jgazeley/accord/logger/hardware/README.md

# Logger hardware interface

The logger is a separate Pico W from the keyless module. The keyless KiCad
board in this repository is not a logger PCB. The current logger uses a
prototype signal-conditioning circuit, SD storage and an external regulated
5 V supply; the Pi is only a flashing and observation bench.

| Measurement/interface | Pico GPIO |
|---|---|
| Vehicle speed pulses | GP2 |
| Tachometer pulses | GP3 |
| Brake-warning level | GP4 |
| Conditioned ignition input | GP5 |
| Fuel analog input | GP26 / ADC0 |
| Supply analog input | GP27 / ADC1 |
| SD MISO / CS / SCK / MOSI | GP16 / GP17 / GP18 / GP19 |

This map comes from `accord-logger.ino` and `logger_sd.cpp`. Automotive
signals require the appropriate conditioning before reaching the Pico; this
pin map alone is not a wiring schematic. The brake-warning signal can represent
parking brake or low fluid, not an unambiguous parking-brake state. The fuel
input records ADC measurements, not an independently calibrated fuel quantity.

The **Rev A board design** is in [kicad/](kicad/) as `accord-logger.kicad_pro`:
complete schematic, 148-line BOM with every part footprinted, ERC clean, sized
for 80 × 120 mm. It includes the automatic power hold and cutoff, B2 input
isolation, the keyless RS-485 circuit, and one 10-pin Molex Mini-Fit Jr.
board connector. It is ready for the owner to place and route. It is **not
frozen and not fabrication-approved**: nothing has been built or bench tested.
The schematic is generated by `kicad/tools/gen_logger_sch.py`; see
[kicad/validation/COMMANDS.txt](kicad/validation/COMMANDS.txt). Engineering
record: [power/LAYOUT_CLOSURE.md](power/LAYOUT_CLOSURE.md); risks and bring-up
tests: [LRA12_HANDOFF.md](LRA12_HANDOFF.md). Automatic-power firmware exists
as an opt-in candidate; manual power remains the default.

The pin map above is the **as-built** firmware baseline. Rev A changes what
GP5 means and adds GP6; see [as-built/REV_A_INTERFACES.md](as-built/REV_A_INTERFACES.md) §1.

B2 input isolation (ASSR-601JV) is in the schematic; background in the
[B2 study](isolation/B2_ISOLATION.md) and [enable design](isolation/ISO_ENABLE.md).

Current electrical/PCB context: [Rev A context](REV_A_CONTEXT.md).
Current status: [STATUS.md](../../coordination/STATUS.md); owner decisions: [DECISIONS.md](../../coordination/DECISIONS.md).
