jgazeley/accord/logger/hardware/power/LAYOUT_CLOSURE.md

# LRA-12 — electrical closure for layout

Prepared October 29, 2026 by Claude Code `logger-electrical`, session
`b690946d-3a88-4626-8e7b-b321126a3d16`.
Resume: `claude --resume b690946d-3a88-4626-8e7b-b321126a3d16`.
Session ID read from this session's harness-assigned working paths and
confirmed against its transcript file; this tool exposes no second identifier
to cross-check it against, so that is stated rather than implied.

Branch `task/LRA-12-b690946d`, from public `main` at
`5ffcb26958d2b7154b4d1417431fad22246cedd9`.
Packet: [LRA-12](../../../coordination/handoffs/LRA-12_LAYOUT_ELECTRICAL_CLOSURE.md).
**LRA-12R revisions below supersede the original clamp rationale and A5 stage;**
original attribution above is preserved.

Readiness review: [LAYOUT_READINESS_2026-10-29](../../../coordination/reviews/LAYOUT_READINESS_2026-10-29.md).

**Disposition: the electrical design is complete and routable. Nothing here is
frozen, ordered, fabricated, flashed or vehicle-approved.** Every one of the
eight LRA-06 placeholders now has a real circuit or a recorded, justified
bypass; every populated part carries a checked footprint; ERC is clean at
`--severity-all`; the board fits 80 × 120 mm with a 1.42× courtyard
allowance. What is still open is listed in
[LRA12_HANDOFF.md](../LRA12_HANDOFF.md), classified, and none of it is a
layout blocker.

---

## 1. What changed

| Was | Now | Where |
|---|---|---|
| X1 B2 isolation, no part | ASSR-601JV in the divider top leg, with a GPIO enable in series with a hardware PGOOD permission | §4 |
| X2–X5 four branches, under review | **Justified bypass**, on the ignition interlock plus the fitted series resistance, with a reachable-state table | §4 |
| X6 qualified IGN / QREPORT, no circuit | Captured component for component from `CUTOFF_MARGIN_REVIEW.md` §2 | §5 |
| X7 vehicle protection, no selection | 1.5KE20A entry clamp **plus** a second-stage clamp on the A5 regulator input; one declared excluded exposure | §3 |
| X8 independent cutoff, no circuit | Captured from `MAX_ON_CUTOFF.md`, including the QS permission switch and QMON sense | §5 |
| J1/J2 connector family not selected | Molex Mini-Fit Jr., the family already in service in this car | §6 |
| Q2 / R06-REV-2 opto LED return | Moved from the B16 cluster conductor to PGND | §6 |
| Q4 onboard ignition fuse | Dropped; the fuse belongs at the tap end | §6 |
| Q5 J4 "service UART" with NC pins | J4 is the RUN/GND reset pair only; USB CDC is the service console | §6 |
| Q6 where the cutoff interrupts HOLD | QS between SINK and the QH collector | §5 |
| QP IRF4905, hot leakage over its allocation | IPD50P04P4L-11 with the paired BZX55C10 gate clamp | §3 |
| CIN/COUT/CCLK/A5 caps unspecified | The LRA-02 selections, with their conditions carried | §5, §7 |
| C_SD "10–100 µF" | 47 µF, selected from the duty | §6 |
| RGS 100 k | 10 k, per the MAX_ON revision | §5 |

Deliberately **not** changed: the five divider ratios, the GPIO allocation
except for taking up the released GP7, the 1N5819 digital clamps, the SD rail,
the single B16 return, the LM2678 buck topology, the 1770/1800/1801 s policy,
the nominal 2048 s cutoff, and the 100/500 µA whole-system targets.

---

## 2. Design basis

`D-REUSE-02` and `D-POWER-03`: this board is the working keyless circuitry
plus the logger's documented input cells and SD wiring plus the existing
IGN-sense, power-hold and automatic-shutoff design. It is integration, not a
new power survey. The regulator, the TVS role, both bulk capacitors, the boost
capacitor, the inductor value, both Schottky positions, the connector family
and the test-point and reset-header pattern all come forward from a board
that runs in this car on a permanent 12 V feed through cranking.

Every change to an inherited block below names a concrete incompatibility, a
changed operating condition or a documented defect. There is no blanket
requalification: the LM2678 loop, the keyless clamp precedent and the fitted
divider ratios are carried as they are.

Two conditions genuinely changed, and they are where the engineering went:

1. **The always-on A5 supply is new.** Its regulator has a 30 V recommended
   input maximum, where everything keyless puts behind the same clamp is
   rated 40 V. §3.
2. **The shutdown addition creates a state keyless never has:** a board that
   has removed its own power while vehicle inputs may still be energized.
   §4.

---

## 3. X7 — the input voltage envelope

### 3.1 LRA-12R decision: retain the lower clamp by choice

Revision October 29, 2026 by Codex `logger-electrical`, session
`01a18a47-2dc2-7aa3-a0d2-a4978e2b1ebc`.
Resume: `codex resume 01a18a47-2dc2-7aa3-a0d2-a4978e2b1ebc`.
Identity verified from matching CODEX_SESSION_ID and CODEX_THREAD_ID.

**The original claim that no suitable 60 V P-FET exists is withdrawn.**
[Vishay SQD50P06-15L, document 69098 Rev. E](https://www.vishay.com/docs/69098/sqd50p06.pdf)
specifies −60 V VDS, ±20 V VGS, AEC-Q101, TO-252, and IDSS maxima
1 / 50 / 150 µA at 25 / 125 / 175 °C with VGS=0, VDS=−60 V.
It fits the manager-accepted 70 µA hot QP allocation at the 125 °C screen.
It is a real alternative, not a parked-budget blocker.

The inherited 1.5KE30A has 25.6 V standoff, 28.5–31.5 V breakdown,
41.4 V clamp at 36.2 A and a **0.097 %/K** breakdown coefficient:
`41.4 × (1 + 0.00097 × 60) = 43.80948 V` at 85 °C.
This is a temperature screen using the breakdown coefficient, not a guaranteed
hot clamp waveform. The LM2678 would return to its keyless in-service margin:
40 V operating, 45 V absolute, hence **3.81 V above operating and only
1.19 V below absolute**. Keyless's working precedent is accepted; this is not
a claim that it failed. The SQD would have 16.19 V VDS margin.
[TVS table](https://www.vishay.com/docs/88301/15ke.pdf).

**Decision: retain 1.5KE20A and IPD50P04P4L-11.** The concrete logger-specific
reason is the added A5 supply. With 43.81 V and the existing 330 Ω stage,
the same screening calculation gives 1.46 W in BZX55C22 versus 0.5 W even
at 25 °C leads. At 85 °C leads its thermal allowance is only 0.30 W.
Even an ideal 28 V shunt needs at least 1476 Ω to stay within that allowance,
whereas the 6 V input / 5.5 V regulator floor at 0.510 mA permits at most
980 Ω actual series resistance. A resistor-only change cannot satisfy both.
A higher-power zener or another A5 topology can solve this; it has not been
ruled out. It would need its own leakage, thermal and startup validation,
as well as ≥60 V driver replacements. This return chooses the lower clamp
and retains 10.80 V LM2678 operating margin, accepting the narrower sustained
ceiling already deferred under D-OVERVOLT-04. This is a tradeoff, not forced
by QP availability. The conditional 30A adoption tasks are not claimed complete.

The selected 1.5KE20A remains 17.1 V standoff and 27.7 V clamp at 54.2 A;
its 0.090 %/K coefficient gives **29.1958 V** at 85 °C. Both TVS pulse-power
ratings require temperature derating; neither the nominal 1500 W nor the
room-temperature pulse current is a guaranteed 85 °C capability. Actual
pulse and overshoot acceptance remains a vehicle/bench gate.

### 3.2 The envelope table

Computed in `check_layout_closure.py` §1 against the 29.20 V hot clamp.

| Part | Node | Rating | Kind | Margin |
|---|---|---:|---|---:|
| QP IPD50P04P4L-11 | P12 / VIN_SW | 40 V | absolute V<sub>DS</sub> | 10.80 V |
| QI 2N3904 | SINK = P12 when off | 40 V | absolute V<sub>CEO</sub> | 10.80 V |
| QH 2N3904 | SINK = P12 when off | 40 V | absolute V<sub>CEO</sub> | 10.80 V |
| QS BSS138P | SINK | 60 V | absolute V<sub>DS</sub> | 30.80 V |
| UREG LM2678 | VIN_SW | 40 V | operating V<sub>IN</sub> (45 V absolute) | 10.80 V |
| CIN EEUFR1H101 | VIN_SW | 50 V | rated WV | 20.80 V |
| C0 | P12 | 63 V | rated WV | 33.80 V |
| DREV SB360 | BATT_F / P12 | 60 V | absolute V<sub>RRM</sub> | 30.80 V |
| C_AON GRM32ER71H475KA88L | P_AON | 50 V | rated WV | 20.80 V |

The tightest number in the group is not in that table: cold V<sub>BR</sub>
minimum is `19.0 × (1 − 0.00090 × 65) = 17.89 V` against a 16 V operating
ceiling, so there is **1.89 V** between the top of the operating envelope and
the cold onset of clamp conduction. Leakage at 16 V and −40 °C is below the
1.0 µA standoff figure, because cold reduces it, but that is reasoning rather
than a tabulated point.

Keeping QI and QH as 2N3904 is a consequence of this choice, not an oversight:
the lower clamp gives them 10.8 V of margin where the inherited clamp exceeded
their absolute rating. Their hot off-state leakage under these actual base
networks remains unspecified and stays in the ledger as an allocation.

### 3.3 A5 second-stage correction, including junction heating

```text
P12 -- R_AON 820R/1% -- P_AON -- UA5 IN
P_AON -- DZ_AON BZX55C22 cathode; anode -- PGND
P_AON -- C_AON 4.7uF/50V X7R -- PGND
```

The former 330 Ω / 0.420 W calculation compared hot operation against a
25 °C power rating. **R_AON changes to 820 Ω**. Select a resistor providing
at least **0.15 W allowable dissipation at 85 °C** in the assigned footprint;
a nominal 0.25 W label alone does not establish that.

[Vishay BZX55, Rev. 2.0](https://www.vishay.com/docs/85604/bzx55.pdf)
specifies 500 mW at leads 25 °C / 4 mm, 300 K/W thermal resistance under
its stated lead condition, and 175 °C maximum junction. With leads held at
85 °C, allowable power is **0.300 W**. For *any* shunt voltage,
`Pz <= Vin²/(4 Rmin) = 29.1958²/(4 × 811.8) = 0.263 W`,
so the thermal screen gives Tj ≤163.75 °C. **Layout and measurement must
establish the lead-temperature condition**; this is not an unconditional
ambient rating or a transient thermal characterization.

For voltage screening use the full 175 °C junction ceiling:
`23.3 × (1 + 0.0012 × 150) = 27.494 V` at 5 mA.
Cold minimum is 19.1776 V; an intentionally pessimistic current bound is
`(29.1958 − 19.1776)/811.8 = 12.34 mA`. Applying the tabulated 55 Ω
small-signal impedance to the excess above 5 mA gives **27.90 V**, below
28 V. This extrapolation is a **model screen**, not a manufacturer's
large-signal DC guarantee; TP_PAON pulse/temperature verification remains
required. Resistor dissipation in that model is ≤0.124 W.

Leakage is **<0.1 µA at 25 °C / <2 µA at 150 °C at VR=16 V**, correcting
the original 18 V transcription. The ledger screen is therefore applicable
to the 12–16 V normal input range; it supplies no leakage guarantee over
16–17.1 V. The latter is a declared voltage ceiling, not a parked-current
qualification. Cold minimum zener voltage remains above 17.1 V.

At 0.500 mA A5 load plus a 10 µA regulator-ground-current screen,
Rmax=828.2 Ω drops **0.4224 V**: P_AON ≥5.5776 V at P12=6 V, leaving
77.6 mV over the 5.5 V dropout screen. Nominal RC is 3.85 ms. Including
+1% R, +10% C and the full constant load, input charging to 5.5 V takes
**18.3 ms**, inside 100 ms. LDO and logic startup, low-load dropout and
load transients still need the original bring-up measurements.
EN stays open; TI Table 4-1 says it must remain below 6.5 V.
**The ≤28 V protected-rail criterion is measured at TP_PAON.**

### 3.4 Fuse coordination, and the one exposure that is declared excluded

> **October 30 (owner decision D-FUSE-10): F1 is removed from the board.**
> The owner fits a 1 A inline fuse in the harness instead, so BATT_IN goes
> straight from J1 to DREV. That one fuse now does both jobs below: it
> protects the wire (it belongs at the feed end) and it is the element that
> must clear a sustained overvoltage before the entry clamp fails. Keep it at
> 1 A; a larger fuse lets the clamp dissipate longer. The text below is the
> original LRA-12 record, which assumed an onboard F1.

The clamp-only front end cannot do everything, and this is where it stops.

- **Reverse battery** is covered by DREV, which also keeps the unidirectional
  clamp out of forward conduction and is what makes P12 nonnegative at the A5
  regulator, as that regulator requires.
- **Transient**, 10/1000 µs: 1500 W, 54.2 A, clamping to 27.7 V at 25 °C and
  29.20 V hot. Within the declared bench and charging envelope.
- **Sustained overvoltage is not survivable, and is declared excluded.** At
  the 1 A branch fuse rating the clamp would dissipate about **19 W against
  its 6.5 W rating**, and a cartridge fuse carrying its own rating does not
  clear quickly. **The declared sustained ceiling at P12 is 17.1 V**, the
  clamp standoff — which covers 12–16 V bench operation and a 14.8 V charging
  rail with 2.3 V to spare, and excludes **any sustained P12 above 17.1 V**, including an
  **alternator/regulator overcharge fault** and a 24 V jump start. This is
  the owner-deferred vehicle-acceptance risk D-OVERVOLT-04.

The choices now include a verified 60 V switch:

| Option | Benefit | Cost / disposition |
|---|---|---|
| **(a) Retain 1.5KE20A — selected** | 10.80 V LM2678 operating margin; A5 correction fits the existing topology | Any sustained P12 >17.1 V excluded, including regulator overcharge; R_AON changes to 820 Ω |
| (b) Series overvoltage cutoff | Disconnects during sustained overvoltage | Additional topology and validation; not selected |
| (c) 1.5KE30A + SQD50P06-15L | Reuses working clamp and raises standoff to 25.6 V; 50 µA hot QP screen fits budget | LM2678 43.81 V hot screen, 1.19 V absolute margin; needs ≥60 V BJTs and redesigned A5 stage, not merely a larger resistor with the same hot-rated BZX55. Not selected |

Required owner input to close this properly, unchanged from
`INTERFACE_CONTRACT.md` §6: exact feed, source and harness impedance and
inductance, expected jump-start and crank behaviour, pulse
amplitude/duration/repetition/temperature, wire sizing and the fuse interrupt
and clearing curves. None of that is needed to lay the board out.

**F1 stays on the board** as the board's own branch protection, and the
specification still puts a fuse at the feed source. An onboard fuse cannot
protect the upstream harness, so both exist for different reasons; `DESIGN.md`
§5 already says the feed-source fuse is the one that protects the wire.

### 3.5 The ignition and sense entries

One clamp, on the one harness entry that is not a high-impedance divider.

- **B11 carries both** the supply ADC divider and the ignition opto LED
  through 2.2 kΩ, so it is the cluster line where a transient has something
  low-impedance to drive. **TVS_B11 = 1.5KE20A-E3/54**, the same part as the
  entry clamp, so one qualification covers both. It costs nothing parked: B11
  is ignition-switched and logged dead with the key out.
- **The five divider inputs need no clamp of their own.** Each presents
  7.5–22 kΩ of series resistance before anything sensitive, so a 100 V
  transient delivers 4.5 mA into a 1N5819 rated 25 A of forward surge, and
  the axial resistors' own pulse withstand is far above the arriving voltage.
  This is the real difference from keyless, which fits seven P6KE30A: those
  lines drive ULN2803 outputs and relay loads, not dividers.
- The owner's four **P6KE30A** are recorded as a possible substitute only if
  the 41.4 V clamp is first checked against RI and RLED pulse ratings. They
  are not selected: the 1.5KE20A is strictly better here and halves the part
  count across the two clamp positions.
- **RI stays 2.2 k / 0.25 W.** At the 17.1 V sustained ceiling its
  dissipation is 0.112 W. The 0.318 W figure that would have forced a 0.5 W
  position came from the superseded 28 V number.
- **RLED is the measured 2.2 k, specified 0.5 W** (D15). At 17.1 V it
  dissipates 0.108 W; the 0.792 W that disqualified the 1 k candidate also
  came from the 28 V number. The fitted part's wattage is not recorded, which
  is why the position is specified rather than assumed.

---

## 4. X1 and X2–X5 — isolation, and the four branches that do not get it

### 4.1 Reachable-state table

The record had discussed two different criteria as one.
`REV_A_INTERFACES.md` §3.1 separates them; this table says, for each state,
which criterion applies and what each branch does in it.

| State | How it is reached | B2 (VSS) | B1, C14, C11, B11 |
|---|---|---|---|
| **Parked, key out** | normal | Energized at 4.669 V open circuit from an always-on source through 3,757 Ω — **measured** | **Dead** — B1 and C11 measured 0 V, C14 and B11 logged dead (`D-OFFSTATE-01`) |
| Running | key on, board powered | energized, switch closed, divider reads it | energized, dividers read them |
| HOLD window after key off | normal shutdown | dead within one PCM power-down | dead |
| Supervisor BAD, ignition absent | fault | relay opens in hardware when B5 falls | dead |
| Supervisor BAD, ignition present | fault | **QI holds the board powered** — so the board is not off | energized, board powered |
| EXPIRED with HOLD stuck | fault | ignition is absent by definition, so B2 is still energized but the relay is open | dead |
| Pico reset while ignition on | normal | QI holds power; 3V3 stays up | energized, board powered |
| USB only, key at II | bench | 3V3 is alive from USB; B5 is dead so the relay is open | energized, 3V3 alive |
| **Board dead, key at II** | **needs an upstream power fault**: J1 open, F1 open, DREV or QP failed open | relay open, B2 blocked | **energized into a dead 3V3 rail** |

The last row is the only state in which criterion B bites, and the table is
the argument: **it requires both the key on and a power fault**, because
ignition present drives QI, QI sinks the QP gate, and the board powers up —
with no firmware, no HOLD and no qualification involved. That interlock is
checked structurally off the netlist in `check_layout_closure.py` §5.

B2 is the exception to all of it, which is why B2 alone gets a switch: it is
energized with the key out, so the interlock argument does not cover it and
the parked criterion fails on measurement rather than on inference.

### 4.2 B2: the ASSR-601JV, and the enable the manager required

Part, package and leakage come from the LRA-11 return and are unchanged.
Verified again here directly from
[Broadcom ASSR-601Jx-DS105, June 17 2024](https://docs.broadcom.com/doc/ASSR-601Jx-DS):
I<sub>O(OFF)</sub> **1000 nA maximum at V<sub>O</sub> = 1000 V**, under a table
header reading *"Unless otherwise stated, all minimum/maximum specifications
are over recommended operating conditions"*, with recommended operating
temperature **−40 to +105 °C** for the JV and no 25 °C override on that row —
unlike the withstand row immediately above it, which states
"T<sub>A</sub> = 25 °C" explicitly. 4.669 V is applied against a limit quoted
at 1000 V; that 214× lower stress is noted, not claimed.

Three things the manager's follow-up required, and what each turned into:

**(1) Complete the driver: GPIO enable plus hardware PGOOD permission.**

```text
B5 -- R_ISO 270R/1% -- AN (pin 4)
                       CA (pin 5) -- QISO_PG drain
                                     QISO_PG source -- ISO_MID
PGOOD -- 1k -- QISO_PG gate ; gate -- 100k -- PGND
                                     ISO_MID -- QISO_EN drain
                                                QISO_EN source -- PGND
GP7 (ISO_EN) -- 1k -- QISO_EN gate ; gate -- 100k -- PGND
```

Both channels must conduct for LED current to flow. The reason the second one
exists is the manager's own correction: **BAD does not necessarily remove
B5**, because the original design gates only QH and QI can hold power with
ignition present. A rail-only argument therefore cannot carry the
fail-open-on-BAD requirement, and PGOOD can, in hardware, with no software
step. TPS3839's output is **push-pull** and sources at least V<sub>DD</sub> −
0.4 V at 2 mA, against the 50 µA that gate divider draws, so it drives the
gate directly.
[TI TPS3839, SBVS193D](https://www.ti.com/lit/ds/symlink/tps3839.pdf).

Per-state behaviour, all of it in hardware unless marked:

| State | Behaviour |
|---|---|
| No power applied | B5 = 0, no LED current whatever any gate does. Open **by construction**; the 100 k pulldowns are on the driver, not the isolation mechanism |
| Supervisor BAD | PGOOD falls, the permission channel opens, output opens within T<sub>OFF</sub> ≤ 0.5 ms. **No software step** |
| Pico 3V3 absent or resetting, B5 present | GP7 floats, its 100 k pulldown holds the enable channel off |
| USB only, A5 and B5 absent | no LED current; also no PGOOD |
| Normal shutdown | *firmware*: ISO_EN low, wait t_iso = 5 ms, **then** release HOLD |
| Startup | *firmware*: after B5 and the Pico are up, assert ISO_EN and wait 20 ms before trusting VSS edges |
| Unplanned rail collapse | B5 falls, LED goes dark, output opens |

**(2) R_ISO is 270 Ω, not 330 Ω — a correction, with a reason.** The ASSR's
turn-on maximum is specified at two LED currents: **4.0 ms at I<sub>F</sub> =
10 mA** and 1.0 ms at 30 mA, into V<sub>DD</sub> = 40 V and
R<sub>LOAD</sub> = 20 kΩ. The original 330 Ω puts the worst-case LED current
at 8.64 mA — *below* the 10 mA the maximum is specified at, which would leave
turn-on an extrapolation exactly where the requirement needs a specification.
270 Ω moves the corners to:

| Corner | I<sub>F</sub> |
|---|---:|
| B5 −5 %, V<sub>F</sub> 1.85 V, two channels at 5 Ω each | **10.26 mA** |
| Nominal | 12.32 mA |
| B5 +5 %, V<sub>F</sub> 1.25 V | 14.42 mA |

All inside the 7–30 mA recommended window, and the low corner is now at or
above the specified point. Resistor dissipation 57 mW. The awake cost rises
from ~10.3 mA to 12.3 mA, about +24 % on the ~51 mA branch baseline, drawn
only while recording.

**(3) Timing against the shutdown budget, with what is still conditional.**
t_iso = 5 ms is 10× the 0.5 ms turn-off maximum; the 20 ms startup wait is 5×
the 4.0 ms turn-on maximum. Isolate-then-release consumes 5 ms of the 1000 ms
between the 1800 s deadline and the 1801 s release limit, leaving 995 ms, so
the ordering costs nothing in the deadline. The enable-side 20 ms happens
after HOLD is already asserted, so it does not enter the ≤900 ms retention
path either. **Still conditional, and carried as a bring-up measurement:** the
turn-on maximum is specified into a 20 kΩ load and this branch presents 55 kΩ,
and the 190 pF output capacitance is a typical value with no maximum. Neither
5 ms nor 20 ms is promoted to a guarantee.

**Signal path.** R<sub>ON</sub> 300 Ω maximum (at I<sub>O</sub> = 2 mA) in the
22 kΩ top leg takes the divider ratio 0.600000 → 0.596745, a **−0.54 % shift,
−16.3 mV** referred to a 5 V pulse; the high level lands at 2.98 V against an
RP2040 V<sub>IH</sub> of about 2.0 V. The signal current is 90.4 µA, two
decades below the current R<sub>ON</sub> is specified at, so 300 Ω is used as
an upper bound. Because no series element enters the **fuel or supply** top
leg, the ≤25 Ω and ≤100 Ω limits of `REV_A_INTERFACES.md` §3.4 and the
card-header calibration problem of its §8.2 both fall away: `log.adc.fuel
div=7500/4700` still has every term it needs.

**Footprint.** Created locally and verified against the manufacturer drawing
rather than the summary: 12 pads at numbers 1–10, 15 and 16, 1.270 mm pitch,
pad 2.871 × 0.65 mm, pad centres at ±4.3815 mm, from the recommended land
pattern's 11.634 mm overall span and 8.763 mm centre spacing and its 0.635 mm
minimum pad width. **Pins 11–14 do not exist** and that gap is left clear.
**Pin 3 is "do not connect" — internally tied to pin 5** — and
`check_capture.py` asserts it is unconnected. A stock `SOIC-16W` footprint
would put pads where there are no leads, which is the error LRA-11 flagged.
Neither creepage figure is load-bearing at these voltages — the device is used
for off-state blocking, not for safety isolation, and
`REV_A_INTERFACES.md` §4 already records that this installation is not
galvanically isolated — but the drain gap is kept clear anyway because it is
free.

**Finite leakage, stated as such.** "Eliminated" and "no conductive path of
any kind" are overstatements and are not repeated. The bound is 1 µA maximum
over the operating range, 1.0/1.0 µA in the ledger, against the 8/20 µA
reserved for all five branches. Open-state coupling is 0.173 µA average at
91 Hz through the typical 190 pF, which is a typical value, not a maximum.

**Availability is the one open item**, unchanged: distributor lifecycle data is
contradictory. Panasonic **AQY221N2S** remains the documented fallback — a
strictly smaller part inside the same keepout, better on every axis except the
one that decides it, since its 10 nA leakage maximum is from a 25 °C-only
table. If it is chosen, hot leakage must be measured.

### 4.3 X2–X5: bypass, decided

**Decision: no isolation device on B1, C14, C11 or B11.** Grounds:

1. **Criterion A is met with nothing fitted, and better than with a switch.**
   All four are ignition-fed and measured or logged dead with the key out, so
   the parked injection is zero rather than four devices' leakage.
2. **Criterion B needs a power fault as well as the key on** (§4.1), and in
   that state the fitted series resistance bounds each branch: 0.659 mA for
   the tach at 14.8 V, 0.627 mA for the brake at 14.1 V, 0.668 mA for the
   supply at 15 V, 0.906 mA for the fuel channel at its 8 V ceiling through
   7.5 k + 1 k. **Criterion B's 0.3 V dead-rail limit is not met in that
   state, and that is reported rather than claimed closed.** Isolating B2
   lowers the criterion-B total from 3.07 mA to 2.86 mA rather than raising
   it.
3. **The cost is concrete.** Four more ASSR relays would add 4 × 12.3 mA =
   49 mA of awake LED current — about doubling the awake branch baseline — and
   four 10.4 × 7.5 mm packages on a board with a 1.42× area allowance, against
   a fault-only benefit.
4. Series resistance in the fuel or supply top leg would also re-open the
   card-header calibration question for no gain.

Carried forward unchanged: the five divider ratios, the 1N5819 digital clamps
and the fitted ADC protection. **D11 stays open** — the tach cell's clamp
margin is smaller than estimated, because the measured 159 mV at 109 µA shows
V<sub>F</sub> keeps falling below a 0.3 V assumption. LRA-12 changes no ratio
and claims no clamp margin; resolving D11 needs U-08 first and is not a layout
blocker.

---

## 5. X6 and X8 — capturing circuits that already existed

Both were capture work, not design work: `LAYOUT_READINESS_2026-10-29` is
right that the sources specify them component for component. They are
transcribed from `CUTOFF_MARGIN_REVIEW.md` §§1–2 and `MAX_ON_CUTOFF.md`'s
connection table, and `check_capture.py` asserts every pin of every package
against those tables, plus all eleven Boolean equations read back off the
netlist by package pin.

What needed a decision rather than a transcription:

**The opto rewire (X6).** The collector goes to A5 and the emitter to IGN_A,
an emitter follower into the 47 k / 220 k / 1 µF filter. The old
collector-to-GP5 wiring is gone, as `D-RA-03` requires. CTR margin at the
measured 2.2 k: at the 9 V characterisation point the LED takes 3.39 mA, and
the ≥50 % CTR at 5 mA makes at least 1.7 mA of collector current available
against the 95.7 µA the 47 k load needs at the 4.5 V ON endpoint — about 15×.
Hot CTR and the endpoints themselves stay open (LRA-07).

**The report node carries no capacitor.** That answers the open half of D1:
with the 10 k pullup against roughly 30 pF of node capacitance the edge is
under a microsecond, so the report delay is nowhere near the 10 ms observation
budget. The fitted 100 nF across the old opto output is not carried forward
because the node it filtered no longer exists.

**Where the cutoff interrupts HOLD (Q6).** QS sits between SINK and the QH
collector, drain to SINK, source to the collector, so its body diode points
from the collector toward SINK and blocks the sink direction when off. QH
keeps its emitter grounded; interrupting the emitter instead would couple
fault voltage into the HOLD interface. QI stays wired straight to SINK, so raw
ignition still overrides the cutoff. RGS changes from 100 k to 10 k, which is
what makes the added series switch tolerable: the 0.2 V off-gate limit then
allows 19.80 µA of total sink leakage instead of 2 µA.

**The accelerated-cutoff provision, kept distinct from the production
selection and from the maintenance link.** Three different things, three
different parts:

| Part | What it is | Default |
|---|---|---|
| **JH** | Maintenance HOLD link: open it for USB work so a USB-driven HOLD cannot keep the battery circuit on | fitted |
| **R_EXPP** 0 Ω | Production period select: EXPIRED from UCOUNT Q13, nominal 2048 s | **fitted** |
| **R_EXPT** 0 Ω | Accelerated test select: EXPIRED from Q8, 128 / 2 = 64 s | **DNP** |

Link options rather than a jumper header, so the production state cannot be
changed by something falling off, and **exactly one is ever fitted** — they
are two counter outputs and must never be shorted together. A 100 k pulldown
(R_EXP) keeps EXPIRED defined if neither is fitted, costing nothing parked
because EXPIRED is low until the deadline. An accelerated run does not
substitute for one full-duration test.

**Every unused CMOS input is tied to a rail** — ULATCH pins 12 and 13 to
ground — and **every package has its own 100 nF across its own supply pins**.
Both are layout requirements as much as BOM lines.

What the cutoff still does not cover, unchanged and restated so nobody reads
more into the drawing: a stopped clock, failed timer logic, a shorted QS or
QP, an ignition line stuck high, repeated raw pulses that energize QI, or
external backfeed. A5 faults can remove power before the deadline. No SD
integrity claim survives a forced cutoff.

**A procurement note on the oscillator, not a redesign:** the selected
OV-7604-C7-32.768KHZ-20PPM-**TA-QC** is commercial grade. Micro Crystal offers
the same package as **QA**, AEC-Q200 qualified. That is an ordering decision
for the owner, and the design is unchanged either way. Its −40 to +85 °C TA
range, 0.3/0.5 µA at 3.0 V with CLKOE low and 0.5 s maximum startup are from
[the datasheet, version 4.5/08.2023](https://www.microcrystal.com/fileadmin/Media/Products/kHzOSC/Datasheet/OV-7604-C7.pdf),
whose −0.035 ppm/K² curvature reproduces the 188.65 ppm term in the ±220 ppm
first-year envelope the 2048 s arithmetic uses.

---

## 6. Grounding, the LED return, and the connectors

### 6.1 R06-REV-2 and Q2: the opto LED returns to PGND

**Decision: U2 pin 2 goes to PGND, not to the B16 cluster conductor.**

The conflict was real and could not stand: `AS_BUILT` §3.4 records the fitted
LED cathode going to B16 "with nothing in series", while §4 and delta D5 make
B16 a reference that "must never become a power return" — and with B16 bonded
to the single ADC return node, the fitted cell put 4.7–5.8 mA of
*signal-dependent* current through the node both ADC channels reference. A
common-mode offset largely self-cancels in the fuel computation; a few
milliamps of signal-dependent current in the reference does not.

Moving the return costs nothing, is the arrangement `DESIGN.md` §3 already
specified, and puts DR directly antiparallel with the LED, which is the
position that actually limits LED reverse voltage against the PC817's 6 V
input rating.

What B16 still carries, stated so the decision is not oversold: the two
divider return currents, at most about 0.65 mA combined and only while the
cluster is energized. Those are intrinsic to a ratio measurement referenced
to cluster ground. The LED current was not.

The consequence, recorded rather than hidden: the LED current now returns
*into* the board instead of off-board. It cannot reach a switched rail — the
opto's output side is in the A5 domain and galvanically separate from its LED
— so this removes an injection path rather than relocating one.

### 6.2 Pico-internal ground continuity

AGND and PGND **are already joined inside the Pico module** (`AS_BUILT` §3.3),
so separate net labels do not isolate those conductors. That junction is the
single point, which means **layout must not add a board-level bond between
AGND and PGND**: a second connection would make a loop and give the ADC
return a parallel path, which is exactly what D5 exists to prevent.
`check_capture.py` asserts that the two nets stay separate on the board and
that no two-terminal part bridges them.

The three ground loops follow the keyless pattern: TP_GND_BUCK and
TP_GND_PICO on PGND, TP_GND_HARNESS on the bonded B16/AGND sense node.

### 6.3 Connectors

> **Superseded October 29 (owner decision D-CONN-06).** The board has **one**
> connector: **J1, JAE IL-AG5-14P-D3L2-A**, Honda's connector style and the
> 14-contact sibling of the keyless 22P. 2.5 mm pitch, two rows, right-angle
> through-hole with board guides, 3 A per contact. Footprint
> `accord-logger:JAE_IL-AG5-14P-D3L2-A`, generated by
> `kicad/tools/gen_fp_ilag5.py` from the JAE catalogue's right-angle hole
> pattern (A 20.0, B 26.5, C1 12.5); the same generator reproduces the
> keyless 22P exactly, and `check_capture.py` asserts both. It replaces the
> 2-way J1, 8-way J2 and interim RS-485 J485 of the LRA-12 record below.
>
> | Outer row | 1 RS-485 A | 2 bus GND (PGND) | 3 B2 VSS | gap | 4 B1 tach | 5 B11 | 6 BATT_IN |
> |---|---|---|---|---|---|---|---|
> | **Near row** | 7 RS-485 B | 8 spare | 9 C11 fuel | 10 AGND (B16) | 11, 12 spare | 13 C14 brake | 14 PGND |
>
> At the mating face (rows 3 mm apart, 2.5 mm pitch) BATT_IN's only
> neighbours are B11, PGND and C14; fuel and VSS are away from it; fuel sits
> beside its AGND reference; A/B are a pair with their own ground contact.
> **Pin numbers follow the keyless 22P convention** (pin 1 outer row, left
> end from the mating face) and must be checked against the housing's
> cavity numbers before crimping. Mating parts: housing IL-AG5-14S-D3C1-A,
> crimps IL-AG5-C1-5000 (AWG 22-18), hand tool CT150-1-AG5. The cluster-end
> Mini-Fit Jr. taps are untouched. `REV_A_INTERFACES` §5.1's J1/J2 split is
> pinned by its manifest and superseded here, not edited.

Both from the Molex Mini-Fit Jr. 4.20 mm family, which `D-POWER-03` records as
in service in this car on the keyless body harness, so the mating housings and
crimp tooling already exist.

| | Part | Footprint | Mating |
|---|---|---|---|
| **J1** power, 2 circuits | Molex **39-30-1020** (5569-02A2), right-angle with PCB peg | `Connector_Molex:Molex_Mini-Fit_Jr_5569-02A2_2x01_P4.20mm_Horizontal` | Mini-Fit Jr. 5557-series receptacle housing with 5556 female crimp terminals, 16–24 AWG |
| **J2** cluster harness, 8 circuits | Molex **39-30-1080** (5569-08A2) | `...5569-08A2_2x04_P4.20mm_Horizontal` | same family |

Pin numbers are Molex cavity numbers. 9 A per circuit against a 1 A branch, so
the margin is in the crimp rather than the contact. `REV_A_INTERFACES` §5.1
requires J2 to mate with the **existing** cluster breakout, whose taps are
already this family, so the choice is constrained rather than preferred. Exact
order codes for plating and packaging are procurement, not a design gate.
Connector *placement* is the layout owner's.

### 6.4 Tap-end fuses versus an onboard FIGN (Q4)

**The onboard FIGN is dropped.** `REV_A_INTERFACES` §5.1 and delta D10 put
per-branch fuses at the tap end, "which is where the specification puts them
and where a chafed wire is actually backed by vehicle current". An onboard
fuse cannot protect the upstream harness, and the board cannot draw enough
through RI and RLED — 1.1 kΩ together — to need one. C11 and B11 already have
their tap-end fuses; D10 extends the same 100 mA fuse to B2, B1 and C14 and
remains the owner's.

### 6.5 J4 (Q5)

**J4 is the RUN-to-GND reset pair and nothing else**, shorted with a link for a
reset without cutting power, following keyless J7. The service UART that §5.1
also wanted there is dropped: GP0/GP1 must stay free, firmware already builds
with `pico_enable_stdio_usb` so the USB CDC console *is* the service path, and
a UART header would be another externally powered pull-up aimed at an off
GPIO. A header with NC pins was the contradiction; this has none.

### 6.6 Communications

R12-REV-4 supersedes the passive J3 provision under owner decision D-RS485-05.
The board now carries the keyless MAX3485 circuit and matching footprints:
GP8 TX, GP9 RX, GP10 tied DE//RE with 10 k pulldown, 100 nF decoupling,
390 Ω bias and 120 Ω termination. Bias and termination headers are fitted
without shunts. J3 is trimmed to switched power/ground/GP13. Interim J6 is
the owner-approved four-position Mini-Fit Jr: A/B/PGND/NC. Connector
consolidation and layout remain separate. No bus TVS is added.

[Communications revision](../communications/REV_A_PROVISION.md) records source
netlist verification, footprint parity, population and residual gates.
**External bus drive while parked is a conditional exposure:** up to 2 mA
from the bus at the +12 V two-pin corner, outside the 2/5 µA allocation.
With high bias linked, a 3.3 V external A line can additionally inject 8.55 mA
through 390 Ω into a held-dead rail; 12 V gives 31.08 mA / 0.373 W.
Default-open bias removes that resistor path, not the MAX3485 input paths.
Measure external-source current, rail rise and rearm before bus/vehicle use.

---

## 7. The parked ledger, and a re-allocation to propose

Recomputed in `check_layout_closure.py` §4 with the LRA-12 part changes. Every
figure is a datasheet maximum **at the stated condition** — a mixed-condition
screen, not an assembled maximum, and not a prediction.

| | Room screen, µA | Hot screen, µA |
|---|---:|---:|
| A5 domain subtotal (14 rows) | 59.98 | 346.85 |
| QP IPD50P04P4L-11 drain | 1.00 | 70.00 |
| Gate sink paths, QS + QI + PCB | 10.00 | 19.80 |
| Entry clamp at P12 | 1.00 | 10.00 |
| UISO, from the B2 source | 1.00 | 1.00 |
| Other four vehicle branches | 0.00 | 0.00 |
| QMON / QREPORT / QH injection | 2.00 | 5.00 |
| **Whole-system screen** | **74.98** | **452.65** |
| Unchanged acceptance target | 100 | 500 |

**With no externally energized RS-485 bus, the whole-system targets close as component screens**, with 25 µA and 47 µA
of headroom, and they are not relaxed.

**The former sub-allocations did not; the manager accepted redistribution.** The A5 row
is allocated 50 / 250 µA and screens 59.98 / 346.85 — over by 10.0 and
96.9 µA. The reason is not a defect: the QP change freed 130 µA of hot
headroom from the 200 µA switch allocation, so the money is there, in the
wrong row.

**Manager-accepted re-allocation, totals untouched (LRA-12R):**

| Allocation | Old room / hot | Accepted room / hot |
|---|---:|---:|
| A5 supply + complete timer/logic/filter leakage | 50 / 250 | **65 / 355** |
| QP drain and gate leakage into the switched stage | 30 / 200 | **15 / 70** |
| Gate sink paths, entry protection, other PCB leakage | 10 / 25 | 12 / 50 |
| All other energized signal/interface paths | 10 / 25 | 8 / 25 |
| **Total** | **100 / 500** | **100 / 500** |

`INTERFACE_CONTRACT.md` §7 already invites this kind of explicit
reallocation — it made one itself, moving 10 µA from interfaces to A5 — and
says reviewers may redistribute within the total. Manager acceptance is recorded in the October 29 LRA-12 review. Electrical
acceptance remains open. QP stays IPD50P04P4L-11, so its 1/70 µA screens
and the 74.98/452.65 µA totals are unchanged. The SQD alternative would
reduce the hot screen by 20 µA but is not populated.

The two largest hot rows are the HC counters at 80 µA each and the clock
reservoir at 66.25 µA. One bounded option exists for the last of those and is
**not** taken: the real VCLK load is about 3 µA, not the 100 µA the ramp
calculation conservatively allowed, so a 10 k / 2.2 µF pair would give the
same 0.232 V/ms slew with a fifteenth of the capacitance and a 0.03 V static
drop. It is not taken because it re-opens the oscillator slew and startup
qualification that `CUTOFF_MARGIN_REVIEW` §1 settled, for a saving the whole
system does not need. Recorded with its numbers so the next reviewer does not
have to re-derive it.

Still open as engineering, unchanged: the A5 regulator's ground current below
100 µA of load and its low-load output accuracy; the hot leakage of QP, QI,
QH, QMON, QS, QREPORT and the opto under their actual networks; and the
capacitor approval-sheet bias, aging and insulation-resistance data. **No
permanent preload may be added to buy a regulation specification** — it
defeats the budget.

---

## 8. Fit on 80 × 120 mm

> **Superseded October 29 (owner decision D-SMD-09).** The owner found the
> fit too tight and asked for surface mount. Resistors (0805, or 1206 where
> harness-facing, on 12 V nodes or carrying R_AON's power), disc capacitors
> (0805 X7R at no lower voltage), the five logic ICs (SOIC), the four NPNs
> (MMBT3904) and nine small diodes (SOD-123) are now SMD, and signal test
> points are 2 mm pads. Kept through-hole: the RS-485 block, RLED/RG,
> CQUAL, both zeners, DOR, electrolytics, the PC817 and the power parts.
> **Allowance is now 1.90×.** The "axial parts take vertical mountings" and
> through-hole-preference text below is the earlier LRA-12 record.

Recomputed from the footprints actually assigned, by `../kicad/fp_area.py`,
which measures each part's F.CrtYd courtyard bounding box and writes
`validation/courtyard_study.csv`. The earlier 5,031 mm² figure was nominal
package areas over a part set that had ten parts with no footprint and none of
the power logic, so it could not be re-quoted.

| | |
|---|---:|
| Parts with a footprint | **150 of 150** |
| Courtyard sum, fitted parts | **6,759 mm²** |
| Board 80 × 120 | 9,600 mm² |
| **Allowance** | **1.42×** |
| Measured from pads rather than a courtyard | none |

A courtyard sum is an occupancy floor including each part's own clearance, not
a placement: it says nothing about routing channels or connector access. It is
a tighter measure than the "nominal package area" the 1.6–2.0× guidance was
written against, so 1.42× on courtyards is roughly comparable to about 1.9× on
raw package area. **It fits, with 3,285 mm² free, and the margin is real but
not generous.**

The five largest items are the Pico module (1,243 mm²), J2 (423), the two
DIP-16 counters (203 each) and the three DIP-14 logic packages (178 each).

Two choices already taken in favour of area, both defensible on other grounds:

- **Axial parts take the keyless board's vertical mountings.** 62 axial parts
  measure 1,588 mm² vertical against 2,208 mm² horizontal — **620 mm², 6.5 %
  of the board** — and it is the convention already soldered and running in
  this car.
- **The SD bulk is a 6.3 mm can**, not a 10 mm one, because 47 µF is sized
  from the duty rather than from the top of D6's range.

If the owner's placement does not close, the reductions available, in the
order worth taking them:

| Change | Saving | Cost |
|---|---:|---|
| Glue logic DIP-14/16 → SOIC-14/16 | **582 mm²** → 1.67× | Loses easy probing and socketing on a board with five bench test groups still ahead |
| Drop the five ground and spare test points | ~65 mm² | Loses the three-loop return measurement the keyless pattern exists for |
| Passives → 0805 SMD | ~1,300 mm² | Against the owner's through-hole preference; last resort |

**The board is not silently enlarged, and no mechanical blocker is claimed.**

---

## 9. Reproducing the checks

From the repository root:

```sh
# schematic, symbols and BOM are generated from one parts table
cd logger/hardware/kicad
python3 tools/gen_custom_sym.py Custom.kicad_sym
python3 tools/gen_logger_sch.py .

export HOME=$(mktemp -d)                 # temporary KiCad configuration
mkdir -p "$HOME/.config/kicad/9.0"
cp /usr/share/kicad/template/sym-lib-table \
   /usr/share/kicad/template/fp-lib-table "$HOME/.config/kicad/9.0/"
kicad-cli sch erc --format json --severity-all -o validation/erc.json \
    accord-logger.kicad_sch
kicad-cli sch export netlist --format kicadsexpr -o validation/netlist.net \
    accord-logger.kicad_sch
kicad-cli sch export svg --no-background-color --exclude-drawing-sheet \
    -o validation accord-logger.kicad_sch
mv -f validation/accord-logger.svg validation/schematic.svg

python3 check_capture.py        # 652 structural checks against the netlist
python3 fp_area.py              # courtyard study and the 80 x 120 fit
cd ../../..
python3 logger/hardware/power/check_layout_closure.py     # 49 + 2 reported
python3 logger/hardware/power/check_cutoff_margins.py     # 8
python3 logger/hardware/power/check_max_on_logic.py       # 11
python3 logger/hardware/power/check_interface_contract.py # 14
python3 logger/hardware/power/check_component_margins.py  # 11
python3 logger/hardware/isolation/check_b2_isolation.py   # 24
python3 logger/hardware/as-built/check_as_built_numbers.py
```

Results on this session: **ERC 0 violations at `--severity-all`**;
`check_capture.py` 652/652; `check_layout_closure.py` 49/49 with the two
sub-allocation overruns of §7 reported explicitly; all 68 pre-existing checks
pass unchanged.

`kicad-cli` does not signal violations through its exit code unless
`--exit-code-violations` is passed, so a zero exit is not evidence of a clean
design — the result is read from `validation/erc.json`.

**What these prove and do not prove.** `check_capture.py` proves the drawing
agrees with the written design, connection by connection, read from the
exported netlist rather than from the table that generated it.
`check_layout_closure.py` is arithmetic over datasheet limits plus one
topology audit on the netlist. Neither is SPICE, a measurement, or a component
qualification. Every conditional input says it is conditional.

One thing this session could not do: **no SVG rasterizer exists on this host**,
so `validation/schematic.svg` was never rendered and looked at. Legibility was
handled structurally — every part is placed on the 1.27 mm connection grid,
labels sit at the end of 2.54 mm stubs, and the thirteen block frames and the
notes column are laid out on an A0 sheet — but **a reviewer should open the
project or the SVG once.** That is the one acceptance item that cannot be
closed from here.

---

## 10. Residual risks

Classified in full in [LRA12_HANDOFF.md](../LRA12_HANDOFF.md) §5, with a
concrete test or provision and a limit for each. None is a layout blocker.
In summary: one order gate the design depends on (ASSR availability, with a
specified fallback), a group of bring-up measurements that are conditional
datasheet readings rather than guarantees, the vehicle exposures the owner
must state, and one firmware contract — the ISO_EN sequencing — that the
hardware is safe without, because every default is open.

> **Required agent attribution:** Follow `logger/coordination/AGENT_ATTRIBUTION.md`
> relative to this project root. Use your own tool, role and verified current
> session ID for Git author and committer identity (`<Tool> <role> [<short-id>]`),
> with per-command settings. End each new commit message with `Agent-Session: <role>`
> and your full tool-specific session-ID trailer (`Codex-Session-ID`,
> `Claude-Session-ID` or `Antigravity-Session-ID`). This includes documentation-only
> commits. Identify yourself and your resume command in new coordination documents
> and dated updates. Preserve predecessor bookmarks and original attribution when
> transporting existing commits. If your ID is unavailable, say so rather than
> inventing one. Include this requirement in any seeds or handoffs you create.
