jgazeley/accord/logger/hardware/power/REVIEW_2026-10-25.md

# Remote continuation review — October 25, 2026

Base: `e7415c9` on `origin/master`; firmware source remains v0.7.1 from
`439695c`. Reviewed against the transferred power-engineer rollout
`rollout-2026-10-25T08-54-01-01a173c4-d2fd-7f71-a396-8996d502387b.jsonl`.
This is a document/source review with selected datasheet and arithmetic
checks, not full circuit sign-off, simulation, or physical validation.

## Where the interrupted agent actually stopped

All five assigned deliverable files were successfully written. Before this
review's edits, their bytes matched the rollout's two successful patch events.
The session ended at 16:14:04 UTC / 09:14 Pacific with
`usage_limit_exceeded` and no final response. There was no subsequent test,
package review, KiCad capture, firmware implementation, or physical operation
in that rollout. The manager registry/milestones still describe the BOM and
handoff as being completed; the files themselves establish their existence,
but neither existence nor this review establishes acceptance.

The agent's useful change in understanding was from an external-buck identity
question to an onboard power domain. The owner explicitly selected integration
similar to hondaPico. LM2678, IRF4905, GP6, the proposed current budget and the
independent timer's 32–40 minute range are engineering proposals, not all
separately approved owner requirements. Keep that distinction when resuming.

## Original assignment versus delivery

| Assignment | Present result | What remains |
|---|---|---|
| Explicit requirements | Startup, hold, release, reset, maintenance and leakage targets documented | Actual battery/IGN feed, ground/connector, measured load and environmental envelope |
| Substantiated topology | Input-switched LM2678 proposal and EN comparison; component connection list and calculations | Exact capacitor series and fault/protection design; no ERC-checked capture |
| Off-state/failure audit | USB, shared GP5, upper clamps, B16, SD and future bus paths considered; driven-high HOLD distinguished from high-Z | Implement the independent cutoff and automatic input isolation; physical verification |
| Firmware contract | Polarity, candidate pin, debounce/deadline, two-core health and shutdown ownership proposed | Firmware owner's acceptance and implementation; source constraints below |
| Executable bench plan | Staged latch/buck/firmware/integration tests with explicit pending status | Identified available parts/equipment and measured results |

The first assignment is substantially drafted. It is not a complete
procurement package or an integrated logger-ready circuit. The next work is
to close specific designs and interfaces, not rewrite the five documents.

## Findings supported by the repository

1. **hondaPico is a reference, not a qualified logger supply.**
   `hondaPico-kicad/gen_sch.py:650` and its BOM contain the LM2678 stage,
   22 uH inductor and 820 uF output capacitor. `circuits.md:1021` records the
   fitted 100 uH axial and unverified saturation rating. The new logger
   allocation cannot inherit load validation from that assembly history.

2. **The firmware work is larger than adding an elapsed-time condition.**
   `picow-logger.ino:12` assigns SD/network to core 0; `setup1()` at line 367
   assigns inputs and reporting to core 1. Lines 403–405 wait up to 3 s for
   USB. The `l` command at line 442 blocks for 200 ms and command processing
   at line 572 can execute multiple commands per burst. ADC sampling and
   output work also occur in the reporting path. A loop-top poll alone
   therefore cannot meet the proposed 10 ms power-service interval.
   The source has no application HOLD/watchdog implementation.

3. **Shutdown needs a new cross-core interface.** `logger_sd.h` exposes
   setup/loop/status operations, not a producer-stop/drain/close handshake.
   `OutTee` and its partial-line buffer belong to core 1, while SdFat belongs
   to core 0. A completion after IGN cancels shutdown needs state/generation
   checking. A 4 s watchdog period is not the whole fault-to-off bound when
   feeding eligibility permits 2 s-old progress.

4. **Automatic off-state isolation is still design work.** The ADC interface
   drawing puts upper clamps on switched 3V3; removing the Pi alone does not
   remove those paths. Replacement interfaces must preserve input loading,
   pulse behavior, analog range and ground-reference integrity. Specify
   permitted pin voltages and leakage as well as rail voltage: a small rail
   reading alone is not a complete powered-off interface acceptance criterion.
   Treat historical "zero leakage" prose in the fuel spec in light of the
   newer caveat at its top and `fuel/NEXT_SESSION.md`; do not inherit it as
   proof. Fuel-owned corrections go to that owner as patches.

5. **The independent timer is required by the draft policy but absent from
   the circuit.** The next increment needs an actual timer, power-on/reset
   behavior, IGN qualification, latch and series HOLD-path interruption.
   It must survive logger reset and refuse rearming from HOLD or ordinary
   firmware activity. Specify recovery from its own brownout with IGN absent.
   QP drain-source short and IGN stuck high remain separate uncovered faults;
   do not silently expand the timer's claimed coverage to include them.

6. **Current documentation does not resolve protection and procurement.**
   CIN/COUT still lack exact series; the timer, isolation and vehicle
   protection are placeholder BOM entries. The upstream hardware record
   documents purchases, not present spare inventory. The standalone inventory
   files are not part of this checkout. No ordering or vehicle readiness is
   established by this review.

## Selected independent checks

The draft's nominal-model arithmetic reproduces:

| Calculation | Recomputed result | Limit of the check |
|---|---|---|
| 16 V input, 5 V output, L=19.8 uH, f=225 kHz | 0.771605 A peak-to-peak ripple; 1.135802 A peak at 0.75 A load | Ideal continuous-conduction model; no saturation/fault/stability proof |
| 820 uF +20%, 1k +1%, 5.25 V to 0.3 V | 2.8446 s | Passive isolated RC model; coupled converter/VSYS/3V3 decay still needs measurement |
| 100 uF +20%, 10k +1%, 16 V to 0.3 V | 4.8196 s | Same limitation; not a measured shutdown time |
| 100 uA over 30 days | 0.072 Ah | Budget conversion, not measured standby current |

Manufacturer checks support retaining the open gates:

- LM2678 standby is 50 uA typical, 100 uA maximum at 25 C and 150 uA
  maximum over its specified junction-temperature range. Its current-limit
  upper bound reaches 8.75 A. Output capacitance and ESR affect stability.
  These support the draft's EN comparison, fault-current concern and need
  for an exact capacitor choice. [TI LM2678, electrical characteristics and
  application guidance](https://www.ti.com/lit/ds/symlink/lm2678.pdf).
- The 1.5KE30A table specifies 41.4 V clamping at its stated pulse current
  and test conditions, not a universal ceiling for the installation. Its
  use still needs coordination with the regulator, drivers and harness.
  [Vishay 1.5KE series](https://www.vishay.com/docs/88301/15ke.pdf).

The Raspberry Pi PDF could not be read through the web tool in this pass
because of its size limit. The draft's full Pico electrical-limit audit has
not been independently revalidated here. No claim of all-part datasheet
verification is intended.

The BOM parses as eight columns on all 31 rows including its header. This
checks file structure only, not completeness or availability.

## Changes made during this review

- `INTERFACE_HANDOFF.md`: replaced ambiguous "fail to shutdown" wording
  with explicit boot/run behavior for a disconnected IGN sense wire; added
  the concrete startup, scheduling, shutdown-race and watchdog-bound issues.
- `PROTOTYPE_TEST_PLAN.md`: repaired a broken table cell containing raw pipe
  symbols; clarified fault-to-off timestamps and service-gap/race checks.
- `DESIGN.md`: updated the stale statement that the roadmap reverses B1/B2;
  upstream has now corrected it.

No firmware, reference-board files, fuel files, shared coordination, or
hardware history were edited. At the initial review checkpoint, no commits,
flashes, deployments, physical tests or messages to other agents had been
performed. The owner subsequently requested committing the remote work;
see `NEXT_SESSION.md` for that handoff.

## Bounded continuation

1. **Complete the maximum-on circuit first.** Produce its state/transition
   table, component-level net connections, timer tolerance and quiescent
   budget, startup/brownout analysis, and fault-injection cases. Integrate
   with the existing IGN override rather than making a new power module.
2. **Complete the signal-domain interface proposal.** Inventory every
   externally powered connection and select candidate digital/analog
   isolation with an error/loading budget. Send proposed fuel/firmware
   changes across their ownership boundaries.
3. **Close the power BOM and capture the schematic.** Choose exact passives
   and protection for the defined feed/load envelope; capture local power
   circuitry with ERC and reviewable PDF. Provisional choices must stay
   labelled provisional where feed or load measurements remain unavailable.
4. **Prepare the local-agent execution handoff.** It should enumerate exact
   parts to inspect/source, wiring and timing measurements, firmware-owner
   requests, and the evidence needed to move M2 forward. M5 layout gates
   remain distinct; this work does not authorize fabrication.

Needed from the owner/local agent before final choices: actual constant feed
(aux or starter), IGN source, ground/connector arrangement, available parts,
and physical load/environment measurements. The missing reference files are
`/srv/agent_share/inventory/inventory_list.md` and
`/srv/agent_share/inventory/tools/SCOPE.md`. These do not block timer/interface
design with explicitly stated assumptions. No further full transcript
transfer is presently needed.

## Inventory received after this review

The owner subsequently supplied `inventory_list.md` in the original transfer
folder. It has been moved into `logger-power/inventory_list.md` in this
checkout, unchanged, so the engineering handoff can carry its stock evidence.
The earlier missing-inventory statements describe the initial review only;
the scope setup document remains unavailable here.

Relevant listed stock includes CD4011/CD4001/CD4069 logic, NE555P timers,
LM393/LM339 comparators, 2N3904/2N2222 drivers, PC817 optocouplers, passive
assortments, and small AVR/PIC controllers. No CD4060/CD4040 counter or
dedicated long-duration low-power timer is listed. The inventory still does
not establish a spare P-channel power MOSFET or a suitable high-voltage,
low-quiescent always-on regulator. These are inventory observations, not
component selections or proof that a stock-only design is impossible.

The cutoff design may reuse confirmed gates/drivers and specify missing
timing/supply parts. Choosing a second MCU would introduce a separate
firmware/programming/fault-assurance task; it is not automatically equivalent
to the proposed independent hardware timing circuit. Check actual packages,
markings and unused quantities before committing the prototype BOM.

## Cutoff continuation after owner clarification

Owner confirmed auxiliary-battery testing, eventual starter-battery preference
near the gauge cluster, and through-hole preference with SMD acceptable.
`DESIGN.md` now records those decisions. No further transcript transfer is
needed to continue this circuit work.

`MAX_ON_CUTOFF.md` and its incremental BOM document a 2048 s hardware timer,
non-rearming HOLD permission latch, series sink-path switch, and the exact
local checks required. `check_max_on_logic.py` is an executable specification
of settled logic; it is not SPICE or physical validation. Oscillator startup,
temperature-rated clock selection, IGN/reset margins, A5 reverse-current
protection, hot leakage and the firmware qualification contract remain open.

The original 100k gate-source resistor is too sensitive to unbudgeted sink
leakage to assume a cutoff from a nominally off transistor. The candidate
uses a lower-leakage SMD switch and proposes 10k; the local agent must measure
gate bias and rail decay with QH deliberately shorted. The candidate is kept
separate from revision A to make these unvalidated changes explicit.

Pre-commit review caught a mismatch between the earlier 22k proposal's
0.5 V off-gate criterion and revision A's 0.2 V limit. The candidate now
preserves the 0.2 V criterion with 10k, allocating at most 19.8 µA total
sink leakage including +1% resistor tolerance. Complete leakage and on-state
gate-drive calculations remain remote design work; bench access is needed
only to validate the resulting circuit, not to do those calculations.
