jgazeley/accord/coordination/HANDOFF_INDEX.md

# Current task packets

> **Historical, frozen October 29, 2026.** The multi-agent process this
> describes is retired (owner direction; see `AGENTS.md`). Current state:
> [STATUS.md](STATUS.md). Owner decisions: [DECISIONS.md](DECISIONS.md).
> Kept unchanged below for history; don't act on its assignments or next steps.

Prepared October 28, 2026 by Codex `pcb-manager`, session `01a17045-1855-7af2-b76a-32c2b778cd64`. Historical bookmark: `codex resume 01a17045-1855-7af2-b76a-32c2b778cd64`. Successors use their own identities.

October 29, 2026 preceding update by Claude `pcb-manager`, session
`630dea87-5e4d-4bad-a1ff-d41b3a5f509b`.
Historical bookmark: `claude --resume 630dea87-5e4d-4bad-a1ff-d41b3a5f509b`.
Current update after resumption: Codex `pcb-manager`, session
`01a18447-07c2-7bb3-8318-9b276cfdb3b8`.
Resume: `codex resume 01a18447-07c2-7bb3-8318-9b276cfdb3b8`.

[PROJECT_MILESTONES.md](PROJECT_MILESTONES.md) owns all current states/claims.
This file is only a packet locator. Ready does not mean assigned or running.

| Task/role | Packet |
|---|---|
| Successor pcb-manager / DOC-01 | [Current layout-stage handoff](handoffs/PCB_MANAGER_LAYOUT_HANDOFF_2026-10-29.md). Earlier [October 28 transition](handoffs/PCB_MANAGER_TRANSITION_2026-10-28.md) and [superseded October 29 shift close](handoffs/PCB_MANAGER_TRANSITION_2026-10-29.md) are optional history |
| LRA-01 power interface | [Power-interface packet](handoffs/LRA-01_POWER_INTERFACE.md) |
| LRA-02 component margins/current budget | [Returning power-engineer packet](handoffs/LRA-02_COMPONENT_MARGINS.md) |
| LRA-05 firmware power | [Isolated implementation packet](handoffs/LRA-05_FIRMWARE_POWER.md) |
| LRA-03 as-built | [As-built/interface packet](handoffs/LRA-03_AS_BUILT.md) |
| LRA-04 communications | [Communications packet](handoffs/LRA-04_COMMUNICATIONS.md) |
| LRA-06 schematic capture | [Rev A schematic capture packet](handoffs/LRA-06_SCHEMATIC_CAPTURE.md) |
| LRA-11 B2 off-state isolation | [D4 resolution packet](handoffs/LRA-11_B2_OFFSTATE_ISOLATION.md) |
| LRA-11 review | [B2 isolation candidate review](reviews/LRA11_REVIEW_2026-10-29.md) |
| **LRA-12 electrical closure for owner layout — returned, revision packaged** | [Original assignment](handoffs/LRA-12_LAYOUT_ELECTRICAL_CLOSURE.md), [return review](reviews/LRA12_REVIEW_2026-10-29.md), [LRA-12R clamp rework packet](handoffs/LRA-12R_CLAMP_REWORK.md), [earlier readiness review](reviews/LAYOUT_READINESS_2026-10-29.md) |
| Other LRA tasks | Prepare from [template](TASK_PACKET_TEMPLATE.md) when assigned; scope/acceptance in tracker |

Optional history remains in old `coordination/HANDOFF_INDEX.md` at `1e99449`.
Do not dispatch its old prompts verbatim; they may describe obsolete firmware,
completed Wi-Fi work or superseded owners. Current workstream context starts at
[Rev A hardware](../logger/hardware/REV_A_CONTEXT.md) and the component READMEs.
