jgazeley/accord/coordination/reviews/LRA12_REVIEW_2026-10-29.md

# LRA-12 return — manager review

Prepared October 29, 2026 by Claude `pcb-manager`, session
`42dd0e33-28b5-4936-847e-9c2e1d2488fa`.
Resume: `claude --resume 42dd0e33-28b5-4936-847e-9c2e1d2488fa`.
Session ID read from this session's `CLAUDE_CODE_SESSION_ID`; this tool exposes
no second identifier to cross-check it.

Return reviewed: Claude `logger-electrical`, session
`b690946d-3a88-4626-8e7b-b321126a3d16`, branch `task/LRA-12-b690946d`,
`7ec53daf95f539c1cdb0896ed1869dd6bba0a547` (design) and
`ad4f9188a9cbef25b0c1717418076c5e9b92cda1` (handoff), base `5ffcb26`.
Packet: [LRA-12](../handoffs/LRA-12_LAYOUT_ELECTRICAL_CLOSURE.md).
Return entry point: `logger/hardware/LRA12_HANDOFF.md`.

## Verdict

**Revision requested on one decision, R12-REV-1; everything rerun here
reproduced.** The capture, BOM, footprints and checks are sound enough for the
owner to begin placement. The entry-clamp change rests on a premise that is
false, and correcting it may let the design keep the in-service 1.5KE30A,
which would also change D-OVERVOLT-04. Not integrated yet.

## What was rerun, in a detached worktree at `ad4f918`

| Check | Result here |
|---|---|
| `tools/gen_custom_sym.py`, `tools/gen_logger_sch.py` | `Custom.kicad_sym` and `BOM.csv` byte-identical; schematic differs only in freshly generated UUIDs and the instance paths that cite them |
| `kicad-cli sch erc --severity-all` (KiCad 9.0.2) | 0 violations |
| `kicad-cli sch export netlist` | Identical to `validation/netlist.net` apart from the library URI's absolute path |
| `check_capture.py` | 652/652 |
| `fp_area.py` | 1.52× courtyard allowance on 80 × 120 mm; `courtyard_study.csv` unchanged |
| `power/check_layout_closure.py` | Exit 0; the only OVER lines are the two A5 sub-allocation overruns the return itself declares |

Commit identities: author and committer `Claude logger-electrical [b690946d]
<claude@local.invalid>` on both commits, with `Agent-Session` and
`Claude-Session-ID` trailers. Only `logger/hardware/` paths inside the
packet's edit scope are touched.

## Independent physical checks

Written here against the exported netlist and the installed KiCad libraries,
not through the return's own assertions.

- **QP (Q5), TO-252-3_TabPin2:** pin 1 G → `/GATE`, pin 2 D → `/VIN_SW`,
  pin 3 S → `/P12`. Source on the supply, drain on the load: correct high-side
  P-FET, body diode blocks P12 → VIN_SW when off. Matches the DPAK pinout.
- **DZ (D114):** cathode `/P12` (source), anode `/GATE`. Clamps V<sub>GS</sub>
  negative as intended.
- **DREV (D112):** anode `/BATT_F`, cathode `/P12`. Series reverse block.
- **Entry TVS (D113) and B11 TVS (D108):** the KiCad `1.5KExxA` symbol names
  its pins A1/A2, but it is the unidirectional symbol ("1500W unidirectional
  TVS"); pin 1 sits on the bar side, so pin 1 is the cathode, and the
  `KathodeUp` footprint marks pad 1 "K". Pin 1 is on `/P12` and `/B11_TAP`:
  correct polarity.
- **UREG LM2678, TO-220-7:** 1 SW, 2 VIN (`/VIN_SW`), 3 BOOST, 4 GND, 5 NC,
  6 FB (`/B5`), 7 ON/OFF open. Matches the fixed-output pinout.
- **UA5 TPS70950, SOT-23-5:** 1 IN `/P_AON`, 2 GND, 3 EN open, 4 NC, 5 OUT
  `/A5`. Checked against TI SLVSCE6D (revised August 2025) Table 4-1: DBV
  pinout matches, and "This pin can be left floating to enable the device".
  Minor wording: Table 4-1 states EN "must remain below 6.5 V"; the return
  quotes 7 V. Immaterial with EN open.
- **UISO ASSR-601JV (U3), local footprint:** 12 pads, 11–14 omitted; LED
  4 (AN) / 5 (CA); outputs 15/16 `/B2_TAP` and 9/10 `/B2_ISO`; pin 3 left
  unconnected; 1, 2, 6, 7, 8 NC. Consistent with the packet's
  absent-lead/pin-3 requirement. The pad geometry was not rechecked against
  the Broadcom drawing in this pass.

## Findings

### R12-REV-1 — the clamp chain's premise is false (revision requested)

`LAYOUT_CLOSURE.md` §3.1 step 2 and §3.4 option (c) rest on "the only
P-channel candidate with a hot zero-gate drain-current maximum is
IPD50P04P4L-11", rated 40 V, so a ≥45 V switch with a hot I<sub>DSS</sub>
maximum "was not found".

Vishay **SQD50P06-15L** (document 69098, S12-2006 Rev. E,
[datasheet](https://www.vishay.com/docs/69098/sqd50p06.pdf)): −60 V
V<sub>DS</sub>, ±20 V V<sub>GS</sub>, AEC-Q101, TO-252 (same footprint family
as the selected QP). I<sub>DSS</sub> at V<sub>GS</sub> = 0, **V<sub>DS</sub> =
−60 V**: 1 µA max at 25 °C, **50 µA max at T<sub>J</sub> = 125 °C**, 150 µA at
175 °C. That is a hotter-specified, lower maximum than the selected part's
70 µA at 125 °C and −32 V. R<sub>DS(on)</sub> 15.5 mΩ at −10 V, 20.0 mΩ at
−4.5 V; V<sub>GS(th)</sub> −1.5 to −2.5 V.

So the clamp change is a **choice, not forced**. Option (c) is materially
cheaper than stated, and it is the option that keeps the working inherited
part the packet told the engineer to reuse (D-REUSE-02, D-POWER-03):

- **Benefit:** the 1.5KE30A's 25.6 V standoff survives a sustained 24 V jump
  start or an alternator overcharge up to about that voltage, which is
  exactly the exposure D-OVERVOLT-04 had to defer. A higher clamp also
  absorbs much less energy from a long, partly suppressed surge than a
  27.7 V clamp does. And it restores the in-vehicle precedent: keyless runs
  the same LM2678 + 1.5KE30A pair in this car.
- **Cost to evaluate, not assumed closed:** QI/QH/QMON/QRESET need a
  ≥60 V V<sub>CEO</sub> BJT with a usable off-state leakage figure, because the
  41.4 V clamp exceeds the 2N3904's 40 V (an existing defect that `DESIGN.md`
  §4 already recorded). The A5 second stage must be redone for a ~43.5 V hot
  clamp: at 330 Ω the BZX55C22 would carry about 56 mA and dissipate about
  1.4 W against 0.5 W, so R_AON and/or the zener change, re-checking the A5
  dropout floor and the series drop at 6 V. The LM2678 goes back to the
  keyless in-service margin (40 V operating, 45 V absolute) rather than
  10.8 V of headroom. Footprints are unchanged or similar (TO-252, TO-92,
  axial), so this does not stop placement.

**Requested:** re-run §3.1/§3.2/§3.4 with SQD50P06-15L (or an equivalent
≥60 V part with a hot I<sub>DSS</sub> maximum) included. Either adopt
option (c) with the A5 stage and BJTs re-checked, or keep the 1.5KE20A with
a reason other than "forced". Update the ledger row for QP. Decide before
the power-entry area is routed.

### R12-REV-2 — name the exposure accurately (documentation)

L04 and handoff §1/§5.3 call the exclusion "a 24 V jump start". The actual
limit is **any sustained P12 above the 17.1 V standoff**, which includes an
alternator/regulator overcharge fault with no operator error. Restate it that
way, as D-OVERVOLT-04 records. Moot if R12-REV-1 adopts option (c), but then
the new sustained ceiling (about 25.6 V) should be stated the same way.

### R12-REV-3 — deterministic UUIDs (requested before owner placement)

`tools/gen_logger_sch.py` assigns fresh random UUIDs on every run. Once a
`.kicad_pcb` exists, every regeneration breaks KiCad's symbol-to-footprint
links. Derive them deterministically so that an unchanged parts table
reproduces the schematic byte for byte.

The rework is packaged as [LRA-12R](../handoffs/LRA-12R_CLAMP_REWORK.md).

## Dispositions of the return's three requests

1. **Parked-current re-allocation (L07, §7): accepted by the manager**,
   within the unchanged 100/500 µA totals, which close as component screens at
   74.98/452.65 µA (reproduced). `INTERFACE_CONTRACT.md` §7 already allows
   reviewer redistribution inside the total. Electrical acceptance is still
   open, and the QP row is updated if R12-REV-1 changes the part
   (SQD50P06-15L screens 50 µA hot, inside the proposed 70 µA row).
2. **Sustained-overvoltage exclusion (L04): owner decision D-OVERVOLT-04,
   defer**, recorded in the tracker as a named vehicle-acceptance residual risk.
   It is conditional on R12-REV-1 and is revisited if the 1.5KE30A is kept.
3. **1.5KE30A → 1.5KE20A (§3.1): not accepted as forced**; see R12-REV-1.

## Not reviewed in this pass

The isolation enable logic (`isolation/ISO_ENABLE.md`) beyond the U3 pin map,
the X2–X5 reachable-state table, the grounding and opto-LED return (R06-REV-2),
connector pinouts and mating parts, the communications provision, the layout
guidance (§8), and the ASSR and oscillator footprint geometry against the
manufacturer drawings. **The schematic has still not been visually inspected**;
this host cannot render it. Someone must open
`logger/hardware/kicad/accord-logger.kicad_pro` in KiCad once.

No bench work, purchase, flash, wiring, deployment or database change was made.

> **Required agent attribution:** Follow `logger/coordination/AGENT_ATTRIBUTION.md`
> relative to this project root. Use your own tool, role and verified current
> session ID for Git author and committer identity (`<Tool> <role> [<short-id>]`),
> with per-command settings. End each new commit message with `Agent-Session: <role>`
> and your full tool-specific session-ID trailer (`Codex-Session-ID`,
> `Claude-Session-ID` or `Antigravity-Session-ID`). This includes documentation-only
> commits. Identify yourself and your resume command in new coordination documents
> and dated updates. Preserve predecessor bookmarks and original attribution when
> transporting existing commits. If your ID is unavailable, say so rather than
> inventing one. Include this requirement in any seeds or handoffs you create.
