jgazeley/accord/coordination/handoffs/PCB_MANAGER_LAYOUT_HANDOFF_2026-10-29.md

# Current manager handoff — LRA-12 started, waiting on remote usage

> **Update, October 29, by Claude `pcb-manager`, session
> `42dd0e33-28b5-4936-847e-9c2e1d2488fa`
> (`claude --resume 42dd0e33-28b5-4936-847e-9c2e1d2488fa`), now the manager.**
> The owner supplied the LRA-12 claimant: Claude session
> `b690946d-3a88-4626-8e7b-b321126a3d16`, working **locally** in
> `/srv/agent_share/accord-lra12` on `task/LRA-12-b690946d`, not remotely. The
> rest of this handoff still applies; the tracker has the current record.

Prepared October 29, 2026 by Codex `pcb-manager`, session
`01a18447-07c2-7bb3-8318-9b276cfdb3b8`.
Resume: `codex resume 01a18447-07c2-7bb3-8318-9b276cfdb3b8`.
Identity verified from matching `CODEX_SESSION_ID` and `CODEX_THREAD_ID`.

This is the current onboarding handoff, superseding the October 28 transition
and the superseded October 29 Claude shift-close as a source of next actions.
It is a checkpoint, not an automatic transfer of the manager claim. A successor
claims its own verified identity in AGENTS.md and the tracker.

## Read in this order

1. Root `AGENTS.md`: authority, ownership, attribution and core-document policy.
2. [PROJECT_MILESTONES.md](../PROJECT_MILESTONES.md): the single live task and
   decision authority; especially LRA-12 and D-REUSE-02.
3. [REV_A_CONTEXT.md](../../logger/hardware/REV_A_CONTEXT.md): concise current
   hardware/firmware summary and source map.
4. [LRA-12](LRA-12_LAYOUT_ELECTRICAL_CLOSURE.md): the existing remote assignment.
   Its [readiness review](../reviews/LAYOUT_READINESS_2026-10-29.md) identifies
   existing design sources and the bounded remaining electrical work.

Do not replay transcripts or mine Git history for a general recap. Use those,
the detailed reviews and session bookmarks only for a specific missing fact.

## Where the work stands

The owner has started LRA-12 with a remote engineer **building on the existing
`logger/hardware/kicad/accord-logger.kicad_pro` and `.kicad_sch`**. The engineer
ran out of usage; the owner estimated another one or two hours at the time of
reporting. This is an occupied assignment temporarily waiting to resume, not
an abandoned task or a request to dispatch a replacement.

The remote tool/session ID, branch and partial results were not supplied to this
manager. Fetch found no LRA-12 remote-tracking branch at this audit. Record the
actual identity/branch when available; do not invent them or assume nothing was
done merely because no work has been pushed. Preserve the engineer's edit scope.
No further user input is needed to understand the assignment or continue it.

The owner wants to do PCB placement and routing. LRA-12 must deliver the completed
electrical schematic, consolidated BOM, verified footprints and fit/keepout
guidance. The agreed envelope is 80 × 120 mm. It completes the existing project;
it does not rebuild it or take the layout work away from the owner.

The design starting point is **working hondaPico circuitry + documented logger
inputs/SD + existing IGN-controlled hold/shutoff design**. Reuse applicable
circuits by default. The superseded “copy no circuit” instruction has been
corrected. Any change to a working inherited block needs a concrete reason
in the logger's changed load, connections or power-off conditions.

## Verified checkpoints and limits

- `aa72fe2`: LRA-11 original return merged with original authorship preserved;
  manager review and LRA-12 packet published. All 24 imported isolation
  arithmetic checks reran successfully. They do not qualify the circuit.
- `5ffcb26`: owner reuse clarification made explicit in the tracker and packet;
  old no-circuit-copy restriction superseded. Both checkpoints were pushed.
- Broadcom's explicit table-wide temperature condition closes the LRA-11
  leakage-temperature question. Actual enable behavior, finite leakage,
  timing conditions and footprint still need the LRA-12 implementation.
- Existing qualified-IGN and independent-cutoff connection tables already
  answer X6/X8's design-source questions. The current capture still needs them
  implemented. Other protection/isolation/grounding/connector decisions remain
  in the bounded packet. **No completed electrical layout handoff is claimed.**
- Public firmware is `0.8.1-lra05-dev`; manual mode remains default. The opt-in
  power implementation exists; masked-interrupt and physical acceptance remain
  open. No new flash, wiring change, purchase or deployment occurred here.

## Next manager actions

1. Let the assigned engineer resume. Ensure it incorporates main's current
   packet/reuse clarification while preserving its branch and uncommitted work;
   do not reset its checkout or write into its implementation scope.
2. When its return arrives, record session/branch/full commits and review the
   actual schematic, BOM, footprint/net checks, ERC and residual-gate table
   against LRA-12. Verify author **and committer** identities after transport or
   rebase; use per-command identity settings, never the owner's global identity.
3. Integrate the reviewed result and update the core documents together. If the
   electrical handoff passes, the owner can proceed to LRA-08 placement/routing.
   Do not turn later bench/vehicle qualification into an unspecified layout gate.
4. Keep fabrication recommendation, owner ordering, bring-up and unattended
   vehicle acceptance distinct. No automatic authorization follows from Git.

## Core-document audit at this checkpoint

| Entry point | Audit result / change |
|---|---|
| `AGENTS.md` | Current manager identity retained; current handoff linked; standing owner-requested core-document audit policy added |
| `PROJECT_MILESTONES.md` | LRA-12 changed from ready/unclaimed to owner-assigned/started, usage wait and missing identity stated; duplicate dispatch prohibited |
| `HANDOFF_INDEX.md` | Current handoff first; previous handoffs marked history; LRA-12 identified as already assigned |
| `logger/hardware/REV_A_CONTEXT.md` | Replaced stale pre-LRA-03 unknowns and pre-LRA-05 firmware assumptions with current fitted summary, measurements, design sources and limits |
| `logger/README.md`, `logger/NEXT_AGENT.md` | Checked against FW_VERSION, power_config and native runner; README corrected to actual candidate, manual default and nine-suite runner. Configuration reference already reflects LRA-05 |
| `logger/hardware/README.md`, `logger/hardware/power/README.md` | Hardware README already states incomplete capture; power README now points to current continuation rather than dispatching LRA-01 again |
| LRA-12 packet | Removed stale unclaimed label; tracker owns actual assignment. Implementation requirements and current KiCad base preserved |
| Source and transport state | Initial main checkout clean and matched fetched origin/main. No remote LRA-12 branch visible. No engineer implementation files modified by this audit |

This was an onboarding/status audit, not a new electrical acceptance or a rerun
of unchanged firmware/CAD tests. Older engineering records retain historical
statements; their revision precedence and current corrections are linked from
the core documents. In particular, do not revive the 75.3 µA divider-only B2
figure or the pre-measurement claim that B2 is dead while parked. No transcript
or session-log access was needed for this checkpoint.

## Publication and boundaries

The commit carrying this handoff records the audit and its attribution. Check
checkout/remote state on entry rather than assuming a clean worktree persists.
For future reviewed publications, push on this host uses:

```sh
git -c core.sshCommand='ssh -i ~/.ssh/id_ed25519_accord_public -o IdentitiesOnly=yes' \
    push git@github.com:jgazeley/accord.git main:main
```

No private credentials, configured binaries, inventory dump, personal recordings
or runtime/database data belong in the handoff. Git and source manifests retain
deeper provenance; predecessor bookmarks remain in AGENTS.md and earlier records.

> **Required agent attribution:** Follow `logger/coordination/AGENT_ATTRIBUTION.md`
> relative to this project root. Use your own tool, role and verified current
> session ID for Git author and committer identity (`<Tool> <role> [<short-id>]`),
> with per-command settings. End each new commit message with `Agent-Session: <role>`
> and your full tool-specific session-ID trailer (`Codex-Session-ID`,
> `Claude-Session-ID` or `Antigravity-Session-ID`). This includes documentation-only
> commits. Identify yourself and your resume command in new coordination documents
> and dated updates. Preserve predecessor bookmarks and original attribution when
> transporting existing commits. If your ID is unavailable, say so rather than
> inventing one. Include this requirement in any seeds or handoffs you create.
