jgazeley/accord/coordination/handoffs/PCB_MANAGER_TRANSITION_2026-10-29.md

# Manager shift close — October 29, 2026

> **SUPERSEDED, later the same day. Do not act on the "Next actions" below.**
>
> This was written as a shift-close handoff at 06:38 on October 29. The shift
> did not end: the same manager session continued through the day and
> everything this document proposes as next work is finished or overtaken.
> It is kept as a point-in-time record, not as guidance.
>
> Two things in it are now wrong. The LRA-04 review has **five** standing
> findings, not six — R04-REV-3 was withdrawn as the reviewer's error at
> `564bd7d`, and the browser return's "proven on keyless" claim was correct.
> And the "LRA-06 start condition" is long past: LRA-06 was packaged, claimed,
> returned, reviewed over four revisions and **integrated onto `main`** at
> `logger/hardware/kicad/`.
>
> What happened after this was written: the owner measured the car, closing
> U-10, U-11 and U-14 and part of U-07 and U-08; D4 narrowed from five branches
> to one and became `LRA-11`; the board envelope was fixed at 80 × 120 mm.
>
> **For current state read [the tracker](../PROJECT_MILESTONES.md).** The
> critical path at that checkpoint was `LRA-11 → LRA-08 → LRA-09`.
> Later manager review corrected it to **LRA-12 electrical completion → owner
> LRA-08 layout → LRA-09**, because the capture still omits existing power
> circuitry. See [LRA-12](LRA-12_LAYOUT_ELECTRICAL_CLOSURE.md).
> Correction by Codex `pcb-manager`, session
> `01a18447-07c2-7bb3-8318-9b276cfdb3b8`
> (`codex resume 01a18447-07c2-7bb3-8318-9b276cfdb3b8`), October 29.

Prepared October 29, 2026 by Claude `pcb-manager`, session
`630dea87-5e4d-4bad-a1ff-d41b3a5f509b`.
Bookmark: `claude --resume 630dea87-5e4d-4bad-a1ff-d41b3a5f509b`.
Session ID read from this session's harness-assigned working paths and confirmed
against its transcript file; this tool exposes no second identifier to
cross-check it against. Successors claim their own identity.

This supplements, and does not replace,
[the October 28 manager handoff](PCB_MANAGER_TRANSITION_2026-10-28.md), whose
start prompt, reading order and role boundaries still apply.
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
