jgazeley/accord/logger/hardware/kicad/mechanical/case-bottom/preview.png

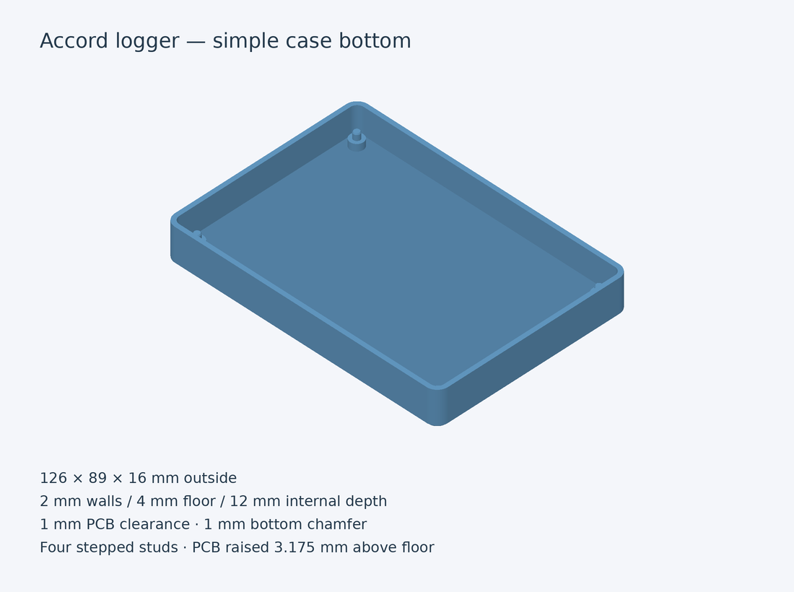
logger/hardware/kicad/mechanical/case-bottom/preview.png
