jgazeley/accord/logger/hardware/kicad/mechanical/case-bottom/underside-preview.png

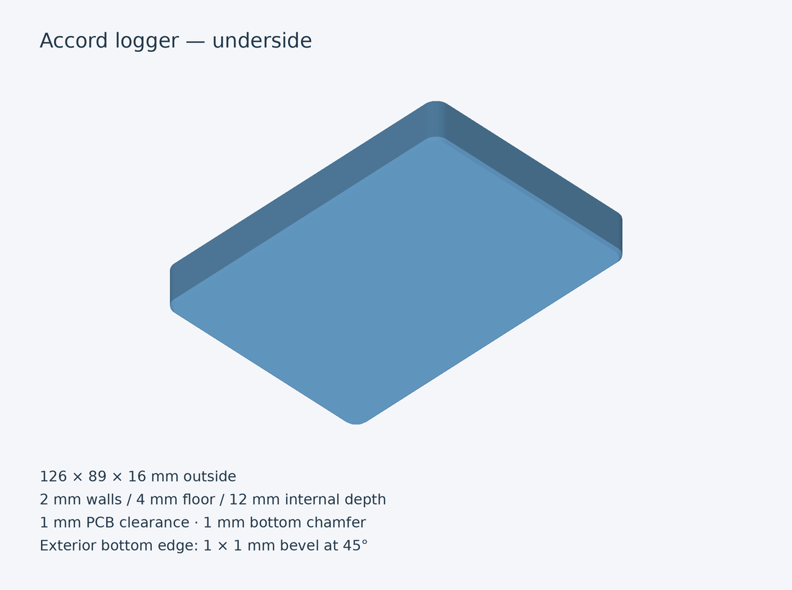
logger/hardware/kicad/mechanical/case-bottom/underside-preview.png
