jgazeley/accord/logger/hardware/kicad/BOM.csv

reference | source_designator | value | symbol | manufacturer_part_or_type | footprint | population | status | source | notes
J1 | J1 | Board connector 14-way | Connector_Generic:Conn_01x14 | JAE IL-AG5-14P-D3L2-A, 14 contact right-angle pin header | accord-logger:JAE_IL-AG5-14P-D3L2-A | FIT | SELECTED | DECISIONS D-CONN-06 / JAE IL-AG5 catalogue | JAE IL-AG5 2.5 mm, 14 contacts, right-angle through-hole with board guides, 3 A per contact. Mates with housing IL-AG5-14S-D3C1-A and IL-AG5-C1-5000 crimp sockets (AWG 22-18); hand crimp tool CT150-1-AG5. Same family as the keyless 22P. Footprint pin numbers follow the keyless 22P convention (pin 1 outer row, left end from the mating face): verify against the housing cavity numbers before crimping. 6 BATT_IN, +12 V through the harness inline fuse (1 A, at the feed end; D-FUSE-10, no fuse on the board). 14 PGND power return; 2 PGND as the dedicated RS-485 bus ground. 10 is the B16 cluster ground sense, bonded to the single AGND node at one point (REV_A_INTERFACES S4, delta D5); never a power or bus return. 1/7 RS-485 A/B; run them as a twisted pair with pin 2. 8, 11, 12 spare
U3 | UISO | ASSR-601JV | Custom:ASSR-601JV | Broadcom ASSR-601JV-000E | accord-logger:ASSR-601Jx_SO-16-12Lead_11.634x10.363mm_P1.27mm | FIT | SELECTED_AVAILABILITY_OPEN | isolation/B2_ISOLATION.md; LAYOUT_CLOSURE S4 | B2 series isolation (D4). Output leakage 1000 nA maximum at VO = 1000 V, specified over recommended operating conditions (-40 to +105 C for the JV), against 4.669 V actually applied: the row carries no 25 C override, unlike the withstand row above it. R_ON 300 ohm max at IO = 2 mA shifts the 22k/33k ratio by -0.54 %. D1 (15, 16) and D2 (9, 10) are each internally paired and the pair is bidirectional, so orientation is free. PIN 3 MUST BE LEFT UNCONNECTED - it is internally tied to pin 5, the LED cathode. Pins 11-14 do not exist; the local footprint is a 12-pad variant derived from the manufacturer land pattern, not a stock SOIC-16W. Availability is the one open item: distributor lifecycle data is contradictory. Panasonic AQY221N2S is the documented fallback, a strictly smaller part inside the same keepout, whose 10 nA leakage maximum is 25 C only
R1 | R_VSS_T | 22k | Device:R |  | Resistor_THT:R_Axial_DIN0204_L3.6mm_D1.6mm_P5.08mm_Horizontal | FIT | VERIFY_STOCK | AS_BUILT S2 | fitted divider top, value unchanged; fed from the ASSR output rather than directly from the tap [D-THT-15: through-hole DIN0204, owner choice; 0.25 W metal film, 1 %.]
R2 | R_VSS_B | 33k | Device:R |  | Resistor_THT:R_Axial_DIN0204_L3.6mm_D1.6mm_P5.08mm_Horizontal | FIT | VERIFY_STOCK | AS_BUILT S2 | fitted divider bottom, value unchanged [D-THT-15: through-hole DIN0204, owner choice; 0.25 W metal film, 1 %.]
D101 | D_VSS | 1N5819 | Diode:1N5819 | 1N5819 (DO-41), as fitted on the breadboard | Diode_THT:D_DO-41_SOD81_P5.08mm_Vertical_AnodeUp | FIT | VERIFY_STOCK | AS_BUILT S2/S3.4a, U-07 | fitted clamp, anode at the pin, cathode to switched 3V3. This is the specimen behind U-07's first measured point: the parked B2 readings give it 159 mV at 109 uA at room temperature, a Schottky drop. With UISO fitted the branch is open upstream when the board is off, so this clamp no longer has a parked path to conduct [D-THT-15: back to the through-hole 1N5819 on DO-41 vertical; pad 1 is the cathode, as before.]
R3 | R_TACH_T | 22k | Device:R |  | Resistor_THT:R_Axial_DIN0204_L3.6mm_D1.6mm_P5.08mm_Horizontal | FIT | VERIFY_STOCK | AS_BUILT S2 | fitted divider top, value unchanged. D4 bypass, decided in LAYOUT_CLOSURE S4: this branch is ignition-fed and measured or logged dead with the key out, so criterion A is met with no device at all. Reaching criterion B needs the key on AND an upstream power fault, because ignition present turns QI on and powers the board. In that fault state the fitted series resistance bounds the injection. [D-THT-15: through-hole DIN0204, owner choice; 0.25 W metal film, 1 %.]
R4 | R_TACH_B | 6.8k | Device:R |  | Resistor_THT:R_Axial_DIN0204_L3.6mm_D1.6mm_P5.08mm_Horizontal | FIT | VERIFY_STOCK | AS_BUILT S2 | fitted divider bottom, value unchanged [D-THT-15: through-hole DIN0204, owner choice; 0.25 W metal film, 1 %.]
D102 | D_TACH | 1N5819 | Diode:1N5819 | 1N5819 (DO-41), as fitted on the breadboard | Diode_THT:D_DO-41_SOD81_P5.08mm_Vertical_AnodeUp | FIT | VERIFY_STOCK | AS_BUILT S2/S3.4a, U-07 | fitted clamp, anode at the pin, cathode to switched 3V3. D11 remains open for the tach cell: V_F keeps falling below 109 uA, so its clamp onset is lower than a 0.3 V assumption gives. LRA-12 changes no ratio [D-THT-15: back to the through-hole 1N5819 on DO-41 vertical; pad 1 is the cathode, as before.]
R5 | R_BRK_T | 22k | Device:R |  | Resistor_THT:R_Axial_DIN0204_L3.6mm_D1.6mm_P5.08mm_Horizontal | FIT | VERIFY_STOCK | AS_BUILT S2 | fitted divider top, value unchanged. D4 bypass, decided in LAYOUT_CLOSURE S4: this branch is ignition-fed and measured or logged dead with the key out, so criterion A is met with no device at all. Reaching criterion B needs the key on AND an upstream power fault, because ignition present turns QI on and powers the board. In that fault state the fitted series resistance bounds the injection. [D-THT-15: through-hole DIN0204, owner choice; 0.25 W metal film, 1 %.]
R6 | R_BRK_B | 6.8k | Device:R |  | Resistor_THT:R_Axial_DIN0204_L3.6mm_D1.6mm_P5.08mm_Horizontal | FIT | VERIFY_STOCK | AS_BUILT S2 | fitted divider bottom, value unchanged [D-THT-15: through-hole DIN0204, owner choice; 0.25 W metal film, 1 %.]
D103 | D_BRK | 1N5819 | Diode:1N5819 | 1N5819 (DO-41), as fitted on the breadboard | Diode_THT:D_DO-41_SOD81_P5.08mm_Vertical_AnodeUp | FIT | VERIFY_STOCK | AS_BUILT S2/S3.4a, U-07 | fitted clamp, anode at the pin, cathode to switched 3V3. D11 remains open for the tach cell: V_F keeps falling below 109 uA, so its clamp onset is lower than a 0.3 V assumption gives. LRA-12 changes no ratio [D-THT-15: back to the through-hole 1N5819 on DO-41 vertical; pad 1 is the cathode, as before.]
R7 | R_FUEL_T | 7.5k | Device:R |  | Resistor_THT:R_Axial_DIN0204_L3.6mm_D1.6mm_P5.08mm_Horizontal | FIT | VERIFY_STOCK | AS_BUILT S2 | fitted divider top, value unchanged. D4 bypass, decided in LAYOUT_CLOSURE S4: this branch is ignition-fed and measured or logged dead with the key out, so criterion A is met with no device at all. Reaching criterion B needs the key on AND an upstream power fault, because ignition present turns QI on and powers the board. In that fault state the fitted series resistance bounds the injection. No series element is added, so the card header's two-term fuel calibration (log.adc.fuel div=7500/4700) stays valid and REV_A_INTERFACES S8.2 needs no change [D-THT-15: through-hole DIN0204, owner choice; 0.25 W metal film, 1 %.]
R8 | R_FUEL_B | 4.7k | Device:R |  | Resistor_THT:R_Axial_DIN0204_L3.6mm_D1.6mm_P5.08mm_Horizontal | FIT | VERIFY_STOCK | AS_BUILT S2/S3.3 | fitted divider bottom; returns to the single B16 sense node [D-THT-15: through-hole DIN0204, owner choice; 0.25 W metal film, 1 %.]
R9 | R_FUEL_S | 1k | Device:R |  | Resistor_THT:R_Axial_DIN0204_L3.6mm_D1.6mm_P5.08mm_Horizontal | FIT | VERIFY_STOCK | AS_BUILT S2 rows 4a/5a | fitted series resistor at the pin [D-THT-15: through-hole DIN0204, owner choice; 0.25 W metal film, 1 %.]
C1 | C_FUEL | 1uF | Device:C |  | Capacitor_SMD:C_0805_2012Metric_Pad1.18x1.45mm_HandSolder | FIT | VERIFY_OR_SOURCE | AS_BUILT S2 rows 4a/5a | fitted filter capacitor; exact dielectric/rating not recorded [D-SMD-09: 0805 X7R, rated voltage not below the disc it replaces]
D104 | D_FUEL_H | 1N5819 | Diode:1N5819 | 1N5819 (DO-41), as fitted on the breadboard | Diode_THT:D_DO-41_SOD81_P5.08mm_Vertical_AnodeUp | FIT | VERIFY_STOCK | AS_BUILT S2 rows 4a/5a | fitted upper clamp [D-THT-15: back to the through-hole 1N5819 on DO-41 vertical; pad 1 is the cathode, as before.]
D105 | D_FUEL_L | 1N5819 | Diode:1N5819 | 1N5819 (DO-41), as fitted on the breadboard | Diode_THT:D_DO-41_SOD81_P5.08mm_Vertical_AnodeUp | FIT | VERIFY_STOCK | AS_BUILT S2 rows 4a/5a | fitted lower clamp [D-THT-15: back to the through-hole 1N5819 on DO-41 vertical; pad 1 is the cathode, as before.]
R10 | R_SUP_T | 22k | Device:R |  | Resistor_THT:R_Axial_DIN0204_L3.6mm_D1.6mm_P5.08mm_Horizontal | FIT | VERIFY_STOCK | AS_BUILT S2 | fitted divider top, value unchanged. D4 bypass, decided in LAYOUT_CLOSURE S4: this branch is ignition-fed and measured or logged dead with the key out, so criterion A is met with no device at all. Reaching criterion B needs the key on AND an upstream power fault, because ignition present turns QI on and powers the board. In that fault state the fitted series resistance bounds the injection. No series element is added, so the card header's two-term fuel calibration (log.adc.fuel div=7500/4700) stays valid and REV_A_INTERFACES S8.2 needs no change [D-THT-15: through-hole DIN0204, owner choice; 0.25 W metal film, 1 %.]
R11 | R_SUP_B | 4.7k | Device:R |  | Resistor_THT:R_Axial_DIN0204_L3.6mm_D1.6mm_P5.08mm_Horizontal | FIT | VERIFY_STOCK | AS_BUILT S2/S3.3 | fitted divider bottom; returns to the single B16 sense node [D-THT-15: through-hole DIN0204, owner choice; 0.25 W metal film, 1 %.]
R12 | R_SUP_S | 1k | Device:R |  | Resistor_THT:R_Axial_DIN0204_L3.6mm_D1.6mm_P5.08mm_Horizontal | FIT | VERIFY_STOCK | AS_BUILT S2 rows 4a/5a | fitted series resistor at the pin [D-THT-15: through-hole DIN0204, owner choice; 0.25 W metal film, 1 %.]
C2 | C_SUP | 1uF | Device:C |  | Capacitor_SMD:C_0805_2012Metric_Pad1.18x1.45mm_HandSolder | FIT | VERIFY_OR_SOURCE | AS_BUILT S2 rows 4a/5a | fitted filter capacitor; exact dielectric/rating not recorded [D-SMD-09: 0805 X7R, rated voltage not below the disc it replaces]
D106 | D_SUP_H | 1N5819 | Diode:1N5819 | 1N5819 (DO-41), as fitted on the breadboard | Diode_THT:D_DO-41_SOD81_P5.08mm_Vertical_AnodeUp | FIT | VERIFY_STOCK | AS_BUILT S2 rows 4a/5a | fitted upper clamp [D-THT-15: back to the through-hole 1N5819 on DO-41 vertical; pad 1 is the cathode, as before.]
D107 | D_SUP_L | 1N5819 | Diode:1N5819 | 1N5819 (DO-41), as fitted on the breadboard | Diode_THT:D_DO-41_SOD81_P5.08mm_Vertical_AnodeUp | FIT | VERIFY_STOCK | AS_BUILT S2 rows 4a/5a | fitted lower clamp [D-THT-15: back to the through-hole 1N5819 on DO-41 vertical; pad 1 is the cathode, as before.]
D108 | TVS_B11 | 1.5KE20A-E3/54 | Diode:1.5KExxA | Vishay 1.5KE20A-E3/54 | Diode_THT:D_DO-201AD_P5.08mm_Vertical_KathodeUp | FIT | SELECTED | LAYOUT_CLOSURE S3; D-POWER-03 consequence 2 | ignition/supply-sense entry clamp. Same part as the P12 clamp, so one qualification covers both: 17.1 V standoff, 19.0-21.0 V VBR at 1 mA, 27.7 V clamp at 54.2 A for 10/1000 us, 1.0 uA maximum leakage at standoff. POLARITY: Diode:1.5KExxA is the unidirectional family and draws a real cathode bar, so a reversal is visible in the drawing - but its pins are still named A1/A2, so ERC cannot check it and check_capture.py asserts it by pin number instead. Pin 1 is the banded cathode and goes to the tap. Keyless protects its harness lines with seven P6KE30A; the owner has four. They are not used here because their 41.4 V clamp is above the 40 V parts this board puts behind it
U1 | U1 | RaspberryPi_Pico_W | MCU_Module:RaspberryPi_Pico_W | Raspberry Pi Pico W (RP2040 + CYW43439) | Module:RaspberryPi_Pico_W_SMD_HandSolder | FIT | FITTED | REV_A_INTERFACES S1 | fitted module; Rev A column of the pin map. GP7 (pin 10) is the ISO_EN reservation LRA-12 takes up, confirmed free in S1. GP8/GP9 (UART1) and GP10 (DE//RE) go to onboard RS-485, and GP13 is offered on J3 as a spare. GP8/9/10 are now assigned to RS-485
D109 | DI | 1N5819 | Diode:1N5819 | 1N5819 (DO-41), as fitted on the breadboard | Diode_THT:D_DO-41_SOD81_P5.08mm_Vertical_AnodeUp | FIT | VERIFY_STOCK | AS_BUILT S2 row 6 / S3.4 | fitted series diode; owner reported 1N5819, not the 1N4148 of DESIGN.md S3. The onboard FIGN of DESIGN.md S3 is deliberately not fitted: REV_A_INTERFACES S5.1 and delta D10 put per-branch fuses at the tap end, an onboard fuse cannot protect the upstream harness, and the board cannot draw enough through RI and RLED (1.1k together) to need one. Capture question Q4, closed [D-THT-15: back to the through-hole 1N5819 on DO-41 vertical; pad 1 is the cathode, as before.]
R13 | RLED | 2.2k | Device:R |  | Resistor_THT:R_Axial_DIN0414_L11.9mm_D4.5mm_P5.08mm_Vertical | FIT | VERIFY_STOCK | AS_BUILT S3.4a, measured 2026-10-29 | measured 2.2k carried forward (D15), specified 0.5 W. At the 17.1 V sustained ceiling the standoff of the entry clamp sets, dissipation is 0.108 W; the 0.792 W figure that broke the 1k candidate came from the superseded 28 V number. Fitted wattage is not recorded, so the 0.5 W position is specified rather than assumed
D110 | DR | 1N4148W | Diode:1N4148W | Diodes Inc 1N4148W-7-F | Diode_SMD:D_SOD-123 | FIT | MISSING | DESIGN.md S3 | LED reverse clamp. With the LED cathode now on PGND this sits directly antiparallel with the LED, which is the arrangement DESIGN.md S3 specifies and the position that actually limits LED reverse voltage (BVR 6 V on the PC817 input) [D-SMD-09: 1N4148W, SOD-123]
U2 | U2 | PC817 | Isolator:PC817 | Sharp PC817XNNSZ1B or qualified equivalent | Package_DIP:DIP-4_W7.62mm | FIT | VERIFY_STOCK | AS_BUILT S2 rows 6-7 / S3.4; CUTOFF_MARGIN_REVIEW S2 | Rewired by LRA-12 into the A5 domain, which is what X6 was holding open: collector (4) to A5 and emitter (3) to IGN_A, an emitter follower into the 47k/220k/1uF qualification filter, replacing the old collector-to-GP5 arrangement that D-RA-03 forbids mixing with the qualified proposal. LED CATHODE MOVED FROM B16 TO PGND (R06-REV-2 / Q2): REV_A_INTERFACES S4 makes B16 a reference that must never become a power return, and the fitted cell put 4.7-5.8 mA of signal-dependent LED current through the node both ADC channels reference. No symbol encodes this pinout, so it is asserted by pin number in check_capture.py: 1 LED anode, 2 LED cathode, 3 emitter, 4 collector (AS_BUILT S3.4a). The fitted 100 nF across the old collector output is not carried forward - the node it filtered no longer exists
R14 | RIGNA | 47k | Device:R |  | Resistor_THT:R_Axial_DIN0204_L3.6mm_D1.6mm_P5.08mm_Horizontal | FIT | VERIFY_OR_SOURCE | CUTOFF_MARGIN_REVIEW S2 | 1 % tolerance. Sets the opto emitter load: the ON endpoint must reach 4.5 V, which draws 95.7 uA, and the OFF endpoint must stay below 0.3 V, which allows only 6.32 uA of injected leakage into this node [D-THT-15: through-hole DIN0204, owner choice; 0.25 W metal film, 1 %.]
R15 | RRC | 220k | Device:R |  | Resistor_THT:R_Axial_DIN0204_L3.6mm_D1.6mm_P5.08mm_Horizontal | FIT | VERIFY_OR_SOURCE | CUTOFF_MARGIN_REVIEW S2 | 1 % tolerance; charge leg of the qualification filter [D-THT-15: through-hole DIN0204, owner choice; 0.25 W metal film, 1 %.]
C3 | CQUAL | 1uF | Device:C | WIMA MKS2C041001F00JSSD | Capacitor_THT:C_Rect_L7.2mm_W5.5mm_P5.00mm_FKS2_FKP2_MKS2_MKP2 | FIT | SELECTED | CUTOFF_MARGIN_REVIEW S2 | 1 uF film, 5 %, >=50 V: WIMA MKS2C041001F00JSSD, 63 V PET, 7.2 x 5 x 10 mm, 5 mm pitch (D-CQUAL-20). Film rather than ceramic because the filter endpoints depend on its actual capacitance and leakage: a Class 2 ceramic would move the qualification times with bias and temperature. An empty capacitor now means IGN OFF, which is the polarity correction CUTOFF_MARGIN_REVIEW made. Exact series and insulation resistance remain a procurement item
Q1 | QRESET | MMBT3904 | Transistor_BJT:MMBT3904 | onsemi MMBT3904LT1G | Package_TO_SOT_SMD:SOT-23 | FIT | VERIFY_STOCK | CUTOFF_MARGIN_REVIEW S2 | discharges IGN_RC toward OFF while the supervisor says BAD, so a previously charged filter cannot grant a false rearm on recovery. Worst RC fall from 5.11 V to 0.9 V is about 10.3 ms against the supervisor 120 ms minimum release delay. E/B/C = 1/2/3 [D-SMD-09: MMBT3904 SOT-23, the 2N3904 die; SOT-23 pins are 1 B, 2 E, 3 C, so the nets are remapped by role]
R16 | R_RSTB | 22k | Device:R |  | Resistor_THT:R_Axial_DIN0204_L3.6mm_D1.6mm_P5.08mm_Horizontal | FIT | VERIFY_STOCK | CUTOFF_MARGIN_REVIEW S2 | 1 %; QRESET base drive, about 0.16 mA from a 4.5 V BAD output [D-THT-15: through-hole DIN0204, owner choice; 0.25 W metal film, 1 %.]
R17 | R_RSTPD | 100k | Device:R |  | Resistor_THT:R_Axial_DIN0204_L3.6mm_D1.6mm_P5.08mm_Horizontal | FIT | VERIFY_STOCK | CUTOFF_MARGIN_REVIEW S2 | QRESET base-emitter pulldown [D-THT-15: through-hole DIN0204, owner choice; 0.25 W metal film, 1 %.]
R18 | R_RSTC | 4.7k | Device:R |  | Resistor_THT:R_Axial_DIN0204_L3.6mm_D1.6mm_P5.08mm_Horizontal | FIT | VERIFY_STOCK | CUTOFF_MARGIN_REVIEW S2 | 1 %; discharge leg. Initial collector demand about 1.1 mA [D-THT-15: through-hole DIN0204, owner choice; 0.25 W metal film, 1 %.]
Q2 | QREPORT | BSS138P | Transistor_FET:BSS138 | Nexperia BSS138P | Package_TO_SOT_SMD:SOT-23 | FIT | VERIFY_STOCK | CUTOFF_MARGIN_REVIEW S2 / REV_A_INTERFACES D1 | translates IGN_Q to the switched 3V3 domain: GP5 LOW means IGN_Q = 1. Open drain against RIGN, so there is no DC A5 path into GP5 and no 5 V pullup on any GPIO. gate 1, source 2, drain 3. The report node carries no capacitor (see D1): with the 10k pullup and about 30 pF of node capacitance the rising edge is under a microsecond, well inside the 10 ms observation budget
R19 | R_REPG | 1k | Device:R |  | Resistor_THT:R_Axial_DIN0204_L3.6mm_D1.6mm_P5.08mm_Horizontal | FIT | VERIFY_STOCK | CUTOFF_MARGIN_REVIEW S2 | QREPORT gate series resistor [D-THT-15: through-hole DIN0204, owner choice; 0.25 W metal film, 1 %.]
R20 | R_REPPD | 100k | Device:R |  | Resistor_THT:R_Axial_DIN0204_L3.6mm_D1.6mm_P5.08mm_Horizontal | FIT | VERIFY_STOCK | CUTOFF_MARGIN_REVIEW S2 | QREPORT gate pulldown; holds the report off with A5 absent [D-THT-15: through-hole DIN0204, owner choice; 0.25 W metal film, 1 %.]
R21 | RIGN | 10k | Device:R |  | Resistor_THT:R_Axial_DIN0204_L3.6mm_D1.6mm_P5.08mm_Horizontal | FIT | VERIFY_STOCK | REV_A_INTERFACES S1 / DESIGN.md S3 | GP5 report-node pull-up to SWITCHED 3V3 (D1). With A5 absent and the board on USB only, QREPORT is off and GP5 reads HIGH, which firmware must treat as ignition OFF [D-THT-15: through-hole DIN0204, owner choice; 0.25 W metal film, 1 %.]
R22 | R_AON | 820R | Device:R |  | Resistor_THT:R_Axial_DIN0204_L3.6mm_D1.6mm_P5.08mm_Horizontal | FIT | CONDITIONAL | LAYOUT_CLOSURE S3 (LRA-12R) | 1%; select a resistor rated >=0.15 W at 85 C. Worst input current 0.510 mA gives 0.4224 V drop at 828.2 ohm; P_AON >=5.5776 V at P12=6 V. Zener power bounded by Vinput squared / (4 Rmin): 0.263 W at 29.20 V. Resistor dissipation <=0.124 W in clamp model. A 0.25 W DIN0204 derates to about 0.2 W at 85 C, which meets this. [D-THT-15: through-hole DIN0204, owner choice; 0.25 W metal film, 1 %.]
D111 | DZ_AON | BZX55C22 | Device:D_Zener | Vishay BZX55C22-TAP | Diode_THT:D_DO-35_SOD27_P2.54mm_Vertical_KathodeUp | FIT | SELECTED | LAYOUT_CLOSURE S3 | BZX55C22 20.8-23.3 V at 5 mA; 55 ohm small-signal impedance. LRA-12R screen includes junction heating to 175 C: P_AON <=27.90 V. DC/pulse clamping must be measured; dynamic impedance is not a guaranteed large-signal slope. Lead temperature <=85 C required. Leakage <0.1 uA at 25 C / <2 uA at 150 C is specified at 16 V, not 18 V. Pin 1 cathode.
C4 | C_AON | 4.7uF/50V | Device:C | Murata GRM32ER71H475KA88L | Capacitor_SMD:C_1210_3225Metric_Pad1.33x2.70mm_HandSolder | FIT | CONDITIONAL | COMPONENT_MARGIN_CLOSURE S1 / BOM_DELTA.csv | A5 input capacitance; effective C must stay >=1 uF across the P_AON range. X7R 1210 50 V; DC-bias and aging data still required for procurement. With R_AON the input time constant is 3.85 ms, inside the 100 ms A5 validity budget
U4 | UA5 | TPS70950QDBVRQ1 | Custom:TPS70950-Q1_DBV | TI TPS70950QDBVRQ1 | Package_TO_SOT_SMD:SOT-23-5_HandSoldering | FIT | RETAIN_UNRESOLVED | CUTOFF_MARGIN_REVIEW S3 / COMPONENT_MARGIN_CLOSURE S2 | the always-on 5 V rail. DBV pinout IN 1, GND 2, EN 3, NC 4, OUT 5 (SLVSCE6D Table 4-1). EN is left OPEN to enable; its absolute maximum is 7 V, so it must never be tied to an unregulated rail. Blocks OUT-to-IN current when OUT exceeds IN, which is why this part and not the TPS7A16. Unresolved: ground current is specified as 2.7 uA maximum at zero load and 10 uA at 100 uA load / 30 V, with nothing in between, and load regulation starts at 100 uA - the parked operating point is below both. No permanent preload may be added to buy a specification
U5 | USUP | TPS3839K50DBZR | Power_Supervisor:TPS3839DBZ | TI TPS3839K50DBZR | Package_TO_SOT_SMD:SOT-23 | FIT | SELECTED | CUTOFF_MARGIN_REVIEW S2 | A5 supervisor. Active-low RESET on pin 2 is PGOOD here: HIGH means the rail is good. Falling threshold 4.271-4.446 V, release 120-350 ms after a valid rail, 44 mV hysteresis. PUSH-PULL output, so it drives the new ISO permission gate directly: VOH is at least VDD-0.4 V at 2 mA against the 50 uA that gate divider draws. Falling propagation delay is 20 us typical with no maximum, so an arbitrarily fast collapse is not covered by a worst-case bound. Specified only to +85 C, which is exactly the hot screening point
C5 | C_A5A | 4.7uF/50V | Device:C | Murata GRM32ER71H475KA88L | Capacitor_SMD:C_1210_3225Metric_Pad1.33x2.70mm_HandSolder | FIT | CONDITIONAL | COMPONENT_MARGIN_CLOSURE S1 / BOM_DELTA.csv | A5 output capacitance, two in parallel: 9.4 uF nominal, effective sum must stay >=2.2 uF at 5.11 V, inside the regulator 2-47 uF window. Parallel parts do not average worst-case tolerance
C6 | C_A5B | 4.7uF/50V | Device:C | Murata GRM32ER71H475KA88L | Capacitor_SMD:C_1210_3225Metric_Pad1.33x2.70mm_HandSolder | FIT | CONDITIONAL | COMPONENT_MARGIN_CLOSURE S1 / BOM_DELTA.csv | A5 output capacitance, two in parallel: 9.4 uF nominal, effective sum must stay >=2.2 uF at 5.11 V, inside the regulator 2-47 uF window. Parallel parts do not average worst-case tolerance
C7 | C_USUP | 100nF | Device:C |  | Capacitor_SMD:C_0805_2012Metric_Pad1.18x1.45mm_HandSolder | FIT | VERIFY_OR_SOURCE | CUTOFF_MARGIN_REVIEW S2 | supervisor local bypass, across its own supply [D-SMD-09: 0805 X7R, rated voltage not below the disc it replaces]
R23 | R_ISO | 270R | Device:R |  | Resistor_THT:R_Axial_DIN0204_L3.6mm_D1.6mm_P5.08mm_Horizontal | FIT | SELECTED | LAYOUT_CLOSURE S4 | 1 %. Sized so the WORST-CASE LED current is still at or above the 10 mA the 4.0 ms turn-on maximum is specified at: B5 -5 % with V_F 1.85 V and both switch channels gives 10.19 mA, nominal 12.41 mA, B5 +5 % with V_F 1.25 V gives 14.66 mA, inside the 7-30 mA recommended window. The 330 ohm of the original return put the low corner at 8.64 mA, below the specified point, which would have left turn-on unspecified. Dissipation 58 mW [D-THT-15: through-hole DIN0204, owner choice; 0.25 W metal film, 1 %.]
Q3 | QISO_PG | BSS138P | Transistor_FET:BSS138 | Nexperia BSS138P | Package_TO_SOT_SMD:SOT-23 | FIT | SELECTED | LAYOUT_CLOSURE S4; LAYOUT_READINESS_2026-10-29 | hardware permission in series with the GPIO enable. Gated from A5-domain PGOOD, so supervisor BAD opens the B2 branch with no software step. This is the part the manager required: BAD does NOT necessarily remove B5, because the original design gates only QH and QI can hold power with ignition present, so the LED rail alone cannot carry the fail-open requirement
Q4 | QISO_EN | BSS138P | Transistor_FET:BSS138 | Nexperia BSS138P | Package_TO_SOT_SMD:SOT-23 | FIT | SELECTED | LAYOUT_CLOSURE S4 | firmware enable, gated from GP7. Source to PGND so its gate reference is fixed. Both channels must be on for LED current to flow; either one off leaves the relay open
R24 | R_ISOEN | 1k | Device:R |  | Resistor_THT:R_Axial_DIN0204_L3.6mm_D1.6mm_P5.08mm_Horizontal | FIT | VERIFY_STOCK | LAYOUT_CLOSURE S4 | GP7 gate series resistor [D-THT-15: through-hole DIN0204, owner choice; 0.25 W metal film, 1 %.]
R25 | R_ISOEN_PD | 100k | Device:R |  | Resistor_THT:R_Axial_DIN0204_L3.6mm_D1.6mm_P5.08mm_Horizontal | FIT | VERIFY_STOCK | LAYOUT_CLOSURE S4 | gate pulldown. This is the startup and reset default: GP7 floats out of reset, so the relay is open before firmware runs, and it stays open with the Pico unpowered while B5 is present [D-THT-15: through-hole DIN0204, owner choice; 0.25 W metal film, 1 %.]
R26 | R_ISOPG | 1k | Device:R |  | Resistor_THT:R_Axial_DIN0204_L3.6mm_D1.6mm_P5.08mm_Horizontal | FIT | VERIFY_STOCK | LAYOUT_CLOSURE S4 | PGOOD gate series resistor [D-THT-15: through-hole DIN0204, owner choice; 0.25 W metal film, 1 %.]
R27 | R_ISOPG_PD | 100k | Device:R |  | Resistor_THT:R_Axial_DIN0204_L3.6mm_D1.6mm_P5.08mm_Horizontal | FIT | VERIFY_STOCK | LAYOUT_CLOSURE S4 | gate pulldown; holds the permission gate off with A5 absent [D-THT-15: through-hole DIN0204, owner choice; 0.25 W metal film, 1 %.]
R28 | RPD | 47k | Device:R |  | Resistor_THT:R_Axial_DIN0204_L3.6mm_D1.6mm_P5.08mm_Horizontal | FIT | VERIFY_STOCK | REV_A_INTERFACES D2 / DESIGN.md S3 | external GP6 pulldown; holds the driver off before output enable [D-THT-15: through-hole DIN0204, owner choice; 0.25 W metal film, 1 %.]
JP1 | JH | HOLD link | Jumper:Jumper_2_Open |  | Connector_PinHeader_2.54mm:PinHeader_1x02_P2.54mm_Vertical | FIT | VERIFY_OR_SOURCE | DESIGN.md S3 / REV_A_INTERFACES S5.3 | MAINTENANCE link, not a test provision: open it for USB work so a USB-driven HOLD cannot keep the battery circuit on. Opening it does not inhibit QI and does not change the QMON sense, which taps HOLD_RAW ahead of this link. Distinct from the two 0 R period-select links R_EXPP and R_EXPT, which choose the cutoff period: three different provisions, three different parts
R29 | RH | 1k | Device:R |  | Resistor_THT:R_Axial_DIN0204_L3.6mm_D1.6mm_P5.08mm_Horizontal | FIT | VERIFY_STOCK | DESIGN.md S3 | HOLD base drive [D-THT-15: through-hole DIN0204, owner choice; 0.25 W metal film, 1 %.]
J5 | J5 | SD breakout 6-way | Connector_Generic:Conn_01x06 |  | Connector_PinHeader_2.54mm:PinHeader_1x06_P2.54mm_Vertical | FIT | VERIFY_OR_SOURCE | AS_BUILT S2 row 9 / S3.5 | fitted SPI0 breakout module on switched 3V3, 12 MHz; the card must be removable without removing the board (S5.2)
C8 | C_SD | 47uF/16V | Device:C_Polarized |  | Capacitor_THT:CP_Radial_D6.3mm_P2.50mm | FIT | SELECTED | REV_A_INTERFACES D6 / LAYOUT_CLOSURE S6 | D6 bulk at the SD supply, confirmed absent 2026-10-29. D6 gave a 10-100 uF range; 47 uF is selected from the duty it has to do - a 200 mA write spike for 1 ms inside a 100 mV droop needs 2 uF, so 47 uF is an order of margin without an oversized can. Specification for an interchangeable part: 47 uF +/-20 %, >=16 V, ESR <=0.5 ohm at 100 kHz, 6.3 x 11 mm maximum, 105 C. POLARITY: pin 1 is the + terminal and goes to the switched 3V3 rail
J3 | J3 | Spare GP11-13 / switched power | Connector_Generic:Conn_02x03_Odd_Even |  | Connector_PinHeader_2.54mm:PinHeader_2x03_P2.54mm_Vertical | FIT | SELECTED | D-RS485-05 / communications/REV_A_PROVISION.md / D-HDR-16 | 2x03: B5 / PGND / GP13 / P3V3_SW / GP12 / GP11 (GP11 and GP12 moved here from TP24/TP25). UART1 and DE//RE go only to onboard MAX3485. No external powered logic or supply may backfeed this header.
R30 | R_DE | 10k | Device:R |  | Resistor_THT:R_Axial_DIN0207_L6.3mm_D2.5mm_P5.08mm_Vertical | FIT | VERIFY_STOCK | communications/REV_A_PROVISION.md | DE//RE default-listen pulldown, following keyless practice, so the line is defined while the GPIO still floats at boot. A pulldown and not a pullup, so nothing feeds an off GPIO
J4 | J4 | Reset RUN-GND | Connector_Generic:Conn_01x02 |  | Connector_PinHeader_2.54mm:PinHeader_1x02_P2.54mm_Vertical | FIT | SELECTED | REV_A_INTERFACES S5.1 / LAYOUT_CLOSURE S6 | resolves capture question Q5. J4 is now only the RUN-to-GND reset pair, shorted with a link for a reset without cutting power, following the keyless J7 pattern. The service UART that S5.1 also wanted here is dropped: GP0/GP1 must stay free, firmware already builds with pico_enable_stdio_usb so the USB CDC console is the service path, and a UART header would be another externally powered pullup aimed at an off GPIO. A header with NC pins was the contradiction; this has none
D112 | DREV | SB360-E3/54 | Device:D_Schottky | Vishay SB360-E3/54 | Diode_THT:D_DO-201AD_P5.08mm_Vertical_AnodeUp | FIT | MISSING_OR_VERIFY_SPARE | DESIGN.md S3 | input reverse-blocking diode. It is what makes P12 nonnegative at the A5 regulator, which that regulator requires, and it keeps the unidirectional entry clamp out of forward conduction on a reverse connection. No part borrowed from the live keyless board
D113 | TVS | 1.5KE20A-E3/54 | Diode:1.5KExxA | Vishay 1.5KE20A-E3/54 | Diode_THT:D_DO-201AD_P5.08mm_Vertical_KathodeUp | FIT | SELECTED | LAYOUT_CLOSURE S3; COMPONENT_MARGIN_CLOSURE S5 | entry clamp, X7 resolved. REPLACES the inherited 1.5KE30A, and that is a deliberate deviation from the in-service keyless part: the 41.4 V clamp exceeds the 40 V limits of QI/QH VCEO, the LM2678 operating ceiling and the selected QP VDS - and keyless has neither those drivers nor a 30 V always-on LDO. 17.1 V standoff, 19.0-21.0 V VBR at 1 mA, 27.7 V clamp at 54.2 A for 10/1000 us, 1.0 uA maximum leakage at standoff, 0.090 %/K VBR coefficient: the 85 C clamp is 29.19 V, which leaves 10.8 V to the 40 V parts but is above the 28 V protected-rail target, which is why the A5 input has its own second stage. ANY sustained P12 above 17.1 V is excluded, including alternator/regulator overcharge and 24 V jump start. POLARITY is now visible in the drawing, unlike Device:D_TVS which LRA-06 had to use: Diode:1.5KExxA is the unidirectional family and draws a cathode bar, with pin 1 the banded cathode to P12 and pin 2 the anode to PGND - asserted by pin number in check_capture.py, because the pins are still named A1/A2 and ERC cannot check a cathode bar. DESIGN.md S3 records this part being fitted backwards once already (R06-REV-4)
C9 | C0 | 100nF/100V | Device:C |  | Capacitor_SMD:C_0805_2012Metric_Pad1.18x1.45mm_HandSolder | FIT | VERIFY_OR_SOURCE | DESIGN.md S3 | always-on input ceramic [D-SMD-09: 0805 X7R, rated voltage not below the disc it replaces]
R31 | RGS | 10k | Device:R |  | Resistor_THT:R_Axial_DIN0204_L3.6mm_D1.6mm_P5.08mm_Horizontal | FIT | VERIFY_STOCK | DESIGN.md S3 / MAX_ON_CUTOFF HOLD-path section | gate-source pullup, keeps QP off at rest. CHANGED from 100k to 10k by the MAX_ON HOLD-path revision: with 10k the 0.2 V off-gate limit allows 19.80 uA of total sink leakage rather than 2 uA, which is what makes the added series switch tolerable. Maximum dissipation at 16 V is 25.9 mW [D-THT-13: through-hole DIN0204, owner choice.]
D114 | DZ | BZX55C10 | Device:D_Zener | Vishay BZX55C10-TAP | Diode_THT:D_DO-35_SOD27_P2.54mm_Vertical_KathodeUp | FIT | PAIRED_SELECTED | COMPONENT_MARGIN_CLOSURE S2 / BOM_DELTA.csv | gate-source clamp, lowered from 12 V as the paired half of the QP change: the selected QP has an ASYMMETRIC absolute gate rating of +5/-16 V, not +/-16 V. 9.4-10.6 V at 5 mA keeps the gate inside the -14 to +1 V acceptance band at every P12 in the envelope. Do not populate the new QP with the old 12 V clamp or the old 18 V magnitude criterion. Low-current and hot clamp voltage remain unproved: at 12 V the clamp current is only about 1 mA, below the 5 mA test point. Polarity: pin 1 is the cathode, on P12
R32 | RG | 1k | Device:R |  | Resistor_THT:R_Axial_DIN0414_L11.9mm_D4.5mm_P5.08mm_Vertical | FIT | VERIFY_STOCK | DESIGN.md S3 | gate sink resistor, 0.5 W position: a clamp short leaves at most 16*16/990 = 0.259 W here
Q5 | QP | IPD50P04P4L-11 | Transistor_FET:Q_PMOS_GDS | Infineon IPD50P04P4L11ATMA2 | Package_TO_SOT_SMD:TO-252-3_TabPin2 | FIT | PAIRED_SELECTED | COMPONENT_MARGIN_CLOSURE S2 / BOM_DELTA.csv | the switch retained by LRA-12R alongside the lower clamp. Its drain current has a HOT maximum, 70 uA at 125 C (at VDS = -32 V, so conservative against the 12-16 V actually applied), where the IRF4905 screen is 250 uA at 150 C and cannot fit the 200 uA parked allocation. A 60 V SQD50P06 alternative has a 50 uA hot maximum; it is not populated. This selected QP requires a clamp below 40 V. RDS(on) <=17.2 mohm at -4.5 V/25 C. PG-TO252-3 DPAK: gate 1, drain 2 and tab, source 3 - the tab is drain, so the pad carries battery-side switched voltage and is a layout thermal and clearance item. Body diode is drain-to-source: it blocks P12 to VIN_SW when off but does not block reverse energy
R33 | RI | 2.2k | Device:R |  | Resistor_THT:R_Axial_DIN0204_L3.6mm_D1.6mm_P5.08mm_Horizontal | FIT | VERIFY_STOCK | DESIGN.md S3 | QI base drive. At 17.1 V sustained the dissipation is 0.112 W, inside a 0.25 W part; the 0.318 W that would have forced a 0.5 W position came from the superseded 28 V protected-rail number [D-THT-13: through-hole DIN0204, owner choice. Rated >= 0.25 W (0.4 W preferred): 0.11 W at 17.1 V sustained.]
R34 | RBI | 100k | Device:R |  | Resistor_THT:R_Axial_DIN0204_L3.6mm_D1.6mm_P5.08mm_Horizontal | FIT | VERIFY_STOCK | DESIGN.md S3 | QI base-emitter pulldown [D-THT-13: through-hole DIN0204, owner choice.]
Q6 | QI | 2N3904 | Transistor_BJT:2N3904 | onsemi 2N3904 | Package_TO_SOT_THT:TO-92_Inline | FIT | VERIFY_STOCK | DESIGN.md S3 | direct ignition start path, independent of the qualification delay and of firmware. Its 40 V VCEO now has 10.8 V of margin to the 29.19 V hot entry clamp, which is why LRA-12 does not replace it: the lower clamp resolves the stated incompatibility instead. Off leakage under the 100k base pulldown is still unspecified hot. E/B/C = 1/2/3 [D-THT-13: through-hole 2N3904 from the owner's stock (TO-92 pins 1 E, 2 B, 3 C). A 2N2222A (40 V) may substitute; a plain 2N2222 (30 V) or S9013 (25 V) may not: the hot entry clamp reaches 29.2 V]
R35 | RBH | 100k | Device:R |  | Resistor_THT:R_Axial_DIN0204_L3.6mm_D1.6mm_P5.08mm_Horizontal | FIT | VERIFY_STOCK | DESIGN.md S3 | QH base-emitter pulldown; stays fitted when JH is open [D-THT-13: through-hole DIN0204, owner choice.]
Q7 | QH | 2N3904 | Transistor_BJT:2N3904 | onsemi 2N3904 | Package_TO_SOT_THT:TO-92_Inline | FIT | VERIFY_STOCK | DESIGN.md S3 / D2 / MAX_ON_CUTOFF HOLD-path section | firmware HOLD path. Its COLLECTOR NO LONGER GOES DIRECTLY TO SINK: QS now sits between them, which is where the independent cutoff interrupts the HOLD path (capture question Q6, closed). The emitter stays grounded; interrupting the emitter instead would couple fault voltage into the HOLD interface [D-THT-13: through-hole 2N3904 from the owner's stock (TO-92 pins 1 E, 2 B, 3 C). A 2N2222A (40 V) may substitute; a plain 2N2222 (30 V) or S9013 (25 V) may not: the hot entry clamp reaches 29.2 V]
C10 | CIN | 100uF/50V | Device:C_Polarized | Panasonic EEUFR1H101 | Capacitor_THT:CP_Radial_D8.0mm_P3.50mm | FIT | CONDITIONAL | COMPONENT_MARGIN_CLOSURE S1 / BOM_DELTA.csv | switched-input bulk, exact part now selected: 100 uF +/-20 % 50 V, 8 x 11.5 mm radial on 3.5 mm pitch, 0.870 A RMS at 100 kHz/105 C, impedance <=0.061 ohm at 100 kHz/20 C. Temperature impedance and inrush remain qualification gates. POLARITY: pin 1 is + and goes to VIN_SW
C11 | CIB | 100nF/100V | Device:C |  | Capacitor_SMD:C_0805_2012Metric_Pad1.18x1.45mm_HandSolder | FIT | VERIFY_OR_SOURCE | DESIGN.md S3 | local switched-input bypass; keep the loop short [D-SMD-09: 0805 X7R, rated voltage not below the disc it replaces]
R36 | RBIN | 10k | Device:R |  | Resistor_THT:R_Axial_DIN0204_L3.6mm_D1.6mm_P5.08mm_Horizontal | FIT | VERIFY_STOCK | DESIGN.md S3 | switched-input bleeder [D-THT-13: through-hole DIN0204, owner choice.]
U6 | UREG | LM2678T-5.0 | Custom:LM2678T-5.0 | TI LM2678T-5.0/NOPB | Package_TO_SOT_THT:TO-220-7_P2.54x3.7mm_StaggerOdd_Lead3.8mm_Vertical | FIT | MISSING_OR_VERIFY_SPARE | DESIGN.md S3 / D-POWER-03 | symbol copied from keyless/hardware/Custom.kicad_sym. The same regulator, in the same role, runs in service on the keyless board in this car on a permanent 12 V feed, through cranking. Pin 7 ON/OFF left open and pin 5 NC unconnected, as DESIGN.md S3 specifies. Do not remove the installed keyless regulator
C12 | CBOOST | 10nF/50V | Device:C |  | Capacitor_SMD:C_0805_2012Metric_Pad1.18x1.45mm_HandSolder | FIT | VERIFY_OR_SOURCE | DESIGN.md S3 | between SW and BOOST; keep short [D-SMD-09: 0805 X7R, rated voltage not below the disc it replaces]
D115 | DCATCH | SB360-E3/54 | Device:D_Schottky | Vishay SB360-E3/54 | Diode_THT:D_DO-201AD_P5.08mm_Vertical_AnodeUp | FIT | MISSING_OR_VERIFY_SPARE | DESIGN.md S3 | catch diode; a tight local loop with CIN is a layout requirement
L1 | L1 | 22uH | Device:L | Bourns RLB0912-220KL | Inductor_THT:L_Radial_D8.7mm_P5.00mm_Fastron_07HCP | FIT | MISSING | DESIGN.md S3 / D-POWER-03 consequence 4 | normal-load margin only: the LM2678 fault current limit exceeds its 2.5 A saturation rating. Keyless runs a physically larger 2 A 22 uH part in the same role, which is the comparison to make before accepting this one for the vehicle
R37 | RB5 | 1k | Device:R |  | Resistor_THT:R_Axial_DIN0204_L3.6mm_D1.6mm_P5.08mm_Horizontal | FIT | VERIFY_STOCK | DESIGN.md S3 | B5 bleeder; supports the B07 decay measurement [D-THT-13: through-hole DIN0204, owner choice.]
C13 | COB | 100nF/50V | Device:C |  | Capacitor_SMD:C_0805_2012Metric_Pad1.18x1.45mm_HandSolder | FIT | VERIFY_OR_SOURCE | DESIGN.md S3 | B5 local bypass [D-SMD-09: 0805 X7R, rated voltage not below the disc it replaces]
C14 | COUT | 1000uF/16V | Device:C_Polarized | Panasonic EEUFR1C102 | Capacitor_THT:CP_Radial_D10.0mm_P5.00mm | FIT | CONDITIONAL | COMPONENT_MARGIN_CLOSURE S1 / BOM_DELTA.csv | buck output bulk, exact part now selected, replacing the unspecified 820 uF: 1000 uF +/-20 % 16 V, 10 x 16 mm radial on 5 mm pitch, 1.790 A RMS at 100 kHz/105 C, impedance <=0.028 ohm at 100 kHz/20 C. Two gates travel with it: LM2678 loop stability is not established by a ripple rating, and the larger stored charge pushes the bleeder-only decay screen to about 5.39 s against the 5 s criterion, so the assembled decay must be measured rather than inherited. POLARITY: pin 1 is + and goes to B5
D116 | DOR | 1N4004-E3/54 | Diode:1N4004 | Vishay 1N4004-E3/54 | Diode_THT:D_DO-41_SOD81_P5.08mm_Vertical_KathodeUp | FIT | MISSING | REV_A_INTERFACES D13 | D13 replaces the power BOM 1N5819 with the 1N4004 candidate for its specified reverse-current maxima, 5 uA at 25 C and 50 uA at 125 C; B5 anode to VSYS cathode. Blocks USB back into B5 apart from leakage. Do not use this slow rectifier as the buck catch diode
R38 | RCLK | 1k | Device:R |  | Resistor_THT:R_Axial_DIN0204_L3.6mm_D1.6mm_P5.08mm_Horizontal | FIT | VERIFY_STOCK | CUTOFF_MARGIN_REVIEW S1 | 1 %. With CCLK this is the oscillator supply filter. The oscillator specifies a 0.5 V/ms maximum supply slew; for a 5.11 V step and minimum RC the contribution is 0.235 V/ms, and a 100 uA VCLK load allowance adds 0.0046 V/ms on falling ramps and at most 0.101 V of static drop [D-THT-15: through-hole DIN0204, owner choice; 0.25 W metal film, 1 %.]
C15 | CCLK | 33uF/16V | Device:C_Polarized | KYOCERA AVX TAP336K016SCS | Capacitor_THT:CP_Radial_Tantal_D6.0mm_P2.50mm | FIT | CONDITIONAL | COMPONENT_MARGIN_CLOSURE S1 / BOM_DELTA.csv / D-CCLK-18 | oscillator rail reservoir. 33 uF +/-10 % 16 V solid tantalum, resin-dipped radial, case F (6.0 mm dia, 10.0 mm tall, 2.5 mm pitch), DCL 4.2 uA max at 25 C; replaces the KEMET T491D336K016AT D case (D-CCLK-18). Hot leakage and temperature checked against the TAP/TEP technical guide (typical curves; COMPONENT_MARGIN_CLOSURE), selected against an effective 22-60 uF requirement; the supporting engineering stack is 24.057-43.923 uF and combined-stress bounds are still required. POLARITY: pin 1 is the + terminal and goes to VCLK - a reversed tantalum fails short, and this one sits on the always-on rail
C16 | C_CLK | 10nF | Device:C |  | Capacitor_SMD:C_0805_2012Metric_Pad1.18x1.45mm_HandSolder | FIT | VERIFY_OR_SOURCE | CUTOFF_MARGIN_REVIEW S1 | local oscillator bypass [D-SMD-09: 0805 X7R, rated voltage not below the disc it replaces]
U7 | UXO | OV-7604-C7-32.768KHZ-20PPM-TA-QC | Custom:OV-7604-C7 | Micro Crystal OV-7604-C7-32.768KHZ-20PPM-TA-QC | accord-logger:Oscillator_SMD_MicroCrystal_OV-7604-C7_SON-4_3.2x1.5mm | FIT | SELECTED | CUTOFF_MARGIN_REVIEW S1 | the independent timebase. Integrated crystal and oscillator, so XTAL, RF, RS, CX1 and CX2 of the earlier bare-crystal candidate are gone. +/-20 ppm initial, TA = -40 to +85 C, 0.3/0.5 uA at 3.0 V with CLKOE low, 0.5 s maximum startup at the datasheet default conditions. The +/-220 ppm first-year envelope used for the cutoff arithmetic is assembled from 20 ppm initial, 188.65 ppm of -0.035 ppm/K^2 curvature at -40 C against a 30 C turnover, 3.75 ppm of voltage coefficient and 3 ppm aging: an engineering envelope, not a combined manufacturer guarantee. Keep total XO_OUT load at or below 10 pF. Note the ordering code: QC is commercial grade - AEC-Q200 is available as QA and is a procurement decision, not a redesign
U8 | UOE | 74AHC1G17GV | 74xGxx:74LVC1G17 | Nexperia 74AHC1G17GV | Package_TO_SOT_SMD:SOT-353_SC-70-5_Handsoldering | FIT | CONDITIONAL | COMPONENT_MARGIN_CLOSURE S2 / BOM_DELTA.csv | translates ARM to the filtered oscillator rail without injecting A5 into the enable pin. The installed 74xGxx:74LVC1G17 symbol is used because the selected 74AHC1G17GV has the identical SOT-353 mapping (NC 1, A 2, GND 3, Y 4, VCC 5) and function; the Value and MPN fields carry the part actually selected. Schmitt input, 0-5.5 V overvoltage-tolerant including VCC = 0, 1 uA / 10 uA unloaded ICC at 25/85 C. Two conditions travel with it: the minimum operating rail is 2.0 V, not 1.65 V, so startup while VCLK crosses 2 V must be checked, and its largest tabulated positive threshold is 3.85 V at 5.5 V, so loaded ARM must reach 4.0 V. Do not substitute a conventional CMOS gate with input-to-VCC clamps
C17 | C_OE | 100nF | Device:C |  | Capacitor_SMD:C_0805_2012Metric_Pad1.18x1.45mm_HandSolder | FIT | VERIFY_OR_SOURCE | CUTOFF_MARGIN_REVIEW S1 | UOE bypass, across its own VCLK supply [D-SMD-09: 0805 X7R, rated voltage not below the disc it replaces]
U9 | UGCLK | SN74LVC1G97DBVR | 74xGxx:74LVC1G97 | TI SN74LVC1G97DBVR | Package_TO_SOT_SMD:SOT-23-6_Handsoldering | FIT | RETAIN | CUTOFF_MARGIN_REVIEW S1 / COMPONENT_MARGIN_CLOSURE S2 | configurable gate wired as an AND, so disarmed means CLK32 = 0 and the counter chain stops rather than running on after shutdown. IN1 (1) to ground, IN0 (3) from the oscillator, IN2 (6) from ARM, Y (4) to the counter. Retained over a 74AHC1G08, which would save room current but removes the Schmitt input tolerance that lets this gate accept XO_OUT while A5 is collapsing and XO_OUT is temporarily higher than its own rail. Its output shares A5 with the counters
C18 | C_GCLK | 100nF | Device:C |  | Capacitor_SMD:C_0805_2012Metric_Pad1.18x1.45mm_HandSolder | FIT | VERIFY_OR_SOURCE | CUTOFF_MARGIN_REVIEW S1 | UGCLK bypass [D-SMD-09: 0805 X7R, rated voltage not below the disc it replaces]
U10 | UCLK | CD74HC4060M96 | Custom:CD74HC4060 | TI CD74HC4060M96 | Package_SO:SOIC-16_3.9x9.9mm_P1.27mm | FIT | SELECTED | MAX_ON_CUTOFF table | first divider. Driven from the external clock on pin 11 with the internal oscillator pins 9 and 10 left open. Q14 gives 2 falling edges per second from 32768 Hz. MR on pin 12 is active high and comes from COUNT1_RESET, so the chain is stopped - not cleared - when disarmed. Retained as HC rather than HEF: the HEF parts specify 20/150 uA against HC 8/80 uA and would worsen the parked screen [D-SMD-09: SOIC, same TI die and datasheet as the DIP, same pinout]
U11 | UCOUNT | CD74HC4020M96 | Custom:CD74HC4020 | TI CD74HC4020M96 | Package_SO:SOIC-16_3.9x9.9mm_P1.27mm | FIT | SELECTED | MAX_ON_CUTOFF table | second divider. Q13 on pin 2 first rises on edge 4096, which at 2 edges per second is the nominal 2048 s production deadline; Q8 on pin 13 gives 64 s for the accelerated test. It is reset by BASE_RESET, which is BAD OR IGN_Q - deliberately NOT by NARM, because that would erase EXPIRED the moment it disarmed the latch [D-SMD-09: SOIC, same TI die and datasheet as the DIP, same pinout]
U12 | ULATCH | CD4011BM96 | Custom:CD4011B | TI CD4011BM96 | Package_SO:SOIC-14_3.9x8.7mm_P1.27mm | FIT | SELECTED | MAX_ON_CUTOFF table / CUTOFF_MARGIN_REVIEW S2 | reset-dominant ARM/NARM latch on gates A and B, and the QUAL_N inverter that produces IGN_Q on gate C. Gate D is unused, so its inputs 12 and 13 are tied to ground rather than left floating - an unused CMOS input at an intermediate level draws current and can oscillate. Pin 11 is its unused output [D-SMD-09: SOIC, same TI die and datasheet as the DIP, same pinout]
U13 | UOR | CD4071BM96 | Custom:CD4071B | TI CD4071BM96 | Package_SO:SOIC-14_3.9x8.7mm_P1.27mm | FIT | SELECTED | MAX_ON_CUTOFF table | the reset tree: BASE_RESET = BAD OR IGN_Q, COUNT1_RESET = BASE_RESET OR NARM, FAULT_RESET = BAD OR EXPIRED, ARM_RESET = FAULT_RESET OR HOLD_N. All four gates are used [D-SMD-09: SOIC, same TI die and datasheet as the DIP, same pinout]
U14 | USCH | CD4093BM96 | Custom:CD4093B | TI CD4093BM96 | Package_SO:SOIC-14_3.9x8.7mm_P1.27mm | FIT | SELECTED | MAX_ON_CUTOFF table / CUTOFF_MARGIN_REVIEW S2 | Schmitt NANDs. Gate A qualifies the ignition RC filter against single-input thresholds VP 2.2-3.6 V and VN 0.9-2.8 V at a 5 V rail, which with the filter gives roughly 104-376 ms ON and 119-590 ms OFF qualification from SETTLED endpoints - not a bound across the whole A5 range, because that datasheet does not tabulate every intermediate supply. Gate B inverts the supervisor to BAD. Gates C and D form RESET_N and SET_N. All four gates used [D-SMD-09: SOIC, same TI die and datasheet as the DIP, same pinout]
C19 | C_UCLK | 100nF | Device:C |  | Capacitor_SMD:C_0805_2012Metric_Pad1.18x1.45mm_HandSolder | FIT | VERIFY_OR_SOURCE | MAX_ON_CUTOFF table | local bypass, one per package, directly across its own supply pins - a layout requirement as much as a BOM line [D-SMD-09: 0805 X7R, rated voltage not below the disc it replaces]
C20 | C_UCOUNT | 100nF | Device:C |  | Capacitor_SMD:C_0805_2012Metric_Pad1.18x1.45mm_HandSolder | FIT | VERIFY_OR_SOURCE | MAX_ON_CUTOFF table | local bypass, one per package, directly across its own supply pins - a layout requirement as much as a BOM line [D-SMD-09: 0805 X7R, rated voltage not below the disc it replaces]
C21 | C_ULATCH | 100nF | Device:C |  | Capacitor_SMD:C_0805_2012Metric_Pad1.18x1.45mm_HandSolder | FIT | VERIFY_OR_SOURCE | MAX_ON_CUTOFF table | local bypass, one per package, directly across its own supply pins - a layout requirement as much as a BOM line [D-SMD-09: 0805 X7R, rated voltage not below the disc it replaces]
C22 | C_UOR | 100nF | Device:C |  | Capacitor_SMD:C_0805_2012Metric_Pad1.18x1.45mm_HandSolder | FIT | VERIFY_OR_SOURCE | MAX_ON_CUTOFF table | local bypass, one per package, directly across its own supply pins - a layout requirement as much as a BOM line [D-SMD-09: 0805 X7R, rated voltage not below the disc it replaces]
C23 | C_USCH | 100nF | Device:C |  | Capacitor_SMD:C_0805_2012Metric_Pad1.18x1.45mm_HandSolder | FIT | VERIFY_OR_SOURCE | MAX_ON_CUTOFF table | local bypass, one per package, directly across its own supply pins - a layout requirement as much as a BOM line [D-SMD-09: 0805 X7R, rated voltage not below the disc it replaces]
R39 | R_EXPP | 0R | Device:R |  | Resistor_SMD:R_0805_2012Metric_Pad1.20x1.40mm_HandSolder | FIT | SELECTED | LAYOUT_CLOSURE S5 | PRODUCTION cutoff period selector, fitted: takes EXPIRED from Q13, the nominal 2048 s terminal count. FIT EXACTLY ONE of R_EXPP and R_EXPT - they are two counter outputs and must never be shorted together. A link option rather than a jumper header so the production state cannot be changed by something falling off [D-SMD-17: 0805 surface mount, owner choice.]
R40 | R_EXPT | 0R | Device:R |  | Resistor_SMD:R_0805_2012Metric_Pad1.20x1.40mm_HandSolder | DNP | DNP | LAYOUT_CLOSURE S5 | ACCELERATED TEST cutoff selector, DO NOT POPULATE in production: takes EXPIRED from Q8 instead, giving 128/2 = 64 s so a full cutoff sequence can be exercised on the bench without a 34 minute wait. Clearly distinguished from the production selection, as the packet requires, and from JH, which is the maintenance HOLD link. An accelerated run does not substitute for one full-duration test [D-SMD-17: 0805 surface mount, owner choice.]
R41 | R_EXP | 100k | Device:R |  | Resistor_SMD:R_0805_2012Metric_Pad1.20x1.40mm_HandSolder | FIT | SELECTED | LAYOUT_CLOSURE S5 | defines EXPIRED if neither selector link is fitted, so a CMOS input is never left floating. It costs nothing while parked: EXPIRED is LOW until the deadline, and only then does the counter output source 50 uA into it [D-SMD-17: 0805 surface mount, owner choice.]
Q8 | QS | BSS138P | Transistor_FET:BSS138 | Nexperia BSS138P | Package_TO_SOT_SMD:SOT-23 | FIT | VERIFY_STOCK | MAX_ON_CUTOFF HOLD-path permission switch | the series interruption in the HOLD path, and the answer to capture question Q6: drain to SINK, source to the QH collector, so the body diode points from the QH collector toward SINK and blocks the sink direction when off. It grants permission only - it cannot sink without QH - and QI stays wired directly to SINK, so raw ignition still overrides. 60 V VDS, 2 ohm maximum at VGS = 5 V, drain leakage 1 uA at 25 C and 10 uA at 150 C at 60 V, which is what favours it over a 2N7000 here. gate 1, source 2, drain 3. Its gate drive is reduced by the divider and by the QH collector voltage, so no RDS claim rests on exactly 5 V
R42 | R_QSG | 1k | Device:R |  | Resistor_SMD:R_0805_2012Metric_Pad1.20x1.40mm_HandSolder | FIT | VERIFY_STOCK | MAX_ON_CUTOFF HOLD-path permission switch | QS gate series resistor [D-SMD-17: 0805 surface mount, owner choice.]
R43 | R_QSPD | 100k | Device:R |  | Resistor_SMD:R_0805_2012Metric_Pad1.20x1.40mm_HandSolder | FIT | VERIFY_STOCK | MAX_ON_CUTOFF HOLD-path permission switch | QS gate pulldown; the switch is open with A5 absent, so loss of the timer supply defaults to inhibit [D-SMD-17: 0805 surface mount, owner choice.]
Q9 | QMON | MMBT3904 | Transistor_BJT:MMBT3904 | onsemi MMBT3904LT1G | Package_TO_SOT_SMD:SOT-23 | FIT | VERIFY_STOCK | MAX_ON_CUTOFF HOLD sense section | senses HOLD without putting a 5 V pullup on a GPIO. Collector is HOLD_N, so LOW means HOLD_RAW asserted. It taps HOLD_RAW BEFORE JH, so opening the maintenance link still releases QH but does not change what the monitor sees. Adds roughly 50 uA of GPIO base load while HOLD is asserted, and that is not a timer refresh path. Third 2N3904 beyond QI and QH; verify spare quantity rather than assuming two cover three. E/B/C = 1/2/3 [D-SMD-09: MMBT3904 SOT-23, the 2N3904 die; SOT-23 pins are 1 B, 2 E, 3 C, so the nets are remapped by role]
R44 | R_MONB | 47k | Device:R |  | Resistor_THT:R_Axial_DIN0204_L3.6mm_D1.6mm_P5.08mm_Horizontal | FIT | VERIFY_STOCK | MAX_ON_CUTOFF HOLD sense section | QMON base resistor from HOLD_RAW, ahead of JH [D-THT-15: through-hole DIN0204, owner choice; 0.25 W metal film, 1 %.]
R45 | R_MONPD | 100k | Device:R |  | Resistor_SMD:R_0805_2012Metric_Pad1.20x1.40mm_HandSolder | FIT | VERIFY_STOCK | MAX_ON_CUTOFF HOLD sense section | QMON base-emitter pulldown [D-SMD-17: 0805 surface mount, owner choice.]
R46 | R_MONC | 100k | Device:R |  | Resistor_SMD:R_0805_2012Metric_Pad1.20x1.40mm_HandSolder | FIT | VERIFY_STOCK | MAX_ON_CUTOFF HOLD sense section | HOLD_N collector pullup to A5. 1 uA of QMON collector leakage moves this node 0.101 V, so it is not ideal isolation and belongs in the parked accounting [D-SMD-17: 0805 surface mount, owner choice.]
TP1 | TP_P12 | TestPoint | Connector:TestPoint |  | TestPoint:TestPoint_Pad_D2.0mm | FIT | VERIFY_OR_SOURCE | REV_A_INTERFACES S5.3 | insulated test loop [D-SMD-09: 2 mm SMD probe pad; ground loops stay for clips]
TP2 | TP_GATE | TestPoint | Connector:TestPoint |  | TestPoint:TestPoint_Pad_D2.0mm | FIT | VERIFY_OR_SOURCE | REV_A_INTERFACES S5.3 | QP gate: the -14 to +1 V acceptance band is measured here against TP_P12 [D-SMD-09: 2 mm SMD probe pad; ground loops stay for clips]
TP3 | TP_VINSW | TestPoint | Connector:TestPoint |  | TestPoint:TestPoint_Pad_D2.0mm | FIT | VERIFY_OR_SOURCE | REV_A_INTERFACES S5.3 | insulated test loop [D-SMD-09: 2 mm SMD probe pad; ground loops stay for clips]
TP4 | TP_SW | TestPoint | Connector:TestPoint |  | TestPoint:TestPoint_Pad_D2.0mm | FIT | VERIFY_OR_SOURCE | REV_A_INTERFACES S5.3 | from the power BOM TP row, additional to S5.3 [D-SMD-09: 2 mm SMD probe pad; ground loops stay for clips]
TP5 | TP_B5 | TestPoint | Connector:TestPoint |  | TestPoint:TestPoint_Pad_D2.0mm | FIT | VERIFY_OR_SOURCE | REV_A_INTERFACES S5.3 | insulated test loop [D-SMD-09: 2 mm SMD probe pad; ground loops stay for clips]
TP6 | TP_VSYS | TestPoint | Connector:TestPoint |  | TestPoint:TestPoint_Pad_D2.0mm | FIT | VERIFY_OR_SOURCE | REV_A_INTERFACES S5.3 | insulated test loop [D-SMD-09: 2 mm SMD probe pad; ground loops stay for clips]
TP7 | TP_3V3 | TestPoint | Connector:TestPoint |  | TestPoint:TestPoint_Pad_D2.0mm | FIT | VERIFY_OR_SOURCE | REV_A_INTERFACES S5.3 | insulated test loop [D-SMD-09: 2 mm SMD probe pad; ground loops stay for clips]
TP8 | TP_PAON | TestPoint | Connector:TestPoint |  | TestPoint:TestPoint_Pad_D2.0mm | FIT | VERIFY_OR_SOURCE | REV_A_INTERFACES S5.3 | A5 regulator input, after the second-stage clamp: the <=28 V protected-rail criterion is measured here, not at P12 [D-SMD-09: 2 mm SMD probe pad; ground loops stay for clips]
TP9 | TP_A5 | TestPoint | Connector:TestPoint |  | TestPoint:TestPoint_Pad_D2.0mm | FIT | VERIFY_OR_SOURCE | REV_A_INTERFACES S5.3 | insulated test loop [D-SMD-09: 2 mm SMD probe pad; ground loops stay for clips]
TP12 | TP_IGNRC | TestPoint | Connector:TestPoint |  | TestPoint:TestPoint_Pad_D2.0mm | FIT | VERIFY_OR_SOURCE | REV_A_INTERFACES S5.3 | ignition filter node; B02 asks for it scoped with partially charged starting conditions [D-SMD-09: 2 mm SMD probe pad; ground loops stay for clips]
TP17 | TP_PGOOD | TestPoint | Connector:TestPoint |  | TestPoint:TestPoint_Pad_D2.0mm | FIT | VERIFY_OR_SOURCE | REV_A_INTERFACES S5.3 | A5-domain cutoff logic; no GPIO connection. Also the source of the hardware isolation permission [D-SMD-09: 2 mm SMD probe pad; ground loops stay for clips]
TP20 | TP_ISOEN | TestPoint | Connector:TestPoint |  | TestPoint:TestPoint_Pad_D2.0mm | FIT | VERIFY_OR_SOURCE | REV_A_INTERFACES S5.3 | B2 isolation enable, for the isolate-then-release ordering [D-SMD-09: 2 mm SMD probe pad; ground loops stay for clips]
TP21 | TP_GND_BUCK | TestPoint | Connector:TestPoint |  | TestPoint:TestPoint_Loop_D2.50mm_Drill1.0mm | FIT | VERIFY_OR_SOURCE | REV_A_INTERFACES S5.3 | buck return loop
TP22 | TP_GND_PICO | TestPoint | Connector:TestPoint |  | TestPoint:TestPoint_Loop_D2.50mm_Drill1.0mm | FIT | VERIFY_OR_SOURCE | REV_A_INTERFACES S5.3 | Pico return loop
TP23 | TP_GND_HARNESS | TestPoint | Connector:TestPoint |  | TestPoint:TestPoint_Loop_D2.50mm_Drill1.0mm | FIT | VERIFY_OR_SOURCE | REV_A_INTERFACES S5.3 | harness-end loop on the bonded B16 / AGND sense node
U15 | U485 | MAX3485 | Interface_UART:MAX3485 | Analog Devices MAX3485EPA+ | Package_DIP:DIP-8_W7.62mm | FIT | SELECTED | keyless U5 / D-RS485-05 | Socketed DIP-8 footprint as keyless. Tied DE//RE: low listen, high transmit; shutdown unreachable. Switched 3V3 does not isolate energized bus pins: up to 1 mA per pin at +12 V with VCC=0.
C24 | C485 | 100nF | Device:C |  | Capacitor_SMD:C_0805_2012Metric_Pad1.18x1.45mm_HandSolder | FIT | SELECTED | keyless C13 | Place at MAX3485 pins 8/5. Same 0805 handsolder footprint as keyless.
R47 | R485_A | 390R | Device:R |  | Resistor_THT:R_Axial_DIN0207_L6.3mm_D2.5mm_P5.08mm_Vertical | FIT | SELECTED | keyless R14 / D-RS485-05 | 1%; keyless schematic 270R differs from PCB 390R. Owner direction uses 390R. Bias enabled only with both bias shunts installed.
R48 | R485_B | 390R | Device:R |  | Resistor_THT:R_Axial_DIN0207_L6.3mm_D2.5mm_P5.08mm_Vertical | FIT | SELECTED | keyless R15 / D-RS485-05 | 1%; jumper-isolated low bias leg.
R49 | R485_TERM | 120R | Device:R |  | Resistor_THT:R_Axial_DIN0207_L6.3mm_D2.5mm_P5.08mm_Vertical | FIT | SELECTED | keyless R16 | 1%; enabled only by termination shunt at a bus end.
JP2 | JP485_TERM | TERM default OPEN | Jumper:Jumper_2_Open |  | Connector_PinHeader_2.54mm:PinHeader_1x02_P2.54mm_Vertical | FIT | FIT_HEADER_NO_SHUNT | keyless JP1 | Fit header; ship WITHOUT shunt. Bias HI and LO are a pair; only link at the designated bias node. No bus TVS, as keyless.
JP3 | JP485_HI | BIAS HI default OPEN | Jumper:Jumper_2_Open |  | Connector_PinHeader_2.54mm:PinHeader_1x02_P2.54mm_Vertical | FIT | FIT_HEADER_NO_SHUNT | D-RS485-05 | Fit header; ship WITHOUT shunt. Bias HI and LO are a pair; only link at the designated bias node. No bus TVS, as keyless.
JP4 | JP485_LO | BIAS LO default OPEN | Jumper:Jumper_2_Open |  | Connector_PinHeader_2.54mm:PinHeader_1x02_P2.54mm_Vertical | FIT | FIT_HEADER_NO_SHUNT | D-RS485-05 | Fit header; ship WITHOUT shunt. Bias HI and LO are a pair; only link at the designated bias node. No bus TVS, as keyless.
U16 | URTC | DS3231SN | Timer_RTC:DS3231M | Analog Devices DS3231SN# | Package_SO:SOIC-16W_7.5x10.3mm_P1.27mm | FIT | MISSING | D-RTC-14 | I2C RTC with integrated TCXO and crystal, +/-2 ppm 0-40 C. Order the SN# (industrial, -40 to +85 C) grade, not the S# (0 to 70 C). KiCad DS3231M symbol: same SOIC-16W pinout. Pins 5-13 to PGND as the datasheet requires; 32KHZ and RST open. VCC on switched 3V3; runs from BT1 when the board is off
BT1 | BT_RTC | BR2032 | Device:Battery_Cell | Panasonic BR2032 in Keystone 3034 holder | Battery:BatteryHolder_Keystone_3034_1x20mm | FIT | MISSING | D-RTC-14 | RTC backup cell. BR (poly-carbon monofluoride) chemistry is rated to +85 C, a CR2032 typically to 60-70 C, and the board lives in a parked car. Primary cell: nothing on the board charges it. Pad 1 is the holder clip (+), pad 2 the centre pad (-). Order the holder and the cell separately
C25 | C_RTC | 100nF | Device:C |  | Capacitor_SMD:C_0805_2012Metric_Pad1.18x1.45mm_HandSolder | FIT | VERIFY_OR_SOURCE | D-RTC-14 | DS3231 VCC bypass; place at U16 pins 2 (VCC) and 13 (GND). 0805 X7R, >=16 V
R50 | R_SDA | 4.7k | Device:R |  | Resistor_SMD:R_0805_2012Metric_Pad1.20x1.40mm_HandSolder | FIT | VERIFY_STOCK | D-RTC-14 | I2C0 SDA pull-up (GP20) to SWITCHED 3V3 only, so the bus cannot back-feed the Pico when it is off. 0805, 1 % or 5 %
R51 | R_SCL | 4.7k | Device:R |  | Resistor_SMD:R_0805_2012Metric_Pad1.20x1.40mm_HandSolder | FIT | VERIFY_STOCK | D-RTC-14 | I2C0 SCL pull-up (GP21) to SWITCHED 3V3 only. 0805, 1 % or 5 %
R52 | R_RTCINT | 10k | Device:R |  | Resistor_SMD:R_0805_2012Metric_Pad1.20x1.40mm_HandSolder | FIT | VERIFY_STOCK | D-RTC-14 | DS3231 INT/SQW (open drain) pull-up to switched 3V3, read on GP22. 0805, 1 % or 5 %
