jgazeley/accord/logger/hardware/kicad/order/digikey_rev_a.csv

Quantity | Manufacturer Part Number | Manufacturer | Board quantity | Reference Designators | Notes
1 | IL-AG5-14P-D3L2-A | JAE | 1 | J1 | Board connector 14-way
1 | ASSR-601JV-000E | Broadcom | 1 | U3 | ASSR-601JV
10 | RNMF14FTC22K0 | Stackpole | 5 | R1 R3 R5 R10 R16 | 22k
10 | RNMF14FTC33K0 | Stackpole | 1 | R2 | 33k
10 | 1N5819RLG | onsemi | 8 | D101 D102 D103 D104 D105 D106 D107 D109 | 1N5819
10 | RNMF14FTC6K80 | Stackpole | 2 | R4 R6 | 6.8k
10 | RNMF14FTC7K50 | Stackpole | 1 | R7 | 7.5k
10 | RNMF14FTC4K70 | Stackpole | 3 | R8 R11 R18 | 4.7k
10 | RNMF14FTC1K00 | Stackpole | 8 | R9 R12 R19 R24 R26 R29 R37 R38 | 1k
10 | CL21B105KAFNNNE | Samsung | 2 | C1 C2 | 1uF
3 | 1.5KE20A-E3/54 | Vishay | 2 | D108 D113 | 1.5KE20A-E3/54
1 | SC0918 | Raspberry Pi | 1 | U1 | RaspberryPi_Pico_W
2 | PR01000102201JR500 | Vishay | 1 | R13 | 2.2k
10 | 1N4148W-7-F | Diodes Inc | 1 | D110 | 1N4148W
2 | PC817XNNSZ1B | Sharp | 1 | U2 | PC817
10 | RNMF14FTC47K0 | Stackpole | 3 | R14 R28 R44 | 47k
10 | RNMF14FTC220K | Stackpole | 1 | R15 | 220k
2 | MKS2C041001F00JSSD | WIMA | 1 | C3 | 1uF
3 | MMBT3904LT1G | onsemi | 2 | Q1 Q9 | MMBT3904
10 | RNMF14FTC100K | Stackpole | 6 | R17 R20 R25 R27 R34 R35 | 100k
5 | BSS138P,215 | Nexperia | 4 | Q2 Q3 Q4 Q8 | BSS138P
10 | RNMF14FTC10K0 | Stackpole | 3 | R21 R31 R36 | 10k
10 | RNMF14FTC820R | Stackpole | 1 | R22 | 820R
10 | BZX55C22-TAP | Vishay | 1 | D111 | BZX55C22
10 | GRM32ER71H475KA88L | Murata | 3 | C4 C5 C6 | 4.7uF/50V
2 | TPS70950QDBVRQ1 | Texas Instruments | 1 | U4 | TPS70950QDBVRQ1
2 | TPS3839K50DBZR | Texas Instruments | 1 | U5 | TPS3839K50DBZR
20 | CL21B104KBCNNNC | Samsung | 11 | C7 C13 C17 C18 C19 C20 C21 C22 C23 C24 C25 | 100nF
10 | RNMF14FTC270R | Stackpole | 1 | R23 | 270R
2 | EEU-FC1V470 | Panasonic | 1 | C8 | 47uF/16V
2 | PRPC003DAAN-RC | Sullins | 1 | J3 | Spare GP11-13 / switched power
10 | RNF14FTC10K0 | Stackpole | 1 | R30 | 10k
3 | SB360-E3/54 | Vishay | 2 | D112 D115 | SB360-E3/54
10 | C2012X7R2A104K125AA | TDK | 2 | C9 C11 | 100nF/100V
10 | BZX55C10-TAP | Vishay | 1 | D114 | BZX55C10
2 | PR01000101001JR500 | Vishay | 1 | R32 | 1k
2 | IPD50P04P4L11ATMA2 | Infineon | 1 | Q5 | IPD50P04P4L-11
10 | RNMF14FTC2K20 | Stackpole | 1 | R33 | 2.2k
3 | 2N3904BU | onsemi | 2 | Q6 Q7 | 2N3904
2 | EEU-FR1H101 | Panasonic | 1 | C10 | 100uF/50V
1 | LM2678T-5.0/NOPB | Texas Instruments | 1 | U6 | LM2678T-5.0
10 | CL21B103KBANNNC | Samsung | 2 | C12 C16 | 10nF/50V
1 | RLB0912-220KL | Bourns | 1 | L1 | 22uH
2 | EEU-FR1C102 | Panasonic | 1 | C14 | 1000uF/16V
10 | 1N4004-E3/54 | Vishay | 1 | D116 | 1N4004-E3/54
2 | TAP336K016SCS | KYOCERA AVX | 1 | C15 | 33uF/16V
2 | OV-7604-C7-32.768KHZ-20PPM-TA-QC | Micro Crystal | 1 | U7 | OV-7604-C7-32.768KHZ-20PPM-TA-QC
2 | 74AHC1G17GV,125 | Nexperia | 1 | U8 | 74AHC1G17GV
2 | SN74LVC1G97DBVR | Texas Instruments | 1 | U9 | SN74LVC1G97DBVR
2 | CD74HC4060M96 | Texas Instruments | 1 | U10 | CD74HC4060M96
2 | CD74HC4020M96 | Texas Instruments | 1 | U11 | CD74HC4020M96
2 | CD4011BM96 | Texas Instruments | 1 | U12 | CD4011BM96
2 | CD4071BM96 | Texas Instruments | 1 | U13 | CD4071BM96
2 | CD4093BM96 | Texas Instruments | 1 | U14 | CD4093BM96
10 | RC0805JR-070RL | Yageo | 2 | R39 R40 (DNP) | 0R
10 | RC0805FR-07100KL | Yageo | 4 | R41 R43 R45 R46 | 100k
10 | RC0805FR-071KL | Yageo | 1 | R42 | 1k
10 | 5001 | Keystone | 3 | TP21 TP22 TP23 | TestPoint
1 | MAX3485EPA+ | Analog Devices | 1 | U15 | MAX3485
10 | RNF14FTC390R | Stackpole | 2 | R47 R48 | 390R
10 | RNF14FTC120R | Stackpole | 1 | R49 | 120R
1 | DS3231SN# | Analog Devices | 1 | U16 | DS3231SN
1 | 3034 | Keystone | 1 | BT1 | BR2032
10 | RC0805FR-074K7L | Yageo | 2 | R50 R51 | 4.7k
10 | RC0805FR-0710KL | Yageo | 1 | R52 | 10k
1 | PREC040SAAN-RC | Sullins |  |  | 1x40 breakaway header: JP1-JP4, J4 (1x02) and J5 (1x06), 16 pins
10 | QPC02SXGN-RC | Sullins |  |  | jumper shunts: JP1 HOLD link, J4, spares
1 | 110-43-308-41-001000 | Mill-Max |  |  | DIP-8 socket for U15 MAX3485, as keyless
1 | BR-2032/BN | Panasonic |  |  | BT1 cell, BR chemistry rated to +85 C
2 | IL-AG5-14S-D3C1-A | JAE |  |  | harness mating housing for J1
20 | IL-AG5-C1-5000 | JAE |  |  | harness crimp socket contacts, 22-18 AWG (14 + spares)
1 | FHAC0001ZXJ | Littelfuse |  |  | inline ATO fuse holder for the harness feed (D-FUSE-10)
5 | 0287001.PXCN | Littelfuse |  |  | 1 A ATO fuse (D-FUSE-10)
