jgazeley/accord/logger/hardware/kicad/validation/courtyard_study.csv

reference | value | footprint | width_mm | height_mm | area_mm2 | population | measured_from
U1 | RaspberryPi_Pico_W | Module:RaspberryPi_Pico_W_SMD_HandSolder | 23.080 | 53.850 | 1242.9 | FIT | courtyard
J1 | Board connector 14-way | accord-logger:JAE_IL-AG5-14P-D3L2-A | 27.500 | 27.550 | 757.6 | FIT | courtyard
BT1 | BR2032 | Battery:BatteryHolder_Keystone_3034_1x20mm | 23.740 | 20.994 | 498.4 | FIT | courtyard
U16 | DS3231SN | Package_SO:SOIC-16W_7.5x10.3mm_P1.27mm | 11.860 | 10.800 | 128.1 | FIT | courtyard
U3 | ASSR-601JV | accord-logger:ASSR-601Jx_SO-16-12Lead_11.634x10.363mm_P1.27mm | 12.134 | 10.040 | 121.8 | FIT | courtyard
C14 | 1000uF/16V | Capacitor_THT:CP_Radial_D10.0mm_P5.00mm | 10.500 | 10.500 | 110.2 | FIT | courtyard
U15 | MAX3485 | Package_DIP:DIP-8_W7.62mm | 9.730 | 10.660 | 103.7 | FIT | courtyard
U6 | LM2678T-5.0 | Package_TO_SOT_THT:TO-220-7_P2.54x3.7mm_StaggerOdd_Lead3.8mm_Vertical | 10.500 | 9.600 | 100.8 | FIT | courtyard
L1 | 22uH | Inductor_THT:L_Radial_D8.7mm_P5.00mm_Fastron_07HCP | 9.200 | 9.200 | 84.6 | FIT | courtyard
Q5 | IPD50P04P4L-11 | Package_TO_SOT_SMD:TO-252-3_TabPin2 | 11.100 | 7.000 | 77.7 | FIT | courtyard
U10 | CD74HC4060M96 | Package_SO:SOIC-16_3.9x9.9mm_P1.27mm | 7.400 | 10.400 | 77.0 | FIT | courtyard
U11 | CD74HC4020M96 | Package_SO:SOIC-16_3.9x9.9mm_P1.27mm | 7.400 | 10.400 | 77.0 | FIT | courtyard
C10 | 100uF/50V | Capacitor_THT:CP_Radial_D8.0mm_P3.50mm | 8.500 | 8.500 | 72.2 | FIT | courtyard
U12 | CD4011BM96 | Package_SO:SOIC-14_3.9x8.7mm_P1.27mm | 7.400 | 9.160 | 67.8 | FIT | courtyard
U13 | CD4071BM96 | Package_SO:SOIC-14_3.9x8.7mm_P1.27mm | 7.400 | 9.160 | 67.8 | FIT | courtyard
U14 | CD4093BM96 | Package_SO:SOIC-14_3.9x8.7mm_P1.27mm | 7.400 | 9.160 | 67.8 | FIT | courtyard
J5 | SD breakout 6-way | Connector_PinHeader_2.54mm:PinHeader_1x06_P2.54mm_Vertical | 3.540 | 16.240 | 57.5 | FIT | courtyard
D108 | 1.5KE20A-E3/54 | Diode_THT:D_DO-201AD_P5.08mm_Vertical_KathodeUp | 9.780 | 5.700 | 55.7 | FIT | courtyard
D112 | SB360-E3/54 | Diode_THT:D_DO-201AD_P5.08mm_Vertical_AnodeUp | 9.780 | 5.700 | 55.7 | FIT | courtyard
D113 | 1.5KE20A-E3/54 | Diode_THT:D_DO-201AD_P5.08mm_Vertical_KathodeUp | 9.780 | 5.700 | 55.7 | FIT | courtyard
D115 | SB360-E3/54 | Diode_THT:D_DO-201AD_P5.08mm_Vertical_AnodeUp | 9.780 | 5.700 | 55.7 | FIT | courtyard
U2 | PC817 | Package_DIP:DIP-4_W7.62mm | 9.730 | 5.590 | 54.4 | FIT | courtyard
J3 | Spare GP11-13 / switched power | Connector_PinHeader_2.54mm:PinHeader_2x03_P2.54mm_Vertical | 6.090 | 8.620 | 52.5 | FIT | courtyard
C3 | 1uF | Capacitor_THT:C_Rect_L7.2mm_W5.5mm_P5.00mm_FKS2_FKP2_MKS2_MKP2 | 7.700 | 6.000 | 46.2 | FIT | courtyard
C8 | 47uF/16V | Capacitor_THT:CP_Radial_D6.3mm_P2.50mm | 6.800 | 6.800 | 46.2 | FIT | courtyard
R13 | 2.2k | Resistor_THT:R_Axial_DIN0414_L11.9mm_D4.5mm_P5.08mm_Vertical | 9.030 | 5.000 | 45.2 | FIT | courtyard
R32 | 1k | Resistor_THT:R_Axial_DIN0414_L11.9mm_D4.5mm_P5.08mm_Vertical | 9.030 | 5.000 | 45.2 | FIT | courtyard
C15 | 33uF/16V | Capacitor_THT:CP_Radial_Tantal_D6.0mm_P2.50mm | 6.500 | 6.500 | 42.2 | FIT | courtyard
Q6 | 2N3904 | Package_TO_SOT_THT:TO-92_Inline | 5.460 | 4.740 | 25.9 | FIT | courtyard
Q7 | 2N3904 | Package_TO_SOT_THT:TO-92_Inline | 5.460 | 4.740 | 25.9 | FIT | courtyard
D101 | 1N5819 | Diode_THT:D_DO-41_SOD81_P5.08mm_Vertical_AnodeUp | 8.030 | 3.200 | 25.7 | FIT | courtyard
D102 | 1N5819 | Diode_THT:D_DO-41_SOD81_P5.08mm_Vertical_AnodeUp | 8.030 | 3.200 | 25.7 | FIT | courtyard
D103 | 1N5819 | Diode_THT:D_DO-41_SOD81_P5.08mm_Vertical_AnodeUp | 8.030 | 3.200 | 25.7 | FIT | courtyard
D104 | 1N5819 | Diode_THT:D_DO-41_SOD81_P5.08mm_Vertical_AnodeUp | 8.030 | 3.200 | 25.7 | FIT | courtyard
D105 | 1N5819 | Diode_THT:D_DO-41_SOD81_P5.08mm_Vertical_AnodeUp | 8.030 | 3.200 | 25.7 | FIT | courtyard
D106 | 1N5819 | Diode_THT:D_DO-41_SOD81_P5.08mm_Vertical_AnodeUp | 8.030 | 3.200 | 25.7 | FIT | courtyard
D107 | 1N5819 | Diode_THT:D_DO-41_SOD81_P5.08mm_Vertical_AnodeUp | 8.030 | 3.200 | 25.7 | FIT | courtyard
D109 | 1N5819 | Diode_THT:D_DO-41_SOD81_P5.08mm_Vertical_AnodeUp | 8.030 | 3.200 | 25.7 | FIT | courtyard
D116 | 1N4004-E3/54 | Diode_THT:D_DO-41_SOD81_P5.08mm_Vertical_KathodeUp | 8.030 | 3.200 | 25.7 | FIT | courtyard
R30 | 10k | Resistor_THT:R_Axial_DIN0207_L6.3mm_D2.5mm_P5.08mm_Vertical | 7.630 | 3.000 | 22.9 | FIT | courtyard
R47 | 390R | Resistor_THT:R_Axial_DIN0207_L6.3mm_D2.5mm_P5.08mm_Vertical | 7.630 | 3.000 | 22.9 | FIT | courtyard
R48 | 390R | Resistor_THT:R_Axial_DIN0207_L6.3mm_D2.5mm_P5.08mm_Vertical | 7.630 | 3.000 | 22.9 | FIT | courtyard
R49 | 120R | Resistor_THT:R_Axial_DIN0207_L6.3mm_D2.5mm_P5.08mm_Vertical | 7.630 | 3.000 | 22.9 | FIT | courtyard
JP1 | HOLD link | Connector_PinHeader_2.54mm:PinHeader_1x02_P2.54mm_Vertical | 3.540 | 6.090 | 21.6 | FIT | courtyard
J4 | Reset RUN-GND | Connector_PinHeader_2.54mm:PinHeader_1x02_P2.54mm_Vertical | 3.540 | 6.090 | 21.6 | FIT | courtyard
JP2 | TERM default OPEN | Connector_PinHeader_2.54mm:PinHeader_1x02_P2.54mm_Vertical | 3.540 | 6.090 | 21.6 | FIT | courtyard
JP3 | BIAS HI default OPEN | Connector_PinHeader_2.54mm:PinHeader_1x02_P2.54mm_Vertical | 3.540 | 6.090 | 21.6 | FIT | courtyard
JP4 | BIAS LO default OPEN | Connector_PinHeader_2.54mm:PinHeader_1x02_P2.54mm_Vertical | 3.540 | 6.090 | 21.6 | FIT | courtyard
U9 | SN74LVC1G97DBVR | Package_TO_SOT_SMD:SOT-23-6_Handsoldering | 4.800 | 3.600 | 17.3 | FIT | courtyard
U4 | TPS70950QDBVRQ1 | Package_TO_SOT_SMD:SOT-23-5_HandSoldering | 4.760 | 3.600 | 17.1 | FIT | courtyard
C4 | 4.7uF/50V | Capacitor_SMD:C_1210_3225Metric_Pad1.33x2.70mm_HandSolder | 4.960 | 3.200 | 15.9 | FIT | courtyard
C5 | 4.7uF/50V | Capacitor_SMD:C_1210_3225Metric_Pad1.33x2.70mm_HandSolder | 4.960 | 3.200 | 15.9 | FIT | courtyard
C6 | 4.7uF/50V | Capacitor_SMD:C_1210_3225Metric_Pad1.33x2.70mm_HandSolder | 4.960 | 3.200 | 15.9 | FIT | courtyard
R1 | 22k | Resistor_THT:R_Axial_DIN0204_L3.6mm_D1.6mm_P5.08mm_Horizontal | 6.980 | 2.100 | 14.7 | FIT | courtyard
R2 | 33k | Resistor_THT:R_Axial_DIN0204_L3.6mm_D1.6mm_P5.08mm_Horizontal | 6.980 | 2.100 | 14.7 | FIT | courtyard
R3 | 22k | Resistor_THT:R_Axial_DIN0204_L3.6mm_D1.6mm_P5.08mm_Horizontal | 6.980 | 2.100 | 14.7 | FIT | courtyard
R4 | 6.8k | Resistor_THT:R_Axial_DIN0204_L3.6mm_D1.6mm_P5.08mm_Horizontal | 6.980 | 2.100 | 14.7 | FIT | courtyard
R5 | 22k | Resistor_THT:R_Axial_DIN0204_L3.6mm_D1.6mm_P5.08mm_Horizontal | 6.980 | 2.100 | 14.7 | FIT | courtyard
R6 | 6.8k | Resistor_THT:R_Axial_DIN0204_L3.6mm_D1.6mm_P5.08mm_Horizontal | 6.980 | 2.100 | 14.7 | FIT | courtyard
R7 | 7.5k | Resistor_THT:R_Axial_DIN0204_L3.6mm_D1.6mm_P5.08mm_Horizontal | 6.980 | 2.100 | 14.7 | FIT | courtyard
R8 | 4.7k | Resistor_THT:R_Axial_DIN0204_L3.6mm_D1.6mm_P5.08mm_Horizontal | 6.980 | 2.100 | 14.7 | FIT | courtyard
R9 | 1k | Resistor_THT:R_Axial_DIN0204_L3.6mm_D1.6mm_P5.08mm_Horizontal | 6.980 | 2.100 | 14.7 | FIT | courtyard
R10 | 22k | Resistor_THT:R_Axial_DIN0204_L3.6mm_D1.6mm_P5.08mm_Horizontal | 6.980 | 2.100 | 14.7 | FIT | courtyard
R11 | 4.7k | Resistor_THT:R_Axial_DIN0204_L3.6mm_D1.6mm_P5.08mm_Horizontal | 6.980 | 2.100 | 14.7 | FIT | courtyard
R12 | 1k | Resistor_THT:R_Axial_DIN0204_L3.6mm_D1.6mm_P5.08mm_Horizontal | 6.980 | 2.100 | 14.7 | FIT | courtyard
R14 | 47k | Resistor_THT:R_Axial_DIN0204_L3.6mm_D1.6mm_P5.08mm_Horizontal | 6.980 | 2.100 | 14.7 | FIT | courtyard
R15 | 220k | Resistor_THT:R_Axial_DIN0204_L3.6mm_D1.6mm_P5.08mm_Horizontal | 6.980 | 2.100 | 14.7 | FIT | courtyard
R16 | 22k | Resistor_THT:R_Axial_DIN0204_L3.6mm_D1.6mm_P5.08mm_Horizontal | 6.980 | 2.100 | 14.7 | FIT | courtyard
R17 | 100k | Resistor_THT:R_Axial_DIN0204_L3.6mm_D1.6mm_P5.08mm_Horizontal | 6.980 | 2.100 | 14.7 | FIT | courtyard
R18 | 4.7k | Resistor_THT:R_Axial_DIN0204_L3.6mm_D1.6mm_P5.08mm_Horizontal | 6.980 | 2.100 | 14.7 | FIT | courtyard
R19 | 1k | Resistor_THT:R_Axial_DIN0204_L3.6mm_D1.6mm_P5.08mm_Horizontal | 6.980 | 2.100 | 14.7 | FIT | courtyard
R20 | 100k | Resistor_THT:R_Axial_DIN0204_L3.6mm_D1.6mm_P5.08mm_Horizontal | 6.980 | 2.100 | 14.7 | FIT | courtyard
R21 | 10k | Resistor_THT:R_Axial_DIN0204_L3.6mm_D1.6mm_P5.08mm_Horizontal | 6.980 | 2.100 | 14.7 | FIT | courtyard
R22 | 820R | Resistor_THT:R_Axial_DIN0204_L3.6mm_D1.6mm_P5.08mm_Horizontal | 6.980 | 2.100 | 14.7 | FIT | courtyard
R23 | 270R | Resistor_THT:R_Axial_DIN0204_L3.6mm_D1.6mm_P5.08mm_Horizontal | 6.980 | 2.100 | 14.7 | FIT | courtyard
R24 | 1k | Resistor_THT:R_Axial_DIN0204_L3.6mm_D1.6mm_P5.08mm_Horizontal | 6.980 | 2.100 | 14.7 | FIT | courtyard
R25 | 100k | Resistor_THT:R_Axial_DIN0204_L3.6mm_D1.6mm_P5.08mm_Horizontal | 6.980 | 2.100 | 14.7 | FIT | courtyard
R26 | 1k | Resistor_THT:R_Axial_DIN0204_L3.6mm_D1.6mm_P5.08mm_Horizontal | 6.980 | 2.100 | 14.7 | FIT | courtyard
R27 | 100k | Resistor_THT:R_Axial_DIN0204_L3.6mm_D1.6mm_P5.08mm_Horizontal | 6.980 | 2.100 | 14.7 | FIT | courtyard
R28 | 47k | Resistor_THT:R_Axial_DIN0204_L3.6mm_D1.6mm_P5.08mm_Horizontal | 6.980 | 2.100 | 14.7 | FIT | courtyard
R29 | 1k | Resistor_THT:R_Axial_DIN0204_L3.6mm_D1.6mm_P5.08mm_Horizontal | 6.980 | 2.100 | 14.7 | FIT | courtyard
R31 | 10k | Resistor_THT:R_Axial_DIN0204_L3.6mm_D1.6mm_P5.08mm_Horizontal | 6.980 | 2.100 | 14.7 | FIT | courtyard
R33 | 2.2k | Resistor_THT:R_Axial_DIN0204_L3.6mm_D1.6mm_P5.08mm_Horizontal | 6.980 | 2.100 | 14.7 | FIT | courtyard
R34 | 100k | Resistor_THT:R_Axial_DIN0204_L3.6mm_D1.6mm_P5.08mm_Horizontal | 6.980 | 2.100 | 14.7 | FIT | courtyard
R35 | 100k | Resistor_THT:R_Axial_DIN0204_L3.6mm_D1.6mm_P5.08mm_Horizontal | 6.980 | 2.100 | 14.7 | FIT | courtyard
R36 | 10k | Resistor_THT:R_Axial_DIN0204_L3.6mm_D1.6mm_P5.08mm_Horizontal | 6.980 | 2.100 | 14.7 | FIT | courtyard
R37 | 1k | Resistor_THT:R_Axial_DIN0204_L3.6mm_D1.6mm_P5.08mm_Horizontal | 6.980 | 2.100 | 14.7 | FIT | courtyard
R38 | 1k | Resistor_THT:R_Axial_DIN0204_L3.6mm_D1.6mm_P5.08mm_Horizontal | 6.980 | 2.100 | 14.7 | FIT | courtyard
R44 | 47k | Resistor_THT:R_Axial_DIN0204_L3.6mm_D1.6mm_P5.08mm_Horizontal | 6.980 | 2.100 | 14.7 | FIT | courtyard
U8 | 74AHC1G17GV | Package_TO_SOT_SMD:SOT-353_SC-70-5_Handsoldering | 4.800 | 2.800 | 13.4 | FIT | courtyard
Q1 | MMBT3904 | Package_TO_SOT_SMD:SOT-23 | 3.860 | 3.400 | 13.1 | FIT | courtyard
Q2 | BSS138P | Package_TO_SOT_SMD:SOT-23 | 3.860 | 3.400 | 13.1 | FIT | courtyard
U5 | TPS3839K50DBZR | Package_TO_SOT_SMD:SOT-23 | 3.860 | 3.400 | 13.1 | FIT | courtyard
Q3 | BSS138P | Package_TO_SOT_SMD:SOT-23 | 3.860 | 3.400 | 13.1 | FIT | courtyard
Q4 | BSS138P | Package_TO_SOT_SMD:SOT-23 | 3.860 | 3.400 | 13.1 | FIT | courtyard
Q8 | BSS138P | Package_TO_SOT_SMD:SOT-23 | 3.860 | 3.400 | 13.1 | FIT | courtyard
Q9 | MMBT3904 | Package_TO_SOT_SMD:SOT-23 | 3.860 | 3.400 | 13.1 | FIT | courtyard
TP21 | TestPoint | TestPoint:TestPoint_Loop_D2.50mm_Drill1.0mm | 3.600 | 3.600 | 13.0 | FIT | courtyard
TP22 | TestPoint | TestPoint:TestPoint_Loop_D2.50mm_Drill1.0mm | 3.600 | 3.600 | 13.0 | FIT | courtyard
TP23 | TestPoint | TestPoint:TestPoint_Loop_D2.50mm_Drill1.0mm | 3.600 | 3.600 | 13.0 | FIT | courtyard
D111 | BZX55C22 | Diode_THT:D_DO-35_SOD27_P2.54mm_Vertical_KathodeUp | 4.840 | 2.500 | 12.1 | FIT | courtyard
D114 | BZX55C10 | Diode_THT:D_DO-35_SOD27_P2.54mm_Vertical_KathodeUp | 4.840 | 2.500 | 12.1 | FIT | courtyard
D110 | 1N4148W | Diode_SMD:D_SOD-123 | 4.700 | 2.300 | 10.8 | FIT | courtyard
U7 | OV-7604-C7-32.768KHZ-20PPM-TA-QC | accord-logger:Oscillator_SMD_MicroCrystal_OV-7604-C7_SON-4_3.2x1.5mm | 4.200 | 2.500 | 10.5 | FIT | courtyard
TP1 | TestPoint | TestPoint:TestPoint_Pad_D2.0mm | 3.000 | 3.000 | 9.0 | FIT | courtyard
TP2 | TestPoint | TestPoint:TestPoint_Pad_D2.0mm | 3.000 | 3.000 | 9.0 | FIT | courtyard
TP3 | TestPoint | TestPoint:TestPoint_Pad_D2.0mm | 3.000 | 3.000 | 9.0 | FIT | courtyard
TP4 | TestPoint | TestPoint:TestPoint_Pad_D2.0mm | 3.000 | 3.000 | 9.0 | FIT | courtyard
TP5 | TestPoint | TestPoint:TestPoint_Pad_D2.0mm | 3.000 | 3.000 | 9.0 | FIT | courtyard
TP6 | TestPoint | TestPoint:TestPoint_Pad_D2.0mm | 3.000 | 3.000 | 9.0 | FIT | courtyard
TP7 | TestPoint | TestPoint:TestPoint_Pad_D2.0mm | 3.000 | 3.000 | 9.0 | FIT | courtyard
TP8 | TestPoint | TestPoint:TestPoint_Pad_D2.0mm | 3.000 | 3.000 | 9.0 | FIT | courtyard
TP9 | TestPoint | TestPoint:TestPoint_Pad_D2.0mm | 3.000 | 3.000 | 9.0 | FIT | courtyard
TP12 | TestPoint | TestPoint:TestPoint_Pad_D2.0mm | 3.000 | 3.000 | 9.0 | FIT | courtyard
TP17 | TestPoint | TestPoint:TestPoint_Pad_D2.0mm | 3.000 | 3.000 | 9.0 | FIT | courtyard
TP20 | TestPoint | TestPoint:TestPoint_Pad_D2.0mm | 3.000 | 3.000 | 9.0 | FIT | courtyard
C1 | 1uF | Capacitor_SMD:C_0805_2012Metric_Pad1.18x1.45mm_HandSolder | 3.760 | 1.960 | 7.4 | FIT | courtyard
C2 | 1uF | Capacitor_SMD:C_0805_2012Metric_Pad1.18x1.45mm_HandSolder | 3.760 | 1.960 | 7.4 | FIT | courtyard
C7 | 100nF | Capacitor_SMD:C_0805_2012Metric_Pad1.18x1.45mm_HandSolder | 3.760 | 1.960 | 7.4 | FIT | courtyard
C9 | 100nF/100V | Capacitor_SMD:C_0805_2012Metric_Pad1.18x1.45mm_HandSolder | 3.760 | 1.960 | 7.4 | FIT | courtyard
C11 | 100nF/100V | Capacitor_SMD:C_0805_2012Metric_Pad1.18x1.45mm_HandSolder | 3.760 | 1.960 | 7.4 | FIT | courtyard
C12 | 10nF/50V | Capacitor_SMD:C_0805_2012Metric_Pad1.18x1.45mm_HandSolder | 3.760 | 1.960 | 7.4 | FIT | courtyard
C13 | 100nF/50V | Capacitor_SMD:C_0805_2012Metric_Pad1.18x1.45mm_HandSolder | 3.760 | 1.960 | 7.4 | FIT | courtyard
C16 | 10nF | Capacitor_SMD:C_0805_2012Metric_Pad1.18x1.45mm_HandSolder | 3.760 | 1.960 | 7.4 | FIT | courtyard
C17 | 100nF | Capacitor_SMD:C_0805_2012Metric_Pad1.18x1.45mm_HandSolder | 3.760 | 1.960 | 7.4 | FIT | courtyard
C18 | 100nF | Capacitor_SMD:C_0805_2012Metric_Pad1.18x1.45mm_HandSolder | 3.760 | 1.960 | 7.4 | FIT | courtyard
C19 | 100nF | Capacitor_SMD:C_0805_2012Metric_Pad1.18x1.45mm_HandSolder | 3.760 | 1.960 | 7.4 | FIT | courtyard
C20 | 100nF | Capacitor_SMD:C_0805_2012Metric_Pad1.18x1.45mm_HandSolder | 3.760 | 1.960 | 7.4 | FIT | courtyard
C21 | 100nF | Capacitor_SMD:C_0805_2012Metric_Pad1.18x1.45mm_HandSolder | 3.760 | 1.960 | 7.4 | FIT | courtyard
C22 | 100nF | Capacitor_SMD:C_0805_2012Metric_Pad1.18x1.45mm_HandSolder | 3.760 | 1.960 | 7.4 | FIT | courtyard
C23 | 100nF | Capacitor_SMD:C_0805_2012Metric_Pad1.18x1.45mm_HandSolder | 3.760 | 1.960 | 7.4 | FIT | courtyard
C24 | 100nF | Capacitor_SMD:C_0805_2012Metric_Pad1.18x1.45mm_HandSolder | 3.760 | 1.960 | 7.4 | FIT | courtyard
C25 | 100nF | Capacitor_SMD:C_0805_2012Metric_Pad1.18x1.45mm_HandSolder | 3.760 | 1.960 | 7.4 | FIT | courtyard
R39 | 0R | Resistor_SMD:R_0805_2012Metric_Pad1.20x1.40mm_HandSolder | 3.700 | 1.900 | 7.0 | FIT | courtyard
R40 | 0R | Resistor_SMD:R_0805_2012Metric_Pad1.20x1.40mm_HandSolder | 3.700 | 1.900 | 7.0 | DNP | courtyard
R41 | 100k | Resistor_SMD:R_0805_2012Metric_Pad1.20x1.40mm_HandSolder | 3.700 | 1.900 | 7.0 | FIT | courtyard
R42 | 1k | Resistor_SMD:R_0805_2012Metric_Pad1.20x1.40mm_HandSolder | 3.700 | 1.900 | 7.0 | FIT | courtyard
R43 | 100k | Resistor_SMD:R_0805_2012Metric_Pad1.20x1.40mm_HandSolder | 3.700 | 1.900 | 7.0 | FIT | courtyard
R45 | 100k | Resistor_SMD:R_0805_2012Metric_Pad1.20x1.40mm_HandSolder | 3.700 | 1.900 | 7.0 | FIT | courtyard
R46 | 100k | Resistor_SMD:R_0805_2012Metric_Pad1.20x1.40mm_HandSolder | 3.700 | 1.900 | 7.0 | FIT | courtyard
R50 | 4.7k | Resistor_SMD:R_0805_2012Metric_Pad1.20x1.40mm_HandSolder | 3.700 | 1.900 | 7.0 | FIT | courtyard
R51 | 4.7k | Resistor_SMD:R_0805_2012Metric_Pad1.20x1.40mm_HandSolder | 3.700 | 1.900 | 7.0 | FIT | courtyard
R52 | 10k | Resistor_SMD:R_0805_2012Metric_Pad1.20x1.40mm_HandSolder | 3.700 | 1.900 | 7.0 | FIT | courtyard
