jgazeley/accord/logger/hardware/kicad/mechanical/accord-logger-outline.dxf

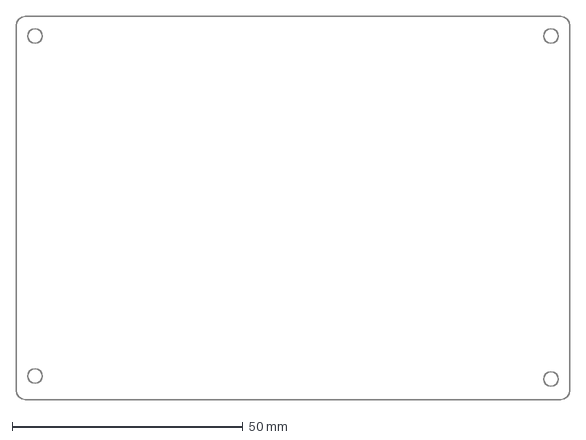
[picture p3: CAD file, 2026-11-12]
logger/hardware/kicad/mechanical/accord-logger-outline.dxf
120.0 x 83.0 mm
