jgazeley/accord/logger/hardware/kicad/mechanical/case-bottom/accord-logger-case-bottom.stl

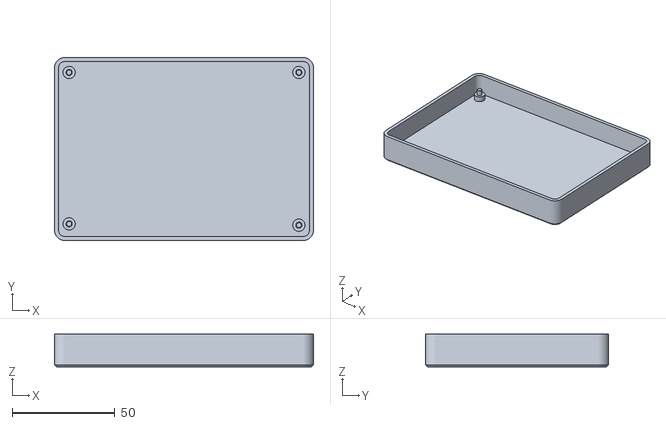
[picture p4: CAD file, 2026-11-12]
logger/hardware/kicad/mechanical/case-bottom/accord-logger-case-bottom.stl
126.0 x 89.0 x 16.0
