jgazeley/accord/logger/hardware/kicad/mechanical/accord-logger-board.step

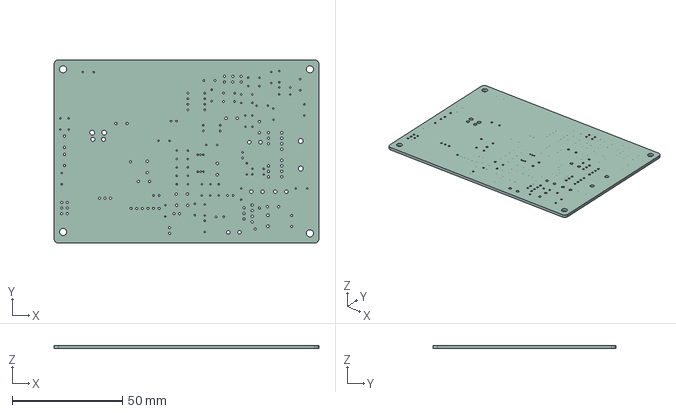
[picture p5: CAD file, 2026-11-12]
logger/hardware/kicad/mechanical/accord-logger-board.step
120.0 x 83.0 x 1.51 mm
