jgazeley/accord/logger/hardware/kicad/mechanical/case-bottom/accord-logger-case-bottom.scad

// SPDX-License-Identifier: CERN-OHL-P-2.0
// Copyright 2026 Jayson Gazeley — https://github.com/jgazeley/accord
// Case bottom with locating studs. Millimetres; same XY datum as the PCB.
// Generated by tools/build_case_bottom.py; edit these dimensions in OpenSCAD.
pcb_width = 120;
pcb_height = 83;
pcb_radius = 2;
clearance = 1;  // gap on EACH side of the PCB
wall = 2;
floor_thickness = 4;
internal_depth = 12;
bottom_chamfer = 1;  // 45-degree exterior bottom edge, horizontal and vertical
support_height = 3.175;  // PCB underside above the INSIDE floor
support_diameter = 6;
pin_clearance = 0.2;  // DIAMETRAL clearance in each PCB hole
pin_height = 3;  // includes the tapered tip
tip_height = 0.5;
tip_diameter_reduction = 0.6;
pcb_thickness = 1.6;
// x, y, PCB hole diameter; H1, H2, H3, H4 (asymmetric lower holes).
mounts = [[115.88, 78.74, 3.2], [115.88, 4.445, 3.2], [4.12, 78.74, 3.2], [4.12, 5.08, 3.2]];
$fn = 128;

assert(clearance > 0 && wall > 0 && floor_thickness > 0 && internal_depth > 0);
assert(bottom_chamfer > 0 && bottom_chamfer <= wall && bottom_chamfer < floor_thickness);
assert(support_height > 0 && support_height+pin_height <= internal_depth);
assert(pin_clearance > 0 && pin_height > max(pcb_thickness, tip_height));

module profile(gap) {
    hull()
        for (x = [pcb_radius, pcb_width-pcb_radius])
            for (y = [pcb_radius, pcb_height-pcb_radius])
                translate([x,y]) circle(r=pcb_radius+gap);
}

union() {
    difference() {
        union() {
            hull()
                for (x = [pcb_radius, pcb_width-pcb_radius])
                    for (y = [pcb_radius, pcb_height-pcb_radius])
                        translate([x,y,0])
                            cylinder(h=bottom_chamfer,
                                r1=pcb_radius+clearance+wall-bottom_chamfer,
                                r2=pcb_radius+clearance+wall);
            translate([0,0,bottom_chamfer])
                linear_extrude(height=floor_thickness+internal_depth-bottom_chamfer)
                    profile(clearance+wall);
        }
        translate([0,0,floor_thickness])
            linear_extrude(height=internal_depth+0.1)
                profile(clearance);
    }
    for (mount = mounts) {
        pin_diameter = mount[2]-pin_clearance;
        assert(pin_diameter > tip_diameter_reduction && pin_diameter < support_diameter);
        translate([mount[0],mount[1],floor_thickness]) {
            translate([0,0,-0.05])
                cylinder(h=support_height+0.05, d=support_diameter);
            translate([0,0,support_height])
                cylinder(h=pin_height-tip_height, d=pin_diameter);
            translate([0,0,support_height+pin_height-tip_height])
                cylinder(h=tip_height, d1=pin_diameter, d2=pin_diameter-tip_diameter_reduction);
        }
    }
}
