jgazeley/accord/logger/hardware/kicad/accord-logger.kicad_pcb

## KiCad design logger/hardware/kicad/accord-logger.kicad_pcb (2026-10-31)

Schematic: accord-logger.kicad_sch, Accord logger Rev A - complete electrical design for layout…

Parts:
BT1: BR2032; BatteryHolder_Keystone_3034_1x20mm
C1, C2: 1uF; C_0805_2012Metric_Pad1.18x1.45mm_HandSolder
C3: 1uF; C_Rect_L7.2mm_W5.5mm_P5.00mm_FKS2_FKP2_MKS2_MKP2
C4, C5, C6: 4.7uF/50V; C_1210_3225Metric_Pad1.33x2.70mm_HandSolder; MPN Murata GRM32ER71H475KA88L
C7, C17, C18, C19, C20, C21, C22, C23, C24, C25: 100nF; C_0805_2012Metric_Pad1.18x1.45mm_HandSolder
C8: 47uF/16V; CP_Radial_D6.3mm_P2.50mm
C9, C11: 100nF/100V; C_0805_2012Metric_Pad1.18x1.45mm_HandSolder
C10: 100uF/50V; CP_Radial_D8.0mm_P3.50mm; MPN Panasonic EEUFR1H101
C12: 10nF/50V; C_0805_2012Metric_Pad1.18x1.45mm_HandSolder
C13: 100nF/50V; C_0805_2012Metric_Pad1.18x1.45mm_HandSolder
C14: 1000uF/16V; CP_Radial_D10.0mm_P5.00mm; MPN Panasonic EEUFR1C102
C15: 33uF/16V; CP_Radial_Tantal_D6.0mm_P2.50mm; MPN KYOCERA AVX TAP336K016SCS
C16: 10nF; C_0805_2012Metric_Pad1.18x1.45mm_HandSolder
D101, D102, D103, D104, D105, D106, D107, D109: 1N5819; D_DO-41_SOD81_P5.08mm_Vertical_AnodeUp; MPN Diodes Inc 1N5819HW-7-F
D108, D113: 1.5KE20A-E3/54; D_DO-201AD_P5.08mm_Vertical_KathodeUp; MPN Vishay 1.5KE20A-E3/54
D110: 1N4148W; D_SOD-123; MPN Diodes Inc 1N4148W-7-F
D111: BZX55C22; D_DO-35_SOD27_P2.54mm_Vertical_KathodeUp; MPN Vishay BZX55C22-TAP
D112, D115: SB360-E3/54; D_DO-201AD_P5.08mm_Vertical_AnodeUp; MPN Vishay SB360-E3/54
D114: BZX55C10; D_DO-35_SOD27_P2.54mm_Vertical_KathodeUp; MPN Vishay BZX55C10-TAP
D116: 1N4004-E3/54; D_DO-41_SOD81_P5.08mm_Vertical_KathodeUp; MPN Vishay 1N4004-E3/54
J1: Board connector 14-way; JAE_IL-AG5-14P-D3L2-A; MPN JAE IL-AG5-14P-D3L2-A, 14 contact right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
J3: Spare GP11-13 / switched power; PinHeader_2x03_P2.54mm_Vertical
J4: Reset RUN-GND; PinHeader_1x02_P2.54mm_Vertical
J5: SD breakout 6-way; PinHeader_1x06_P2.54mm_Vertical
JP1: HOLD link; PinHeader_1x02_P2.54mm_Vertical
JP2: TERM default OPEN; PinHeader_1x02_P2.54mm_Vertical
JP3: BIAS HI default OPEN; PinHeader_1x02_P2.54mm_Vertical
JP4: BIAS LO default OPEN; PinHeader_1x02_P2.54mm_Vertical
L1: 22uH; L_Radial_D8.7mm_P5.00mm_Fastron_07HCP; MPN Bourns RLB0912-220KL
Q1, Q9: MMBT3904; SOT-23; MPN onsemi MMBT3904LT1G
Q2, Q3, Q4, Q8: BSS138P; SOT-23; MPN Nexperia BSS138P
Q5: IPD50P04P4L-11; TO-252-3_TabPin2; MPN Infineon IPD50P04P4L11ATMA2
Q6, Q7: 2N3904; TO-92_Inline; MPN onsemi 2N3904
R1, R3, R5, R10, R16: 22k; R_Axial_DIN0204_L3.6mm_D1.6mm_P5.08mm_Horizontal
R2: 33k; R_Axial_DIN0204_L3.6mm_D1.6mm_P5.08mm_Horizontal
R4, R6: 6.8k; R_Axial_DIN0204_L3.6mm_D1.6mm_P5.08mm_Horizontal
R7: 7.5k; R_Axial_DIN0204_L3.6mm_D1.6mm_P5.08mm_Horizontal
R8, R11, R18: 4.7k; R_Axial_DIN0204_L3.6mm_D1.6mm_P5.08mm_Horizontal
R9, R12, R19, R24, R26, R29, R37, R38: 1k; R_Axial_DIN0204_L3.6mm_D1.6mm_P5.08mm_Horizontal
R13: 2.2k; R_Axial_DIN0414_L11.9mm_D4.5mm_P5.08mm_Vertical
R14, R28, R44: 47k; R_Axial_DIN0204_L3.6mm_D1.6mm_P5.08mm_Horizontal
R15: 220k; R_Axial_DIN0204_L3.6mm_D1.6mm_P5.08mm_Horizontal
R17, R20, R25, R27, R34, R35: 100k; R_Axial_DIN0204_L3.6mm_D1.6mm_P5.08mm_Horizontal
R21, R31, R36: 10k; R_Axial_DIN0204_L3.6mm_D1.6mm_P5.08mm_Horizontal
R22: 820R; R_Axial_DIN0204_L3.6mm_D1.6mm_P5.08mm_Horizontal
R23: 270R; R_Axial_DIN0204_L3.6mm_D1.6mm_P5.08mm_Horizontal
R30: 10k; R_Axial_DIN0207_L6.3mm_D2.5mm_P5.08mm_Vertical
R32: 1k; R_Axial_DIN0414_L11.9mm_D4.5mm_P5.08mm_Vertical
R33: 2.2k; R_Axial_DIN0204_L3.6mm_D1.6mm_P5.08mm_Horizontal
R39: 0R; R_0805_2012Metric_Pad1.20x1.40mm_HandSolder
R40: 0R; R_0805_2012Metric_Pad1.20x1.40mm_HandSolder; not fitted
R41, R43, R45, R46: 100k; R_0805_2012Metric_Pad1.20x1.40mm_HandSolder
R42: 1k; R_0805_2012Metric_Pad1.20x1.40mm_HandSolder
R47, R48: 390R; R_Axial_DIN0207_L6.3mm_D2.5mm_P5.08mm_Vertical
R49: 120R; R_Axial_DIN0207_L6.3mm_D2.5mm_P5.08mm_Vertical
R50, R51: 4.7k; R_0805_2012Metric_Pad1.20x1.40mm_HandSolder
R52: 10k; R_0805_2012Metric_Pad1.20x1.40mm_HandSolder
TP1, TP2, TP3, TP4, TP5, TP6, TP7, TP8, TP9, TP12, TP17, TP20: TestPoint; TestPoint_Pad_D2.0mm
TP21, TP22, TP23: TestPoint; TestPoint_Loop_D2.50mm_Drill1.0mm
U1: RaspberryPi_Pico_W; RaspberryPi_Pico_W_SMD_HandSolder; MPN Raspberry Pi Pico W (RP2040 + CYW43439)
U2: PC817; DIP-4_W7.62mm; MPN Sharp PC817XNNSZ1B or qualified equival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
U3: ASSR-601JV; ASSR-601Jx_SO-16-12Lead_11.634x10.363mm_P1.27mm; MPN Broadcom ASSR-601JV-000E
U4: TPS70950QDBVRQ1; SOT-23-5_HandSoldering; MPN TI TPS70950QDBVRQ1
U5: TPS3839K50DBZR; SOT-23; MPN TI TPS3839K50DBZR
U6: LM2678T-5.0; TO-220-7_P2.54x3.7mm_StaggerOdd_Lead3.8mm_Vertical; MPN TI LM2678T-5.0/NOPB
U7: OV-7604-C7-32.768KHZ-20PPM-TA-QC; Oscillator_SMD_MicroCrystal_OV-7604-C7_SON-4_3.2x1.5mm; MPN Micro Crystal OV-7604-C7-32.768KHZ-20PP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
U8: 74AHC1G17GV; SOT-353_SC-70-5_Handsoldering; MPN Nexperia 74AHC1G17GV
U9: SN74LVC1G97DBVR; SOT-23-6_Handsoldering; MPN TI SN74LVC1G97DBVR
U10: CD74HC4060M96; SOIC-16_3.9x9.9mm_P1.27mm; MPN TI CD74HC4060M96
U11: CD74HC4020M96; SOIC-16_3.9x9.9mm_P1.27mm; MPN TI CD74HC4020M96
U12: CD4011BM96; SOIC-14_3.9x8.7mm_P1.27mm; MPN TI CD4011BM96
U13: CD4071BM96; SOIC-14_3.9x8.7mm_P1.27mm; MPN TI CD4071BM96
U14: CD4093BM96; SOIC-14_3.9x8.7mm_P1.27mm; MPN TI CD4093BM96
U15: MAX3485; DIP-8_W7.62mm; MPN Analog Devices MAX3485EPA+
U16: DS3231SN; SOIC-16W_7.5x10.3mm_P1.27mm

Connections:
/A5: C5.1, C6.1, C7.1, C18.1, C19.1, C20.1, C21.1, C22.1, C23.1, R38.1, R46.2, TP9.1, U2.4, U4.5 (OUT), U5.3 (VDD), U9.5 (VCC), U10.16 (VDD), U11.16 (VDD), U12.14 (VDD), U13.14 (VDD), U14.2 (A2), U14.14 (VDD)
/AGND: C1.2, C2.2, D105.2 (A), D107.2 (A), J1.10, R8.2, R11.2, TP23.1, U1.33 (AGND)
/ARM: R42.1, U8.2, U9.6 (IN2), U12.3 (AY), U12.6 (B2)
/ARM_G: Q8.1 (G), R42.2, R43.1
/ARM_RESET: U13.11 (DY), U14.8 (C1), U14.9 (C2)
/B1_TAP: J1.4, R3.1
/B2_ISO: R1.1, U3.9 (D2), U3.10 (D2)
/B2_TAP: J1.3, U3.15 (D1), U3.16 (D1)
/B5: C13.1, C14.1, D116.2 (A), J3.1, L1.2, R23.1, R37.1, TP5.1, U6.6 (FEEDBACK)
/B11_TAP: D108.1 (A1), D109.2 (A), J1.5, R10.1
/BAD: R16.1, U13.1 (A1), U13.8 (C1), U14.4 (BY)
/BASE_RESET: U11.11 (MR), U13.3 (AY), U13.5 (B1)
/BATT_IN: D112.2 (A), J1.6
/BOOST: C12.2, U6.3 (BOOST)
/BRAKE_IN: D103.2 (A), R5.2, R6.1, U1.6 (GPIO4)
/BUS_DE: R30.1, U1.14 (GPIO10), U15.2 (~RE), U15.3 (DE)
/C11_TAP: J1.9, R7.1
/C14_TAP: J1.13, R5.1
/CLK32: U9.4 (Y), U10.11 (CLK)
/CLKOE: U7.3 (CLKOE), U8.4
/CNT_Q8: R40.1, U11.13 (Q8)
/CNT_Q13: R39.1, U11.2 (Q13)
/COUNT1_RESET: U10.12 (MR), U13.4 (BY)
/EXPIRED: R39.2, R40.2, R41.1, U13.9 (C2)
/FAULT_RESET: U13.10 (CY), U13.12 (D1)
/FUEL_ADC: C1.1, D104.2 (A), D105.1 (K), R9.2, U1.31 (GPIO26_ADC0)
/FUEL_DIV: R7.2, R8.1, R9.1
/GATE: D114.2 (A), Q5.1 (G), R31.2, R32.1, TP2.1
/HOLD_B: Q7.2 (B), R29.2, R35.1
/HOLD_JH: JP1.2 (B), R29.1
/HOLD_N: Q9.3 (C), R46.1, U13.13 (D2)
/HOLD_RAW: JP1.1 (A), R28.1, R44.1, U1.9 (GPIO6)
/IGN_A: R14.1, R15.1, U2.3
/IGN_B: Q6.2 (B), R33.2, R34.1
/IGN_LED_A: D110.1 (K), R13.2, U2.1
/IGN_POS: D109.1 (K), R13.1, R33.1
/IGN_Q: R19.1, U12.10 (CY), U13.2 (A2), U14.12 (D1)
/IGN_RC: C3.1, R15.2, R18.2, TP12.1, U14.1 (A1)
/ISO_EN: R24.1, TP20.1, U1.10 (GPIO7)
/ISO_EN_G: Q4.1 (G), R24.2, R25.1
/ISO_LED_A: R23.2, U3.4 (AN)
/ISO_LED_K: Q3.3 (D), U3.5 (CA)
/ISO_MID: Q3.2 (S), Q4.3 (D)
/ISO_PG_G: Q3.1 (G), R26.2, R27.1
/MON_B: Q9.1 (B), R44.2, R45.1
/NARM: U12.2 (A2), U12.4 (BY), U13.6 (B2)
/P3V3_SW: C8.1, C24.1, C25.1, D101.1 (K), D102.1 (K), D103.1 (K), D104.1 (K), D106.1 (K), J3.4, J5.1, JP3.1 (A), R21.1, R50.1, R51.1, R52.1, TP7.1, U1.36 (3V3), U15.8 (VCC), U16.2 (VCC)
/P12: C9.1, D112.1 (K), D113.1 (A1), D114.1 (K), Q5.3 (S), R22.1, R31.1, TP1.1
/PGND: BT1.2 (-), C3.2, C4.2, C5.2, C6.2, C7.2, C8.2, C9.2, C10.2, C11.2, C13.2, C14.2, C15.2, C16.2, C17.2, C18.2, C19.2, C20.2, C21.2, C22.2, C23.2, C24.2, C25.2, D108.2 (A2), D110.2 (A), D111.2 (A), D113.2 (A2), D115.2 (A), J1.2, J1.14, J3.2, J4.2, J5.2, JP4.2 (B), Q1.2 (E), Q2.2 (S), Q4.2 (S), Q6.1 (E), Q7.1 (E), Q9.2 (E), R2.2, R4.2, R6.2, R14.2, R17.2, R20.2, R25.2, R27.2, R28.2, R30.2, R34.2, R35.2, R36.2, R37.2, R41.2, R43.2, R45.2, TP21.1, TP22.1, U1.3 (GND), U1.8 (GND), U1.13 (GND), U1.18 (GND), U1.23 (GND), U1.28 (GND), U1.38 (GND), U2.2, U4.2 (GND), U5.1 (GND), U6.4 (GND), U7.2 (GND), U8.3 (GND), U9.1 (IN1), U9.2 (GND), U10.8 (VSS), U11.8 (VSS), U12.7 (VSS), U12.12 (D1), U12.13 (D2), U13.7 (VSS), U14.7 (VSS), U15.5 (GND), U16.5 (GND), U16.6 (GND), U16.7 (GND), U16.8 (GND), U16.9 (GND), U16.10 (GND), U16.11 (GND), U16.12 (GND), U16.13 (GND)
/PGOOD: R26.1, TP17.1, U5.2 (~RESET), U14.5 (B1), U14.6 (B2)
/P_AON: C4.1, D111.1 (K), R22.2, TP8.1, U4.1 (IN)
/QH_C: Q7.3 (C), Q8.2 (S)
/QUAL_N: U12.8 (C1), U12.9 (C2), U14.3 (AY)
/QUAL_N_REPORT: Q2.3 (D), R21.2, U1.7 (GPIO5)
/REP_G: Q2.1 (G), R19.2, R20.1
/RESET_N: U12.5 (B1), U14.10 (CY), U14.13 (D2)
/RS485_A: J1.1, R47.2, R49.1, U15.6 (A)
/RS485_B: J1.7, JP2.2 (B), R48.1, U15.7 (B)
/RS485_BIAS_HI: JP3.2 (B), R47.1
/RS485_BIAS_LO: JP4.1 (A), R48.2
/RS485_TERM: JP2.1 (A), R49.2
/RST_B: Q1.1 (B), R16.2, R17.1
/RST_C: Q1.3 (C), R18.1
/RTC_INT: R52.2, U1.29 (GPIO22), U16.3 (~INT/SQW)
/RTC_SCL: R51.2, U1.27 (GPIO21), U16.16 (SCL)
/RTC_SDA: R50.2, U1.26 (GPIO20), U16.15 (SDA)
/RTC_VBAT: BT1.1 (+), U16.14 (VBAT)
/RUN: J4.1, U1.30 (RUN)
/SD_CS: J5.4, U1.22 (GPIO17)
/SD_MISO: J5.3, U1.21 (GPIO16)
/SD_MOSI: J5.6, U1.25 (GPIO19)
/SD_SCK: J5.5, U1.24 (GPIO18)
/SET_N: U12.1 (A1), U14.11 (DY)
/SINK: Q6.3 (C), Q8.3 (D), R32.2
/SPARE_GP11: J3.6, U1.15 (GPIO11)
/SPARE_GP12: J3.5, U1.16 (GPIO12)
/SPARE_GP13: J3.3, U1.17 (GPIO13)
/SUPPLY_ADC: C2.1, D106.2 (A), D107.1 (K), R12.2, U1.32 (GPIO27_ADC1)
/SUPPLY_DIV: R10.2, R11.1, R12.1
/SW: C12.1, D115.1 (K), L1.1, TP4.1, U6.1 (SWITCH)
/TACH_IN: D102.2 (A), R3.2, R4.1, U1.5 (GPIO3)
/UART1_RX: U1.12 (GPIO9), U15.1 (RO)
/UART1_TX: U1.11 (GPIO8), U15.4 (DI)
/UCLK_Q14: U10.3 (Q14), U11.10 (CLK)
/VCLK: C15.1, C16.1, C17.1, R38.2, U7.4 (VDD), U8.5 (VCC)
/VIN_SW: C10.1, C11.1, Q5.2 (D), R36.1, TP3.1, U6.2 (VIN)
/VSS_IN: D101.2 (A), R1.2, R2.1, U1.4 (GPIO2)
/VSYS: D116.1 (K), TP6.1, U1.39 (VSYS)
/XO_OUT: U7.1 (CLKOUT), U9.3 (IN0)

Notes on the sheet:
TEST POINTS AND GROUND LOOPS - REV_A_INTERFACES S5.3, delta D8
Onboard switched power
X6 RESOLVED: QUALIFIED IGNITION, A5 DOMAIN - CUTOFF_MARGIN_REVIEW S2
Retain 1.5KE20A by choice, not because a 60 V low-leakage QP is absent. SQD50P06-15L has 50 uA max IDSS at 125 C and -60 V. The inherited 1.5KE30A screens 43.81 V at 85 C: 1.19 V below LM2678 absolute, 3.81 V above operating. It also requires a redesigned A5 clamp. Selected 1.5KE20A screens 29.20 V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
GP0/GP1, GP14/GP15 and GP28 are deliberately unconnected. GP20/GP21 are I2C0 SDA/SCL and GP22 INT/SQW for the DS3231 (D-RTC-14). GP7 is now ISO_EN, the B2 isolation enable, confirmed free in S1. GP8/GP9 (UART1) and GP10 (tied DE//RE) drive onboard RS-485. GP13 is offered on the trimmed J3 spare/pow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
The fitted cell returned the ignition LED cathode to the B16 cluster conductor with nothing in series, putting 4.7-5.8 mA of signal- dependent current through the node both ADC channels reference, which REV_A_INTERFACES S4 says must never become a power return. D5 and that return cannot both stand.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
Pico W pin map
The opto LED return - R06-REV-2 decided
What is still open - none of it a layout blocker
Vehicle inputs: one switch, four justified bypasses
Reuses the existing power candidate as DESIGN.md S3 lists it (D-POWER-02), with the reviewed deltas D7 and D13 and the LRA-02 component selections. The LM2678, its TVS role, bulk capacitors, boost cap, inductor value and both Schottky positions all have in-service precedent on the keyless board in 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
Independent cutoff - what it does and does not cover
HOLD driver and the cutoff path
PICO W - REV_A_INTERFACES S1 Rev A column
INDEPENDENT CLOCK BLOCK - CUTOFF_MARGIN_REVIEW S1
SD and expansion
SPI0 at 12 MHz on switched 3V3 only (GP16 MISO, GP17 CS, GP18 SCK, GP19 MOSI). D6 bulk is now a selected 47 uF: a 200 mA write spike for 1 ms inside 100 mV of droop needs 2 uF, so this is an order of margin without an oversized can. Any move of this module to a 5 V rail re-opens the MISO clearance 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
RS-485 - keyless circuit; bias and termination OPEN by default
ONBOARD SWITCHED POWER - power/DESIGN.md S3, deltas D7 and D13, X7 entry clamp resolved
X7 SECOND STAGE: ALWAYS-ON A5 SUPPLY AND SUPERVISOR - CUTOFF_MARGIN_REVIEW S3 + LAYOUT_CLOSURE S3
HOLD DRIVER - delta D2
Classified in full in LRA12_HANDOFF.md. In short: ORDER GATE ASSR-601JV availability (fallback AQY221N2S specified, strictly smaller, same keepout); capacitor approval-sheet bias/aging/IR data. BRING-UP A5 ground current below 100 uA load; hot leakage of QP, QI, QH, QMON, QS, QREPORT and the opto; 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
NOTES - LRA-12 electrical closure
Test points and ground loops
IGNITION OPTO CELL, VEHICLE SIDE - AS_BUILT S3.4; LED return moved to PGND
X1 ENABLE: GPIO PLUS HARDWARE PGOOD PERMISSION - LAYOUT_CLOSURE S4
Five fitted cells, carried forward with no value changed (AS_BUILT S2). B2 is the only branch energized with the key out - 4.669 V open circuit, 4.140 V loaded, drawing 140.8 uA of which 109.2 uA was being back-fed into the unpowered 3V3 rail through a forward-biased clamp. It gets the series switc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
LRA-12 - what changed, and the one thing to read first
Nominal 2048 s from qualified ignition loss, on its own always-on supply and its own clock. The Pico cannot refresh it with HOLD, resets, network traffic or watchdog servicing; releasing HOLD disarms it, and only a qualified ignition assertion can grant it again. Reset dominates set in the settled 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
X8 RESOLVED: INDEPENDENT MAXIMUM-ON CUTOFF, 2048 s - MAX_ON_CUTOFF
GP6 HOLD_RAW with a 47k external pulldown and the JH MAINTENANCE link. Firmware latches it LOW before output enable; 4 mA drive, 2.6 V loaded qualification target. QS is the series interruption the independent timer uses: drain to SINK, source to the QH collector, body diode blocking the sink direc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
VEHICLE INPUTS - AS_BUILT S2, ratios and clamps unchanged; B2 series isolation fitted, other four branches bypassed
This is the LRA-06 capture with its eight electrical placeholders resolved. Every populated part now carries a checked footprint and no dashed NOT SELECTED body remains. The decisions, their calculations and the residual gates are in power/LAYOUT_CLOSURE.md and LRA12_HANDOFF.md; read those before c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
Twenty-five test loops. Three separate ground loops follow the keyless pattern: buck, Pico and harness end, the last on the bonded B16/AGND sense node. J4 shorts RUN to GND for a reset without cutting power. TP_PAON is where the <=28 V protected-rail criterion is measured. TP_GATE against TP_P12 is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
Voltage envelope - LRA-12R decision
SPARE GP13 / SWITCHED POWER AND RESET
SD - AS_BUILT S3.5, delta D6
REAL-TIME CLOCK - DS3231 on the board (D-RTC-14)
DS3231SN# (TCXO, -40 to +85 C) on I2C0: GP20 SDA, GP21 SCL, GP22 INT/SQW. VCC and all three pull-ups on switched 3V3 only, so nothing feeds the Pico while it is off; the chip runs from the cell then (about 3 uA). Cell: BR2032 (rated to +85 C, a parked car exceeds CR2032 ratings) in a Keystone 3034 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

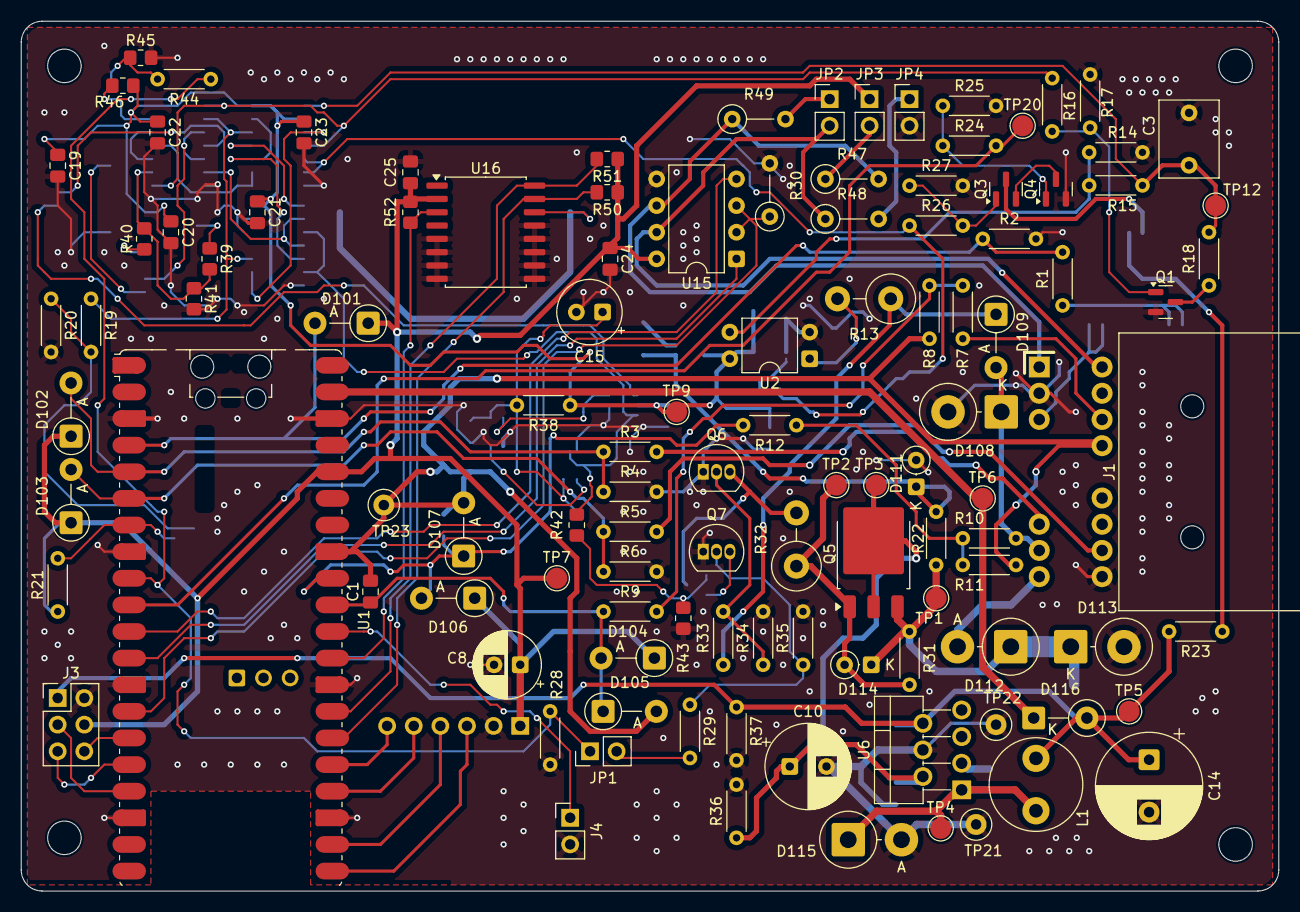
[picture p6: board accord-logger.kicad_pcb from above]

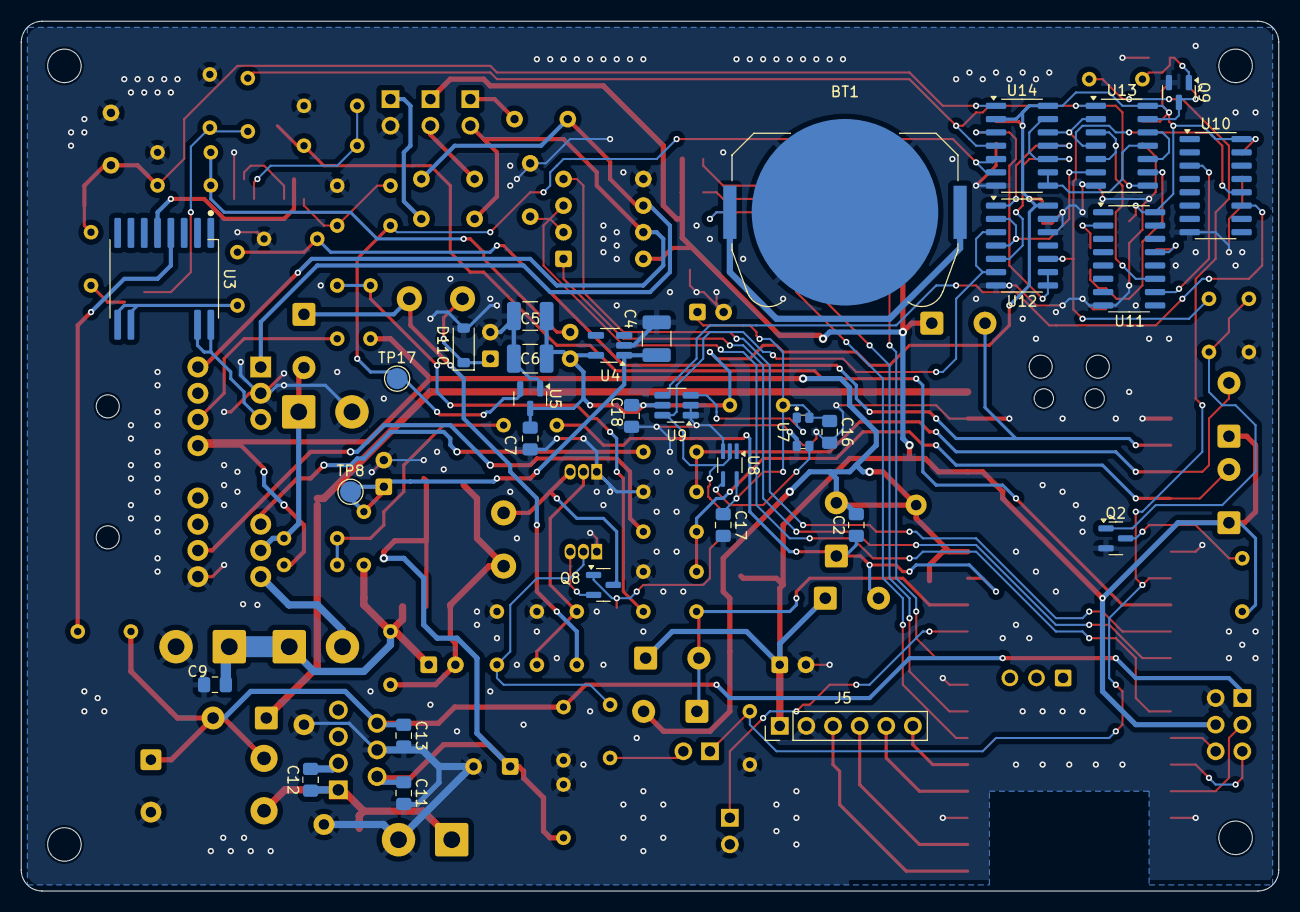
[picture p7: board accord-logger.kicad_pcb from below]

Board: 2 copper layers, 120.0 x 83.0 mm, 147 parts (31 on the bottom side), 89 nets.

Other parts of the board:
H1, H2, H3, H4: M3 mounting hole; MountingHole_3.2mm_M3
