jgazeley/accord/keyless/hardware/hondaPico.kicad_pcb

## KiCad design keyless/hardware/hondaPico.kicad_pcb (2026-10-28)

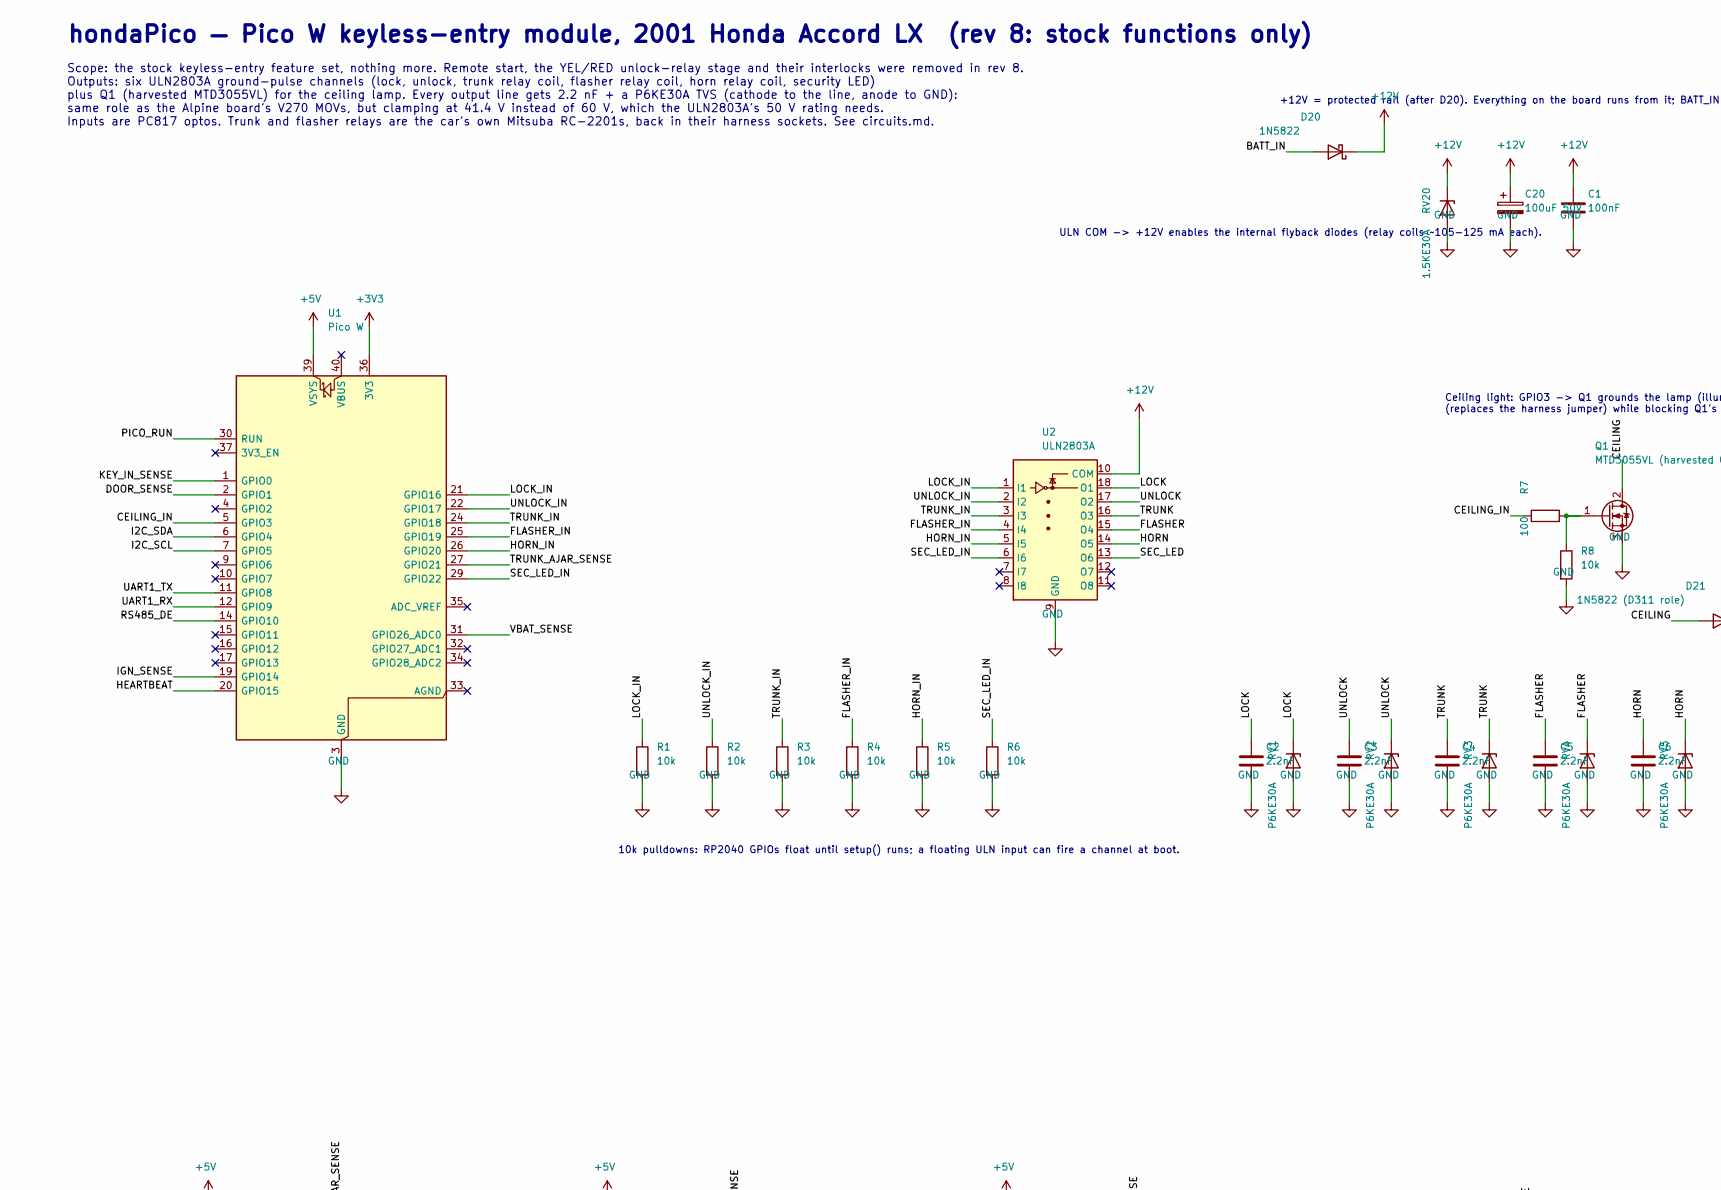
[picture p8: schematic hondaPico.kicad_sch, hondaPico keyless-entry module, part in row 1, column 1]

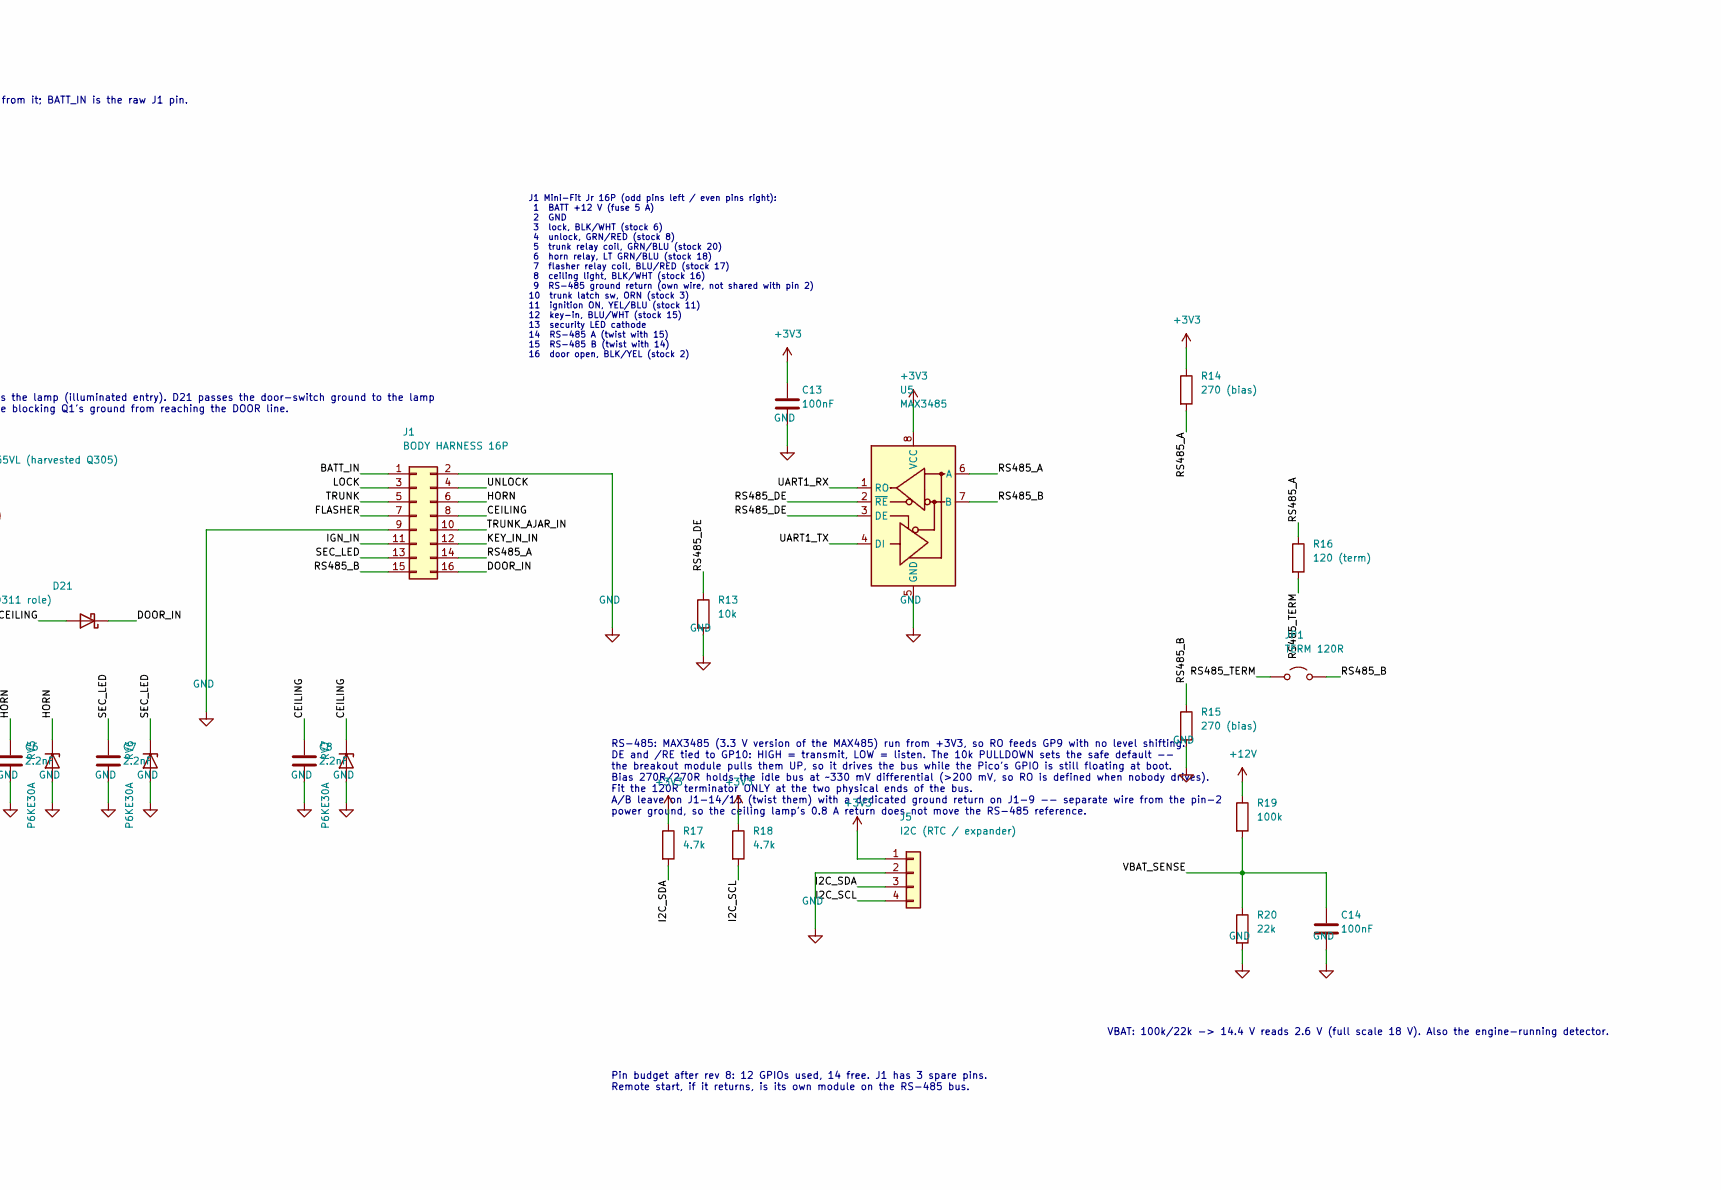
[picture p9: schematic hondaPico.kicad_sch, hondaPico keyless-entry module, part in row 1, column 2]

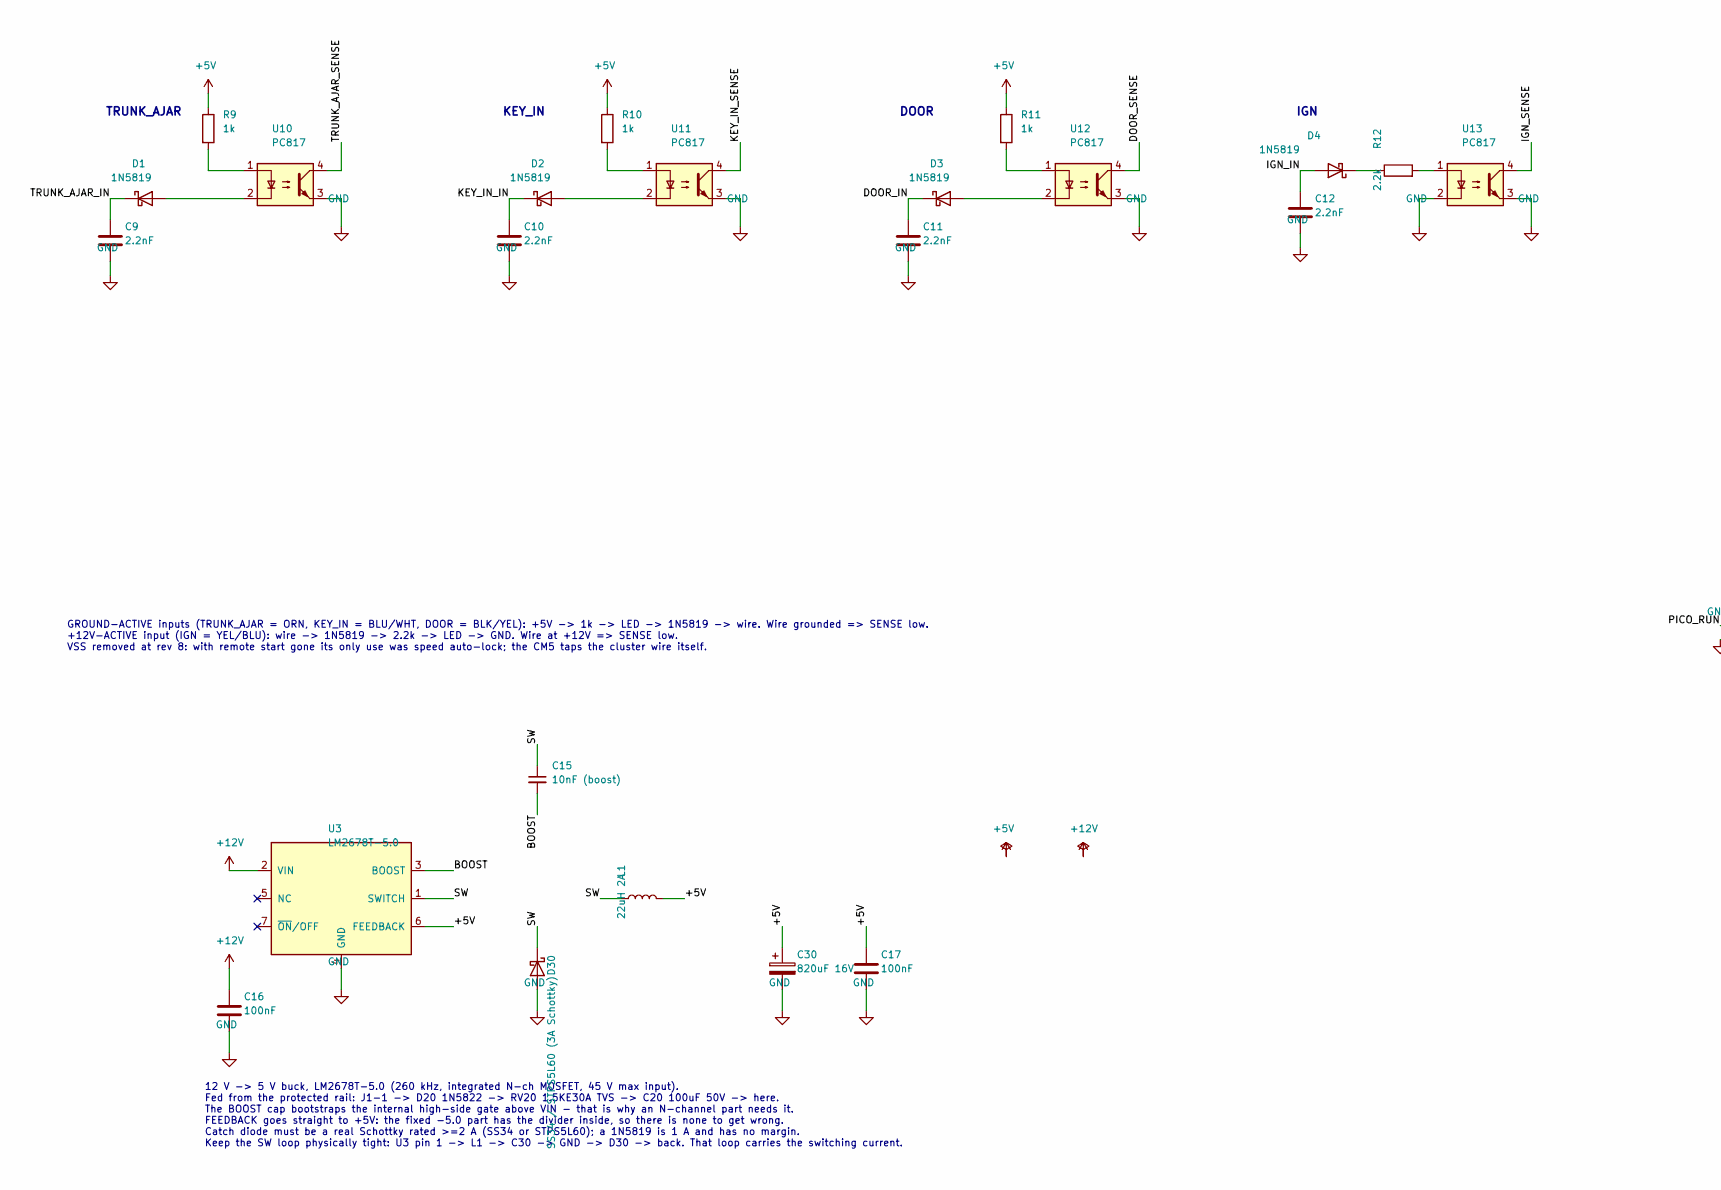
[picture p10: schematic hondaPico.kicad_sch, hondaPico keyless-entry module, part in row 2, column 1]

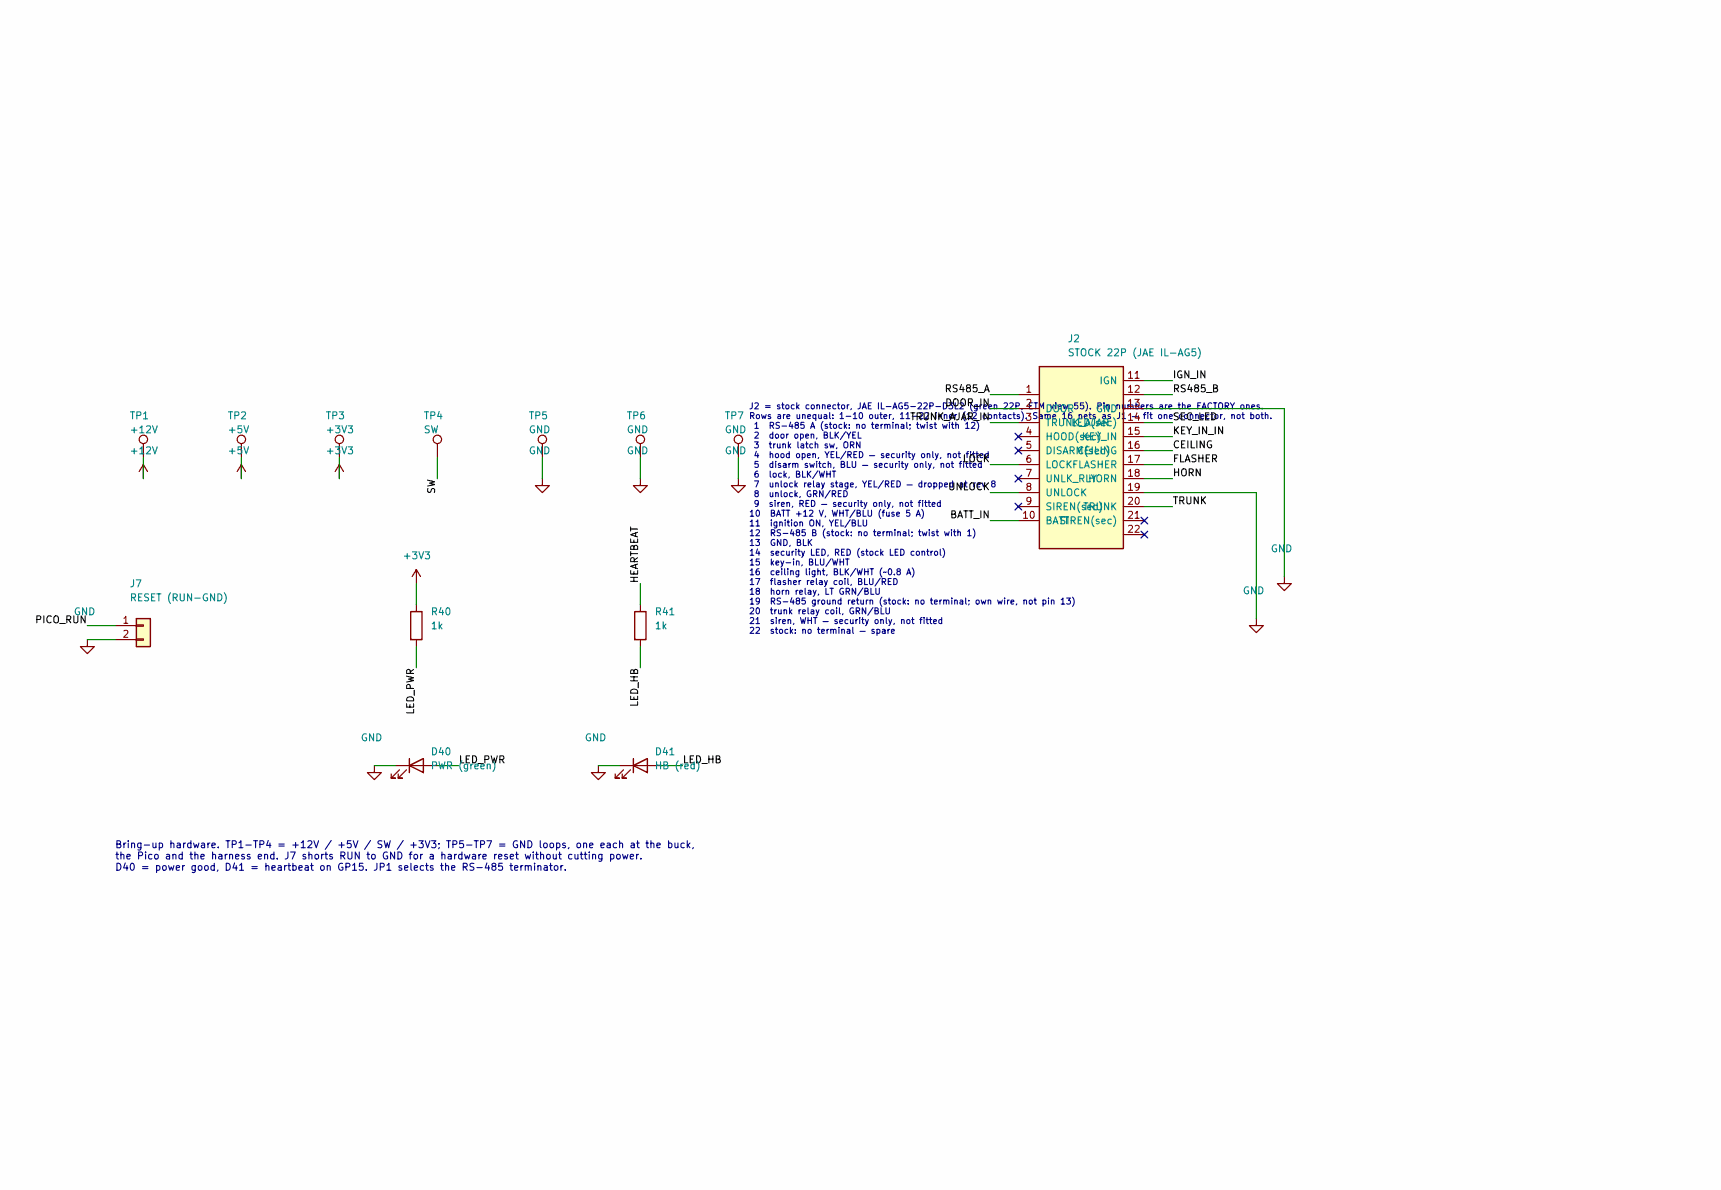
[picture p11: schematic hondaPico.kicad_sch, hondaPico keyless-entry module, part in row 2, column 2]

Parts:
C1, C13, C14, C16, C17: 100nF; C_0805_2012Metric_Pad1.18x1.45mm_HandSolder
C2, C3, C4, C5, C6, C7, C8, C9, C10, C11, C12: 2.2nF; C_0805_2012Metric_Pad1.18x1.45mm_HandSolder
C15: 10nF (boost); C_Disc_D7.5mm_W5.0mm_P5.00mm
C20: 100uF 50V; CP_Radial_D8.0mm_P3.50mm
C30: 820uF 16V; CP_Radial_D10.0mm_P5.00mm
D1, D2, D3, D4: 1N5819; D_DO-41_SOD81_P5.08mm_Vertical_AnodeUp
D20: 1N5822; D_DO-201AD_P5.08mm_Vertical_AnodeUp
D21: 1N5822 (D311 role); D_DO-201AD_P5.08mm_Vertical_AnodeUp
D30: SS34 / STPS5L60 (3A Schottky); D_DO-201AD_P5.08mm_Vertical_AnodeUp
D40: PWR (green); LED_D3.0mm
D41: HB (red); LED_D3.0mm
J1: BODY HARNESS 16P; Molex_Mini-Fit_Jr_5569-16A2_2x08_P4.20mm_Horizontal
J2: STOCK 22P (JAE IL-AG5); JAE_IL-AG5-22P-D3L2
J5: I2C (RTC / expander); PinHeader_1x04_P2.54mm_Vertical
J7: RESET (RUN-GND); PinHeader_1x02_P2.54mm_Vertical
JP1: TERM 120R; PinHeader_1x02_P2.54mm_Vertical
L1: 22uH 2A; L_Radial_D10.0mm_P5.00mm_Fastron_07P
Q1: MTD3055VL (harvested Q305); TO-252-2
R1, R2, R3, R4, R5, R6, R8, R13: 10k; R_Axial_DIN0207_L6.3mm_D2.5mm_P5.08mm_Vertical
R7: 100; R_Axial_DIN0207_L6.3mm_D2.5mm_P5.08mm_Vertical
R9, R10, R11, R40, R41: 1k; R_Axial_DIN0207_L6.3mm_D2.5mm_P5.08mm_Vertical
R12: 2.2k; R_Axial_DIN0207_L6.3mm_D2.5mm_P5.08mm_Vertical
R14, R15: 270 (bias); R_Axial_DIN0207_L6.3mm_D2.5mm_P5.08mm_Vertical
R16: 120 (term); R_Axial_DIN0207_L6.3mm_D2.5mm_P5.08mm_Vertical
R17, R18: 4.7k; R_Axial_DIN0207_L6.3mm_D2.5mm_P5.08mm_Vertical
R19: 100k; R_Axial_DIN0207_L6.3mm_D2.5mm_P5.08mm_Vertical
R20: 22k; R_Axial_DIN0207_L6.3mm_D2.5mm_P5.08mm_Vertical
RV1, RV2, RV3, RV4, RV5, RV6, RV7: P6KE30A; D_DO-15_P5.08mm_Vertical_KathodeUp
RV20: 1.5KE30A; D_DO-201AD_P5.08mm_Vertical_KathodeUp
TP1: +12V; TestPoint_Loop_D2.50mm_Drill1.0mm
TP2: +5V; TestPoint_Loop_D2.50mm_Drill1.0mm
TP3: +3V3; TestPoint_Loop_D2.50mm_Drill1.0mm
TP4: SW; TestPoint_Loop_D2.50mm_Drill1.0mm
TP5, TP6, TP7: GND; TestPoint_Loop_D2.50mm_Drill1.0mm
U1: Pico W; RaspberryPi_Pico_Common_SMD
U2: ULN2803A; DIP-18_W7.62mm
U3: LM2678T-5.0; TO-220-7_P2.54x3.7mm_StaggerOdd_Lead3.8mm_Vertical
U5: MAX3485; DIP-8_W7.62mm
U10, U11, U12, U13: PC817; DIP-4_W7.62mm

Connections:
+3V3: C13.1, J5.1, R14.1, R17.1, R18.1, R40.1, TP3.1, U1.36 (3V3), U5.8 (VCC)
+5V: C17.1, C30.1, L1.2, R9.1, R10.1, R11.1, TP2.1, U1.39 (VSYS), U3.6 (FEEDBACK)
+12V: C1.1, C16.1, C20.1, D20.1 (K), R19.1, RV20.1 (K), TP1.1, U2.10 (COM), U3.2 (VIN)
/BATT_IN: D20.2 (A), J1.1, J2.10 (BATT)
/BOOST: C15.2, U3.3 (BOOST)
/CEILING: C8.1, D21.2 (A), J1.8, J2.16 (CEILING), Q1.2 (D), RV7.1 (K)
/CEILING_IN: R7.1, U1.5 (GPIO3)
/DOOR_IN: C11.1, D3.1 (K), D21.1 (K), J1.16, J2.2 (DOOR)
/DOOR_SENSE: U1.2 (GPIO1), U12.4
/FLASHER: C5.1, J1.7, J2.17 (FLASHER), RV4.1 (K), U2.15 (O4)
/FLASHER_IN: R4.1, U1.25 (GPIO19), U2.4 (I4)
/HEARTBEAT: R41.1, U1.20 (GPIO15)
/HORN: C6.1, J1.6, J2.18 (HORN), RV5.1 (K), U2.14 (O5)
/HORN_IN: R5.1, U1.26 (GPIO20), U2.5 (I5)
/I2C_SCL: J5.4, R18.2, U1.7 (GPIO5)
/I2C_SDA: J5.3, R17.2, U1.6 (GPIO4)
/IGN_IN: C12.1, D4.2 (A), J1.11, J2.11 (IGN)
/IGN_SENSE: U1.19 (GPIO14), U13.4
/KEY_IN_IN: C10.1, D2.1 (K), J1.12, J2.15 (KEY_IN)
/KEY_IN_SENSE: U1.1 (GPIO0), U11.4
/LED_HB: D41.2 (A), R41.2
/LED_PWR: D40.2 (A), R40.2
/LOCK: C2.1, J1.3, J2.6 (LOCK), RV1.1 (K), U2.18 (O1)
/LOCK_IN: R1.1, U1.21 (GPIO16), U2.1 (I1)
/PICO_RUN: J7.1, U1.30 (RUN)
/RS485_A: J1.14, J2.1, R14.2, R16.1, U5.6 (A)
/RS485_B: J1.15, J2.12, JP1.2 (B), R15.1, U5.7 (B)
/RS485_DE: R13.1, U1.14 (GPIO10), U5.2 (~RE), U5.3 (DE)
/RS485_TERM: JP1.1 (A), R16.2
/SEC_LED: C7.1, J1.13, J2.14 (LED(sec)), RV6.1 (K), U2.13 (O6)
/SEC_LED_IN: R6.1, U1.29 (GPIO22), U2.6 (I6)
/SW: C15.1, D30.1 (K), L1.1, TP4.1, U3.1 (SWITCH)
/TRUNK: C4.1, J1.5, J2.20 (TRUNK), RV3.1 (K), U2.16 (O3)
/TRUNK_AJAR_IN: C9.1, D1.1 (K), J1.10, J2.3 (TRUNK_AJAR)
/TRUNK_AJAR_SENSE: U1.27 (GPIO21), U10.4
/TRUNK_IN: R3.1, U1.24 (GPIO18), U2.3 (I3)
/UART1_RX: U1.12 (GPIO9), U5.1 (RO)
/UART1_TX: U1.11 (GPIO8), U5.4 (DI)
/UNLOCK: C3.1, J1.4, J2.8 (UNLOCK), RV2.1 (K), U2.17 (O2)
/UNLOCK_IN: R2.1, U1.22 (GPIO17), U2.2 (I2)
/VBAT_SENSE: C14.1, R19.2, R20.1, U1.31 (GPIO26_ADC0)
GND: C1.2, C2.2, C3.2, C4.2, C5.2, C6.2, C7.2, C8.2, C9.2, C10.2, C11.2, C12.2, C13.2, C14.2, C16.2, C17.2, C20.2, C30.2, D30.2 (A), D40.1 (K), D41.1 (K), J1.2, J1.9, J2.13 (GND), J2.19, J5.2, J7.2, Q1.3 (S), R1.2, R2.2, R3.2, R4.2, R5.2, R6.2, R8.2, R13.2, R15.2, R20.2, RV1.2 (A), RV2.2 (A), RV3.2 (A), RV4.2 (A), RV5.2 (A), RV6.2 (A), RV7.2 (A), RV20.2 (A), TP5.1, TP6.1, TP7.1, U1.3 (GND), U1.8 (GND), U1.13 (GND), U1.18 (GND), U1.23 (GND), U1.28 (GND), U1.38 (GND), U2.9 (GND), U3.4 (GND), U5.5 (GND), U10.3, U11.3, U12.3, U13.2, U13.3
unnamed: D1.2 (A), U10.2
unnamed: D2.2 (A), U11.2
unnamed: D3.2 (A), U12.2
unnamed: D4.1 (K), R12.1
unnamed: Q1.1 (G), R7.2, R8.1
unnamed: R9.2, U10.1
unnamed: R10.2, U11.1
unnamed: R11.2, U12.1
unnamed: R12.2, U13.1

Notes on the sheet:
+12V = protected rail (after D20). Everything on the board runs from it; BATT_IN is the raw J1 pin.
Ceiling light: GPIO3 -> Q1 grounds the lamp (illuminated entry). D21 passes the door-switch ground to the lamp (replaces the harness jumper) while blocking Q1's ground from reaching the DOOR line.
J1 Mini-Fit Jr 16P (odd pins left / even pins right): 1 BATT +12 V (fuse 5 A) 2 GND 3 lock, BLK/WHT (stock 6) 4 unlock, GRN/RED (stock 8) 5 trunk relay coil, GRN/BLU (stock 20) 6 horn relay, LT GRN/BLU (stock 18) 7 flasher relay coil, BLU/RED (stock 17) 8 ceiling light, BLK/WHT (stock 16) 9 RS-485 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
J2 = stock connector, JAE IL-AG5-22P-D3L2 (green 22P, ETM view 55). Pin numbers are the FACTORY ones. Rows are unequal: 1-10 outer, 11-22 inner (12 contacts). Same 16 nets as J1 — fit one connector, not both. 1 RS-485 A (stock: no terminal; twist with 12) 2 door open, BLK/YEL 3 trunk latch sw, ORN 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
TRUNK_AJAR
KEY_IN
DOOR
IGN
RS-485: MAX3485 (3.3 V version of the MAX485) run from +3V3, so RO feeds GP9 with no level shifting. DE and /RE tied to GP10: HIGH = transmit, LOW = listen. The 10k PULLDOWN sets the safe default -- the breakout module pulls them UP, so it drives the bus while the Pico's GPIO is still floating at b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
Bring-up hardware. TP1-TP4 = +12V / +5V / SW / +3V3; TP5-TP7 = GND loops, one each at the buck, the Pico and the harness end. J7 shorts RUN to GND for a hardware reset without cutting power. D40 = power good, D41 = heartbeat on GP15. JP1 selects the RS-485 terminator.
12 V -> 5 V buck, LM2678T-5.0 (260 kHz, integrated N-ch MOSFET, 45 V max input). Fed from the protected rail: J1-1 -> D20 1N5822 -> RV20 1.5KE30A TVS -> C20 100uF 50V -> here. The BOOST cap bootstraps the internal high-side gate above VIN - that is why an N-channel part needs it. FEEDBACK goes stra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
hondaPico — Pico W keyless-entry module, 2001 Honda Accord LX (rev 8: stock functions only)
Scope: the stock keyless-entry feature set, nothing more. Remote start, the YEL/RED unlock-relay stage and their interlocks were removed in rev 8. Outputs: six ULN2803A ground-pulse channels (lock, unlock, trunk relay coil, flasher relay coil, horn relay coil, security LED) plus Q1 (harvested MTD30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
10k pulldowns: RP2040 GPIOs float until setup() runs; a floating ULN input can fire a channel at boot.
ULN COM -> +12V enables the internal flyback diodes (relay coils ~105-125 mA each).
GROUND-ACTIVE inputs (TRUNK_AJAR = ORN, KEY_IN = BLU/WHT, DOOR = BLK/YEL): +5V -> 1k -> LED -> 1N5819 -> wire. Wire grounded => SENSE low. +12V-ACTIVE input (IGN = YEL/BLU): wire -> 1N5819 -> 2.2k -> LED -> GND. Wire at +12V => SENSE low. VSS removed at rev 8: with remote start gone its only use wa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
VBAT: 100k/22k -> 14.4 V reads 2.6 V (full scale 18 V). Also the engine-running detector.
Pin budget after rev 8: 12 GPIOs used, 14 free. J1 has 3 spare pins. Remote start, if it returns, is its own module on the RS-485 bus.
