jgazeley/accord/keyless/hardware/hondaPico.kicad_pcb

## KiCad design keyless/hardware/hondaPico.kicad_pcb (continued)

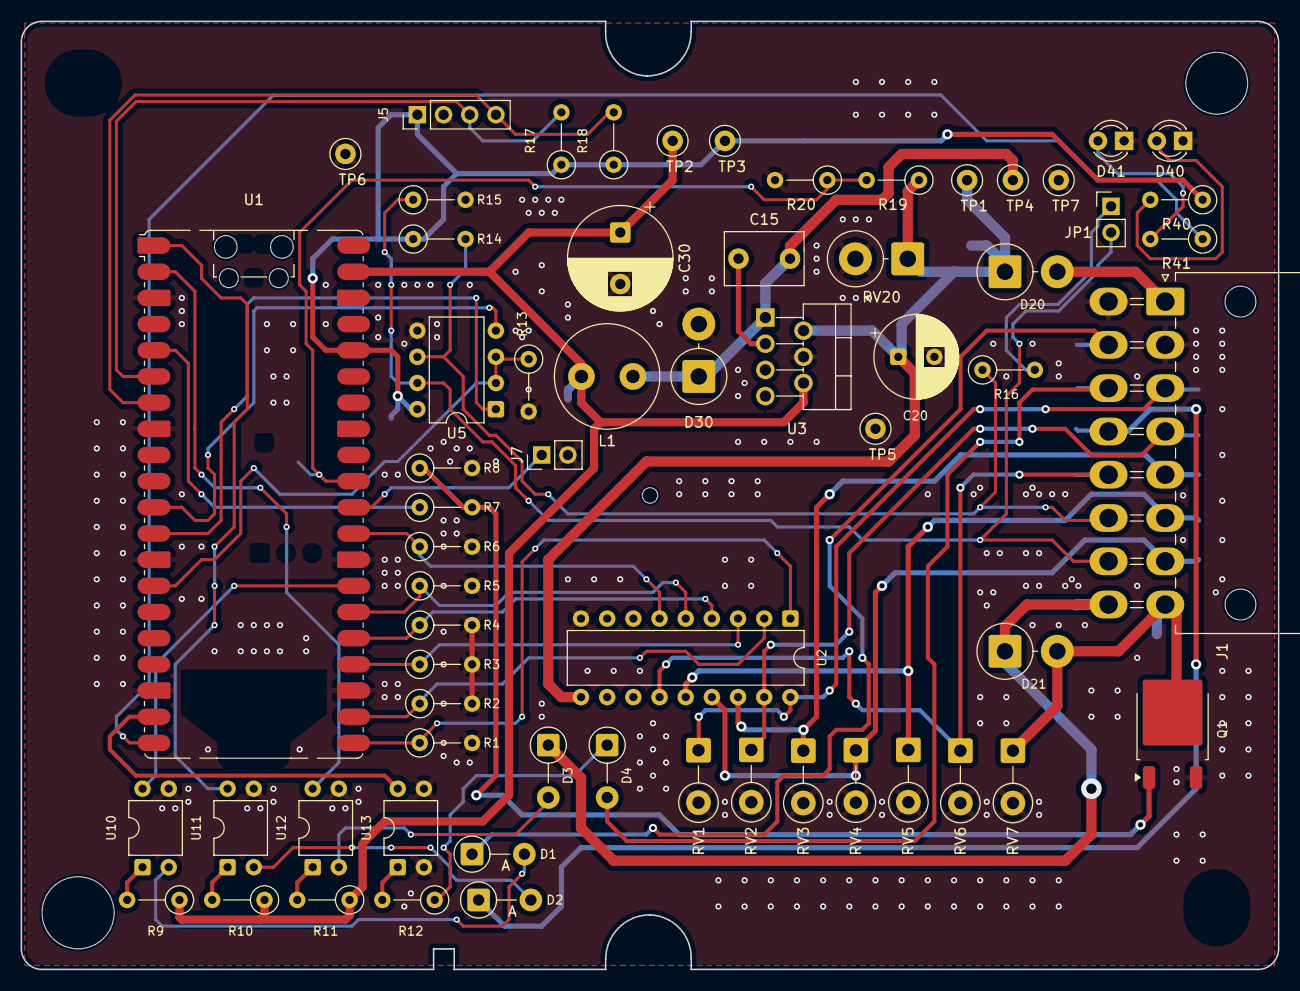
[picture p12: board hondaPico.kicad_pcb from above]

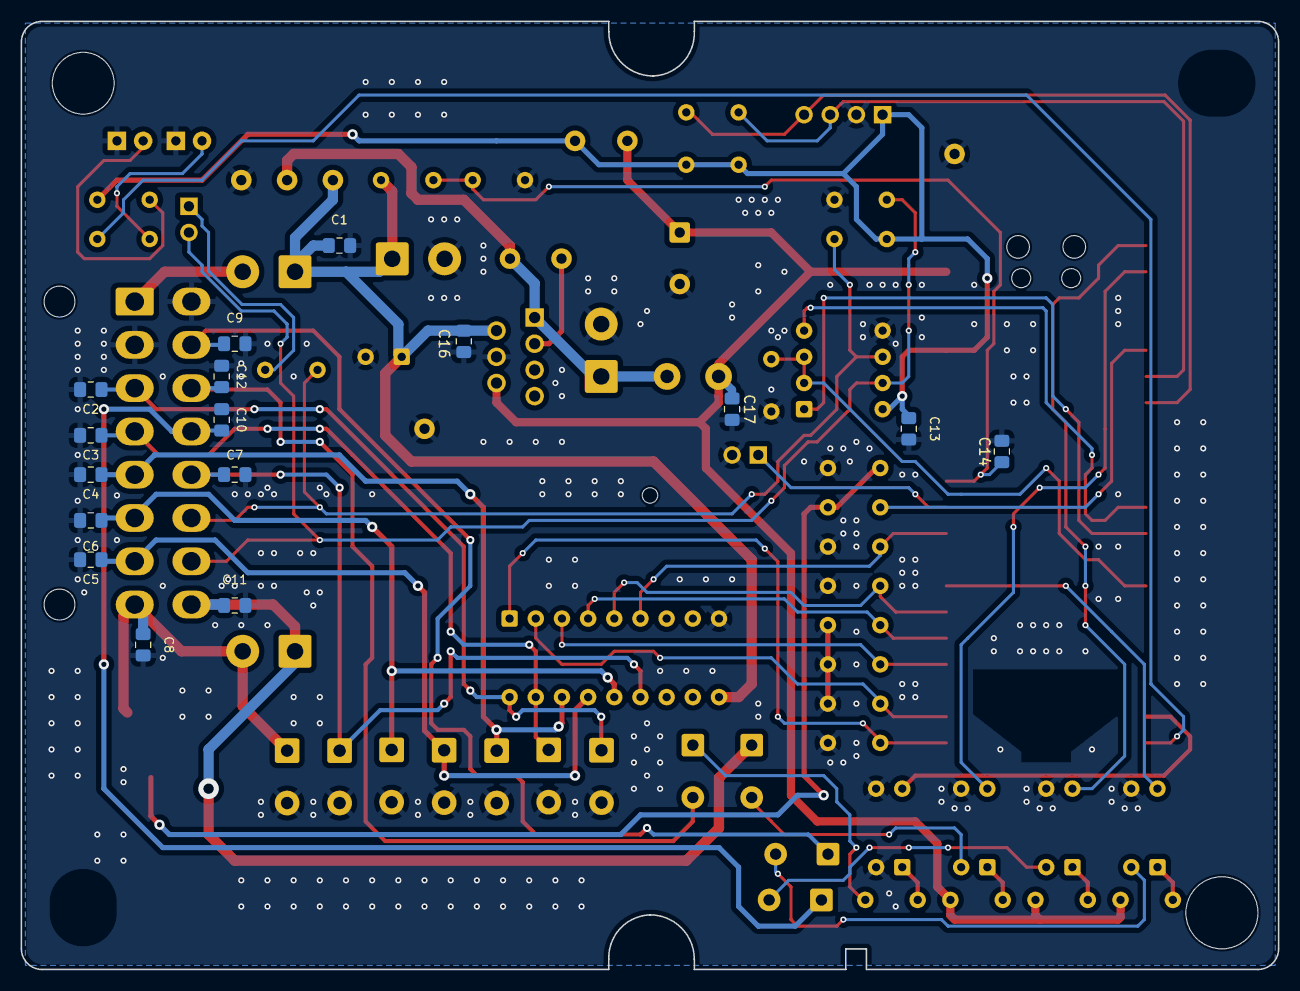
[picture p13: board hondaPico.kicad_pcb from below]

Board: 2 copper layers, 122.0 x 92.0 mm, 84 parts (16 on the bottom side), 51 nets.

Other parts of the board:
H1, H2, H3, H4, H5: ENCLOSURE POST
