jgazeley/accord/logger/hardware/kicad/tools/gen_logger_sch.py

"""Generate the Rev A logger schematic and its BOM from one parts table.

LRA-06 captured the fitted circuit plus the already-decided Rev A deltas and
left eight electrical placeholders, X1-X8. LRA-12 resolves all eight and this
generator now produces the completed design, not a capture with holes. Every
part carries a footprint; nothing dashed remains.

Sources:
  REV_A_INTERFACES.md  S1 pin map, S4 grounds, S5 connectors/test points,
                       S7 deltas D1-D15, S3.4 for the D4 requirement
  AS_BUILT.md          S2 circuit matrix, S3.4/S3.4a ignition, S3.5 SD
  power/DESIGN.md      S3 component-level connection list
  power/CUTOFF_MARGIN_REVIEW.md  S1 clock block, S2 qualified IGN / reset /
                       QREPORT, S3 the always-on supply boundary
  power/MAX_ON_CUTOFF.md         latch/counter connection table, the HOLD-path
                       permission switch and the QMON sense network
  power/COMPONENT_MARGIN_CLOSURE.md and BOM_DELTA.csv   exact passive and
                       semiconductor selections
  isolation/B2_ISOLATION.md      the ASSR-601JV candidate, corrected here
  power/LAYOUT_CLOSURE.md        the LRA-12 decisions, with their calculations
  keyless/hardware/hondaPico.kicad_sch   in-service footprint conventions and
                       the connector family (D-REUSE-02, D-POWER-03)

Connections are made by placing a net label exactly on each pin, so no wire
geometry has to be solved and the netlist is checkable directly.
"""
import csv
import os
import sys

sys.path.insert(0, os.path.dirname(os.path.abspath(__file__)))
import schgen

OUTDIR = sys.argv[1]
# Since October 30, 2026 the owner edits accord-logger.kicad_sch by hand
# and that file is the master. Regenerating would discard those edits, so
# refuse unless the caller says --force (for a scratch directory, say).
if (os.path.exists(os.path.join(OUTDIR, 'accord-logger.kicad_sch'))
        and '--force' not in sys.argv[2:]):
    sys.exit('accord-logger.kicad_sch exists and is hand-edited (the master '
             'since 2026-10-30); refusing to overwrite it. Pass --force only '
             'for a scratch copy.')
CUSTOM = OUTDIR + '/Custom.kicad_sym'

# ---------------------------------------------------------------- footprints
# Axial parts take the keyless board's in-service vertical mountings rather
# than the horizontal ones LRA-06 guessed. The first reason is that the same
# convention is already soldered and running in this car (D-REUSE-02). The
# second is area: fp_area.py measures the 62 axial parts at 1588 mm2 of
# courtyard vertical against 2208 mm2 horizontal, so this choice is worth
# 620 mm2, 6.5 % of an 80 x 120 board.
FP_R = 'Resistor_THT:R_Axial_DIN0207_L6.3mm_D2.5mm_P5.08mm_Vertical'
FP_R_HALFW = 'Resistor_THT:R_Axial_DIN0414_L11.9mm_D4.5mm_P5.08mm_Vertical'
FP_C_DISC = 'Capacitor_THT:C_Disc_D5.0mm_W2.5mm_P5.00mm'
FP_C_FILM = 'Capacitor_THT:C_Rect_L7.2mm_W2.5mm_P5.00mm_FKS2_FKP2_MKS2_MKP2'
FP_C_1210 = 'Capacitor_SMD:C_1210_3225Metric_Pad1.33x2.70mm_HandSolder'
FP_CP_TANT_D = 'Capacitor_Tantalum_SMD:CP_EIA-7343-31_Kemet-D_HandSolder'
FP_DO41_A = 'Diode_THT:D_DO-41_SOD81_P5.08mm_Vertical_AnodeUp'
FP_DO41_K = 'Diode_THT:D_DO-41_SOD81_P5.08mm_Vertical_KathodeUp'
FP_DO35_K = 'Diode_THT:D_DO-35_SOD27_P2.54mm_Vertical_KathodeUp'
FP_DO35_A = 'Diode_THT:D_DO-35_SOD27_P2.54mm_Vertical_AnodeUp'
FP_DO201_K = 'Diode_THT:D_DO-201AD_P5.08mm_Vertical_KathodeUp'
FP_DO201_A = 'Diode_THT:D_DO-201AD_P5.08mm_Vertical_AnodeUp'
FP_TP = 'TestPoint:TestPoint_Loop_D2.50mm_Drill1.0mm'
FP_HDR2 = 'Connector_PinHeader_2.54mm:PinHeader_1x02_P2.54mm_Vertical'
FP_HDR3 = 'Connector_PinHeader_2.54mm:PinHeader_1x03_P2.54mm_Vertical'
FP_HDR6 = 'Connector_PinHeader_2.54mm:PinHeader_1x06_P2.54mm_Vertical'
FP_HDR8 = 'Connector_PinHeader_2.54mm:PinHeader_1x08_P2.54mm_Vertical'
FP_FUSE = ('Fuse:Fuseholder_Clip-5x20mm_Bel_FC-203-22_Lateral'
           '_P17.80x5.00mm_D1.17mm_Horizontal')
FP_DIP14 = 'Package_DIP:DIP-14_W7.62mm'
FP_DIP16 = 'Package_DIP:DIP-16_W7.62mm'
FP_SOT23_3 = 'Package_TO_SOT_SMD:SOT-23'
FP_SOT23_5 = 'Package_TO_SOT_SMD:SOT-23-5_HandSoldering'
FP_SOT23_6 = 'Package_TO_SOT_SMD:SOT-23-6_Handsoldering'
FP_SOT353 = 'Package_TO_SOT_SMD:SOT-353_SC-70-5_Handsoldering'
FP_TO92 = 'Package_TO_SOT_THT:TO-92_Inline'
FP_DPAK = 'Package_TO_SOT_SMD:TO-252-3_TabPin2'
FP_ASSR = ('accord-logger:ASSR-601Jx_SO-16-12Lead_11.634x10.363mm_P1.27mm')
FP_OSC = ('accord-logger:Oscillator_SMD_MicroCrystal_OV-7604-C7'
          '_SON-4_3.2x1.5mm')
FP_ILAG5_14 = 'accord-logger:JAE_IL-AG5-14P-D3L2-A'

P = []          # placed parts, in BOM order


GRID = 1.27     # KiCad's connection grid, 50 mil


def snap(v):
    """Place on the 1.27 mm connection grid.

    Every pin endpoint has to land on it, or ERC reports endpoint_off_grid
    and the pin is a connection the editor will not actually make. Snapping
    here rather than at each call site means a new block cannot reintroduce
    the fault by choosing a convenient round number.
    """
    return round(v / GRID) * GRID


def part(ref, lib_id, value, x, y, nets=None, rot=0, fp='', nc=(),
         status='', source='', note='', bom=True, mpn='', hide_value=False,
         dnp=False):
    x, y = snap(x), snap(y)
    P.append(dict(ref=ref, lib_id=lib_id, value=value, x=x, y=y, rot=rot,
                  nets=nets or {}, fp=fp, nc=tuple(nc), status=status,
                  source=source, note=note, bom=bom, mpn=mpn, dnp=dnp,
                  hide_value=hide_value))


class Grid:
    """Left-to-right, wrapping placement inside a frame.

    Connections are by net label, so placement only has to be legible. A grid
    keeps the sixty parts LRA-12 adds from needing sixty hand-tuned
    coordinates that would drift the next time a block changes.
    """

    def __init__(self, x0, y0, x1, dx=44.45, dy=20.32):
        self.x0, self.y, self.x1 = x0, y0, x1
        self.dx, self.dy, self.x = dx, dy, x0

    def next(self, dx=None, dy=None):
        step = dx or self.dx
        if self.x + step > self.x1:
            self.x = self.x0
            self.y += dy or self.dy
        xy = (self.x, self.y)
        self.x += step
        return xy

    def newline(self, dy=None):
        self.x = self.x0
        self.y += dy or self.dy


# ======================================================== vehicle input cells
# J1 is the single board connector (owner decision D-CONN-06, revised): a
# JAE IL-AG5-14P-D3L2-A, Honda's connector style, the 14-contact sibling of
# the 22P on the keyless board. Footprint generated by tools/gen_fp_ilag5.py
# from the JAE catalogue. Contacts as seen at the mating face (outer row,
# then the row nearer the body; rows 3 mm apart there, 2.5 mm pitch):
#   1 RS485_A  2 bus GND  3 B2   . gap .  4 B1    5 B11   6 BATT_IN
#   7 RS485_B  8 spare    9 C11  10 AGND  11 12 spare  13 C14  14 PGND
# BATT_IN's neighbours are only B11, PGND and C14: grounds and 12 V-level
# inputs. Fuel sits beside its AGND reference; A/B are a pair with their own
# ground contact, as on keyless.
part('J1', 'Connector_Generic:Conn_01x14', 'Board connector 14-way',
     40.64, 48.26, rot=180, fp=FP_ILAG5_14, nc=(8, 11, 12),
     nets={1: 'RS485_A', 2: 'PGND', 3: 'B2_TAP', 4: 'B1_TAP', 5: 'B11_TAP',
           6: 'BATT_IN', 7: 'RS485_B', 9: 'C11_TAP', 10: 'AGND',
           13: 'C14_TAP', 14: 'PGND'},
     mpn='JAE IL-AG5-14P-D3L2-A, 14 contact right-angle pin header',
     status='SELECTED', source='DECISIONS D-CONN-06 / JAE IL-AG5 catalogue',
     note='JAE IL-AG5 2.5 mm, 14 contacts, right-angle through-hole with '
          'board guides, 3 A per contact. Mates with housing '
          'IL-AG5-14S-D3C1-A and IL-AG5-C1-5000 crimp sockets (AWG 22-18); '
          'hand crimp tool CT150-1-AG5. Same family as the keyless 22P. '
          'Footprint pin numbers follow the keyless 22P convention (pin 1 '
          'outer row, left end from the mating face): verify against the '
          'housing cavity numbers before crimping. 6 BATT_IN, protected +12 V '
          '(fuse it at the source; F1 protects only the board). 14 PGND power '
          'return; 2 PGND as the dedicated RS-485 bus ground. 10 is the B16 '
          'cluster ground sense, bonded to the single AGND node at one point '
          '(REV_A_INTERFACES S4, delta D5); never a power or bus return. '
          '1/7 RS-485 A/B; run them as a twisted pair with pin 2. 8, 11, 12 '
          'spare')

# AS_BUILT S2 rows 1-5a. Ratios, clamps and the fitted ADC protection are
# carried forward with no value changed.
#
# D4, resolved by LRA-12 (LAYOUT_CLOSURE S4): B2 alone takes a series switch.
# The other four branches are a justified bypass. They are all ignition-fed,
# so "board off with the input energized" needs an upstream power fault as
# well as the key being on, and in that state the fitted series resistance
# bounds the injection. B2 is the exception the owner measured: it is held at
# 4.669 V with the key out, by an always-on source, which is why it alone
# gets the switch.

# X1 resolved: Broadcom ASSR-601JV photo-MOSFET relay in the B2 divider top
# leg. Output is a back-to-back avalanche MOSFET pair with no supply of its
# own, so LED-dark is open by construction, and the leakage maximum is stated
# over the whole -40..+105 C recommended operating range.
part('UISO', 'Custom:ASSR-601JV', 'ASSR-601JV', 109.22, 93.98, fp=FP_ASSR,
     nets={4: 'ISO_LED_A', 5: 'ISO_LED_K',
           15: 'B2_TAP', 16: 'B2_TAP', 9: 'B2_ISO', 10: 'B2_ISO'},
     mpn='Broadcom ASSR-601JV-000E', status='SELECTED_AVAILABILITY_OPEN',
     source='isolation/B2_ISOLATION.md; LAYOUT_CLOSURE S4',
     note='B2 series isolation (D4). Output leakage 1000 nA maximum at '
          'VO = 1000 V, specified over recommended operating conditions '
          '(-40 to +105 C for the JV), against 4.669 V actually applied: the '
          'row carries no 25 C override, unlike the withstand row above it. '
          'R_ON 300 ohm max at IO = 2 mA shifts the 22k/33k ratio by -0.54 %. '
          'D1 (15, 16) and D2 (9, 10) are each internally paired and the pair '
          'is bidirectional, so orientation is free. PIN 3 MUST BE LEFT '
          'UNCONNECTED - it is internally tied to pin 5, the LED cathode. '
          'Pins 11-14 do not exist; the local footprint is a 12-pad variant '
          'derived from the manufacturer land pattern, not a stock SOIC-16W. '
          'Availability is the one open item: distributor lifecycle data is '
          'contradictory. Panasonic AQY221N2S is the documented fallback, a '
          'strictly smaller part inside the same keepout, whose 10 nA leakage '
          'maximum is 25 C only')

DIG = [
    # key, label, Y, Rtop, Rbot, top-leg source net, divider node
    ('VSS',  'B2 vehicle speed', 93.98,  '22k', '33k',  'B2_ISO',  'VSS_IN'),
    ('TACH', 'B1 tachometer',   172.72,  '22k', '6.8k', 'B1_TAP',  'TACH_IN'),
    ('BRK',  'C14 brake warning', 251.46, '22k', '6.8k', 'C14_TAP', 'BRAKE_IN'),
]
BYPASS = ('D4 bypass, decided in LAYOUT_CLOSURE S4: this branch is '
          'ignition-fed and measured or logged dead with the key out, so '
          'criterion A is met with no device at all. Reaching criterion B '
          'needs the key on AND an upstream power fault, because ignition '
          'present turns QI on and powers the board. In that fault state the '
          'fitted series resistance bounds the injection. ')
for key, desc, Y, rt, rb, top, sig in DIG:
    tnote = 'fitted divider top, value unchanged'
    if key == 'VSS':
        tnote += '; fed from the ASSR output rather than directly from the tap'
    else:
        tnote += '. ' + BYPASS
    part(f'R_{key}_T', 'Device:R', rt, 162.56, Y, nets={1: top, 2: sig},
         fp=FP_R, status='VERIFY_STOCK', source='AS_BUILT S2',
         note=tnote)
    part(f'R_{key}_B', 'Device:R', rb, 203.2, Y, nets={1: sig, 2: 'PGND'},
         fp=FP_R, status='VERIFY_STOCK', source='AS_BUILT S2',
         note='fitted divider bottom, value unchanged')
    dnote = 'fitted clamp, anode at the pin, cathode to switched 3V3'
    if key == 'VSS':
        dnote += ('. This is the specimen behind U-07\'s first measured '
                  'point: the parked B2 readings give it 159 mV at 109 uA at '
                  'room temperature, a Schottky drop. With UISO fitted the '
                  'branch is open upstream when the board is off, so this '
                  'clamp no longer has a parked path to conduct')
    else:
        dnote += ('. D11 remains open for the tach cell: V_F keeps falling '
                  'below 109 uA, so its clamp onset is lower than a 0.3 V '
                  'assumption gives. LRA-12 changes no ratio')
    part(f'D_{key}', 'Diode:1N5819', '1N5819', 248.92, Y, rot=180,
         nets={2: sig, 1: 'P3V3_SW'}, fp=FP_DO41_A, mpn='Chanzon 1N5819',
         status='VERIFY_STOCK', source='AS_BUILT S2/S3.4a, U-07',
         note=dnote)

ADC = [
    ('FUEL', 'C11 fuel sender', 330.2, '7.5k', '4.7k', 'C11_TAP',
     'FUEL_DIV', 'FUEL_ADC'),
    ('SUP', 'B11 cluster supply', 408.94, '22k', '4.7k', 'B11_TAP',
     'SUPPLY_DIV', 'SUPPLY_ADC'),
]
for key, desc, Y, rt, rb, top, div, adc in ADC:
    part(f'R_{key}_T', 'Device:R', rt, 162.56, Y, nets={1: top, 2: div},
         fp=FP_R, status='VERIFY_STOCK', source='AS_BUILT S2',
         note='fitted divider top, value unchanged. ' + BYPASS +
              'No series element is added, so the card header\'s two-term '
              'fuel calibration (log.adc.fuel div=7500/4700) stays valid and '
              'REV_A_INTERFACES S8.2 needs no change')
    part(f'R_{key}_B', 'Device:R', rb, 203.2, Y, nets={1: div, 2: 'AGND'},
         fp=FP_R, status='VERIFY_STOCK', source='AS_BUILT S2/S3.3',
         note='fitted divider bottom; returns to the single B16 sense node')
    part(f'R_{key}_S', 'Device:R', '1k', 287.02, Y, rot=90,
         nets={1: div, 2: adc}, fp=FP_R, status='VERIFY_STOCK',
         source='AS_BUILT S2 rows 4a/5a',
         note='fitted series resistor at the pin')
    part(f'C_{key}', 'Device:C', '1uF', 312.42, Y, nets={1: adc, 2: 'AGND'},
         fp=FP_C_DISC, status='VERIFY_OR_SOURCE',
         source='AS_BUILT S2 rows 4a/5a',
         note='fitted filter capacitor; exact dielectric/rating not recorded')
    part(f'D_{key}_H', 'Diode:1N5819', '1N5819', 337.82, Y - 10.16, rot=180,
         nets={2: adc, 1: 'P3V3_SW'}, fp=FP_DO41_A, mpn='Chanzon 1N5819',
         status='VERIFY_STOCK', source='AS_BUILT S2 rows 4a/5a',
         note='fitted upper clamp')
    part(f'D_{key}_L', 'Diode:1N5819', '1N5819', 337.82, Y + 10.16,
         nets={1: adc, 2: 'AGND'}, fp=FP_DO41_A, mpn='Chanzon 1N5819',
         status='VERIFY_STOCK', source='AS_BUILT S2 rows 4a/5a',
         note='fitted lower clamp')

# The one harness entry that is not a high-impedance divider: B11 feeds the
# ignition opto LED through 2.2k as well as the supply ADC divider, so it is
# the one cluster line that gets a clamp. The five divider inputs are
# protected by their own 7.5k-22k series resistance (LAYOUT_CLOSURE S3).
part('TVS_B11', 'Diode:1.5KExxA', '1.5KE20A-E3/54', 109.22, 440,
     rot=270, nets={1: 'B11_TAP', 2: 'PGND'}, fp=FP_DO201_K,
     mpn='Vishay 1.5KE20A-E3/54', status='SELECTED',
     source='LAYOUT_CLOSURE S3; D-POWER-03 consequence 2',
     note='ignition/supply-sense entry clamp. Same part as the P12 clamp, so '
          'one qualification covers both: 17.1 V standoff, 19.0-21.0 V VBR at '
          '1 mA, 27.7 V clamp at 54.2 A for 10/1000 us, 1.0 uA maximum '
          'leakage at standoff. POLARITY: Diode:1.5KExxA is the '
          'unidirectional family and draws a real cathode bar, so a reversal '
          'is visible in the drawing - but its pins are still named A1/A2, so '
          'ERC cannot check it and check_capture.py asserts it by pin number '
          'instead. Pin 1 is the banded cathode and goes to the tap. '
          'Keyless protects its harness lines with seven '
          'P6KE30A; the owner has four. They are not used here because their '
          '41.4 V clamp is above the 40 V parts this board puts behind it')

# ================================================================= Pico W
PICO_NC = (1, 2, 19, 20, 26, 27, 29, 34, 35, 37, 40)
part('U1', 'MCU_Module:RaspberryPi_Pico_W', 'RaspberryPi_Pico_W',
     431.8, 101.6, fp='Module:RaspberryPi_Pico_W_SMD_HandSolder',
     nc=PICO_NC, mpn='Raspberry Pi Pico W (RP2040 + CYW43439)',
     status='FITTED', source='REV_A_INTERFACES S1',
     note='fitted module; Rev A column of the pin map. GP7 (pin 10) is the '
          'ISO_EN reservation LRA-12 takes up, confirmed free in S1. GP8/GP9 '
          '(UART1) and GP10 (DE//RE) go to onboard RS-485, and GP13 '
          'is offered on J3 as a spare. GP8/9/10 are now assigned to RS-485',
     nets={4: 'VSS_IN', 5: 'TACH_IN', 6: 'BRAKE_IN', 7: 'QUAL_N_REPORT',
           9: 'HOLD_RAW', 10: 'ISO_EN', 11: 'UART1_TX', 12: 'UART1_RX',
           14: 'BUS_DE', 15: 'SPARE_GP11', 16: 'SPARE_GP12',
           17: 'SPARE_GP13',
           21: 'SD_MISO', 22: 'SD_CS', 24: 'SD_SCK', 25: 'SD_MOSI',
           30: 'RUN', 31: 'FUEL_ADC', 32: 'SUPPLY_ADC', 33: 'AGND',
           36: 'P3V3_SW', 39: 'VSYS', 3: 'PGND'})

# ====================================================== ignition / opto cell
# AS_BUILT S3.4 / S3.4a for the vehicle side. LRA-12 decisions (R06-REV-2 and
# capture question Q2): the LED cathode returns to PGND, not to the B16
# cluster conductor, and the onboard FIGN is dropped in favour of the tap-end
# fuse the specification asks for.
part('DI', 'Diode:1N5819', '1N5819', 60.96, 490.22, rot=180,
     nets={2: 'B11_TAP', 1: 'IGN_POS'}, fp=FP_DO41_A, mpn='Chanzon 1N5819',
     status='VERIFY_STOCK', source='AS_BUILT S2 row 6 / S3.4',
     note='fitted series diode; owner reported 1N5819, not the 1N4148 of '
          'DESIGN.md S3. The onboard FIGN of DESIGN.md S3 is deliberately '
          'not fitted: REV_A_INTERFACES S5.1 and delta D10 put per-branch '
          'fuses at the tap end, an onboard fuse cannot protect the upstream '
          'harness, and the board cannot draw enough through RI and RLED '
          '(1.1k together) to need one. Capture question Q4, closed')
part('RLED', 'Device:R', '2.2k', 99.06, 490.22, rot=90,
     nets={1: 'IGN_POS', 2: 'IGN_LED_A'}, fp=FP_R_HALFW,
     status='VERIFY_STOCK', source='AS_BUILT S3.4a, measured 2026-10-29',
     note='measured 2.2k carried forward (D15), specified 0.5 W. At the '
          '17.1 V sustained ceiling the standoff of the entry clamp sets, '
          'dissipation is 0.108 W; the 0.792 W figure that broke the 1k '
          'candidate came from the superseded 28 V number. Fitted wattage is '
          'not recorded, so the 0.5 W position is specified rather than '
          'assumed')
part('DR', 'Diode:1N4148', '1N4148', 139.7, 500.38, rot=270,
     nets={1: 'IGN_LED_A', 2: 'PGND'}, fp=FP_DO35_A,
     mpn='Vishay 1N4148-TAP', status='MISSING', source='DESIGN.md S3',
     note='LED reverse clamp. With the LED cathode now on PGND this sits '
          'directly antiparallel with the LED, which is the arrangement '
          'DESIGN.md S3 specifies and the position that actually limits LED '
          'reverse voltage (BVR 6 V on the PC817 input)')
part('U2', 'Isolator:PC817', 'PC817', 190.5, 490.22,
     nets={1: 'IGN_LED_A', 2: 'PGND', 4: 'A5', 3: 'IGN_A'},
     fp='Package_DIP:DIP-4_W7.62mm',
     mpn='Sharp PC817XNNSZ1B or qualified equivalent',
     status='VERIFY_STOCK', source='AS_BUILT S2 rows 6-7 / S3.4; '
                                   'CUTOFF_MARGIN_REVIEW S2',
     note='Rewired by LRA-12 into the A5 domain, which is what X6 was holding '
          'open: collector (4) to A5 and emitter (3) to IGN_A, an emitter '
          'follower into the 47k/220k/1uF qualification filter, replacing the '
          'old collector-to-GP5 arrangement that D-RA-03 forbids mixing with '
          'the qualified proposal. LED CATHODE MOVED FROM B16 TO PGND '
          '(R06-REV-2 / Q2): REV_A_INTERFACES S4 makes B16 a reference that '
          'must never become a power return, and the fitted cell put '
          '4.7-5.8 mA of signal-dependent LED current through the node both '
          'ADC channels reference. No symbol encodes this pinout, so it is '
          'asserted by pin number in check_capture.py: 1 LED anode, 2 LED '
          'cathode, 3 emitter, 4 collector (AS_BUILT S3.4a). The fitted '
          '100 nF across the old collector output is not carried forward - '
          'the node it filtered no longer exists')

# ====================================== X6: qualified ignition, A5 domain
# CUTOFF_MARGIN_REVIEW.md S2, component for component.
g = Grid(40.64, 600.0, 300.0)
x, y = g.next()
part('RIGNA', 'Device:R', '47k', x, y, nets={1: 'IGN_A', 2: 'PGND'},
     fp=FP_R, status='VERIFY_OR_SOURCE', source='CUTOFF_MARGIN_REVIEW S2',
     note='1 % tolerance. Sets the opto emitter load: the ON endpoint must '
          'reach 4.5 V, which draws 95.7 uA, and the OFF endpoint must stay '
          'below 0.3 V, which allows only 6.32 uA of injected leakage into '
          'this node')
x, y = g.next()
part('RRC', 'Device:R', '220k', x, y, nets={1: 'IGN_A', 2: 'IGN_RC'},
     fp=FP_R, status='VERIFY_OR_SOURCE', source='CUTOFF_MARGIN_REVIEW S2',
     note='1 % tolerance; charge leg of the qualification filter')
x, y = g.next()
part('CQUAL', 'Device:C', '1uF', x, y, nets={1: 'IGN_RC', 2: 'PGND'},
     fp=FP_C_FILM, status='PART_SELECTION_OPEN',
     source='CUTOFF_MARGIN_REVIEW S2',
     note='1 uF film, 5 %, >=50 V. Film rather than ceramic because the '
          'filter endpoints depend on its actual capacitance and leakage: a '
          'Class 2 ceramic would move the qualification times with bias and '
          'temperature. An empty capacitor now means IGN OFF, which is the '
          'polarity correction CUTOFF_MARGIN_REVIEW made. Exact series and '
          'insulation resistance remain a procurement item')
x, y = g.next()
part('QRESET', 'Transistor_BJT:2N3904', '2N3904', x, y,
     nets={1: 'PGND', 2: 'RST_B', 3: 'RST_C'}, fp=FP_TO92,
     mpn='onsemi 2N3904', status='VERIFY_STOCK',
     source='CUTOFF_MARGIN_REVIEW S2',
     note='discharges IGN_RC toward OFF while the supervisor says BAD, so a '
          'previously charged filter cannot grant a false rearm on recovery. '
          'Worst RC fall from 5.11 V to 0.9 V is about 10.3 ms against the '
          'supervisor 120 ms minimum release delay. E/B/C = 1/2/3')
x, y = g.next()
part('R_RSTB', 'Device:R', '22k', x, y, nets={1: 'BAD', 2: 'RST_B'},
     fp=FP_R, status='VERIFY_STOCK', source='CUTOFF_MARGIN_REVIEW S2',
     note='1 %; QRESET base drive, about 0.16 mA from a 4.5 V BAD output')
x, y = g.next()
part('R_RSTPD', 'Device:R', '100k', x, y, nets={1: 'RST_B', 2: 'PGND'},
     fp=FP_R, status='VERIFY_STOCK', source='CUTOFF_MARGIN_REVIEW S2',
     note='QRESET base-emitter pulldown')
x, y = g.next()
part('R_RSTC', 'Device:R', '4.7k', x, y, nets={1: 'RST_C', 2: 'IGN_RC'},
     fp=FP_R, status='VERIFY_STOCK', source='CUTOFF_MARGIN_REVIEW S2',
     note='1 %; discharge leg. Initial collector demand about 1.1 mA')
x, y = g.next()
part('QREPORT', 'Transistor_FET:BSS138', 'BSS138P', x, y,
     nets={1: 'REP_G', 2: 'PGND', 3: 'QUAL_N_REPORT'}, fp=FP_SOT23_3,
     mpn='Nexperia BSS138P', status='VERIFY_STOCK',
     source='CUTOFF_MARGIN_REVIEW S2 / REV_A_INTERFACES D1',
     note='translates IGN_Q to the switched 3V3 domain: GP5 LOW means '
          'IGN_Q = 1. Open drain against RIGN, so there is no DC A5 path '
          'into GP5 and no 5 V pullup on any GPIO. gate 1, source 2, '
          'drain 3. The report node carries no capacitor (see D1): with the '
          '10k pullup and about 30 pF of node capacitance the rising edge is '
          'under a microsecond, well inside the 10 ms observation budget')
x, y = g.next()
part('R_REPG', 'Device:R', '1k', x, y, nets={1: 'IGN_Q', 2: 'REP_G'},
     fp=FP_R, status='VERIFY_STOCK', source='CUTOFF_MARGIN_REVIEW S2',
     note='QREPORT gate series resistor')
x, y = g.next()
part('R_REPPD', 'Device:R', '100k', x, y, nets={1: 'REP_G', 2: 'PGND'},
     fp=FP_R, status='VERIFY_STOCK', source='CUTOFF_MARGIN_REVIEW S2',
     note='QREPORT gate pulldown; holds the report off with A5 absent')
x, y = g.next()
part('RIGN', 'Device:R', '10k', x, y,
     nets={1: 'P3V3_SW', 2: 'QUAL_N_REPORT'}, fp=FP_R,
     status='VERIFY_STOCK', source='REV_A_INTERFACES S1 / DESIGN.md S3',
     note='GP5 report-node pull-up to SWITCHED 3V3 (D1). With A5 absent and '
          'the board on USB only, QREPORT is off and GP5 reads HIGH, which '
          'firmware must treat as ignition OFF')

# ============================== X7 second stage: always-on A5 supply boundary
# CUTOFF_MARGIN_REVIEW.md S3 selects the regulator. LRA-12 adds the series
# resistor and clamp that make the "P_AON <= 28 V" contract true at
# temperature rather than only at 25 C: see LAYOUT_CLOSURE S3.
g = Grid(320.0, 600.0, 575.0)
x, y = g.next()
part('R_AON', 'Device:R', '820R', x, y, nets={1: 'P12', 2: 'P_AON'},
     fp=FP_R, status='CONDITIONAL', source='LAYOUT_CLOSURE S3 (LRA-12R)',
     note='1%; select a resistor rated >=0.15 W at 85 C. Worst input current '
          '0.510 mA gives 0.4224 V drop at 828.2 ohm; P_AON >=5.5776 V '
          'at P12=6 V. Zener power bounded by Vinput squared / (4 Rmin): '
          '0.263 W at 29.20 V. Resistor dissipation <=0.124 W in clamp model.')
x, y = g.next()
part('DZ_AON', 'Device:D_Zener', 'BZX55C22', x, y, rot=270,
     nets={1: 'P_AON', 2: 'PGND'}, fp=FP_DO35_K,
     mpn='Vishay BZX55C22-TAP', status='SELECTED',
     source='LAYOUT_CLOSURE S3',
     note='BZX55C22 20.8-23.3 V at 5 mA; 55 ohm small-signal impedance. '
          'LRA-12R screen includes junction heating to 175 C: P_AON <=27.90 V. '
          'DC/pulse clamping must be measured; dynamic impedance is not a '
          'guaranteed large-signal slope. Lead temperature <=85 C required. '
          'Leakage <0.1 uA at 25 C / <2 uA at 150 C is specified at 16 V, '
          'not 18 V. Pin 1 cathode.')
x, y = g.next()
part('C_AON', 'Device:C', '4.7uF/50V', x, y, nets={1: 'P_AON', 2: 'PGND'},
     fp=FP_C_1210, mpn='Murata GRM32ER71H475KA88L', status='CONDITIONAL',
     source='COMPONENT_MARGIN_CLOSURE S1 / BOM_DELTA.csv',
     note='A5 input capacitance; effective C must stay >=1 uF across the '
          'P_AON range. X7R 1210 50 V; DC-bias and aging data still required '
          'for procurement. With R_AON the input time constant is 3.85 ms, '
          'inside the 100 ms A5 validity budget')
x, y = g.next(dx=76.2)
part('UA5', 'Custom:TPS70950-Q1_DBV', 'TPS70950QDBVRQ1', x, y,
     nets={1: 'P_AON', 2: 'PGND', 5: 'A5'}, nc=(3,), fp=FP_SOT23_5,
     mpn='TI TPS70950QDBVRQ1', status='RETAIN_UNRESOLVED',
     source='CUTOFF_MARGIN_REVIEW S3 / COMPONENT_MARGIN_CLOSURE S2',
     note='the always-on 5 V rail. DBV pinout IN 1, GND 2, EN 3, NC 4, '
          'OUT 5 (SLVSCE6D Table 4-1). EN is left OPEN to enable; its '
          'absolute maximum is 7 V, so it must never be tied to an '
          'unregulated rail. Blocks OUT-to-IN current when OUT exceeds IN, '
          'which is why this part and not the TPS7A16. Unresolved: ground '
          'current is specified as 2.7 uA maximum at zero load and 10 uA at '
          '100 uA load / 30 V, with nothing in between, and load regulation '
          'starts at 100 uA - the parked operating point is below both. No '
          'permanent preload may be added to buy a specification')
x, y = g.next(dx=76.2)
part('USUP', 'Power_Supervisor:TPS3839DBZ', 'TPS3839K50DBZR', x, y,
     nets={1: 'PGND', 2: 'PGOOD', 3: 'A5'}, fp=FP_SOT23_3,
     mpn='TI TPS3839K50DBZR', status='SELECTED',
     source='CUTOFF_MARGIN_REVIEW S2',
     note='A5 supervisor. Active-low RESET on pin 2 is PGOOD here: HIGH '
          'means the rail is good. Falling threshold 4.271-4.446 V, release '
          '120-350 ms after a valid rail, 44 mV hysteresis. PUSH-PULL output, '
          'so it drives the new ISO permission gate directly: VOH is at least '
          'VDD-0.4 V at 2 mA against the 50 uA that gate divider draws. '
          'Falling propagation delay is 20 us typical with no maximum, so an '
          'arbitrarily fast collapse is not covered by a worst-case bound. '
          'Specified only to +85 C, which is exactly the hot screening point')
for ref, net in (('C_A5A', 'A5'), ('C_A5B', 'A5')):
    x, y = g.next()
    part(ref, 'Device:C', '4.7uF/50V', x, y, nets={1: net, 2: 'PGND'},
         fp=FP_C_1210, mpn='Murata GRM32ER71H475KA88L', status='CONDITIONAL',
         source='COMPONENT_MARGIN_CLOSURE S1 / BOM_DELTA.csv',
         note='A5 output capacitance, two in parallel: 9.4 uF nominal, '
              'effective sum must stay >=2.2 uF at 5.11 V, inside the '
              'regulator 2-47 uF window. Parallel parts do not average '
              'worst-case tolerance')
x, y = g.next()
# C_SUP is already the B11 ADC filter capacitor, so the supervisor bypass is
# C_USUP. A duplicate source designator would collide in the BOM and in every
# check that looks a part up by it; check_capture.py now asserts there is none.
part('C_USUP', 'Device:C', '100nF', x, y, nets={1: 'A5', 2: 'PGND'},
     fp=FP_C_DISC, status='VERIFY_OR_SOURCE',
     source='CUTOFF_MARGIN_REVIEW S2',
     note='supervisor local bypass, across its own supply')

# ===================================================== B2 isolation driver
# The enable path LRA-11 proposed, completed as the manager required: a GPIO
# enable in series with a hardware PGOOD permission, so BAD opens the switch
# with no software step even when QI is holding the board powered.
g = Grid(600.0, 600.0, 828.0)
x, y = g.next()
part('R_ISO', 'Device:R', '270R', x, y, nets={1: 'B5', 2: 'ISO_LED_A'},
     fp=FP_R, status='SELECTED', source='LAYOUT_CLOSURE S4',
     note='1 %. Sized so the WORST-CASE LED current is still at or above the '
          '10 mA the 4.0 ms turn-on maximum is specified at: B5 -5 % with '
          'V_F 1.85 V and both switch channels gives 10.19 mA, nominal '
          '12.41 mA, B5 +5 % with V_F 1.25 V gives 14.66 mA, inside the 7-30 '
          'mA recommended window. The 330 ohm of the original return put the '
          'low corner at 8.64 mA, below the specified point, which would have '
          'left turn-on unspecified. Dissipation 58 mW')
x, y = g.next()
part('QISO_PG', 'Transistor_FET:BSS138', 'BSS138P', x, y,
     nets={1: 'ISO_PG_G', 2: 'ISO_MID', 3: 'ISO_LED_K'}, fp=FP_SOT23_3,
     mpn='Nexperia BSS138P', status='SELECTED',
     source='LAYOUT_CLOSURE S4; LAYOUT_READINESS_2026-10-29',
     note='hardware permission in series with the GPIO enable. Gated from '
          'A5-domain PGOOD, so supervisor BAD opens the B2 branch with no '
          'software step. This is the part the manager required: BAD does NOT '
          'necessarily remove B5, because the original design gates only QH '
          'and QI can hold power with ignition present, so the LED rail alone '
          'cannot carry the fail-open requirement')
x, y = g.next()
part('QISO_EN', 'Transistor_FET:BSS138', 'BSS138P', x, y,
     nets={1: 'ISO_EN_G', 2: 'PGND', 3: 'ISO_MID'}, fp=FP_SOT23_3,
     mpn='Nexperia BSS138P', status='SELECTED', source='LAYOUT_CLOSURE S4',
     note='firmware enable, gated from GP7. Source to PGND so its gate '
          'reference is fixed. Both channels must be on for LED current to '
          'flow; either one off leaves the relay open')
for ref, src, net, nt in (
        ('R_ISOEN', 'ISO_EN', 'ISO_EN_G', 'GP7 gate series resistor'),
        ('R_ISOEN_PD', 'ISO_EN_G', 'PGND',
         'gate pulldown. This is the startup and reset default: GP7 floats '
         'out of reset, so the relay is open before firmware runs, and it '
         'stays open with the Pico unpowered while B5 is present'),
        ('R_ISOPG', 'PGOOD', 'ISO_PG_G', 'PGOOD gate series resistor'),
        ('R_ISOPG_PD', 'ISO_PG_G', 'PGND',
         'gate pulldown; holds the permission gate off with A5 absent')):
    x, y = g.next()
    part(ref, 'Device:R', '1k' if ref.endswith(('ISOEN', 'ISOPG')) else '100k',
         x, y, nets={1: src, 2: net}, fp=FP_R, status='VERIFY_STOCK',
         source='LAYOUT_CLOSURE S4', note=nt)

# ======================================================== HOLD driver (D2)
part('RPD', 'Device:R', '47k', 396.24, 251.46,
     nets={1: 'HOLD_RAW', 2: 'PGND'}, fp=FP_R, status='VERIFY_STOCK',
     source='REV_A_INTERFACES D2 / DESIGN.md S3',
     note='external GP6 pulldown; holds the driver off before output enable')
part('JH', 'Jumper:Jumper_2_Open', 'HOLD link', 441.96, 238.76,
     nets={1: 'HOLD_RAW', 2: 'HOLD_JH'}, fp=FP_HDR2,
     status='VERIFY_OR_SOURCE', source='DESIGN.md S3 / REV_A_INTERFACES S5.3',
     note='MAINTENANCE link, not a test provision: open it for USB work so a '
          'USB-driven HOLD cannot keep the battery circuit on. Opening it '
          'does not inhibit QI and does not change the QMON sense, which '
          'taps HOLD_RAW ahead of this link. Distinct from the two 0 R '
          'period-select links R_EXPP and R_EXPT, which choose the cutoff '
          'period: three different provisions, three different parts')
part('RH', 'Device:R', '1k', 482.6, 238.76, rot=90,
     nets={1: 'HOLD_JH', 2: 'HOLD_B'}, fp=FP_R, status='VERIFY_STOCK',
     source='DESIGN.md S3', note='HOLD base drive')

# ============================================================ SD (D6, S3.5)
part('J5', 'Connector_Generic:Conn_01x06', 'SD breakout 6-way',
     403.86, 381, rot=180, fp=FP_HDR6,
     nets={1: 'P3V3_SW', 2: 'PGND', 3: 'SD_MISO', 4: 'SD_CS', 5: 'SD_SCK',
           6: 'SD_MOSI'},
     status='VERIFY_OR_SOURCE', source='AS_BUILT S2 row 9 / S3.5',
     note='fitted SPI0 breakout module on switched 3V3, 12 MHz; the card must '
          'be removable without removing the board (S5.2)')
part('C_SD', 'Device:C_Polarized', '47uF/16V', 474.98, 381,
     nets={1: 'P3V3_SW', 2: 'PGND'}, fp='Capacitor_THT:CP_Radial_D6.3mm_P2.50mm',
     status='SELECTED', source='REV_A_INTERFACES D6 / LAYOUT_CLOSURE S6',
     note='D6 bulk at the SD supply, confirmed absent 2026-10-29. D6 gave a '
          '10-100 uF range; 47 uF is selected from the duty it has to do - a '
          '200 mA write spike for 1 ms inside a 100 mV droop needs 2 uF, so '
          '47 uF is an order of margin without an oversized can. '
          'Specification for an interchangeable part: 47 uF +/-20 %, >=16 V, '
          'ESR <=0.5 ohm at 100 kHz, 6.3 x 11 mm maximum, 105 C. POLARITY: '
          'pin 1 is the + terminal and goes to the switched 3V3 rail')

# ==================================== expansion and service (LRA-04 bounded)
part('J3', 'Connector_Generic:Conn_01x04', 'Spare GP13 / switched power',
     403.86, 480, rot=180,
     fp='Connector_PinHeader_2.54mm:PinHeader_1x04_P2.54mm_Vertical',
     nets={1: 'B5', 2: 'PGND', 3: 'P3V3_SW', 4: 'SPARE_GP13'},
     status='SELECTED', source='D-RS485-05 / communications/REV_A_PROVISION.md',
     note='Trimmed to four pins. UART1 and DE//RE go only to onboard MAX3485. '
          'No external powered logic or supply may backfeed this header.')
part('R_DE', 'Device:R', '10k', 474.98, 492.76,
     nets={1: 'BUS_DE', 2: 'PGND'}, fp=FP_R, status='VERIFY_STOCK',
     source='communications/REV_A_PROVISION.md',
     note='DE//RE default-listen pulldown, following keyless practice, so the '
          'line is defined while the GPIO still floats at boot. A pulldown '
          'and not a pullup, so nothing feeds an off GPIO')
part('J4', 'Connector_Generic:Conn_01x02', 'Reset RUN-GND',
     403.86, 541.02, rot=180, fp=FP_HDR2, nets={1: 'RUN', 2: 'PGND'},
     status='SELECTED', source='REV_A_INTERFACES S5.1 / LAYOUT_CLOSURE S6',
     note='resolves capture question Q5. J4 is now only the RUN-to-GND reset '
          'pair, shorted with a link for a reset without cutting power, '
          'following the keyless J7 pattern. The service UART that S5.1 also '
          'wanted here is dropped: GP0/GP1 must stay free, firmware already '
          'builds with pico_enable_stdio_usb so the USB CDC console is the '
          'service path, and a UART header would be another externally '
          'powered pullup aimed at an off GPIO. A header with NC pins was '
          'the contradiction; this has none')
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
