jgazeley/accord/logger/hardware/kicad/tools/gen_custom_sym.py

"""Write logger/hardware/kicad/Custom.kicad_sym.

LM2678T-5.0 is copied from keyless/hardware/Custom.kicad_sym rather than
redrawn, per the LRA-06 packet.

LRA-12 adds the parts the installed libraries do not carry, and retires the
LRA-06 placeholders. The `placeholder()` helper is kept, because it is the
mechanism a future genuinely unresolved block should use, but LRA-12 emits
none: X1-X8 now each have a real circuit or a recorded, justified bypass, so
no dashed "NOT SELECTED" body remains in the drawing. See
`../../power/LAYOUT_CLOSURE.md` and `../CAPTURE_NOTES.md` section 2.

The glue logic is drawn as single-unit boxes carrying every package pin, not
as KiCad's multi-unit 4xxx symbols. This capture connects by placing a net
label on each pin, so one body per package keeps the drawing and the netlist
in step, and it puts the whole package - including the inputs that must be
tied off - in one place where a reviewer can see them at once.

Pin numbers and names below are taken from the manufacturer documents cited in
each symbol's Datasheet property, and are asserted again against the exported
netlist by `../check_capture.py`.
"""
import os
import sys
sys.path.insert(0, os.path.dirname(os.path.abspath(__file__)))
import sexp

OUT = sys.argv[1]
REPO = os.path.normpath(os.path.join(os.path.dirname(os.path.abspath(__file__)),
                                     '..', '..', '..', '..'))
KEYLESS = os.path.join(REPO, 'keyless', 'hardware', 'Custom.kicad_sym')

lm = None
for s in sexp.getall(sexp.read(KEYLESS), 'symbol'):
    if s[1] == '"LM2678T-5.0':
        lm = sexp.dump(s, 1)
assert lm, 'LM2678T-5.0 not found in the keyless Custom library'


def pin(num, name, x, y, rot, length=5.08, etype='passive'):
    return (
        '\t\t\t(pin %s line\n'
        '\t\t\t\t(at %s %s %s)\n'
        '\t\t\t\t(length %s)\n'
        '\t\t\t\t(name "%s"\n'
        '\t\t\t\t\t(effects (font (size 1.27 1.27)))\n'
        '\t\t\t\t)\n'
        '\t\t\t\t(number "%s"\n'
        '\t\t\t\t\t(effects (font (size 1.27 1.27)))\n'
        '\t\t\t\t)\n'
        '\t\t\t)' % (etype, x, y, rot, length, name, num))


def placeholder(name, desc, keywords, pins, w, h, label):
    """A dashed box carrying a '?' so it cannot be mistaken for a real part.

    Retained as the mechanism for a future unresolved block. LRA-12 emits no
    placeholder; see the module docstring.
    """
    body = '\n'.join(pins)
    return '''\t(symbol "%s"
\t\t(pin_names
\t\t\t(offset 1.016)
\t\t)
\t\t(exclude_from_sim yes)
\t\t(in_bom yes)
\t\t(on_board yes)
\t\t(property "Reference" "X"
\t\t\t(at %s %s 0)
\t\t\t(effects (font (size 1.27 1.27)) (justify left))
\t\t)
\t\t(property "Value" "%s"
\t\t\t(at %s %s 0)
\t\t\t(effects (font (size 1.27 1.27)) (justify left))
\t\t)
\t\t(property "Footprint" ""
\t\t\t(at 0 0 0)
\t\t\t(effects (font (size 1.27 1.27)) (hide yes))
\t\t)
\t\t(property "Datasheet" ""
\t\t\t(at 0 0 0)
\t\t\t(effects (font (size 1.27 1.27)) (hide yes))
\t\t)
\t\t(property "Description" "%s"
\t\t\t(at 0 0 0)
\t\t\t(effects (font (size 1.27 1.27)) (hide yes))
\t\t)
\t\t(property "ki_keywords" "%s"
\t\t\t(at 0 0 0)
\t\t\t(effects (font (size 1.27 1.27)) (hide yes))
\t\t)
\t\t(symbol "%s_0_1"
\t\t\t(rectangle
\t\t\t\t(start %s %s)
\t\t\t\t(end %s %s)
\t\t\t\t(stroke (width 0.381) (type dash))
\t\t\t\t(fill (type none))
\t\t\t)
\t\t\t(text "?"
\t\t\t\t(at 0 %s 0)
\t\t\t\t(effects (font (size 3.81 3.81) (bold yes)))
\t\t\t)
\t\t\t(text "%s"
\t\t\t\t(at 0 %s 0)
\t\t\t\t(effects (font (size 1.27 1.27) (italic yes)))
\t\t\t)
\t\t)
\t\t(symbol "%s_1_1"
%s
\t\t)
\t)''' % (name, -w, h + 2.54, name, -w, -h - 2.54, desc, keywords, name,
         -w, h, w, -h, h - 3.81, label, -h + 2.54, name, body)
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
