jgazeley/accord/logger/hardware/kicad/tools/schgen.py

"""Build a KiCad 9 .kicad_sch from a component/net description.

Every symbol is placed at rotation 0 and every connection is made by placing a
net label exactly on the pin's endpoint, so no wire geometry has to be solved.
"""
import os
import uuid as _uuid
import sexp

SYMDIR = '/usr/share/kicad/symbols'
STUB = 2.54   # pin-to-label stub length, mm


# Fixed project namespace; never change after PCB association.
NAMESPACE = _uuid.uuid5(_uuid.NAMESPACE_URL, 'https://github.com/jgazeley/accord/logger')


def u(*key):
    return str(_uuid.uuid5(NAMESPACE, repr(key)))


class Lib:
    def bbox(self, lib_id):
        """(x_min, y_min, x_max, y_max) of graphics and pins, library coords."""
        node = self.defs(lib_id)[0][1]
        xs, ys = [], []

        def pt(x, y):
            xs.append(float(x)); ys.append(float(y))
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
