jgazeley/accord/(commit log)

2026-10-28 Initial import: Accord keyless and logger projects
    [hondaPico.kicad_pcb, hondaPico.kicad_sch]
2026-10-28 Add standalone raw-upload receiver and canonical trip conversion
    Preserve the working host and conversion sources with provenance, add
    synthetic HTTP/card equivalence and durability coverage, and provide a
    token-required standalone entry point with external state and no database.
    Document Linux service setup, protocol contracts and logger pin mapping.
    Keep private deployment credentials, recordings and runtime data excluded.
    Agent-Session: pcb-manager
    Codex-Session-ID: 01a17045-1855-7af2-b76a-32c2b778cd64
2026-10-28 Make Accord the active coordination home and hand off project management
    Establish one current milestone/task tracker, Rev A hardware context,
    role-based assignments, a reusable task packet, migration boundaries and
    an actionable power-interface packet. Preserve history and attribution;
    keep private runtime/data outside the public migration. Document the
    successor manager's authority without claiming a new session has started.
    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
2026-10-28 Claim PCB coordination and prepare Rev A review assignments
    Record the successor manager identity while preserving predecessor attribution.
    Refresh LRA-01 with current firmware startup, IGN observation and SD API gaps;
    prepare bounded LRA-03 as-built and LRA-04 communications task packets.
    Specialist roles remain explicitly unclaimed and engineering approval pending.
    Validation: reviewed all six staged documentation files, checked local Markdown
    link targets and git diff --cached --check. No firmware or runtime changes.
    Codex-Session-ID: 01a18447-07c2-7bb3-8318-9b276cfdb3b8
    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
2026-10-28 Continue the existing power candidate without duplicating design research
    Record owner direction to use 9527a14 as the LRA-01/02 continuation baseline.
    Locate and verify ten unchanged historical engineering/continuation artifacts;
    limit further investigation to named gaps and require rationale for replacement.
    Preserve original engineering attribution and the selective-export boundary.
    Validation: reran 11 logic and 8 margin checks from exact 9527a14 Git blobs;
    all pass conditionally. Reviewed both staged documents; diff check passes.
    No circuit acceptance, source import or historical working-tree edits.
    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
2026-10-28 Use existing hondaPico circuit examples in logger review tasks
    Record owner direction to consult keyless hardware before designing equivalent
    logger blocks. Identify input, supply, communications and board-interface
    references in LRA-01/03/04, preserving module boundaries and fitted-value gaps.
    Validation: inspected schematic components/notes, keyless firmware definitions,
    existing KiCad validation and historical U13 reuse notes; staged diff check passes.
    Documentation only; no electrical acceptance or hardware changes.
    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
2026-10-28 Anchor logger schematic work in the existing as-built circuit
    Record owner reminder that the physical logger predates KiCad capture.
    Add corrected connections, source precedence and remaining fitted-part unknowns
    to LRA-03; distinguish existing wiring from proposed Rev A changes.
    Validation: reviewed dated historical circuit/ADC installation records and
    current SD pin definitions; inspected staged documents; diff check passes.
    No hardware, firmware or private historical files changed.
    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
2026-10-28 Export existing logger power candidate with provenance for LRA-01
    Transport eleven unchanged engineering documents, BOMs and checks from
    jgazeley/accord-logger 9527a14153c7b06f3d59b641a2e681b28dcd1735.
    Preserve per-file hashes, original commit metadata and engineering attribution.
    Original engineering: Codex power sessions 01a173c4-d2fd-7f71-a396-8996d502387b
    and 01a17407-4357-7031-b3ac-a51c97864fbe; source history credits Jayson Gazeley
    and Jayson Gazeley (Remote Codex). This commit authors export packaging and
    coordination updates, not the transported circuit design.
    Add a current entry point, public-content review and owner-approved license
    notices. Update LRA-01 and migration context so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
    [BOM.csv, MAX_ON_BOM.csv]
2026-10-28 Record owner-reported remote start of LRA-01
    Electrical work has begun remotely; session and branch remain pending receipt.
    Keep firmware review and LRA-03/04 available without inventing claimant identities.
    Reviewed both staged coordination documents; diff check passes.
    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
2026-10-28 logger-power: define LRA-01 qualified ignition and shutdown contract
    Continue the 9527a14 circuit with GP5 qualified IGN, GP6 HOLD, explicit
    startup/deadline/reset/USB behavior and generation-tagged shutdown rules.
    Review current firmware interfaces and component limits; document bounded
    HOLD/DOR changes, protection and parked-current decisions, unresolved
    engineering work and separate physical acceptance gates.
    Add 14 conditional contract checks alongside the 19 preserved checks.
    Keep all eleven imported engineering artifacts byte-identical and leave
    firmware, hardware implementation and manager-owned coordination unchanged.
    Return the electrical candidate for independent firmware review.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
    [check_interface_contract.py]
2026-10-28 Record LRA-01 return and prepare bounded LRA-02 continuation
    Record logger-power claimant and candidate a85f185 without accepting or merging
    its electrical contract. Prepare a no-bench continuation for R03 component
    limits and R04 parked current, with exact owned paths and preserved originals.
    Independent firmware review and manager technical review remain pending.
    Reviewed handoff/follow-up gates and staged coordination contents; local links
    and diff checks pass. The engineer's reported 33 checks were not rerun here.
    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
2026-10-28 logger-power: select component candidates and audit parked-current margins
    Return the bounded LRA-02 capacitor/BOM and condition-specific leakage package.
    Preserve topology and original artifacts; document conditional QP/clamp and
    clock-buffer changes, unresolved current guarantees, and physical review gates.
    Validation: 44 checks; 11 original hashes; three CSV structures; staged diff review.
    Agent-Session: logger-power
    Codex-Session-ID: 01a18463-5ed7-7041-ad90-ec3a7480c4e6
    [BOM_DELTA.csv]
2026-10-29 logger: add opt-in qualified IGN/HOLD power lifecycle
    Keep manual power as default. Add a core-1 hardware alarm supervisor,
    monotonic shutdown policy, bounded two-core watchdog health, complete-line
    quiescence and serialized storage generations. Describe power qualification
    in per-file metadata and preserve existing CSV semantics.
    Validate nine native suites, sanitizer checks, twelve public converter cases,
    44 electrical checks and both dummy-credential builds with zero warnings.
    Document SDK interrupt-masking limits and required firmware/bench review.
    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
2026-10-29 Record original inventory reference and defer stock reconciliation
    Owner identifies the original inventory and four additional P6KE30As. Record incomplete/possibly consumed stock and defer exact counts until parts discussions. Stage only manager coordination files; preserve ongoing as-built work.
    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
2026-10-29 Make LRA-04 dispatchable against reviewed power constraints
    Replace stale HOLD alternatives and transition base with current 01/02/05 inputs. Distinguish comparison readiness from electrical freeze, supply current/off-state/resource boundaries, and allow browser document returns without Git tools.
    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
2026-10-29 Review LRA-03 return and record required corrections
    Verify 65 submitted arithmetic checks and 17 pinned source records. Request coherent fitted-status updates, corrected filter/threshold calculations, conditional opto claims, open input-selection gates and accurate inventory wording. Preserve the specialist branch unmerged; no firmware or hardware changes.
    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
2026-10-29 logger-asbuilt: consolidate the fitted logger and propose Rev A interfaces
    First LRA-03 return. Adds logger/hardware/as-built/ with a traceable record of
    the circuit that physically exists and a separate proposal for the Rev A
    interface freeze, keeping fitted, specified and unknown explicitly apart.
    AS_BUILT.md records the circuit matrix with a confidence class per row, the
    evidence precedence the source record itself forces, per-block detail for the
    three digital cluster cells, the two ADC channels, grounds, ignition, SD and
    supply, an eight-row conflict register and an unknown register with a named
    owner and proposed resolution each, plus an evidence index tying every fitted or
    measured a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
2026-10-29 logger-asbuilt: apply manager review R03-REV-1 through R03-REV-6
    Addresses coordination/reviews/LRA03_REVIEW_2026-10-29.md. All six findings
    accepted; none disputed. Two were substantive technical errors in the first
    return, the rest overclaims, stale prose and reference repairs.
    R03-REV-2, ADC filter model, corrected. The specification's section 4 diagram
    puts the capacitor on the GPIO side of the fitted 1k, so the resistance charging
    it is the divider Thevenin plus that 1k: fuel 3889.34 ohm giving 40.92 Hz,
    supply 4872.66 ohm giving 32.66 Hz. The first return used the Thevenin alone and
    reported 55.1/41.1 Hz, taken from the historical specification's own prose,
    which inherited the same om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
    [check_as_built_numbers.py]
2026-10-29 coordination: record the LRA-03 integration and the manager handover
    The previous manager session ended with the LRA-03 merge prepared but
    uncommitted. This session reviewed, repaired and committed it as dc07292, and
    now holds the manager role.
    PROJECT_MILESTONES.md: LRA-03 moves from "revisions required" to integrated,
    with the verification rerun on the merge result and an explicit statement that
    integration accepts no hardware and freezes nothing. DOC-01 and the authority
    bullet name this session; the predecessor bookmarks stay as history. The next
    action records that a browser LRA-04 return has arrived and awaits triage.
    AGENTS.md: the current manager claim names this session and keeps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
2026-10-29 coordination: record the working push command in the shift-close handoff
    The handoff said the shift's commits were unpushed and that no credential was
    reachable. Both are now wrong: main and archive/reviews/LRA03-a9c828b are on
    the remote.
    The cause was narrower than stated. ~/.ssh/id_ed25519_accord_public is the key
    for this repository, but there is no ssh-agent and no ~/.ssh/config, so a bare
    git push over SSH never offers it and fails with Permission denied (publickey).
    Naming the key with core.sshCommand and IdentitiesOnly works. The handoff now
    carries that command and distinguishes this key from id_ed25519_accord_logger,
    which belongs to the historical repository.
    Agent-Session: pcb-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
2026-10-29 coordination: record that the keyless MAX3485 is fitted in an IC socket
    Owner statement, October 29: the keyless board has a MAX3485 fitted, in an IC
    socket. Recorded as D-KEYLESS-485-01 so it is never re-asked, and folded into
    R04-REV-3 of the LRA-04 review.
    This settles the population question against the first version of that finding,
    which leaned on accord-keyless.ino lines 5-6 and guessed wrong. Those lines are
    stale on both counts: the part is present, and socketed rather than soldered.
    The comment is in keyless/, which belongs to the keyless role, so it is recorded
    for that owner and not edited here.
    The return's "proven on keyless" is still an overstatement, for the other half
    of t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
2026-10-29 reviews: withdraw R04-REV-3; the keyless RS-485 bus was extensively tested
    Owner statement, October 29: the keyless MAX3485 is fitted in an IC socket and
    the RS-485 link was tested extensively from the Pi 4, with commands of the form
    ./hp out lock pulse, ./hp io and ./hp status.
    The finding is withdrawn. The return's "proven on keyless" was accurate and
    this review was wrong twice: first guessing the part was unpopulated, then
    conceding it was fitted but calling bus operation unrecorded. Both readings
    came from treating accord-keyless.ino lines 5-6 as current fact. The LRA-04
    packet warns in as many words to confirm populated hardware and operational bus
    evidence separately from stale firmw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
2026-10-29 coordination: right-size KEY-02; the bench tooling blocks nothing today
    KEY-02 was logged at a priority the facts do not support. Checked: no active
    task needs hp or cm5sim. The LRA-04 corrected pass needs the recorded fact that
    the bus was exercised, not the host tool, and the wire-format evidence is
    keyless/firmware/accord-keyless/link.h:221, already in the repository. The
    logger firmware contains no reference to RS-485 or cm5sim, so the bus is
    keyless-only and the logger needs nothing here. LRA-07 is blocked on other
    grounds.
    The defect is narrower than "recover the tooling": the migrated firmware names
    cm5sim four times as the counterpart to run, and the repository does not ship
    it, so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
2026-10-29 keyless: fix the dead cm5sim reference and the stale U5 comments
    On owner instruction. keyless/ is nominally the keyless role's artifact; the
    owner directed this fix, which overrides that convention for this change.
    The sketch named cm5sim four times as the host tool to run, and cm5sim is bench
    tooling that was never migrated, so a reader of this repository followed a
    reference to a file that is not here. The header now states once what cm5sim is
    -- the host-side CM5 stand-in, the bus's only initiator, usually reached
    through the hp shortcut -- and that it is kept with the other bench scripts on
    the development host rather than in this tree. The later command lines are
    therefore usage notes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
    [accord-keyless.ino]
2026-10-29 Make LRA-06 dispatchable as a separate KiCad board project
    The tracker row led with "blocked for freeze on 01-04", which would send a
    fresh agent excavating 01-04 to discover it cannot start. Capture is not
    blocked; the freeze is. The packet says so first, caps the required reading at
    four document sections, and names the placeholder treatment for each
    unresolved item so none is silently omitted or speculatively resolved.
    Records the owner's October 29 direction on D-REUSE-01: template conventions
    and naming from the keyless project, build the logger as a distinct board at
    logger/hardware/kicad/accord-logger.*. Scaffolding and the LM2678T-5.0 symbol
    carry across, since the Rev A regulator r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
2026-10-29 coordination: claim LRA-06 schematic capture
    Record the LRA-06 claim in the single tracker: Claude logger-schematic,
    session 73d7d954-f82a-4038-8ff3-546a23fc5fa9, working on
    task/LRA-06-73d7d954 from main at 2b3acbf. State moves from ready to
    active with the claimant and starting revision; scope, placeholders and
    acceptance wording are unchanged.
    Agent-Session: logger-schematic
    Claude-Session-ID: 73d7d954-f82a-4038-8ff3-546a23fc5fa9
2026-10-29 Close U-10: B2 is live with the key out; narrow D4 to one branch
    Owner measurement, key out and parked, to chassis: B2 = 4.140 V, B1 = 0 V,
    C11 = 0 V. B1 and C11 are confirmed dead. B2 is energized while parked, which
    the record had listed as inferred and the design had assumed otherwise.
    Through B2's fitted 22k/33k divider, 4.140 V is 75.3 uA -- nine times the
    8/20 uA allocated to all five branches together, and three quarters of the
    whole-system 100 uA parked budget. Isolation is still required, but the
    parked-drain justification now covers one branch instead of five, and that one
    is a digital pulse input rather than an analog channel. If the analog reviewer
    agrees C11 and B11 need no swi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
2026-10-29 coordination: record the LRA-06 schematic capture return
    Move LRA-06 from active to returned: candidate daae9b2 on the pushed
    task/LRA-06-73d7d954, rebased onto 21dfd16, awaiting manager review and
    not integrated. Record the verification that accompanies it, the two
    questions that need an electrical decision rather than a redraw, and the
    D4 treatment under D-OFFSTATE-01.
    Nothing is integrated, accepted or frozen by this update, and no part,
    ratio, pin assignment or hardware action is authorised by it.
    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
2026-10-29 Measure B2's parked source: 7.03k, and 75.3 uA is real
    Owner lifted the VSS wire and read B2 open-circuit: 4.669 V, against 4.140 V
    into the fitted 55k divider. That pair gives a parked source impedance of
    7.03 kohm and settles the question left open this morning -- 75.3 uA is
    flowing today, not an upper bound on it.
    B2 is therefore held up by an always-on pull-up of about 7 kohm to roughly
    4.67 V, which is the first actual source measurement on that branch and
    partially closes U-08. One consequence worth the analog reviewer's eye: that
    pull-up already sinks about 664 uA whenever the PCM pulls B2 low, so the
    logger's divider adds roughly 11 percent to a load the output already carries.
    The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
2026-10-29 Record measured back-feed into the dead 3V3 rail; U-08 is conditional
    Owner, everything wired and the Pico unplugged: the band side of the 3V3-rail
    clamp diodes reads 0.883 V to chassis. So B2's parked injection forward-biases
    a clamp and drives roughly 85-105 uA into a rail that should be at zero. The
    off-state path matrix in REV_A_INTERFACES section 6 says nothing in it is
    established; this establishes the B2 row by measurement. D4 on B2 now rests on
    a back-feed into an unpowered board, not only on a drain figure.
    This also makes the source resistance committed in efa1d63 conditional, and
    that commit should not be quoted as it stands. Deriving 7.03 kohm assumed the
    loaded 4.140 V reading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
2026-10-29 Correct B2: one branch draws 134-141 uA and back-feeds the 3V3 rail
    Owner clarified that all three VSS readings share one configuration, and that
    I had misread it: dividers, clamps, Pico module and SD module are all seated
    throughout, with only the USB lead pulled so the buck is not powering the
    board. "Not plugged in" meant unpowered, not physically removed.
    That means the clamp was conducting during the tap readings, which invalidates
    two figures committed earlier today:
    - 75.3 uA (efa1d63, 21dfd16) assumed the 55k divider was the only load. With
    the clamp conducting, draw on B2 is 134-141 uA across a 0.15-0.30 V clamp
    forward drop. One branch alone exceeds the 100 uA whole-system pa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
2026-10-29 logger-schematic: capture Rev A as a new KiCad project (LRA-06)
    New KiCad 9 project at logger/hardware/kicad/, captured from the four
    documents the packet names and nothing else: the REV_A_INTERFACES pin map,
    grounds, connectors, test points and delta list; the AS_BUILT circuit matrix,
    ignition cell and SD section; power/DESIGN.md section 3 with its BOM; and the
    keyless validation method.
    Captured: the Pico W Rev A pin map, the five fitted input cells with no value
    changed, the fitted ignition opto cell, the 9527a14 power block with deltas D7
    and D13, the HOLD driver (D2), SD with its new bulk capacitor (D6), connectors
    J1-J5 and the full test-point set with the RUN reset link (D8).
    Four b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
    [BOM.csv, accord-logger.kicad_sch]
2026-10-29 logger-schematic: correct the B2 isolation annotation to the measured back-feed
    The B2 D4 annotation carried two figures that the owner's configuration
    clarification superseded. Every VSS reading was taken with the dividers,
    clamps, Pico module and SD module seated and only the USB lead pulled, so
    the clamp conducts and the divider was never the only load.
    Corrected, following AS_BUILT U-08/U-10/U-14 and REV_A_INTERFACES D4 at
    9b24eda:
    - B2 draws 134-141 uA, not 75.3 uA, at 4.140 V loaded against 4.669 V
    open-circuit.
    - 99-110 uA of that is back-fed into the Pico's unpowered 3V3 rail through
    a forward-biased clamp, measured at 0.883 V on the clamp cathodes.
    - One branch alone exceeds t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
    [BOM.csv, accord-logger.kicad_sch]
2026-10-29 coordination: point LRA-06 at the corrected capture candidate
    The recorded LRA-06 hash predated the B2 correction and the rebase. Point
    the row at 49946c6 on task/LRA-06-73d7d954, rebased onto 9b24eda, and note
    that the B2 isolation annotation now carries the revised D-OFFSTATE-01
    back-feed figures rather than the superseded 75.3 uA and 7.03 kOhm.
    Still awaiting manager review and still not integrated.
    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
2026-10-29 Close B2 exactly: 140.8 uA parked, 109.2 uA of it into the 3V3 rail
    Owner read the 22k/33k junction at 1.041-1.043 V, which removes the last
    assumption. Four readings in one configuration -- 4.669 V open-circuit,
    4.140 V loaded at the tap, 1.042 V at the junction, 0.883 V on the clamp
    cathodes -- now fix the branch with nothing estimated. The third decimal place
    moves the result by about 0.1 uA and does not matter.
    B2 draws 140.8 uA while parked. Only 31.6 uA of that reaches ground through
    the 33k; 109.2 uA is back-fed through a forward-biased clamp into the Pico's
    own 3V3 rail. One branch is 141 percent of the entire 100 uA whole-system
    parked budget and 17.6 times the 8 uA allocated to al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
2026-10-29 logger-schematic: put the exact B2 figures on the drawing, and point at U-07
    The owner's 22k/33k junction reading removed the last assumption behind the
    B2 annotation, so the ranges are replaced with the measured values from
    AS_BUILT U-07/U-08/U-14 and REV_A_INTERFACES D4 at bcac2e7:
    - 140.8 uA drawn, was 134-141.
    - 109.2 uA back-fed into the Pico's unpowered 3V3 rail through the forward-
    biased clamp, was 99-110; only 31.6 uA reaches ground through the 33k.
    - Parked source 3,757 ohm, was 3.8-3.9 kOhm.
    - One branch is 141 percent of the whole 100 uA system parked budget and
    17.6x the 8 uA allocated to all five.
    The four readings that fix it with nothing estimated are on the drawing and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
    [BOM.csv, accord-logger.kicad_sch]
2026-10-29 coordination: point LRA-06 at the exactly-measured B2 annotation
    Advance the recorded LRA-06 candidate to 5fb1598 on
    task/LRA-06-73d7d954, which carries the exact D-OFFSTATE-01 figures in
    place of the ranges, the four readings behind them, and the tabulated
    list of superseded figures.
    Also note the U-07 pointer the capture now carries, so a reviewer knows
    it is recorded as a pointer and that LRA-06 did not act on D11.
    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
2026-10-29 Review LRA-06 candidate 5fb1598: one blocking revision, one escalation
    Verified independently from the netlist, BOM and library tables rather than
    from the return message. The pin map matches REV_A_INTERFACES section 1
    exactly, with every pin required to stay free genuinely unconnected. Clamp
    orientations are correct throughout, confirmed by resolving Diode:1N5819
    through its extends chain to establish that pin 1 is the cathode. Isolation
    placeholders sit upstream of the divider tops as D4 requires, divider values
    match AS_BUILT section 2 with nothing changed, both library tables are
    KIPRJMOD-relative, ERC is 0 from the JSON, and the merge that reconciled the
    rebase is honest: 49946c6 is a t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
2026-10-29 logger-schematic: bond the cluster ground sense to the single ADC return
    Applies review findings R06-REV-1 (blocking) and R06-REV-3 (minor) from
    coordination/reviews/LRA06_REVIEW_2026-10-29.md.
    R06-REV-1. J2.6, the B16 cluster ground-sense conductor, was left on a net
    of its own containing only itself and the optocoupler LED cathode. It never
    joined the node carrying both ADC divider bottoms, their filter and clamp
    returns and the Pico's AGND pin, so both ADC channels referenced local
    analog ground and any cluster-to-logger offset landed uncorrected in the
    fuel and supply readings. That is the error B16 exists to prevent, and it
    contradicted AS_BUILT section 2 row 8, REV_A_INTERFACES sectio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
    [BOM.csv, accord-logger.kicad_sch]
2026-10-29 coordination: record the LRA-06 revisions as applied
    R06-REV-1 and R06-REV-3 are applied in candidate 1d14604, which
    supersedes 5fb1598. Record the bonded ADC return node and its ten
    members, and that the verification script shared the misreading that
    let the defect through and now asserts the node directly.
    R06-REV-2 stays with the electrical lead and is untouched by this.
    Nothing integrated or frozen.
    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
2026-10-29 R06-REV-4: the input TVS is reversed, and ERC cannot see it
    Found on a second pass, auditing all fourteen diodes against DESIGN.md
    section 3 and AS_BUILT rather than spot-checking. Thirteen are correct: every
    clamp, both ADC pairs correctly opposed, DREV, DZ, DCATCH, DOR, DI and DR.
    D111 is not. The BOM specifies a Vishay 1.5KE30A-E3/54, which the plain A
    suffix makes unidirectional. The footprint D_DO-201AD puts the banded cathode
    end on pad 1, confirmed from the silkscreen band at x 2.9-3.1 against pad 1 at
    x 0 and pad 2 at x 12.7. The netlist puts pad 1 on PGND and pad 2 on P12, the
    opposite of DESIGN.md's "P12 -- TVS cathode; TVS anode -- PGND". Built that
    way the part is a forward-bias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
2026-10-29 logger-schematic: correct the reversed input TVS, and assert hidden polarity
    Applies review finding R06-REV-4, blocking, from
    The input TVS was drawn backwards: D111 pin 1 on PGND and pin 2 on P12,
    against DESIGN.md section 3, which puts the cathode on P12. The specified
    Vishay 1.5KE30A-E3/54 is unidirectional, so built as drawn it is a
    forward-biased rectifier across the supply: it conducts at about a volt and
    shorts P12. Pin 1 now goes to P12 and pin 2 to PGND, and the symbol is
    rotated so pin 1 sits at the top and the drawing reads correctly.
    Verified before changing anything: the footprint puts pad 1 at x=0 with the
    silkscreen band at x=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
    [BOM.csv, accord-logger.kicad_sch]
2026-10-29 coordination: record R06-REV-4 as fixed in the LRA-06 candidate
    Candidate c66fba6 supersedes 1d14604 and corrects the reversed input TVS:
    pin 1 to P12, pin 2 to PGND, verified against the footprint's banded end
    rather than against the symbol, which cannot express polarity at all.
    Record the generalization as well as the fix, since it is the reusable
    part: every part whose symbol cannot carry its orientation is now
    asserted by pin number, and a guard fails if a future part arrives
    orientation-opaque and unasserted.
    Nothing integrated or frozen. R06-REV-2 remains with the electrical lead.
    Claude-Session-ID: 73d7d954-f82a-4038-8ff3-546a23fc5fa9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
2026-10-29 Close LRA-06 review: candidate c66fba6 is electrically sound
    All four revisions closed and verified from the committed netlist rather than
    from the return. D111 pin 1 is now on P12 and pin 2 on PGND, the full
    fourteen-diode polarity audit re-run clean with no regressions, B16 still
    bonded with ten members on the ADC return node, ERC 0, 224 of 224 checks.
    The orientation-opacity guard was tamper-tested rather than trusted: reversing
    D111 in a copy of the netlist makes the suite fail, naming the banded end, the
    footprint pad, the DESIGN.md line and the unidirectional part. It fails
    closed, and it derives opacity from the netlist rather than from a maintained
    list, so a future bidirectional-sy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
2026-10-29 coordination: record the LRA-06 integration onto main
    The capture is now in the default checkout at logger/hardware/kicad/, so an
    agent picking up LRA-08 finds the baseline the tracker points at instead of an
    empty directory. Checks re-run from main: 224 of 224.
    Still not a freeze. R06-REV-2 is open with the electrical lead, layout is
    blocked on U-11 and on part selection, and nobody has looked at the sheet.
    Claude-Session-ID: 630dea87-5e4d-4bad-a1ff-d41b3a5f509b
    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
2026-10-29 Partially close U-11: generic rectangle, and the size reference is too small
    Owner direction: the Rev A board is a generic rectangle with no enclosure and
    no mounting method chosen, carrying the Pico module, the SD module and the
    remaining circuitry. Mounting behind the gauge cluster was considered and set
    aside. SD needs a 1x6 vertical header plus roughly a 16 mm square. The size
    reference offered is the present bench footprint, an 82x55 mm half-size
    breadboard plus a 46x36 mm mini.
    Recorded with a caution, because that reference is the as-built and Rev A is
    not. The breadboards carry dividers, clamps, the opto, the Pico and the SD
    module. Rev A adds the whole onboard power block -- QP, th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
2026-10-29 Close U-11: the board is a generic 80 x 120 mm rectangle
    Owner decision. No enclosure, no mounting method chosen, gauge-cluster
    mounting considered and set aside. SD module is 16 x 16 mm plus its 1x6
    vertical header, confirming the reading taken when the figure was ambiguous.
    80 x 120 is 9,600 mm2 against 5,031 mm2 of raw captured component area, a 1.9x
    routing allowance, which clears the 8,000 mm2 floor the earlier estimate put
    on it with real but not generous margin -- ten parts are still unassigned and
    will eat into it. The owner's first reference, the present bench footprint at
    82x55 plus a 46x36 mini, was too small because those breadboards carry only
    the as-built; this supersedes it.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
2026-10-29 Scope D4 as LRA-11: stop B2 energizing the board while parked
    Carved out of LRA-02 and given its own row because it is the one item on the
    critical path. LRA-06 is integrated and the envelope is fixed, so the live
    path is now 11 -> 08 -> 09 and this is all that stands between here and
    layout.
    The packet leads by correcting its own sources, because REV_A_INTERFACES
    section 3 predates the owner's October 29 measurements and reads much harder
    than the job now is. Scope is B2 alone, since four of five branches measured
    dead with the key out. That gives the whole 8/20 uA allocation to one part
    instead of splitting it five ways, and drops the 25 ohm fuel and 100 ohm
    supply top-leg limits entirely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
2026-10-29 Audit the coordination documents and correct four that had drifted
    Checked every coordination document, handoff, review and hardware README
    against today's state rather than assuming the running updates had covered
    them. Four had drifted; the dated reviews are left alone as point-in-time
    records, which is what they are for.
    PCB_MANAGER_TRANSITION_2026-10-29 was the worst. It was written at 06:38 as a
    shift-close handoff and the shift then ran all day, so its entire "Next
    actions" section is finished or overtaken, and it still said the LRA-04 review
    carries six findings when R04-REV-3 was withdrawn at 564bd7d. A successor
    reading it would have re-run completed work against a wrong finding co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
2026-10-29 LRA-11: isolate B2 with a photo-MOSFET relay specified hot
    Resolves D4 for the one vehicle branch that is live while parked. Recommends a
    Broadcom ASSR-601JV in series with the B2 divider top leg, LED driven from the
    switched B5 rail through a GPIO-gated low-side FET.
    The deciding point is requirement 2. Nearly every photoMOS quotes its
    off-state leakage maximum from a table headed 25 C and publishes nothing at
    85 C, which is the same unqualified-number defect that disqualified the
    ADG5412F. Broadcom states its DC maxima "over recommended operating
    conditions", and the I_O(OFF) row carries no temperature override where the
    withstand row immediately above it explicitly does. So 1 uA max at 8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
    [check_b2_isolation.py]
2026-10-29 Consolidate logger/NEXT_AGENT.md: live content, rotten framing
    The content is still load-bearing. The secrets.h gate is genuinely unconsumed
    -- no private header exists in this tree -- and AGENTS.md links here for it.
    The LRA-05 test, build and rollback commands are current.
    The framing had decayed. Three dated banners had stacked in reverse order, so
    a reader had to reconcile October 27, 28 and 29 statements that partly
    contradicted each other, and one claim was simply false: the file says
    receiver/server migration is deferred, but logger/server/ now holds the raw
    receiver and trip conversion core. The October 28 banner requiring interface
    agreement before implementation is also overtaken,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
2026-10-29 Review LRA-11: accept the ASSR-601JV candidate, one finding, one open claim
    Verified independently rather than from the return. Both corrections it makes
    to my own packet are right and the packet was wrong: raising the divider 10x
    gives 19.7 uA, not the ~14 uA I scaled linearly, because the unpowered rail's
    leakage load is a roughly fixed 8,083 ohm derived from the measured state and
    does not scale with the divider. Lifting the external clamp puts GP2 at
    2.622 V, confirmed exactly.
    Its most valuable result is not the part. The diode that back-feeds is the
    RP2040's own pin-to-IOVDD ESD structure, which cannot be removed, so clamp
    changes cannot close this on any branch and rows 1-5 of REV_A_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
2026-10-29 Record D-POWER-03: the keyless board already is the logger power front end
    Owner correction, and it holds. I had been discussing R02 as an open
    protection question while a working implementation sits on the sibling board
    in the same car. Verified by kicad-cli BOM export from the keyless schematic
    rather than from memory or documentation.
    Five part numbers are identical -- LM2678T-5.0, 1.5KE30A TVS, 820 uF output,
    100 uF input, 10 nF boost -- and the catch and reverse-blocking diodes are
    functionally equivalent 3 A Schottkys. The inductor is the same 22 uH value in
    a larger 2 A package. The only real delta is the autonomous switching, QP,
    QI/QH, DZ, DOR and MAX_ON, which keyless does not nee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
2026-10-29 coordination: resume manager role for layout closure
    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
2026-10-29 coordination: make working hondaPico reuse the explicit design baseline
    Record owner clarification: integrate the working base, existing logger cells and IGN-controlled shutdown addition. Supersede the contradictory copy-no-circuit wording and require concrete justification for changes to inherited blocks. Documentation-only; reviewed exact staged content for public safety.
    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
2026-10-29 docs: audit core project summaries and record LRA-12 handoff
    Record the owner-confirmed remote LRA-12 start and temporary usage wait,
    with session/branch metadata explicitly pending. Preserve the assigned
    implementation scope and existing KiCad project; prevent duplicate dispatch.
    Add the current manager handoff and standing core-document audit policy.
    Refresh stale hardware context and firmware README statements from current
    source and owner records. Make Git, detailed reviews and session transcripts
    optional deeper history rather than required onboarding.
    Validation: reviewed staged public content; changed Markdown links resolve;
    diff whitespace checks pass. Documentation only; no firmwa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
2026-10-29 coordination: record Claude manager takeover and LRA-12 claimant
    Claude pcb-manager 42dd0e33 takes over the manager role at the owner's
    request. Record the owner-supplied LRA-12 claimant (Claude session
    b690946d, branch task/LRA-12-b690946d, local worktree accord-lra12) and
    correct "remote" to local. At takeover that branch was at 5ffcb26 with a
    clean tree. Documentation only.
    Claude-Session-ID: 42dd0e33-28b5-4936-847e-9c2e1d2488fa
    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
2026-10-29 LRA-12: resolve all eight placeholders into a routable design
    Completes the LRA-06 capture into a complete electrical design the owner can
    place and route on 80 x 120 mm. Every populated part carries a checked
    footprint, ERC is clean at --severity-all, and no placeholder remains.
    X7, the entry voltage envelope, is one forced chain rather than a menu. The
    only P-FET the record found with a hot zero-gate leakage maximum that fits the
    200 uA switch allocation is the IPD50P04P4L-11 at 70 uA/125 C, where the
    IRF4905 screens 250 uA and cannot. That part is rated -40 V, so the clamp has
    to hold below 40 V, which rules out the inherited 1.5KE30A at 41.4 V - the
    same 41.4 V that already exceeded QI/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
    [BOM.csv, accord-logger.kicad_sch, courtyard_study.csv]
2026-10-29 LRA-12: return handoff, residual gates and layout guidance
    Records the return for the manager's review: the eight decisions with their
    one-line reasons, every changed artifact against the packet's single edit
    scope, the command results, and the exact KiCad entry point with the warning
    that the schematic and BOM are both generated from one parts table, so an
    electrical change belongs in the generator rather than the .kicad_sch.
    The layout guidance is the part the owner needs: the 1.52x courtyard fit with
    the three reductions available if placement does not close, the four blocks
    that want to stay together, the buck switching loop, the two-area return
    strategy with the warning that AGND and P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
2026-10-29 coordination: record LRA-12 return, review pending
    Record the LRA-12 return by Claude logger-electrical b690946d on
    task/LRA-12-b690946d (7ec53da design, ad4f918 handoff), based on 5ffcb26.
    Author/committer identities and session trailers verified at fetch. The
    return's validation figures are recorded as its claims, not yet rerun;
    its three requested dispositions and the open visual check are listed.
    Not integrated. Documentation only.
    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
2026-10-30 coordination: record D-OVERVOLT-04, defer sustained-overvoltage exclusion
    Owner decision on LRA-12 L04: Rev A takes no added cutoff circuitry and
    carries sustained P12 overvoltage above the 1.5KE20A standoff as a named
    residual risk for vehicle acceptance, explicitly including an alternator
    overcharge fault, not only a 24 V jump start. Conditional on the LRA-12
    review confirming the clamp chain. Documentation only.
    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
2026-10-30 coordination: review LRA-12 return, one revision requested
    Rerun at ad4f918 in a detached worktree: generators reproduce the
    committed symbols/BOM byte-for-byte and the schematic up to UUIDs; ERC 0
    at all severities, netlist identical, 652/652 capture checks, 1.52x
    courtyard allowance, closure script exit 0. Independent netlist checks of
    QP, DZ, DREV, both TVS, LM2678, TPS709 and the ASSR footprint pin map.
    R12-REV-1: the clamp chain is not forced. Vishay SQD50P06-15L (-60 V,
    AEC-Q101, TO-252, IDSS 50 uA max at 125 C) fits the parked budget, so
    retaining the in-service 1.5KE30A must be re-evaluated. R12-REV-2:
    restate L04 as sustained P12 above 17.1 V. L07 re-allocation accepted
    by the mana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
2026-10-30 coordination: package LRA-12R clamp rework for a fresh session
    The original LRA-12 session will not be resumed. Package R12-REV-1
    (re-evaluate the 1.5KE30A with a 60 V SQD50P06-15L switch), R12-REV-2
    (name the sustained-overvoltage exposure correctly) and new R12-REV-3
    (deterministic generator UUIDs before owner placement) as one bounded
    packet based on ad4f918. Link it from the tracker, review and handoff
    index. Claimant pending. Documentation only.
    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
2026-10-30 coordination: record LRA-12R claimant
    Owner reports Codex session 01a18a47-2dc2-7aa3-a0d2-a4978e2b1ebc is
    working the LRA-12R clamp rework. Branch not yet visible. Documentation
    only.
    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
2026-10-30 LRA-12R: correct clamp rationale, A5 thermal screen and schematic identities
    Verify SQD50P06-15L as a valid hot-specified 60 V alternative; retain the
    lower entry clamp for the logger A5 stage and LM2678 operating margin.
    Correct the overvoltage exclusion to include regulator overcharge.
    Raise R_AON to 820 ohm and account for zener junction heating, lead
    conditions and the actual 16 V leakage test point. Record the accepted
    allocation redistribution without changing 100/500 uA totals.
    Generate deterministic UUID5 identities and verify unchanged generation,
    placement/reannotation stability and uniqueness. ERC JSON: zero; capture:
    652/652; closure: 63/63; 141/141 footprints, 1.52x allowance.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
    [BOM.csv, accord-logger.kicad_sch, courtyard_study.csv]
2026-10-30 coordination: D-RS485-05, keyless RS-485 circuit onboard for Rev A
    Owner decision: Rev A carries the keyless MAX3485 RS-485 circuit with the
    same footprints, flexible for an unknown topology. Replaces LRA-12's
    passive J3 header, and closes the LRA-04 bus comparison for Rev A. Add
    the implementation to the LRA-12R packet as R12-REV-4, with the source
    circuit read from the keyless netlist, the 270/390 ohm bias discrepancy,
    jumpered bias and termination, and the power-off bus paths to quantify.
    Documentation only.
    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
2026-10-30 coordination: record LRA-12R return; RS-485 addendum outstanding
    Codex logger-electrical 01a18a47 returned 50d93c8. Manager rerun
    reproduces byte-identical generation, ERC 0, 652/652 capture, UUID
    regression and 63/63 closure checks. REV-1 keeps the 1.5KE20A by stated
    choice with SQD50P06-15L verified; REV-2 and REV-3 addressed. REV-4,
    the onboard keyless RS-485 circuit, is not implemented. Not integrated.
    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
2026-10-30 coordination: record the owner's connector statement (D-CONN-06)
    The owner's October 29 statement to the previous Claude manager -
    single connector if moved to a permanent 12 V feed, a 10-pin Molex-style
    right-angle connector in stock, the IL-AG5-14P option, Molex versus JAE
    undecided - was only partly recorded. Recover it from that session's
    transcript. Selection pending. Documentation only.
    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
2026-10-30 LRA-12R REV-4: reuse onboard keyless RS-485 with selectable bias
    Carry MAX3485, DIP-8 socket footprint, 0805 decoupling and axial
    bias/termination footprints from the exported keyless source. Assign
    GP8/9/10, retain tied enables and 10k pulldown, use directed 390 ohm
    bias values, and ship bias and termination headers without shunts.
    Trim J3 to GP13 and switched power; add owner-approved interim
    four-position Mini-Fit Jr for A/B/PGND/NC. Connector consolidation
    and placement are separate work.
    Record conditional external-bus currents and bias backfeed outside
    the ordinary parked allocation. Correct derived-symbol footprint
    inheritance so MAX3485 matches its library without ERC exclusions.
    V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
    [BOM.csv, accord-logger.kicad_sch, courtyard_study.csv]
2026-10-30 decisions: single 10-pin Molex 39-30-1100 board connector (D-CONN-06)
    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
2026-10-30 logger hardware: single 10-way J1 board connector; docs to current state
    Owner decision D-CONN-06: the owner's in-stock Molex 39-30-1100
    (Mini-Fit Jr. 5569-10A2) replaces the 2-way J1, the 8-way J2 and the
    interim 4-way RS-485 J485. Cavities: 1 BATT_IN, 2 B11, 3 B1, 4 C11,
    5 RS485_A, 6 PGND, 7 AGND/B16, 8 C14, 9 B2, 10 RS485_B. The footprint
    geometry matches the owner's own CON_39301100 file.
    check_capture.py asserts the full pin map, that J1 is the only harness
    connector, and, from the installed footprint's pad positions, that
    BATT_IN's physical neighbours are only PGND and the clamped B11 input
    and that A/B are adjacent.
    Results: ERC 0 at severity-all, 721/721 capture, UUID regression pa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
    [BOM.csv, accord-logger.kicad_sch, courtyard_study.csv]
2026-10-30 logger hardware: J1 becomes the JAE IL-AG5-14P-D3L2-A board connector
    Owner revision of D-CONN-06: the 14-contact JAE IL-AG5 (Honda's style,
    sibling of the keyless 22P) replaces the 10-pin Molex, adding a dedicated
    RS-485 ground and three spares. Pin map, mating face: 1 A, 2 bus GND,
    3 B2, 4 B1, 5 B11, 6 BATT_IN / 7 B, 8 spare, 9 C11, 10 AGND, 11-12 spare,
    13 C14, 14 PGND.
    The footprint is generated by tools/gen_fp_ilag5.py, generalised from the
    keyless 22P generator and the JAE right-angle hole pattern (A 20.0,
    B 26.5, C1 12.5; outer row 6, near row 8). check_capture.py asserts the
    generator reproduces the keyless 22P exactly, that the committed 14P is
    its output, and, from the real pad po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
    [BOM.csv, accord-logger.kicad_sch, courtyard_study.csv]
2026-10-30 logger hardware: Rev A board file with outline and M3 corner holes
    Create accord-logger.kicad_pcb with tools/gen_board_outline.py: 80 x 120
    mm Edge.Cuts (D-ENVELOPE-01) with the keyless board's 2 mm corner radii,
    and four board-only MountingHole_3.2mm_M3 (unplated, so no ground is tied
    to the mounting) 4 mm in from each edge. Keyless's own holes fit its
    enclosure posts and are not a generic template. The script refuses to
    overwrite an existing board, since the layout is now the owner's.
    Verified by reloading with pcbnew: one closed outline, 80.0 x 120.0 mm,
    9596.6 mm2; holes at 4.0 mm insets, 3.2 mm NPTH, board-only. DRC 0
    violations; parity lists only the 148 parts still to import. Note in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
    [accord-logger.kicad_pcb]
2026-10-30 layout: parts imported, board rotated landscape, Pico, J1 and SD placed
    Owner's layout in progress: Update PCB from Schematic (148 parts), board
    outline and holes rotated to 120 x 80 mm landscape (holes still 4 mm in
    from each edge), U1 Pico W, J1 JAE IL-AG5-14P and J5 SD header placed.
    No tracks or zones yet. KiCad added board design settings to the
    .kicad_pro; its erc section is intact.
    Committed on the owner's behalf.
    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
    [accord-logger.kicad_pcb]
2026-10-30 logger hardware: surface-mount conversion for board space (D-SMD-09)
    Owner: the 80 x 120 mm fit looked too tight; convert to SMD. One explicit
    table in gen_logger_sch.py applies the package changes after the parts
    are defined, so each original definition and source is untouched:
    43 resistors to 0805 (1206 for harness-facing divider tops, 12 V nodes,
    R_AON's 0.15 W at 85 C, and the swappable timer links), 14 disc caps to
    0805 X7R at no lower voltage (C0/CIB 100 V), five logic ICs to the SOIC
    M96 versions of the same TI parts, four 2N3904 to MMBT3904 with nets
    remapped by E/B/C role, nine 1N5819/1N4148 to SOD-123, 22 signal test
    points to 2 mm pads. Kept through-hole: the RS-485 block (keyless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
    [BOM.csv, accord-logger.kicad_sch, courtyard_study.csv]
2026-10-30 schematic and layout: RS-485 and tap areas rearranged; SMD footprints in
    Owner's hand edits: the RS-485 block and some vehicle-tap symbols moved
    on the schematic (labels reattached; ERC 0), and the board updated from
    the schematic with the D-SMD-09 surface-mount footprints. From here the
    hand-edited schematic is the master; the generator no longer rewrites it.
    Verified before commit: no pin changed net against 01197dc; capture
    checks 738/738 on this schematic's netlist; every board footprint and
    pad net matches the schematic.
    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
    [accord-logger.kicad_pcb, accord-logger.kicad_sch]
2026-10-30 kicad: hand-edited schematic is now the master; guard the generator
    The owner now arranges accord-logger.kicad_sch in KiCad. gen_logger_sch.py
    refuses to overwrite an existing schematic unless --force is given (for a
    scratch copy), so a regeneration can no longer discard the owner's edits.
    Validation exports (netlist, ERC, SVG) refreshed from the owner's file:
    ERC 0, 738/738 capture, UUID regression passes. COMMANDS.txt, STATUS and
    REV_A_CONTEXT describe the check loop on the hand-edited file and note
    that a part change must also update BOM.csv.
    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
    [gen_logger_sch.py]
2026-10-30 kicad: hand edited schematic; vehicle inputs, hold driver, RS-485
    [accord-logger.kicad_sch]
2026-10-30 kicad: refresh validation exports from the owner's 73fbfe1 schematic
    Drawing rearrangement only: ERC 0, 738/738 capture checks, and no pin changed net or part changed against bcb0c2c.
    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
2026-10-30 logger hardware: remove the onboard fuse; harness inline fuse instead
    Owner decision D-FUSE-10: no fuse on the board. In the hand-edited
    schematic, F1, its two stub wires and its BATT_IN/BATT_F labels are
    removed and DREV's label renamed, so BATT_IN runs J1.6 -> DREV anode;
    the order-gate note no longer lists a fuse family. On the board (pcbnew
    API, KiCad closed), the F1 footprint is removed and DREV pad 2 moved to
    BATT_IN; no other footprint moved. BOM row removed.
    Checks: ERC 0; 738/738 capture, with new checks that no fuse is fitted
    (tamper-tested by restoring F1 to the BOM) and that BATT_IN is exactly
    J1.6 and DREV; closure 67/67; every board pad net matches the schematic;
    courtyard all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
    [BOM.csv, accord-logger.kicad_pcb, accord-logger.kicad_sch, courtyard_study.csv]
2026-10-30 kicad: stage the board by subsystem; power, Pico, SD and J1 only
    Owner decision D-STAGE-11: build the board up chunk by chunk. New
    tools/board_chunks.py maps every part to one chunk (following the titled
    schematic frames; it refuses to run if any part is unmapped) and sets
    KiCad's "Exclude from board" flag per chunk: status / only / add.
    Now on the board: the power block (buck, entry protection, power switch,
    hold transistors; 23 parts), U1, J5 with C8, and J1, plus the four
    mounting holes. The other 120 parts are excluded in the schematic and
    their footprints removed from the board; no placed footprint moved and
    every remaining pad matches the schematic.
    kicad-cli omits board-excluded sym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
    [accord-logger.kicad_pcb, accord-logger.kicad_sch]
2026-10-30 kicad: LM2678 (U6) on the keyless StaggerOdd TO-220-7 footprint
    Owner (D-FP-12): use the TO-220-7 lead forming keyless U3 uses. U6 moves
    from TO-220-7_P2.54x3.7mm_StaggerEven to StaggerOdd in the schematic,
    BOM and board; on the board it keeps its position, rotation, pad nets
    and schematic link, and no other footprint moved. The two differ in
    which side of the odd-pin row the even pins sit, so the wrong one would
    only fit the part turned 180 degrees.
    check_capture.py now asserts UREG's footprint equals keyless U3's, read
    from keyless/hardware/hondaPico.kicad_sch: 739/739. ERC 0; full netlist
    otherwise unchanged; every board pad matches the schematic.
    Claude-Session-ID: 42dd0e33-28b5-4936-8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
    [BOM.csv, accord-logger.kicad_pcb, accord-logger.kicad_sch, courtyard_study.csv]
2026-10-30 kicad: hide U6's extra fields again after the footprint swap
    Owner noticed extra silkscreen text on U6. The 13b9ffd swap copied
    U6's Status, Source, MPN and Source_designator fields onto the new
    footprint as visible F.Silkscreen text; on the original U6, as on every
    other part, they are hidden. Restored each field's visibility, layer and
    size from the original. No footprint on the board now shows any field
    other than its reference on silkscreen.
    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
    [accord-logger.kicad_pcb]
2026-10-30 layout: power block placed, C8 at the SD header, first 22 tracks
    Owner's layout in progress: the buck, entry protection, power switch and
    hold transistors placed (17 parts on the board outline, others still
    being positioned), C8 at J5, and the first 22 track segments.
    Checked before commit: every footprint and pad net matches the
    schematic; no extra fields visible on silkscreen.
    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
    [accord-logger.kicad_pcb]
2026-10-30 schematic: power-block resistors and QI/QH back to through-hole (D-THT-13)
    Owner choice for the power block, in the hand-edited schematic and BOM:
    R31 (RGS), R33 (RI), R34 (RBI), R35 (RBH), R36 (RBIN) and R37 (RB5) move
    to R_Axial_DIN0204_L3.6mm_D1.6mm_P5.08mm_Horizontal. R32 (RG) stays on
    its 0.5 W DIN0414: a shorted gate zener puts 0.26 W in it. R33 needs
    >= 0.25 W (0.11 W at 17.1 V sustained); the rest are under 30 mW.
    Q6 (QI) and Q7 (QH) go back to 2N3904 on TO-92_Inline from the owner's
    stock. The symbol changes too (the 2N3904 library symbol cached before
    D-SMD-09, restored), because TO-92 numbers E-B-C and SOT-23 B-E-C; the
    pins sit in the same places, so every wire keeps its role.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
    [BOM.csv, accord-logger.kicad_sch]
2026-10-30 kicad: check every pin against a verified reference pin map
    A hand edit left R36 (RBIN) pin 1 floating and all 739 targeted capture
    checks still passed: none asserted RBIN's connection. check_capture.py
    now also compares every pin's net with validation/pinmap_reference.json,
    recorded from the verified 616eb14 netlist (named nets by name, unnamed
    ones by membership), so any unintended change fails wherever it is.
    --update-reference refreshes it after a deliberate, checked change.
    Verified: 740/740 on the committed netlist; on the owner's uncommitted
    schematic it fails with exactly "R36.1: /VIN_SW -> unconnected". That
    schematic is not committed. Flags given to check_capture.py are no longer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
    [check_capture.py]
2026-10-30 schematic: hand-edited drawing tidy-up; R36 reconnected
    Owner's hand edits to the schematic drawing. A first pass left R36 pin 1
    off its VIN_SW wire by one grid step; the owner reconnected it.
    Verified before commit: ERC 0; full netlist identical to the verified
    616eb14 design (no pin changed net, no part changed); capture 740/740
    including the every-pin reference check; closure 67/67.
    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
    [accord-logger.kicad_sch]
2026-10-30 kicad: refresh validation exports from the owner's schematic
    ERC 0; full netlist unchanged in connectivity; capture 740/740.
    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
2026-10-30 layout: power block placed on the board
    Owner's layout: all 27 power-block, Pico, SD and J1 parts on the board,
    with the D-THT-13 through-hole footprints applied from the schematic; 23
    track segments so far.
    Review at this commit (DRC on a scratch copy, schematic parity 0):
    - courtyard overlap R32 / C14, to fix;
    - the Pico's antenna end sits mid-board (keepout x 43-61 mm), USB at the
    left edge; Pico guidance wants the antenna at an edge;
    - buck loop distances (CIN-VIN 11, CIN- to GND 14, catch diode to SW 9,
    catch anode to CIN- 25 mm) match the in-service keyless layout within
    ~2 mm; tighter would still help;
    - U1 RF-keepout and J1 silk-at-edge items come from the footprints.
    Committ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
    [accord-logger.kicad_pcb]
2026-10-30 kicad: switch on the timer batch (a5_supply, hold, clock, cutoff)
    39 parts flagged back onto the board for the owner's Update PCB from Schematic. The timer needs the always-on A5 supply and acts on the HOLD path, so they come together; ignition chunks follow. ERC 0; full-netlist capture 740/740.
    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
    [accord-logger.kicad_sch]
2026-10-30 layout: Pico turned antenna-to-edge, buck loop tightened
    Owner changes after the first review:
    - U1 rotated 0 deg: antenna end at the bottom board edge, USB end inboard
    with its cable keepout clear to the top edge.
    - Buck rearranged around U6 (now 90 deg): hot loop CIN -> VIN -> SW ->
    catch diode -> CIN- is 12.7 + 10.1 + 11.4 mm (was 11.1 + 9.1 + 24.6;
    keyless 9.5 + 6.5 + 22.9). L1 to SW 7.1 mm (was 14.4).
    - R32/C14 courtyard overlap fixed.
    Review findings (scratch-copy DRC; schematic parity: only the 39 timer
    parts not yet pulled in):
    - J5's drawn SD-module courtyard (B side, x 110-126, y 119-136) covers
    the Pico antenna keepout from behind.
    - H4 hole edge reaches ~0.4 mm into the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
    [accord-logger.kicad_pcb]
2026-10-30 layout: buck bypass caps at U6, SD module beside the antenna
    Owner fixes after the second review (scratch-copy DRC; only the 39 timer
    parts are missing from schematic parity):
    - C11 (VIN ceramic) 2.6/5.7 mm from U6.2/U6.4, was 14 (keyless 3.2).
    - C12 (boost) 2.7/2.7 mm from U6.1/U6.3, was 12.7/10.5.
    - C13 2.5/2.6 mm from U6.6/U6.4.
    - C14 10.8 mm from L1's output, was ~30; C14- to D115 A 21.9 mm.
    - J5's SD-module outline moved off the Pico antenna (now x 120.8-137.1,
    3.8 mm clear of the antenna keepout).
    - Dangling P12 stub removed.
    Hot loop unchanged (12.7 + 10.1 + 11.4 mm). Remaining: H4 hole edge in
    the RF keepout (NPTH; use nylon hardware), silkscreen tidy-up.
    Claude-Session-ID: 42dd0e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
    [accord-logger.kicad_pcb]
2026-10-30 decisions: D-RTC-14, DS3231 chip on the board
    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
2026-10-30 layout: H4 moved 1.08 mm inboard, clear of the Pico RF keepout
    Hole edge now at y 136.22, the keepout starts at 136.76. H4 is no longer
    4 mm from the bottom edge like H2 (134.62 vs 135.70).
    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
    [accord-logger.kicad_pcb]
2026-10-30 schematic: DS3231 real-time clock on the board (D-RTC-14)
    New frame on the sheet: U16 DS3231SN (SOIC-16W) on I2C0, GP20 SDA,
    GP21 SCL, GP22 INT/SQW (the three no-connect flags on the Pico replaced by
    labels). VCC, C25 and the R50/R51 4.7k and R52 10k pull-ups are on
    switched 3V3 only, so nothing feeds the Pico while it is off. BT1 BR2032
    (rated to +85 C) in a Keystone 3034 holder feeds VBAT and nothing else;
    #FLG5 marks that net driven. Pins 5-13 to PGND per the datasheet; 32KHZ
    and RST open.
    BOM: six rows; DS3231SN#, holder and cell need ordering. New chunk `rtc`
    in board_chunks.py, still excluded from the board. check_capture.py:
    GP20-22 move from the free list to the pin map, an RTC sect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
    [BOM.csv, accord-logger.kicad_sch, courtyard_study.csv]
2026-10-30 layout: timer batch imported (39 parts, off the board edge, unplaced)
    a5_supply, hold, clock and cutoff came in with "Update PCB from Schematic";
    they sit to the right of the outline, x 215-270 mm. No placed footprint moved.
    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
    [accord-logger.kicad_pcb]
2026-10-30 kicad: switch on the rtc chunk
    Owner: "add the rtc chunk". Exactly six on_board flags flipped (U16, BT1,
    C25, R50, R51, R52). ERC 0 at --severity-all; full-netlist capture
    782/782 (netlist unchanged but for its timestamp); closure 67/67.
    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
    [accord-logger.kicad_sch]
2026-10-30 layout: timer batch removed from the board for now
    Back to the power block, Pico, SD header, J1 and the four holes.
    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
    [accord-logger.kicad_pcb]
2026-10-30 kicad: stage the board in small ordered steps
    Owner: "Too many pieces at once all tangled together, I need a structured
    logical way to add small groups of components at a time" (D-STAGE-11
    revised). board_chunks.py now holds 32 ordered steps of 2-10 parts, each
    one function that connects to parts already placed, with its own test
    points and a placement note: Pico peripherals, the vehicle inputs one
    channel at a time, the always-on 5 V rail and ignition, then the hold and
    the cutoff timer chip by chip. New commands: next, off. R30 (DE
    pull-down) moves in with the MAX3485.
    Flags reset to match the board (power, pico, sd, connector on): 45 parts
    flipped off. Scratch DRC schematic parity 0; ERC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
    [accord-logger.kicad_sch]
2026-10-30 layout: rtc step placed; power block traces
    Owner switched on the rtc step (six on_board flags) and placed U16, C25,
    R50-R52 and BT1 (back) at the USB end; routed the power block.
    Scratch DRC: schematic parity 0, no clearance or courtyard errors.
    Open from review:
    - P12 not joined between D112 cathode and Q5 pin 3 (B.Cu/F.Cu islands).
    - VIN_SW reaches Q5's middle-lead pad, not the tab; a standard DPAK's
    middle lead is cut short, so route to the tab.
    - PGND (35 connections) unrouted: buck return C10-, U6.4, D115 A, C14-
    still open; no pour yet.
    - Unrouted: R51 pin 1 (3V3), R37 pin 1 (B5), Q7.2-R35 (HOLD_B),
    U1.33-J1.10 (AGND, comes with the inputs).
    Routed buck paths: C11-U6.2 2.0 mm,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
    [accord-logger.kicad_pcb, accord-logger.kicad_sch]
2026-10-30 layout: PGND pour on both layers; P12 and VIN_SW fixed
    Owner revisions after review: P12 joined from D112 to Q5 pin 3
    (15.8 mm); VIN_SW now lands on Q5's tab, not the middle lead; one PGND
    zone on F.Cu and B.Cu, filled as a single island per layer, which joins
    all 35 open ground connections. The Pico footprint's antenna and RF
    keepouts already exclude it; the wider "suggestion" strip is to be cut
    out later.
    Open (scratch DRC, parity 0): starved thermal on U6 pin 4; C11 ground
    pad reaches U6 pin 4 only through the back pour, around a VIN_SW stub;
    unrouted R51.1 (3V3), R37.1 (B5), Q7.2-R35 (HOLD_B), U1.33-J1.10 (AGND,
    with the inputs).
    Claude-Session-ID: 42dd0e33-28b5-4936-847e-9c2e1d2488fa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
    [accord-logger.kicad_pcb]
2026-10-30 layout: remaining power-block connections routed
    R51 pin 1 to 3V3 (3.2 mm to R50), Q7 base to R35 (HOLD_B, 15 mm,
    0.2 mm B.Cu), R37 to B5; B5 rerouted at 0.5 mm; PGND tracks added at U6
    pin 4 and C11 (C11 ground to U6.4 now 12.3 mm by track, plus the pour).
    Saved with the PGND zone unfilled. Refilled in a scratch copy with the
    pcbnew zone filler: one island per layer; DRC schematic parity 0, no
    clearance, courtyard or thermal errors (the U6 pin 4 starved thermal is
    gone); unconnected only U1.33-J1.10 (AGND, comes with the inputs) and
    Q5's middle-lead pad (joined to the tab inside the part).
    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
    [accord-logger.kicad_pcb]
2026-10-30 layout: rs485 step placed and routed
    Owner switched on the rs485 step (U15, C24, R30) and, after a first try
    under the flush-mounted Pico, placed U15 (DIP-8 socket) between the Pico
    and J1 at the top of the board with R30 3.5 mm from DE/RE and C24 4.9 mm
    from VCC. A/B run 55 mm to J1.1/J1.7 as a 0.4 mm pair on B.Cu; GP8/GP9/
    GP10 run 84-97 mm with four vias each. Everything is 40 mm or more from
    the SW node.
    Scratch copy refilled with the pcbnew zone filler: one PGND island per
    layer; DRC schematic parity 0, no clearance or courtyard errors;
    unconnected only U1.33-J1.10 (AGND, with the inputs) and Q5's
    middle-lead pad (joined to the tab inside the part).
    Claude-Session-ID: 42dd0e33-28b5-49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
    [accord-logger.kicad_pcb, accord-logger.kicad_sch]
2026-10-30 layout: rs485_links step placed and routed
    Owner switched on rs485_links (R47-R49, JP2-JP4; six on_board flags).
    JP2-JP4 sit in a row at the top edge (y 64), R47/R48 bias and R49
    termination between them and U15. Nets checked pad by pad: R47 BIAS_HI-A,
    R48 B-BIAS_LO, R49 A-TERM, JP2 TERM-B, JP3 3V3-BIAS_HI, JP4 BIAS_LO-PGND.
    Scratch copy refilled: the front pour now has one 45.6 mm2 piece around
    U15 (x 148-163, y 64-73) cut off by the new tracks; it is tied to ground
    through U15 pin 5 and JP4's through-hole pads, and KiCad's island removal
    (always) keeps only connected copper. Two slivers under 1 mm2. DRC
    schematic parity 0, no clearance or courtyard errors; unconnected only
    AGND (with the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
    [accord-logger.kicad_pcb, accord-logger.kicad_sch]
2026-10-30 layout: headers step placed and routed
    Owner switched on the headers step (J3, J4, TP24, TP25; four on_board
    flags). J3 and the GP11/GP12 pads sit in the free strip left of the Pico
    above the antenna end (J3 pin 4 at y 127.6, 7.3 mm from GP13); J4 is
    13 mm from RUN. A missing via left U15 VCC, C24 and J3 pin 3 off 3V3 on
    the first pass; with it added, a copper flood from U15 pin 8 reaches
    every P3V3_SW pad including Pico pin 36.
    Scratch copy refilled: DRC schematic parity 0, no clearance, courtyard
    or dangling-track items; unconnected only AGND (with the inputs) and Q5's
    middle lead (internal to the part). Saved with the zone unfilled.
    Claude-Session-ID: 42dd0e33-28b5-4936-847e-9c2e1d2488f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
    [accord-logger.kicad_pcb, accord-logger.kicad_sch]
2026-10-30 layout: power_tps step placed and routed
    Owner switched on power_tps (TP1-TP7, TP21-TP23; ten on_board flags) and
    placed each beside its source; D115 moved 1.9 mm left (K to U6.1
    11.8 mm, A to C10- 10.0 mm). Copper flood from each test point reaches
    its net's parts: TP1 P12 (Q5.3, D112-D114, C9), TP2 GATE, TP3 VIN_SW
    (U6.2, C10, C11), TP4 SW (4.5 mm stub), TP5 B5, TP6 VSYS, TP7 3V3 (all
    12 pads), TP23 AGND at Pico pin 33.
    Open: clearance error, the 0.2 mm B.Cu PGND track from (177.2, 123.8) to
    TP22 passes about 0.13 mm from U6 pin 5 (NC); TP22 is a through-hole loop
    on the pour, so the track can go. Otherwise DRC (refilled scratch copy)
    parity 0; unconnected only AGND to J1.10 (with the inp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
    [accord-logger.kicad_pcb, accord-logger.kicad_sch]
2026-10-30 layout: TP4 moved beside U6, TP22 clearance fixed
    TP4 (SW) now sits by U6 with about 1.8 mm of stub (was 4.5 mm); the
    PGND track that crowded U6 pin 5 is gone and TP21 shifted 0.6 mm. Saved
    with the pour filled. DRC: no clearance errors, parity 0, unconnected
    only AGND to J1.10 and Q5's middle lead.
    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
    [accord-logger.kicad_pcb]
2026-10-30 schematic: through-hole resistors and 1N5819 from the inputs on (D-THT-15)
    Owner: "here I want to start using
    Resistor_THT:R_Axial_DIN0204_L3.6mm_D1.6mm_P5.08mm_Horizontal and 1N5819
    not 1N5819HW". All 37 surface-mount resistors except the placed RTC
    pull-ups move to DIN0204; the eight 1N5819HW (D101-D107, D109) go back to
    1N5819 on DO-41 vertical P5.08, the footprint they had before D-SMD-09.
    R22 R_AON's >= 0.15 W at 85 C is met by a derated 0.25 W DIN0204 (noted in
    the BOM). Also carries the owner's in_tach step switch-on (three flags).
    check_capture.py: the package checks now assert DIN0204 resistors (bar
    the RTC pull-ups) and the DO-41 1N5819; DI's value is 1N5819. ERC 0;
    full-netlist c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
    [BOM.csv, accord-logger.kicad_sch, courtyard_study.csv]
2026-10-30 layout: in_tach, in_brake and in_fuel placed and routed
    Owner switched on the three input steps (nine on_board flags) and placed
    them with the D-THT-15 through-hole parts. After review: ground vias tie
    the U16 pin 13 and C24 pin 2 front islands to the back pour; FUEL_ADC
    cleared of the UART/DE vias; AGND routed as its own trace (Pico pin 33,
    J1.10, R8, D105, C1, TP23; 139 mm); 3V3 to the D102/D103 cathodes; the
    tach and brake clamps moved to the Pico's left strip by GP3/GP4; R9, D104
    and D105 moved toward C1 (FUEL_ADC run now about 27 mm, was 80).
    SUPPLY_ADC via and VSS_IN stub are intentional pre-routing.
    Refilled scratch DRC: parity 0, no clearance errors, nothing unconnected
    but Q5's mid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
    [accord-logger.kicad_pcb, accord-logger.kicad_sch]
2026-10-30 layout: thermal relief fixed at J1 pin 2 and Q6 pin 1
    Ground tracks added at both pads. Refilled scratch DRC: no errors beyond
    the Pico footprint's own paste items; parity 0; unconnected only Q5's
    middle lead; the SUPPLY_ADC via and VSS_IN stub are intentional.
    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
    [accord-logger.kicad_pcb]
2026-10-30 layout: in_supply placed and routed
    Owner switched on in_supply (seven on_board flags). After review: GP27
    joined to the supply cell; C2, D106 and D107 moved to the pin (8.7-11.4 mm
    from U1.32, beside C1); D108 moved toward J1 pin 5 (13.7 mm); the
    SUPPLY_ADC via cleared of FUEL_ADC; J4 moved to (141.0, 132.7).
    Copper floods: GP27 reaches R12, C2, D106, D107; GP26 reaches R9, C1,
    D104, D105; AGND stays one trace off the pour.
    Refilled scratch DRC: parity 0, no errors beyond the Pico footprint's own
    paste items, unconnected only Q5's middle lead; the VSS_IN stub is
    intentional.
    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
    [accord-logger.kicad_pcb, accord-logger.kicad_sch]
2026-10-30 layout: in_vss placed and routed
    Owner switched on in_vss (U3, R1, R2, D101; four on_board flags). U3
    ASSR-601JV on the back by J1. Copper floods: J1.3 (B2) reaches U3 pins
    15/16; B2_ISO joins U3 pins 9 and 10 to R1; VSS_IN reaches R1, R2, D101
    and GP2. After review: U3 pin 9 tied to pin 10, the RS485_B via cleared
    of VSS_IN, J1 pin 2 thermal relief fixed again. U3's LED pins wait for
    iso_enable.
    paste items, unconnected only Q5's middle lead.
    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
    [accord-logger.kicad_pcb, accord-logger.kicad_sch]
2026-10-31 layout: ign_opto placed and routed
    Owner switched on ign_opto (D109, R13, D110, U2; four on_board flags).
    D109 by J1 on B11_TAP; R13 (DIN0414 vertical) and U2 PC817 to its left;
    D110 1N4148W on the back across the LED. IGN_POS runs D109 -> R13 and on
    to R33 pin 1 (QI base), 0.4 mm, three vias. U2 pins 3/4 (IGN_A, A5) wait
    for qual_rc and a5_reg.
    paste items, unconnected only Q5's middle lead. ERC 0; full-netlist
    capture 782/782; closure 67/67.
    Claude-Session-ID: d2c32eb9-406b-48d8-b5b5-bb1d8d4746af
    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
    [accord-logger.kicad_pcb, accord-logger.kicad_sch]
2026-10-31 layout: a5_clamp and a5_reg placed and routed
    Owner switched on a5_clamp (R22, D111, TP8) and a5_reg (U4, C4, C5, C6,
    TP9); eight on_board flags. R22 and D111 sit right of Q5 on P12, TP8 on
    the back beside them. U4 TPS70950 on the back by U2, EN open as designed;
    C4 at its input (3.1 mm), C5/C6 on A5 between U4 and U2 pin 4. P_AON
    runs 0.4 mm from the clamp to U4.
    After review: C4 moved from the clamp to U4's input, C5/C6 spaced to
    clear their courtyards, FUEL_DIV cleared of the A5 via.
    Claude-Session-ID: d2c32eb9-406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
    [accord-logger.kicad_pcb, accord-logger.kicad_sch]
2026-10-31 layout: a5_supervisor placed and routed
    Owner switched on a5_supervisor (U5, C7, TP17; three on_board flags).
    U5 TPS3839 on the back below C6, 8 mm from U4's output; PGOOD runs from
    U5 pin 2 to TP17, toward U3 where Q3 goes next.
    After review: C7 moved from beside C5 to U5 (pin 1 1.8 mm from U5 pin 3;
    ground through the pour).
    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
    [accord-logger.kicad_pcb, accord-logger.kicad_sch]
2026-10-31 layout: iso_enable and the ignition qualifier placed and routed
    Owner switched on iso_enable, qual_rc, qual_reset and qual_report (21
    on_board flags). Q3/Q4 with their gate resistors above U3; GP7 (ISO_EN)
    routed 113 mm from Pico pin 10 to R24; R23 by the B5 source at the
    bottom right. R14, R15, C3, TP12 and Q1 with R16-R18 in the upper
    right, where the Schmitt gates will go. Q2 on the back under the Pico
    with R21 and TP11 at GP5; R19/R20 at the top left.
    After review: ISO_EN and ISO_EN_G completed, RST_B routed, U1 pin 38
    thermal relief restored. The owner removed TP24/TP25 from the board;
    they move to J3 as a 2x03 (DECISIONS D-HDR-16, recorded here), so DRC
    parity lists only those two unt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
    [accord-logger.kicad_pcb, accord-logger.kicad_sch]
2026-10-31 schematic: J3 becomes a 2x03 carrying GP11 and GP12 (D-HDR-16)
    Owner: "I removed GP12 and GP11 test points, would prefer to change J3 to
    a 6 pin header, either 1x06 or 2x03", then "2x03 please". J3 goes from
    Conn_01x04 / PinHeader_1x04 to Conn_02x03_Odd_Even /
    PinHeader_2x03_P2.54mm_Vertical: 1 B5, 2 PGND, 3 P3V3_SW, 4 SPARE_GP13
    (unchanged), 5 SPARE_GP12, 6 SPARE_GP11. TP24/TP25 and their label stubs
    are removed; BOM.csv, check_capture.py (new 2x03 check) and the
    `headers` step follow. A 1x06 was ruled out on the board: extended down
    it reaches H4 and the antenna strip, extended up it meets R21.
    ERC 0; full-netlist capture 783/783; reference pin map refreshed after
    confirming only J3.5, J3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
    [BOM.csv, accord-logger.kicad_sch, courtyard_study.csv]
2026-10-31 layout: J3 2x03 placed and routed
    Owner updated the board from the schematic (J3 1x04 -> 2x03,
    D-HDR-16) and placed J3 at (92.07, 121.28) by Pico pins 15-17, clear of
    H4 and R21. B5, switched 3V3, GP11, GP12 and GP13 routed; pins 3 and 4
    routed GP13 / 3V3, which the next commit adopts in the schematic. The
    .kicad_pro change is KiCad's default pad size from the owner's session.
    Refilled scratch DRC: no errors beyond the Pico footprint's own paste
    items, unconnected only Q5's middle lead.
    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
    [accord-logger.kicad_pcb]
2026-10-31 schematic: J3 pins 3 and 4 swapped to match the owner's routing
    Owner: "keep my routing, I swapped the GP13 and 3v3 pins for ease of
    routing". J3 is now 1 B5, 2 PGND, 3 SPARE_GP13, 4 P3V3_SW, 5 SPARE_GP12,
    6 SPARE_GP11 (two labels swapped). check_capture.py, BOM.csv, STATUS and
    DECISIONS D-HDR-16 follow.
    confirming only J3.3 and J3.4 moved; closure 67/67; DRC schematic parity
    0 against the board.
    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
    [BOM.csv, accord-logger.kicad_sch]
2026-10-31 layout: hold placed and routed
    Owner switched on hold (JP1, R28, R29, TP19; four on_board flags).
    TP19 at Pico pin 9 (GP6); HOLD_RAW runs to R28 (47k pull-down) and the
    JP1 maintenance link beside J4; R29 1k from JP1 to Q7's base, where R35
    already holds it down. HOLD_RAW stays reachable for QMON (hold_monitor)
    ahead of JP1.
    capture 783/783; closure 67/67.
    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
    [accord-logger.kicad_pcb, accord-logger.kicad_sch]
2026-10-31 schematic: unplaced test points removed, remaining resistors 0805 (D-SMD-17)
    Owner: "at this point all unplaced test points need to go. All remaining
    resistors should be surface mount." TP10 (VCLK), TP13 (IGN_Q), TP14
    (CLK32), TP15 (ARM), TP16 (EXPIRED) and TP18 (HOLD_N) are removed with
    their label stubs; R39-R43, R45 and R46 move from DIN0204 to 0805 (the
    RTC pull-ups' footprint). Placed parts keep their footprints. All seven
    resistors are logic-level on A5; none has a power requirement. The
    schematic also carries the owner's on_board flags for the clock and
    timer steps (all steps now on). REV_A_INTERFACES 5.3 notes where to probe
    the dropped nets.
    ERC 0; full-netlist capture 779/779 (new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
    [BOM.csv, accord-logger.kicad_sch, courtyard_study.csv]
2026-10-31 schematic: C15 becomes a dipped radial tantalum, TAP336K016SCS (D-CCLK-18)
    Owner: "confirm and if it works, swap it in and I'll update from
    schematic". CCLK moves from the KEMET T491D336K016AT (7343-31 D case) to
    the KYOCERA AVX TAP336K016SCS: 33 uF +/-10 %, 16 V, solid tantalum, case
    F, 6.0 mm x 10.0 mm, 2.5 mm pitch, on
    Capacitor_THT:CP_Radial_Tantal_D6.0mm_P2.50mm (pad 1 +, to VCLK).
    Checked against the TAP datasheet (TDS-PTNO-0026 Rev 2): DCL 4.2 uA max at
    25 C, below the T491D's 5.3 uA; -55 to +125 C. Its hot-leakage and
    temperature limits sit in KYOCERA AVX's general dipped-tantalum section,
    which was not retrieved; with the same factors the budget used, the hot
    reserve is 52.5 uA and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
    [BOM.csv, accord-logger.kicad_sch, courtyard_study.csv]
2026-10-31 layout: every part placed and routed (clock, timer, cutoff, C15)
    Owner placed and routed the rest of phase D: U7-U9 and the clock rail,
    U10-U14 on the back at the top left, Q8 with R42/R43 by Q6/Q7, Q9 with
    R44-R46, and C15 (now the TAP336K016SCS radial, D-CCLK-18) on the front
    at (144.1, 84.5) with VCLK routed to it. Board updated from the schematic
    for D-SMD-17 (seven 0805 resistors, six test points gone) and D-CCLK-18.
    The outline is now 120 x 83 mm (3 mm taller at the top), with H1/H3
    moved to y 60.96.
    After review: Q2, U7 and U13 grounds joined to the main pour; MON_B,
    SINK and BAD clearances fixed; H4 back out of the Pico RF keepout;
    IGN_Q, CLK32 and EXPIRED completed.
    Refilled scrat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
    [accord-logger.kicad_pcb]
2026-10-31 status: all parts placed and routed; board 120 x 83 mm (D-ENVELOPE-02)
    STATUS rewritten for the finished placement and the pre-order list;
    DECISIONS records the 3 mm taller outline the owner made.
    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
2026-10-31 layout: fab minimums set, ground pour notched out of the antenna area
    Owner set the Board Setup constraints: minimum clearance, track and
    connection width 0.2 mm, annular 0.13 mm, hole-to-hole 0.5 mm, text
    1.0/0.15 mm (via 0.5, hole 0.3, hole clearance 0.25, edge 0.5 kept).
    The PGND pour outline now excludes the Pico W antenna area (x 101-116.2,
    y 130.2-139.1).
    Refilled scratch DRC: parity 0; the new minimums flag only U7's 0.8 mm
    label. Front ground islands at Pico pins 8, 23 and 28 have no via (the
    module bonds its grounds), and C8's front island reaches the main pour
    only through C8; stitching vias are on the pre-order list. ERC 0;
    full-netlist capture 780/780; closure 67/67.
    Claude-Ses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
    [accord-logger.kicad_pcb]
2026-10-31 status: fab minimums and antenna notch done; pre-order list updated
    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
2026-10-31 order: DigiKey order file for one Rev A board plus spares (D-ORDER-19)
    tools/gen_digikey_order.py maps every BOM.csv row to an orderable part
    and writes order/digikey_rev_a.csv (65 board lines + 8 extras); it
    refuses to write if a BOM row has no mapping. Spares per the owner:
    cheap passives and small diodes n+1 rounded up to 10, cheap ICs and
    transistors n+1, expensive parts exact. Extras: header strip, shunts,
    DIP-8 socket for U15, BR2032, JAE IL-AG5-14S-D3C1-A housing and
    IL-AG5-C1-5000 contacts, Littelfuse ATO inline holder and 1 A fuses.
    Generic parts chosen: Stackpole RNMF14 (DIN0204, 1/4 W mini metal film,
    >= 0.2 W at 85 C for R22) and RNF14 (DIN0207); Vishay PR01 1 W for the
    vertical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
    [digikey_rev_a.csv]
2026-10-31 schematic: C3 on a 5.5 mm-wide film footprint for the WIMA MKS2 (D-CQUAL-20)
    Owner: "yes change C3's footprint". CQUAL is now the WIMA
    MKS2C041001F00JSSD (1 uF 5 % 63 V PET, 7.2 x 5 x 10 mm, 5 mm pitch) on
    C_Rect_L7.2mm_W5.5mm_P5.00mm; the W2.5 footprint fitted no real 1 uF
    >=50 V film part. Selection status moves from PART_SELECTION_OPEN to
    SELECTED. Where C3 sits, the wider body meets R14/R15 pin 2 and comes
    within about 0.4 mm of TP12; the owner re-places it after Update PCB.
    ERC 0; full-netlist capture 781/781 (new check: CQUAL part and
    footprint); no pin changed net; closure 67/67. The order file already
    listed this part and is unchanged. The owner's board revision in
    progress is not i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
    [BOM.csv, accord-logger.kicad_sch, courtyard_study.csv]
2026-10-31 layout: pre-order revision (ground stitching, C3 on its film footprint)
    Owner's revision: front ground islands at Pico pins 8, 23, 28 and under
    C8 stitched to the main pour; C3 updated to the 5.5 mm-wide WIMA MKS2
    footprint (D-CQUAL-20) and re-placed at (200.0, 70.4).
    Pre-order check, refilled scratch copy: DRC schematic parity 0; no
    courtyard overlap; no isolated ground piece (203 PGND vias of 348); no
    copper within 3.5 mm of the four mounting holes; DRC errors only the Pico
    footprint's two paste pads, Q5's middle lead and four single-spoke or
    island thermals that are connected; 56 silkscreen items (U7's label
    under the 1.0 mm minimum). Trial gerbers and Excellon drill plot
    cleanly: 13 hol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
    [accord-logger.kicad_pcb]
2026-10-31 power: C15 TAP leakage checked against the TAP/TEP guide; J5 on the back recorded
    Owner pointed to the TAP datasheet, which is the 3-page series sheet with
    only the 25 C DCL (4.2 uA). The KYOCERA AVX TAP/TEP Technical Summary
    gives typical curves, not limits: DCL about 8x at +85 C, capacitance
    about -5 % / +5 % at -55 / +85 C, and about 0.05-0.15x DCL at 32 % of
    rated voltage. Realistic hot leakage about 5 uA against the 52.5 uA
    screening reserve; accepted for ordering, with the parked-current bench
    test as the backstop (COMPONENT_MARGIN_CLOSURE, BOM note).
    DECISIONS D-SD-21: J5 on the back is intentional; the owner's silkscreen
    pass comes before the fab files and the order. STATUS updated.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
    [BOM.csv]
2026-10-31 schematic: TP11 and TP19 removed (D-TP-22)
    Owner: "I removed TP11 and TP19". TP_QUALN (QUAL_N_REPORT, GP5) and
    TP_HOLD (HOLD_RAW, GP6) leave the schematic with their label stubs;
    BOM.csv, check_capture.py and the qual_report/hold steps follow.
    REV_A_INTERFACES 5.3 notes where to probe: R21 pin 2, and R28 pin 1 or
    JP1 pin 1.
    ERC 0; full-netlist capture 780/780; reference pin map refreshed after
    confirming only TP11.1 and TP19.1 moved; closure 67/67; DRC schematic
    parity 0 against the owner's board (silkscreen pass in progress, not
    included); order file unchanged.
    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
    [BOM.csv, accord-logger.kicad_sch, courtyard_study.csv]
2026-10-31 layout: silkscreen pass and DRC clean-up
    Owner's silkscreen pass: 58 silkscreen items across 39 parts down to the
    accepted ones (J1's outline over the edge it overhangs on purpose,
    D-CONN-23; U7 and U3 outline ticks on their own pads); U7's label at the
    1.0/0.15 mm minimum. TP11 and TP19 removed (D-TP-22, schematic already
    committed). Q5's middle lead joined to its tab; R30 and Q7 thermal
    connections fixed.
    Refilled scratch DRC: parity 0, no unconnected items; remaining: U7 pin
    2 and U13 pin 7 single-spoke thermals (connected), the Pico footprint's
    two paste pads in its RF keepout, U1/J5 library-metadata warnings, and
    the silkscreen items above. ERC 0; full-netlist capture 780/780; closure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
    [accord-logger.kicad_pcb]
2026-10-31 fab: Rev A gerber and drill package; DRC exclusions saved
    The owner excluded the 11 accepted DRC items in KiCad (D-DRC-24) and
    saved the project; the .kicad_pro keeps its erc section. DRC on a copy:
    0 active, 11 excluded, schematic parity 0.
    fab/rev-a/ holds the package plotted from the board at 67e5f21 with
    KiCad 9.0.2: gerbers for both copper, mask, silkscreen and paste layers
    plus Edge.Cuts (silkscreen clipped at the mask), separate PTH (563 holes,
    0.30-1.60 mm) and NPTH (10 holes: 4 x 3.2 mounting, 4 x 2.2 Pico, 2 x
    1.85 J1 pegs) Excellon files in mm, drill maps, the job file, and the
    zip to upload. README records the commands. STATUS: ready to order,
    pending the owner's approval.
    Clau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
    [accord-logger-B_Cu.gbl, accord-logger-B_Mask.gbs, accord-logger-B_Paste.gbp, accord-logger-B_Silkscreen.gbo, accord-logger-Edge_Cuts.gm1, accord-logger-F_Cu.gtl, accord-logger-F_Mask.gts, accord-logger-F_Paste.gtp]
2026-11-10 decisions: as-built circuit moving onto a Rev A bare board (D-BUILD-25)
    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
2026-11-10 decisions: Rev A board's Pico runs a tailored car build (D-FW-26)
    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
2026-11-10 decisions: Rev A board logging, uploading; final SD wiring (D-FW-26)
    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
2026-11-10 decisions: Rev A board's first drive in the car (D-BUILD-27)
    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
2026-11-10 decisions: Rev A dropouts trace to the Pico's USB plug (D-BUILD-27)
    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
2026-11-10 decisions: Nov 8-9 trips reconciled from the old Pico's card (D-DB-28)
    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
2026-11-12 Extract logger PCB mechanical references for enclosure modelling
    Export bare-board STEP, exact outline and mounting-hole DXF, annotated SVG and coordinate JSON with a repeatable read-only exporter. Document the asymmetric mounting pattern, nominal thickness and remaining assembly measurements.
    Codex-Session-ID: 01a1cdc1-630d-7712-8fb9-fc96c15acb08
    [accord-logger-board.step, accord-logger-outline.dxf]
2026-11-12 Add a rounded logger case bottom with 4 mm walls
    Provide a validated STL, editable OpenSCAD model and preview based on the extracted PCB outline. Start with 1 mm clearance per side, a 4 mm floor and 12 mm internal depth; document dimensions and remaining assembly-fit details.
    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
    [accord-logger-case-bottom.scad, accord-logger-case-bottom.stl]
2026-11-12 Add stepped PCB locating studs to logger case bottom
    Place 6 mm support shoulders on the four exact PCB mounting-hole centers, 6.35 mm above the inside floor. Add 3 mm locating pins with tapered tips and 0.2 mm diametral fit clearance. Fuse the supports into one checked STL solid and update the editable model, preview and dimensions.
    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
    [accord-logger-case-bottom.scad, accord-logger-case-bottom.stl]
2026-11-12 Reduce logger case walls to 2 mm
    Regenerate the STL, editable model and preview at 126 x 89 x 16 mm overall. Preserve the cavity, 4 mm floor and stepped PCB supports; record the revised owner requirement.
    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
    [accord-logger-case-bottom.scad, accord-logger-case-bottom.stl]
2026-11-12 Halve logger case support shoulder height
    Lower the wider stud sections from 6.35 mm to 3.175 mm above the inside floor, preserving the 3 mm locating pins and case dimensions. Regenerate and check the STL, editable model and preview.
    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
    [accord-logger-case-bottom.scad, accord-logger-case-bottom.stl]
2026-11-12 Chamfer the logger case exterior bottom edge
    Add an adjustable 1 mm by 1 mm, 45-degree bevel around the bottom perimeter, including rounded corners. Preserve the floor and studs, update the analytic volume check and provide an underside preview. STL section checks confirm the bevel dimensions.
    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
    [accord-logger-case-bottom.scad, accord-logger-case-bottom.stl]
2026-11-12 decisions: unlogged Nov 12 first leg entered as a manual trip, anchor 231502 (D-DB-30)
    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
